xparapx/Plant_Growth_Monitoring_Demo/design/Plant Monitor Mockups.turn3.dc.html

3브랜드 팔레트 적용(#173046 · #2C5979 · #D84C27 · #F2F2F2 · #C0C0C0) + 환경변수는 Plotly 기본색 · 페이지별 목업 4종

3aPage 1 · Overview — 니들 게이지(Plotly 색상 구분) + 토양수분 밴드 + 급수 이벤트

plantlab°

OVERVIEWTREATMENTGROWTHCAMERA

4 nodes · Day 14/42 · 18:04 KST

온도10–40

23.4 °C

OPTIMAL

습도0–100

58 %

OPTIMAL

VPD0–3

1.12 kPa

OPTIMAL

CO₂0.4–2k

642 ppm

LOW

조도0–60k

18.4 klx

OPTIMAL

토양수분 — 처리 밴드— stable— fluct7d · 중심 1920 동일

Treatment check

Δμ 정렬0.42 %p ALIGNED

σf / σs2.31 × SEPARATED

급수 이벤트

17:42P4 fluctdose 3.2s ✓

16:10P2 stabledose 1.1s ✓

14:55P4 fluctsoak 90s

3bPage 2 · Treatment — 처리군 분리 검증 (밴드 설정 · 정렬/분리 지표 · 분포)

plantlab°

OVERVIEWTREATMENTGROWTHCAMERA

MEAN ALIGNMENT Δμ = |μs − μf|

0.42 %pALIGNED < 1.0

VARIANCE RATIO σf / σs

2.31 ×SEPARATED > 1.5

총 급수량 (결과값 · 비통제)

S 412 mLF 486 mL

수분 궤적 — 같은 중심, 다른 폭14d

밴드 설정 (raw)

stableON 1940 · OFF 1900P1 P3 P5

fluctON 2020 · OFF 1820P2 P4 P6

중심(ON+OFF)/2 = 1920 동일

수분 분포 (14d)

좁은 산 = stable · 넓은 산 = fluct. 옌센 부등식 검정의 전제 조건.

3cPage 3 · Growth — 2행 3열, 캐노피 투영 이미지 포함 + RGR 비교

plantlab°

OVERVIEWTREATMENTGROWTHCAMERA

DAWN 06:00 PM 15:00 ✓ MASK

P1STABLE142.6 cm²

RGR +4.1 %/dsoil 41%

P2FLUCT156.1 cm²

RGR +4.8 %/dsoil 37%

P3STABLE138.9 cm²

RGR +3.9 %/dsoil 42%

P4FLUCT161.3 cm²

RGR +5.2 %/d · 최대soil 35%

P5STABLE145.2 cm²

RGR +4.2 %/dsoil 40%

P6FLUCT150.7 cm²

RGR +4.6 %/dsoil 35%

RGR 추이 — 처리군 평균(ln A₂ − ln A₁)/Δt · 14d

ΔRGR (F − S)

+0.80 %/d

효과크기 d 0.62 · 사전등록 기준(n=6) 판정은 6주 종료 시.

3dPage 4 · Camera Setup — 프리뷰 + 5단계 컨트롤, 동일 팔레트

plantlab°

OVERVIEWTREATMENTGROWTHCAMERA

저장 → config.json

● LIVE PREVIEW

✓1 · 노출 · 초점20000µs · 1.82 · g2.0

✓2 · 스케일 마커50mm → 21.44 px/cm

3ROI 잡기 — 3×2진행 중

AUTO ROIFIND LEAF

pot 15 cm · gap 20 cm · margin 4%

4처리군 배정SHUFFLE

P1 S P2 F P3 S P4 F P5 S P6 F

5 · 기준사진 촬영 (calib.jpg)

Try next: "이 팔레트로 4페이지 인터랙티브 프로토타입 만들어줘" · "3c 캐노피 카드에 dawn/pm 비교 슬라이더" · "모바일 버전"
