xparapx/Plant_Growth_Monitoring_Demo/docs/manual.html

식물 생장 모니터링 — 데모환경노드 R4 WiFi + 급수노드 Core S3 + Raspberry Pi 5 + plantsvc 웹 UI · rev. 2026-09빌드 2026-09-10 · rev. 2026-09

시작하기

0개요 & 준비물

i전체 구조 한눈에

① Hub

1브로커 — PC / Pi 선택

2수집 — run_collector.py

② 환경 노드

3구성 (Grove 체결)

4펌웨어

5수신 테스트 ★

③ 급수 노드

6구성 · 실측 ★

7펌웨어 (폐루프)

④ 라즈베리파이 · 원격

8Pi 이관 · systemd

9원격 GUI — noVNC

⑤ 카메라 — 설치 (손으로 1회)

10준비 · 화각 · ROI

⑥ 카메라 — 운용 (자동)

11측정 · 자동 촬영

⑦ 대시보드 · 웹 UI · 운용

12대시보드

18웹 UI (plantsvc)

19LED 촬영 루틴 (자리)

20설치·배포 스크립트

⑧ 데모 판정

13데모 합격 판정

⑨ 실험 설계

14왜 이 실험인가

15용어 · 사전 측정

16실험 설계

17측정 계획

참고 — 순서 없음

!트러블슈팅

?개념 정리 (FAQ)

→다음 단계

## 0개요 & 준비물

7노드 전체를 세우기 전에, 3대로 전 구간을 한 번 관통시킵니다. 여기가 통과하면 나머지는 복사 작업입니다.

데모(0주)의 임무 — 식물은 없습니다 하드웨어와 소프트웨어의 루프가 제대로 도는가를 확인하는 것이 전부입니다. 씨앗도, 처리도, 실험도 아직 없습니다. 흙만 담은 화분 1개로 합니다.

그런데 그 과정에서 파종 전에 반드시 알아야 할 값들이 함께 나옵니다 — 센서 보정, 포화점, 그리고 주기(→ 화분 크기). 데모가 곧 예비실험입니다.

### 왜 3대인가

노드 7대를 한꺼번에 세우면 문제가 생겼을 때 원인이 노드인지 브로커인지 카메라인지 구분이 안 됩니다. 최소 구성으로 센서 → MQTT → DB → 화면과 급수 폐루프를 각각 한 번씩 끝까지 통과시켜 놓으면, 이후 노드 추가는 펌웨어 복사 + 전원 꽂기가 전부입니다.

데모에서 답이 나오는 것 / 안 나오는 것 나오는 것: 핀 대응, 펌프 실제 전류, 아날로그 전압, 폐루프 동작, 급수 검증 실패 감지, 5분 버킷 정합, 재부팅 복구, 픽셀→cm² 환산
안 나오는 것: 6칸 위치 무관성(프레임 필요), 7노드 동시 부하, 조도 균일도, 열화상 정합 — 전부 2단계로 미룹니다

### 준비물 — 데모에 필요한 전부

구분 | 품목 | 비고
허브 | PC (Windows) 지금 | Pi 도착 전까지 브로커 + run_collector.py + 대시보드를 여기서 실행
| Raspberry Pi 5 (4GB) + 정품 27W PD + SD 32GB A2 도착 후 | Pi가 꼭 필요한 건 카메라뿐
카메라 | Camera Module 3 — Standard (75°) | ⚠️ Wide·NoIR 아님 (FAQ 참조)
| 22핀 미니 CSI 케이블 | Pi 5는 15핀 아님. 동봉 여부 판매처마다 다름
환경 노드 | Arduino UNO R4 WiFi | WiFi 필수 — Minima는 불가
| Grove Base Shield V2 | I2C 포트 4개 → 허브 불필요. 전원스위치 5V
| BME688 0x76 | 온·습도·기압 대표값 · VPD 계산
| SCD41 0x62 | CO₂ 전용으로 사용
| DLight (BH1750) 0x23 | 조도 lx. 최대감도 560nm → lux≠PAR (FAQ)
| MLX90640 0x33 2단계 | 열화상. 남는 I2C 포트에
급수 노드 | M5Stack Core S3 유지 | Port B(G8/G9) = Watering Unit. 내장 배터리가 인러시 완충
| Watering Unit (U101) ×2 | 1 사용 + 1 예비 — 포럼 불량률 25% 보고
계측 ★ | USB 전력계 | 이 데모의 핵심 장비. 만원짜리가 전원 논쟁을 끝냄
| 멀티미터 | 아날로그 출력 전압 확인 (3.3V 초과 여부)
| 계량컵 | 1회 급수량 보정
기타 | 전원 어댑터 ×2 (급수=USB-C 5V2A / 환경=USB-C 또는 배럴) | 노드 1개 = 어댑터 1개 (패널 6)
| 화분 1개 + 흙 + 물통 | 씨앗 없이. 흙만 담아 폐루프 시험
| ArUco 마커 인쇄물 · 무광 초록 색지 | 패널 10

아직 사지 마세요 PbHUB · PaHUB · 분배기(커플러) · MOSFET · 플라이백 다이오드 · 배럴잭 어댑터 — 전부 불필요합니다. 노드당 Watering Unit이 1개이므로 Port B에 그냥 꽂으면 됩니다. 배럴잭은 패널 6에서 전류를 재본 뒤 필요하면 그때 사면 됩니다.

보드가 갈린 이유 — 각 노드가 다른 강점을 씀 "1보드에 유닛 2개"를 전제하던 크로스 분기·PbHUB 논의는 노드를 나누면서 전제가 사라졌습니다. 환경 노드 = R4 WiFi는 Base Shield의 I2C 4포트로 센서 3~4개를 허브 없이 물립니다. 급수 노드 = Core S3는 내장 배터리가 펌프 기동 순간의 전류를 받쳐 브라운아웃을 막고, M5가 단일 케이블로 검증한 조합입니다. MQTT라 보드가 섞여도 브로커는 무관합니다.

### 이 문서에 계속 나오는 약어 다섯

여기서는 한 줄로만 짚고, 깊은 설명은 해당 패널에서 합니다. 모르는 채로 진행해도 되지만, 무엇을 재고 있는지 알면 실패를 훨씬 빨리 알아챕니다.

약어 | 풀이 | 한 줄 설명 | 자세히
ArUco | 고유 무늬가 있는 흑백 정사각형 표식 | 사진 속의 자(尺). 크기를 아는 물체를 같이 찍어 픽셀 → cm 환산을 하고, 동시에 카메라가 움직였는지를 감시합니다 | 패널 10
ROI | Region Of Interest · 관심 영역 | 사진에서 화분 하나를 오려낼 사각형. 카메라 한 대로 여러 화분을 찍고 ROI로 나눠 각각 잽니다 | 패널 10
ExG | Excess Green · 초록 초과 | 2G − R − B. 초록이 강한 픽셀만 크게 만들어 잎과 흙을 가르는 계산 | 패널 11
RGR | Relative Growth Rate · 상대 생장률 | “하루에 몇 % 자라는가”. 면적의 로그 기울기라서 처음 크기가 달라도 공정하게 비교됩니다 | 패널 11
VPD | Vapour Pressure Deficit · 증기압 결핍 | 공기가 물을 얼마나 세게 빨아가는가. 온도와 습도를 합친 값으로, 습도보다 식물의 체감에 가깝습니다 | 패널 3

MQTT · I2C — 통신 쪽 두 개 MQTT는 “토픽”에 메시지를 던지면 구독자가 받아가는 메시지 배달 규약입니다. 노드가 던지고(plant/…) 브로커가 나르고 run_collector.py가 받아 DB에 넣습니다.
I2C는 선 두 개(SDA·SCL)로 여러 센서를 주소로 구분해 붙이는 방식입니다. 그래서 센서마다 0x76처럼 주소가 붙어 있고, 주소가 겹치면 하나만 보입니다.

◀ 이전다음 ▶

## i전체 구조 한눈에

데이터가 어디서 생겨 어디로 흐르는지, 각 노드가 무엇을 스스로 판단하는지, 그리고 무엇을 먼저 하는지.

화살표를 따라가면 데이터가 어디서 생겨 어디로 가는지 보입니다

### 고리가 둘, 보고선이 하나

| 급수 고리 | 측정 고리
어디서 도나 | 급수 노드 보드 안 | Pi 안
주기 | 5분마다 판단 · 필요하면 도즈 | 하루 2회 (05:50 · 15:00 — 패널 19)
입력 | 토양수분 raw | 사진 1장
출력 | 펌프 ON/OFF | 화분별 면적·윤곽
네트워크가 죽으면 | 그대로 계속 돕니다 — 로그만 못 남깁니다

이 구조가 6주 무인 운용을 가능하게 합니다 판단이 바깥에 있으면 WiFi가 한 번 끊길 때마다 급수가 멈춥니다. 주말에 그런 일이 생기면 실험 전체가 무효가 됩니다.
그래서 노드의 BROKER 를 Tailscale 주소로 적으면 안 됩니다 — 그 순간 원격 장애가 급수 장애가 됩니다. 노드는 로컬 IP만 봅니다.

### MQTT 토픽 → DB 테이블

노드는 토픽에 던지기만 하고, run_collector.py 가 받아 해당 표에 넣습니다.

토픽 | 보내는 쪽 | 주기 | → 테이블
plant/<node>/env | 환경 노드 | 5분 | readings
plant/<node>/soil | 급수 노드 | 5분 | soil
plant/<node>/pump | 급수 노드 | 이벤트 | pump_log
plant/tray/growth | Pi (카메라) | 1일 | growth

토양수분이 왜 readings가 아니라 soil인가 환경(온·습·CO₂)은 재배함 전체에 공통이라 노드 1대면 됩니다. 토양수분은 화분마다 다릅니다. 대상이 다르므로 표를 나눕니다 — readings는 공간 1행, soil은 화분마다 1행. 이래야 7노드로 늘려도 스키마가 그대로입니다.

### 노드별로 무엇을 셋업하는가

각 노드에서 손대는 것은 펌웨어 몇 줄과 확인 절차뿐입니다. 나머지는 전부 복사입니다.

대상 | 올리는 것 | 고칠 값 | 통과 판정 | 패널
브로커 PC 또는 Pi | mosquitto (apt/설치파일) | 없음 — IP만 확인 ipconfig / hostname -I | 다른 창에서 mosquitto_sub 에 메시지가 흐름 | 1
수집 Pi | run_collector.py planthub.service | 없음 | 재부팅 후에도 DB 행이 계속 쌓임 | 2 · 8
환경 노드 R4 WiFi ×1 | Arduino 펌웨어 | WiFi 2줄 · BROKER | 1시간 방치 → 12행 · 결측 0 · n≈30 | 3~5
급수 노드 Core S3 ×N | water_node.ino → 본 펌웨어 | PLANT_ID · TREAT_FLUCT RAW_ON/RAW_OFF · DOSE_MS | 도즈 → 대기 → filled 로 스스로 멈춤 튜브를 빼면 no rise | 6~7
카메라 Pi | 웹 UI /camera/setup plantsnap.timer | data/config.json 하나 | check_config.py 통과 + photos/debug/ 윤곽 육안 확인 | 10~11

⚠ 노드마다 다른 값은 딱 두 줄입니다 급수 노드 N대의 코드는 완전히 같고 PLANT_ID 와 TREAT_FLUCT 만 다릅니다.
이게 중요한 이유 — 제어 알고리즘이 처리군과 교락되지 않습니다. 두 군의 차이가 “코드가 달라서”일 가능성이 원천 차단됩니다.

### 작업 순서 — 반드시 이 순서로

🖥️① Hub (먼저!)PC — 브로커 주소가 여기서 정해짐

브로커 — PC에 mosquitto

Pi를 기다릴 필요 없음. ipconfig로 나온 IP가 노드의 BROKER 값 · 패널 1

수집 — run_collector.py

MQTT → SQLite. MQTT Explorer로 눈으로 확인 · 패널 2

▼

🌡️② 환경 노드가장 쉬움 — 먼저 성공 경험을

0단계 — WiFi 없이 시리얼만 ★

여기서 막히면 브로커 문제로 오인하게 됩니다. 센서부터 · 패널 3

펌웨어 — WiFi 2줄 + BROKER

NTP 정각정렬 → 5분 평균 발행 · 패널 4

수신 테스트 — 1시간 방치

12행 · 결측 0 · n≈30 확인 · 패널 5

▼

💧③ 급수 노드실측이 설계를 확정함

실측 3종 ★

핀 대응 · 아날로그 전압(<3.3V?) · 급수 시 전류·전압강하 → 배럴잭 필요 여부 확정 · 패널 6

보정 — 마름/젖음 + DOSE_MS

보정 없이 시작하면 전체 데이터를 못 씁니다 · 패널 6

폐루프 + 검증실패 유발

흙 담은 화분에. 튜브를 일부러 빼서 verify_fail 확인 · 패널 7

▼

📷④ 라즈베리파이카메라 · 24시간 무인 운용

설치 — git clone + install.sh

저장소를 그대로 클론하고 scripts/install.sh 한 번. 노드의 BROKER만 Pi IP로 · 패널 8·20

카메라 — 초점·노출 고정 ★

오토포커스는 결함입니다(FAQ). 고정 후 6주간 불변 · 패널 8

종이 잎 검증

면적을 아는 도형으로 정확도를 수치화 · 패널 11

▼

✓⑤ 판정통과해야 2단계로

24시간 무인 → 합격표

미달이면 원인 고치고 다시 24시간 · 패널 ✓

①②는 하루, ③은 이틀, ④는 일주일 시간과 실패는 ④ 비전에 몰립니다. 일정을 세울 때 여기에 대부분을 배정하세요.

### 스크립트 지도 — 이름만 보고 누가 언제 실행하는지 알 수 있게

파일 이름의 앞부분이 실행 주체입니다. 헷갈리면 이 표로 돌아오세요.

접두어 | 뜻 | 파일 | 실행
setup_ | 설치할 때 손으로 1회. 숫자가 하는 순서 | 웹 UI /camera/setup (패널 10·18) 브라우저에서 노출·배율·ROI·처리군·기준사진을 한 번에. 예전 setup_camera.py(:8000)의 5단계가 그대로 옮겨졌습니다 | 사람 6주간 다시 안 씀
check_ | 정확도 검증 | check_accuracy.py 종이 잎 오차 측정 check_config.py 설정 모순 검사 check_manual.py 매뉴얼-코드 대조 | 사람 · 운용 전 1회
run_ | 6주 동안 자동으로. 사람이 안 건드림 | run_collector.py MQTT → DB plantsvc capture LED → 촬영 → 측정 → 발행 plantsvc serve 웹 UI · API · 미리보기 (:8080) run_capture.py는 plantsvc capture로 연결되는 shim으로 남아 있습니다 | systemd planthub.service plantsvc.service plantsnap.timer (+ catch-up)
— | 나머지 | leaf_measure.py 측정 엔진(라이브러리) frame_align.py 카메라 밀림 감지(라이브러리) center_roi.py ROI 재중심 — 촬영 시작 전에만 (웹 UI의 [ROI 재중심] 버튼과 같은 일) plantsvc doctor 점검표 · plantsvc seed 더미 DB (패널 20) data/config.json 모든 설정 (웹 UI /system 에서 편집) data/plant.db 데이터 · data/events.db 서비스 자체 기록 | leaf_measure는 직접 실행하지 않고 plantsvc capture가 불러 씁니다. dashboard.py(Streamlit)는 레거시 — 패널 12

★ 값을 고칠 곳은 config.json 하나뿐입니다 노출·초점·해상도·ROI·LED·촬영 시각 — 전부 여기 있습니다 (~/plant/data/config.json). 웹 UI의 카메라 설정과 plantsvc capture가 모두 같은 파일을 읽으므로, 한 곳만 고치면 셋이 함께 따라옵니다.
스크립트 안의 숫자를 직접 고치지 마세요. 세 곳이 어긋나는 순간 “미리보기에서 본 것”과 “실제로 찍히는 것”이 달라지고, 그건 사진만 봐서는 알 수 없습니다.

◀ 이전다음 ▶

## 1브로커 — PC로 먼저

Pi를 기다릴 필요가 없습니다. Pi가 꼭 필요한 건 카메라뿐이고, 브로커·run_collector.py·대시보드는 전부 PC에서 돕니다.

파이프라인의 80%를 오늘 끝낼 수 있습니다 mosquitto·run_collector.py·plantsvc(웹 UI)는 플랫폼 무관입니다. PC에서 완성해두면 Pi 도착 시 파일 복사 + 노드의 BROKER IP 한 줄 교체가 이관의 전부입니다.

둘 중 하나만 고르면 됩니다 — 순서가 아니라 선택입니다

| 🖥️ PC (Windows) | 🍓 라즈베리파이
언제 | Pi가 아직 없을 때 · 코드만 먼저 검증 | 본 운용. Pi가 있으면 처음부터 이쪽
24시간 운용 | ❌ PC를 계속 켜둬야 함 | ✅ 전원만 꽂으면 됨 (패널 8 systemd)
카메라 | ❌ | ✅
나중에 옮기려면 | plant 폴더 복사 + 노드 펌웨어의 BROKER 한 줄 교체가 전부

Pi가 이미 있으면 오른쪽 탭으로 바로 가세요. PC를 거칠 이유가 없습니다.

🖥️ PC (Windows)로 구축 🍓 라즈베리파이로 구축

### 1) mosquitto 설치

mosquitto.org/download에서 Windows 설치본을 받아 설치합니다.

### 2) 설정 파일 — PowerShell로 만드세요

C:\Program Files\mosquitto\는 보호된 폴더라 메모장으로 저장하면 권한 거부가 나고, 저장돼도 plant.conf.txt처럼 확장자가 몰래 붙습니다. 관리자 PowerShell에서 만드는 게 확실합니다.

관리자 PowerShell — 권한·확장자 문제 없이

Set-Content -Path "C:\Program Files\mosquitto\plant.conf" -Encoding ascii -Value @(
  "listener 1883 0.0.0.0",
  "allow_anonymous true"
)

왜 메모장이 아니라 이 방법인가 -Encoding ascii가 한글/BOM 문제를 막고, 확장자가 .conf 그대로 저장됩니다. 메모장으로 하려면 저장 시 파일 형식을 "모든 파일"로 바꾸고 이름을 "plant.conf"(따옴표 포함)로 써야 합니다. 설정 파일에는 한글을 넣지 마세요 — 인코딩이 깨져 mosquitto가 뜨지 않습니다.

### 3) 브로커가 이미 돌고 있는지 확인 ★

Windows 설치본은 mosquitto를 서비스로 자동 등록해 부팅 때부터 켜두는 경우가 많습니다. 그러면 따로 실행할 필요 없이 이미 브로커가 살아 있습니다.

PowerShell

Get-Service mosquitto

결과 | 뜻 · 다음
Running | 이미 브로커가 돎. 4)의 실행을 건너뛰고 바로 테스트로. 단 기본 설정(localhost 전용)이라 같은 PC 테스트만 됨 — 데모엔 충분
Stopped / 없음 | 4)에서 수동으로 띄움

데모는 이대로 충분합니다 — 노드 붙일 때만 손보면 됩니다 서비스는 plant.conf가 아니라 기본 설정으로 돌아 외부(WiFi) 접속이 막혀 있습니다. 지금은 PC 하나로 하는 테스트라 문제없습니다. 실제 노드를 붙이는 단계에서만 net stop mosquitto로 끄고 아래 4)처럼 plant.conf로 다시 띄우면 됩니다.

### 4) (Stopped일 때만) 방화벽 열기 · 수동 실행

3)이 Running이면 이 단계는 건너뛰세요. Stopped이거나 plant.conf로 다시 띄워야 할 때만 합니다.

관리자 PowerShell — 이 창은 켜둔 채로

New-NetFirewallRule -DisplayName "MQTT 1883" -Direction Inbound `
  -Protocol TCP -LocalPort 1883 -Action Allow

cd "C:\Program Files\mosquitto"
.\mosquitto.exe -c plant.conf -v      # -v : 오가는 메시지가 콘솔에 그대로 보임

.\은 "현재 폴더의 이 파일"이라 PATH와 무관하게 실행됩니다. 이 창을 닫으면 브로커가 꺼집니다.

방화벽이 1순위 실패 원인입니다 노드가 rc=-2로 계속 실패하는데 PC 자체 테스트는 되는 경우 — 거의 항상 방화벽입니다. 공용 네트워크 프로파일에서 특히 잘 막힙니다.

### 5) 브로커 주소 확인 ★

PowerShell

ipconfig

IPv4 주소(예: 192.168.0.15)가 노드 펌웨어의 BROKER 값이 됩니다.

### 1) OS · 접속

Raspberry Pi Imager로 Raspberry Pi OS (64-bit, Bookworm) Desktop을 굽습니다. 고급 설정(톱니바퀴)에서 호스트명 planthub, SSH 사용, WiFi, 국가 KR을 미리 넣으면 모니터 없이 접속됩니다.

Lite 아님 — Desktop picamera2와 카메라 스택이 기본 포함되어 있어 설치 사고가 줄어듭니다.

PC 터미널

ssh <계정>@raspi.local        # ← 자기 계정@호스트명 (deploy.ps1 의 기본 호스트명은 raspi)

# Pi 안에서
sudo apt update && sudo apt full-upgrade -y
hostname -I          # ← 이 IP가 새 BROKER 주소

### 2) mosquitto

Pi

sudo apt install -y mosquitto mosquitto-clients

sudo tee /etc/mosquitto/conf.d/plant.conf > /dev/null << 'EOF'
listener 1883 0.0.0.0
allow_anonymous true
EOF
sudo systemctl restart mosquitto
systemctl status mosquitto      # active (running) 확인 → q

apt로 설치하면 부팅 시 자동 실행까지 자동으로 등록됩니다.

IP를 고정하세요 공유기 관리페이지에서 DHCP 예약으로 Pi의 IP를 묶어두세요. 재부팅 때 IP가 바뀌면 노드 7대의 펌웨어를 전부 다시 올려야 합니다.

### 연결 자체 테스트 — 터미널 2개

브로커가 살아 있으면, 터미널 2개를 열어 메시지가 실제로 오가는지 봅니다.

⚠ 셸에 따라 따옴표 규칙이 정반대입니다

셸 | 작은따옴표 안의 " | JSON 이스케이프
PowerShell (Windows) | 벗겨져 사라짐 | \" 필요
bash (Pi · 리눅스 · macOS) | 그대로 보존됨 | 쓰면 안 됨 — 백슬래시가 진짜로 전송됨

리눅스에서 \"를 쓰면 parse failed: Expecting property name enclosed in double quotes ... (char 1)로 실패합니다.

🍓 bash (Pi · 리눅스) — 백슬래시 없이

# 터미널 A — 구독 (결과가 여기 뜸)
mosquitto_sub -h localhost -t 'plant/#' -v

# 터미널 B — 발행
mosquitto_pub -h localhost -t 'plant/test' -m '{"hello":1}'

🖥️ PowerShell (Windows) — 백슬래시 필수

# 터미널 A
& "C:\Program Files\mosquitto\mosquitto_sub.exe" -h localhost -t 'plant/#' -v

# 터미널 B
& "C:\Program Files\mosquitto\mosquitto_pub.exe" -h localhost -t 'plant/test' -m '{\"hello\":1}'

구독 창에 아무것도 안 뜨고 커서만 깜빡이는 것은 정상입니다 — 메시지를 기다리는 중입니다. 발행 후 터미널 A에 plant/test {"hello":1}이 뜨면 브로커 정상입니다.

🖥️ Windows 전용 — 전체 경로가 번거로우면 PATH 등록 (선택) 한 번만 등록하면 이름(mosquitto_sub)으로 됩니다. 관리자 권한이 없으면 "Machine" 대신 "User"를 쓰세요.

[Environment]::SetEnvironmentVariable("Path",
  $env:Path + ";C:\Program Files\mosquitto", "User")

등록 후 창을 완전히 닫고 새로 열어야 반영됩니다. 단 JSON 이스케이프(\")는 PATH와 무관하게 여전히 필요합니다.
🍓 Pi는 apt 설치라 PATH가 자동입니다 — 이 단계가 없습니다.

MQTT Explorer를 꼭 설치하세요 무료 GUI 도구입니다. 토픽 트리와 페이로드가 눈에 보이므로, 노드가 보내는지 / run_collector.py가 못 받는지를 즉시 구분할 수 있습니다. 이 도구 없이 디버깅하면 시간을 몇 배로 씁니다.

⚠️ 학교망이면 십중팔구 막힙니다 학교 WiFi는 대개 클라이언트 격리가 걸려 있어 기기끼리 통신이 안 됩니다. 브로커는 정상인데 노드만 연결이 안 되면 이것입니다.
해법: PC와 노드를 같은 폰 핫스팟에 올리세요. 지금 단계에서 가장 흔한 실패 원인입니다. 본 운용에서는 독립 공유기를 두시면 됩니다.

◀ 이전다음 ▶

## 2수집 — run_collector.py

브로커의 메시지를 받아 SQLite에 쌓습니다. PC와 Pi에서 같은 파일이 그대로 돕니다.

### 파이썬 환경

🖥️ PC 🍓 Pi

PowerShell

powershell -c "irm https://astral.sh/uv/install.ps1 | iex"
# 새 창을 열고
uv --version

mkdir plant; cd plant
uv init --no-readme
del main.py
uv add paho-mqtt pandas plotly streamlit streamlit-autorefresh numpy

PC에는 opencv·picamera2·gpiozero가 필요 없습니다 — 카메라는 Pi에서만 씁니다.

Pi

curl -LsSf https://astral.sh/uv/install.sh | sh
source ~/.bashrc

mkdir -p ~/plant && cd ~/plant
uv init --no-readme && rm -f main.py

# ★ venv 를 먼저, 이 옵션과 함께 만듭니다 (picamera2는 시스템 것을 빌려 씀)
uv venv --system-site-packages

# 그다음 설치 — 이미 있는 venv 를 그대로 씁니다
uv add paho-mqtt pandas plotly streamlit streamlit-autorefresh \
       opencv-python-headless numpy

grep include-system-site .venv/pyvenv.cfg   # true 여야 함
uv run python -c "from picamera2 import Picamera2; print('picamera2 OK')"

⚠ pyproject.toml 에 [tool.uv] system-site-packages 를 쓰지 마세요 uv 가 인식하지 못하는 키입니다. 아무 일도 하지 않고 명령을 칠 때마다 40줄짜리 경고만 냅니다 — 정작 봐야 할 오류가 그 아래 묻힙니다. 실제로 이 프로젝트에서 하루 종일 출력 앞머리를 채웠고, 정작 봐야 할 오류가 묻혔습니다.

시스템 패키지 노출은 pyproject.toml 이 아니라 .venv/pyvenv.cfg 가 정합니다. 그리고 그 파일은 venv 를 만드는 순간 쓰이고 나중에 안 바뀝니다. 그래서 uv venv --system-site-packages 가 uv add 보다 먼저 와야 합니다 — 순서가 뒤바뀌면 venv 가 다시 만들어지면서 설치한 것이 날아갑니다.

이미 그 줄을 넣었다면 지우세요. pyvenv.cfg 가 true 면 동작에는 지장이 없습니다.

sed -i '/^\[tool\.uv\]$/,/^system-site-packages/d' pyproject.toml
grep include-system-site .venv/pyvenv.cfg     # true 가 아니면 venv 재생성
# rm -rf .venv && uv venv --system-site-packages && uv sync

picamera2를 uv로 설치하지 마세요 하드웨어 라이브러리(libcamera)와 묶여 있어 가상환경에 다시 깔면 거의 실패합니다. 위처럼 시스템 패키지를 빌려 쓰도록 설정하세요. 실패하면 sudo apt install -y python3-picamera2 후 재시도.

### 테이블 4개 — 대상이 다르면 표를 나눕니다

테이블 | 한 행이 뜻하는 것 | 쌓이는 속도
readings | 재배함 전체의 5분 환경 평균 | 하루 288행
soil | 화분 1개의 5분 토양수분 | 화분당 288행
pump_log | 급수 1회 | 이벤트마다
growth | 화분 1개의 하루치 잎 면적 | 화분당 1행

run_collector.py · 서비스가 자동 · MQTT 구독 → plant.db 적재

"""
Plant Hub -- MQTT subscriber + SQLite writer   (runs on PC or Pi, unchanged)

subscribe : plant/+/env    -> readings   (5-min bucket, ONE env node = the box)
            plant/+/soil   -> soil       (5-min bucket, one row PER PLANT)
            plant/+/pump   -> pump_log   (event: irrigation record)
            plant/+/growth -> growth     (daily, one row PER PLANT)
store     : SQLite (plant.db) -- single source of truth
time      : ts is UTC.  +9h KST applied only at display/analysis time.
"""
import json, sqlite3, signal, sys
import paho.mqtt.client as mqtt

BROKER = "localhost"
PORT   = 1883
DB     = "plant.db"

sys.stdout.reconfigure(line_buffering=True)

conn = sqlite3.connect(DB, check_same_thread=False)

# environment = the whole grow box.  ONE node.  no soil here.
conn.execute("""
CREATE TABLE IF NOT EXISTS readings(
  id   INTEGER PRIMARY KEY AUTOINCREMENT,
  ts   TEXT DEFAULT CURRENT_TIMESTAMP,
  node TEXT,
  temp  REAL,     -- C    (BME688 = representative)
  hum   REAL,     -- %    (BME688)
  press REAL,     -- hPa  (BME688)
  vpd   REAL,     -- kPa  <- drives transpiration => drying rate => cycle period
  lux   REAL,     -- lx   (proxy only, NOT PAR -- see FAQ)
  co2   REAL,     -- ppm  (SCD41)
  n     INTEGER   -- samples in bucket (quality indicator)
)""")

# soil = per pot.  one watering node per plant.
conn.execute("""
CREATE TABLE IF NOT EXISTS soil(
  id       INTEGER PRIMARY KEY AUTOINCREMENT,
  ts       TEXT DEFAULT CURRENT_TIMESTAMP,
  node     TEXT,
  plant_id TEXT,   -- p1..p6
  treat    TEXT,   -- 'stable' | 'fluct'  <- witness only; config.json is the source
  raw      REAL,   -- ★ ADC counts as the sensor reports them.  THE value to keep.
                   --   pct below is derived on the node with RAW_DRY/RAW_WET that
                   --   are per-node and re-calibrated over time -- so pct from two
                   --   nodes, or from two dates, are NOT on the same scale.
                   --   Analysis must recompute pct from raw with ONE constant.
  pct      REAL,   -- convenience only.  do not compare across nodes/dates.
  n        INTEGER
)""")

conn.execute("""
CREATE TABLE IF NOT EXISTS pump_log(
  id          INTEGER PRIMARY KEY AUTOINCREMENT,
  ts          TEXT DEFAULT CURRENT_TIMESTAMP,
  node        TEXT,
  plant_id    TEXT,
  treat       TEXT,
  dur_ms      INTEGER,
  soil_before REAL,   -- derived pct -- see the note on soil.raw
  soil_after  REAL,
  raw_before  INTEGER,-- ★ the node already sends these; keep them
  raw_after   INTEGER,
  shots       INTEGER,-- doses used in this cycle (MAX_SHOTS => verify_fail)
  reason      TEXT    -- filled | dosed | no rise | verify fail | manual
)""")

conn.execute("""
CREATE TABLE IF NOT EXISTS growth(
  id        INTEGER PRIMARY KEY AUTOINCREMENT,
  ts        TEXT DEFAULT CURRENT_TIMESTAMP,
  plant_id  TEXT,
  treat     TEXT,
  phase     TEXT,     -- 'dawn' | 'pm'  <- RGR uses dawn ONLY; pm is for droop
  area_cm2  REAL,     -- projected canopy area (NOT leaf area -- see FAQ)
  area_px   INTEGER,
  px_per_cm REAL,     -- scale at capture (traceability + rig-moved alarm)
  img_file  TEXT,     -- raw/<file> -- links this row to the evidence image
  contour   TEXT,     -- JSON [[dx,dy],...] outline in px, centred on centroid
                      --   -> dashboard draws old/new overlay directly from this
  ok        INTEGER
)""")

# ── migration ────────────────────────────────────────────────────────────
# CREATE TABLE IF NOT EXISTS does NOT add columns to a table that already
# exists -- it just does nothing.  A DB created before these columns existed
# stays silently short, and every incoming raw value is dropped without error.
# So state the wanted columns explicitly and ALTER in whatever is missing.
# ALTER TABLE ADD COLUMN never touches existing rows: old rows get NULL.
WANT = {
    "soil":     [("raw",        "REAL")],
    "pump_log": [("raw_before", "INTEGER"),
                 ("raw_after",  "INTEGER"),
                 ("shots",      "INTEGER")],
}
for tbl, cols in WANT.items():
    have = {r[1] for r in conn.execute(f"PRAGMA table_info({tbl})")}
    for name, typ in cols:
        if name not in have:
            conn.execute(f"ALTER TABLE {tbl} ADD COLUMN {name} {typ}")
            print(f"[migrate] {tbl}.{name} {typ} added")
conn.commit()

def ins(table, d, cols):
    # Keys the node sends that we have nowhere to put.  Historically these
    # vanished in silence -- raw was published for days and never stored.
    # Say it once per key, then stay quiet.
    extra = set(d) - set(cols) - {"t"}
    for k in sorted(extra):
        if (table, k) not in _warned:
            _warned.add((table, k))
            print(f"[DROP] {table}: '{k}' has no column -- value discarded. "
                  f"add it to the CREATE TABLE and to WANT above.")

    vals = [d.get(c) for c in cols]
    t = d.get("t")
    ph = ",".join(["?"] * len(cols))
    if t:
        conn.execute(f"INSERT INTO {table}(ts,{','.join(cols)}) VALUES(?,{ph})",
                     (t, *vals))
    else:
        conn.execute(f"INSERT INTO {table}({','.join(cols)}) VALUES({ph})", vals)
    conn.commit()

_warned = set()

def on_connect(c, u, f, rc, props):
    print(f"broker connect: {rc}")
    for t in ("plant/+/env", "plant/+/soil", "plant/+/pump", "plant/+/growth"):
        c.subscribe(t)

def on_message(c, u, msg):
    # paho swallows exceptions raised inside this callback: the collector keeps
    # running and looks healthy while nothing is written.  Catch and print.
    try:
        _handle(msg)
    except Exception as e:
        print(f"[ERROR] {msg.topic}: {type(e).__name__}: {e}")
        print(f"        payload: {msg.payload[:300]!r}")

def _handle(msg):
    try:
        d = json.loads(msg.payload.decode())
    except Exception as e:
        print(f"parse failed: {e}")
        return

    if msg.topic.endswith("/env"):
        ins("readings", d, ["node", "temp", "hum", "press", "vpd", "lux", "co2", "n"])
        print(f"env  : {d}")

    elif msg.topic.endswith("/soil"):
        ins("soil", d, ["node", "plant_id", "treat", "raw", "pct", "n"])
        print(f"soil : {d}")

    elif msg.topic.endswith("/pump"):
        ins("pump_log", d, ["node", "plant_id", "treat", "dur_ms",
                            "soil_before", "soil_after",
                            "raw_before", "raw_after", "shots", "reason"])
        # the node sends 'verify fail' (space); older docs said 'verify_fail'
        flag = ("  <<< CHECK TUBE/RESERVOIR"
                if str(d.get("reason", "")).replace("_", " ") in ("verify fail", "no rise")
                else "")
        print(f"pump : {d}{flag}")

    elif msg.topic.endswith("/growth"):
        # one photo -> many plants: expand list into one row per plant
        for p in d.get("plants", []):
            p["t"] = d.get("t")
            ins("growth", p,
                ["plant_id", "treat", "phase", "area_cm2", "area_px", "px_per_cm",
                 "img_file", "contour", "ok"])
        print(f"growth: {len(d.get('plants', []))} plants")

def shutdown(signum, frame):
    print("shutting down...")
    try: client.disconnect()
    except Exception: pass
    try: conn.close()
    except Exception: pass
    sys.exit(0)

signal.signal(signal.SIGTERM, shutdown)
signal.signal(signal.SIGINT,  shutdown)

client = mqtt.Client(mqtt.CallbackAPIVersion.VERSION2)
client.on_connect = on_connect
client.on_message = on_message
client.connect(BROKER, PORT, keepalive=60)
client.loop_forever()

### 가짜 데이터로 먼저 검증 — 노드 없이

노드를 만들기 전에 run_collector.py가 맞는지 확인합니다. 이러면 나중에 노드가 안 될 때 run_collector.py는 용의선상에서 빠집니다.

터미널 2개

# 창 1 -- 공통
cd plant
uv run python run_collector.py

⚠️ 셸에 따라 따옴표 규칙이 정반대입니다

셸 | 작은따옴표 안의 " | JSON 이스케이프
PowerShell (Windows) | 벗겨져 사라짐 | \" 필요
bash (Pi · 리눅스 · macOS) | 그대로 보존됨 | 쓰면 안 됨 — 백슬래시가 진짜로 전송됨

리눅스에서 \"를 쓰면 run_collector.py가 parse failed: Expecting property name enclosed in double quotes ... (char 1)로 실패합니다. 2번째 문자가 백슬래시라는 뜻입니다.

창 2 (bash — Pi · 리눅스 · macOS) — 백슬래시 없이

mosquitto_pub -h localhost -t 'plant/fake/env'  -m '{"node":"fake","temp":22.5,"hum":55,"press":1013,"vpd":1.2,"lux":8000,"co2":600,"n":30}'
mosquitto_pub -h localhost -t 'plant/fake/soil' -m '{"node":"fake","plant_id":"p1","treat":"A","pct":41.2,"n":30}'
mosquitto_pub -h localhost -t 'plant/fake/pump' -m '{"node":"fake","plant_id":"p1","treat":"A","dur_ms":3000,"soil_before":24.0,"soil_after":26.5,"reason":"filled"}'

창 2 (PowerShell — Windows) — 백슬래시 필수

mosquitto_pub -h localhost -t 'plant/fake/env'  -m '{\"node\":\"fake\",\"temp\":22.5,\"hum\":55,\"press\":1013,\"vpd\":1.2,\"lux\":8000,\"co2\":600,\"n\":30}'
mosquitto_pub -h localhost -t 'plant/fake/soil' -m '{\"node\":\"fake\",\"plant_id\":\"p1\",\"treat\":\"A\",\"pct\":41.2,\"n\":30}'
mosquitto_pub -h localhost -t 'plant/fake/pump' -m '{\"node\":\"fake\",\"plant_id\":\"p1\",\"treat\":\"A\",\"dur_ms\":3000,\"soil_before\":24.0,\"soil_after\":26.5,\"reason\":\"filled\"}'

# 창 1(run_collector.py)에 env / soil / pump 세 줄이 뜨면 성공

셸 따옴표 씨름이 싫으면 — MQTT Explorer로 발행 GUI에서 토픽과 JSON을 그대로 입력하면 됩니다(백슬래시 불필요, 셸 무관). 위 따옴표 실수를 원천 차단합니다.

저장 확인 — SQLite

# sqlite3도 PATH에 없으면 uv로:  uv run python -c "import sqlite3, ..."
uv run python -c "import sqlite3; [print(r) for r in sqlite3.connect('plant.db').execute('SELECT * FROM readings')]"

### ★ 테스트가 끝나면 — 가짜 행을 지우세요

이 테스트는 “메시지를 보낸 것”이 아니라 “데이터를 저장한 것”입니다 run_collector.py가 켜져 있었으므로 방금 쏜 가짜 메시지는 그대로 DB에 들어갔습니다. 그게 이 테스트의 목적이기도 했고요 — run_collector.py가 받아서 저장하는가.

문제는 그 행이 실험 DB에 남는다는 것입니다. 특히 treat가 "A"처럼 실제 처리군이 아니면, 나중에 대시보드가 처리군을 못 잡고 soil이 “비어 있지 않다”고 판단되어 데모 데이터도 안 채워집니다. 오래된 시각 탓에 경과시간이 음수로 뜨기도 합니다.

가짜 행 정리 — 통째로 붙여넣기

cd ~/plant
uv run python - << 'PY'
import sqlite3
c = sqlite3.connect("plant.db")
for t in ("soil", "pump_log", "growth"):
    cols = {r[1] for r in c.execute(f"PRAGMA table_info({t})")}   # 테이블마다 컬럼이 다름
    if not cols:
        print(f"  {t}: 테이블 없음"); continue
    conds = []
    if "node"  in cols: conds.append("node = 'fake'")
    if "treat" in cols: conds.append("treat NOT IN ('stable','fluct')")
    if not conds:
        print(f"  {t}: 지울 조건 없음"); continue
    n    = c.execute(f"DELETE FROM {t} WHERE {' OR '.join(conds)}").rowcount
    left = c.execute(f"SELECT COUNT(*) FROM {t}").fetchone()[0]
    print(f"  {t}: {n}행 삭제, {left}행 남음")
c.commit()
print("readings:", c.execute("SELECT COUNT(*) FROM readings").fetchone()[0], "행 (건드리지 않음)")
PY

왜 PRAGMA table_info로 컬럼을 먼저 묻나 soil·pump_log에는 node 컬럼이 있지만 growth에는 없습니다. 그냥 WHERE node='fake'를 쓰면 growth에서 no such column: node로 멈춥니다. 있는 컬럼으로만 조건을 만들어야 세 테이블을 한 번에 처리할 수 있습니다.

<< 'PY' 방식이라 따옴표 이스케이프가 필요 없습니다 — -c "..."로 하면 \" 지옥이 다시 시작됩니다.

⚠️ 나중에 재사용할 때 treat NOT IN ('stable','fluct')는 꽤 공격적입니다. 파수꾼 화분처럼 다른 라벨을 쓰기 시작하면 진짜 데이터가 지워집니다.
지우기 전에 DELETE를 SELECT COUNT(*)로 바꿔 몇 개가 걸리는지 먼저 세어보는 습관을 들이세요.

아예 안 섞이게 하려면 테스트 발행 때 treat를 실제 값(stable / fluct)으로 쓰거나, 별도 DB로 run_collector.py를 띄우세요.

growth 페이로드만 왜 리스트인가 사진 한 장에서 화분 6개가 동시에 나옵니다. 6번 발행하는 대신 한 번에 묶어 보내고 run_collector.py가 화분별 6행으로 풀어 저장합니다. 이래야 "같은 사진에서 나온 값"이라는 사실이 시각으로 보장됩니다.

◀ 이전다음 ▶

## 3환경 노드 — 구성

재배함 전체의 환경을 재는 노드 1대. 납땜 없이 유닛 체결만 합니다.

### 연결

포트 | 연결 | 비고
I2C 포트 ×4 | BME688 · SCD41 · DLight (2단계 MLX90640) | 포트마다 하나씩. 전부 같은 I2C 버스 — 주소가 달라 충돌 없음
아날로그/디지털 포트 | — | 이 노드에선 미사용 (급수 노드가 별도)

센서 | 주소 | 이 프로젝트에서 맡는 것
BME688 | 0x76 | 온도 · 습도 · 기압 (대표값) → VPD 계산
SCD41 | 0x62 | CO₂만. 온습도도 나오지만 쓰지 않음
DLight | 0x23 | 조도 (lx)
MLX90640 2단계 | 0x33 | 잎 온도

★ 왜 R4 + Base Shield인가 — 허브가 필요 없습니다 Core S3는 I2C 포트(Port A)가 1개뿐이라 센서 3~4개를 물리려면 허브가 필요했습니다. Base Shield V2는 I2C 포트가 4개라, 센서를 포트마다 하나씩 꽂으면 끝입니다 — 허브도, 데이지체인도, 멀티플렉서도 불필요합니다.

I2C는 원래 버스라 4개 포트가 전기적으로 같은 SDA/SCL에 묶여 있습니다. 주소가 전부 달라(0x76 / 0x62 / 0x23 / 0x33) 한 버스에 매달려도 서로 안 헷갈립니다.

⚠️ Base Shield 전원 스위치를 5V로 Base Shield V2에는 5V / 3.3V 토글 스위치가 있습니다. UNO R4와 M5 센서는 5V이므로 반드시 5V 위치로 두세요. 3.3V로 두면 센서가 인식되지 않거나 값이 튑니다.

막힐 때 — 한 번에 하나씩 네 센서를 한꺼번에 꽂았는데 i2c_scan에 일부만 잡히면, 하나씩만 꽂아 각각 확인하세요. 케이블·접촉 문제인지 특정 센서 문제인지 즉시 갈립니다.

### 센서 배치 — 값을 망치는 자리

- CO₂(SCD4x): 통풍구를 막지 말 것. 케이스에 넣으면 구멍 필수
- 조도: 잎과 같은 높이·같은 방향(위를 보게). 그늘에 두면 식물이 받는 빛과 무관한 값
- R4 + Shield 본체: 물 튀는 곳 위쪽 금지. 케이스 권장

온습도 대표값은 BME688 — SCD41 값은 쓰지 마세요 두 센서 모두 온습도를 내놓지만 평균 내면 안 됩니다. 계통오차라 평균으로 안 사라집니다. 하나를 대표로 정하고 나머지는 버립니다.

BME688을 대표로 씁니다 — SCD41은 자체 발열로 1~3°C 높게 나오는 알려진 특성이 있고, BME688은 기압까지 주어 VPD를 제대로 계산할 수 있기 때문입니다. SCD41의 온습도는 자기 CO₂ 보정에만 내부적으로 쓰이게 두면 됩니다.

★ 왜 습도가 아니라 VPD인가 — 이 실험에서 중요합니다 식물이 물을 얼마나 빨리 뽑아 쓰는지는 습도(%)가 아니라 VPD(수증기압 결손)가 정합니다. 같은 60% RH여도 20°C와 30°C에서 증산량이 2배 가까이 다릅니다.

VPD가 곧 마르는 속도 → 톱니의 주기입니다. 그러니 "환경이 같았다"를 증명할 때 RH가 아니라 VPD를 보고해야 합니다.
VPD = 0.6108 · exp(17.27T/(T+237.3)) · (1 − RH/100) [kPa]

⚠️ BME688의 가스 히터는 끄고 씁니다 BME688은 VOC를 재려고 내부 열판을 300°C 넘게 가열합니다. 그러면 자기 온습도가 오염됩니다.
그리고 가스값은 보정 안 된 저항값이라 어떤 물질인지 알 수 없고, 습도·온도에 심하게 흔들립니다. 이 실험에서 검정할 수 있는 게 없습니다. → setGasHeater(0, 0)으로 끄세요.

정말 VOC를 보고 싶다면 켜도 됩니다. 대신 온도가 1~2°C 뜨는데, 여섯 화분 모두에 똑같이 적용되므로 그룹 비교는 안 깨집니다. 절대값 보고만 주의하세요.

### Arduino IDE 준비

- 보드매니저: Arduino UNO R4 Boards 검색 → 설치 → 보드 Arduino UNO R4 WiFi
- 라이브러리: PubSubClient, Sensirion I2C SCD4x(SCD41 — 신버전 1.0+), Adafruit BME680(BME688 호환), BH1750(by Christopher Laws)
- WiFiS3·RTC는 UNO R4 보드 패키지에 내장 — 별도 설치 없음

⚠️ 급수 노드와 IDE 설정이 다릅니다 환경 노드(R4)는 Arduino UNO R4 Boards, 급수 노드(Core S3)는 M5Stack + M5Unified입니다. 보드·라이브러리가 서로 달라 펌웨어를 섞으면 컴파일 안 됩니다. 노드별로 IDE 설정을 맞추세요.

⚠️ Sensirion SCD4x는 신버전(1.0+) 기준입니다 — 헤더명이 바뀌었습니다 Sensirion이 라이브러리를 개편하면서 파일·클래스명과 함수명이 바뀌었습니다. 이 매뉴얼 코드는 신버전 기준입니다.

| 구버전(안 됨) | 신버전(이 매뉴얼)
헤더 | SensirionI2CScd4x.h | SensirionI2cScd4x.h (c 소문자)
클래스 | SensirionI2CScd4x | SensirionI2cScd4x
초기화 | begin(Wire) | begin(Wire, 0x62)
준비확인 | getDataReadyFlag | getDataReadyStatus

No such file: SensirionI2CScd4x.h 에러가 나면 대문자 C 헤더를 부르는 구버전 코드입니다. 라이브러리 매니저에서 버전 1.0 이상을 설치하고 위 표대로 맞추세요.

### ★ 하드웨어 검증 — WiFi 없이 센서만 (통신 전에)

WiFi도 MQTT도 빼고 시리얼로 값만 확인합니다. 여기서 막히면 브로커 문제로 오인하게 됩니다.

1) i2c_scan.ino — 무엇이 붙어 있나

#include <Wire.h>

void setup() {
  Serial.begin(115200);
  while (!Serial && millis() < 3000) {}   // R4: USB 시리얼 준비 대기
  Wire.begin();                           // R4 + Base Shield (SDA/SCL 고정)
  delay(500);
  Serial.println("I2C scan...");
  for (uint8_t a = 1; a < 127; a++) {
    Wire.beginTransmission(a);
    if (Wire.endTransmission() == 0) { Serial.print("  found 0x"); Serial.println(a, HEX); }
  }
  Serial.println("done. expect 0x76=BME688, 0x62=SCD41, 0x23=DLight, 0x33=MLX90640");
}
void loop() {}

기대 출력: 0x76(BME688) · 0x62(SCD41) · 0x23(DLight). 아무것도 안 나오면 배선·전원 문제이지 코드 문제가 아닙니다.

### 2) 센서값 + 반응 테스트

주소가 잡혔으면, 이제 세 센서가 제대로 읽히는지 확인합니다. WiFi·MQTT는 다 빼고 시리얼로 값만 봅니다. 이게 통과해야 그 위에 통신을 올립니다.

env_sensor_test.ino — 값 확인 (SCD4x 신버전 API)

#include <Wire.h>
#include <Adafruit_BME680.h>
#include <SensirionI2cScd4x.h>          // ★ 신버전: I2c 소문자
#include <BH1750.h>

#ifdef NO_ERROR
#undef NO_ERROR
#endif
#define NO_ERROR 0

const uint16_t ALTITUDE_M = 40;         // ★ 학교 해발고도(m)
const uint8_t  SCD41_ADDR = 0x62;

Adafruit_BME680   bme;
SensirionI2cScd4x scd4x;
BH1750            lightMeter;
bool bmeOK=false, scdOK=false, luxOK=false;

float esat(float t){ return 0.6108f*expf(17.27f*t/(t+237.3f)); }
float vpdOf(float t,float rh){ return esat(t)*(1.0f-rh/100.0f); }

void setup(){
  Serial.begin(115200);
  while(!Serial && millis()<3000){}
  Wire.begin();
  delay(200);

  bmeOK = bme.begin(0x76) || bme.begin(0x77);
  if(bmeOK){
    bme.setTemperatureOversampling(BME680_OS_8X);
    bme.setHumidityOversampling(BME680_OS_2X);
    bme.setPressureOversampling(BME680_OS_4X);
    bme.setIIRFilterSize(BME680_FILTER_SIZE_3);
    bme.setGasHeater(0,0);              // 가스히터 OFF
  }
  Serial.println(bmeOK?"BME688 OK":"BME688 FAIL");

  scd4x.begin(Wire, SCD41_ADDR);        // ★ 신버전: 주소 인자
  scd4x.stopPeriodicMeasurement(); delay(500);
  scd4x.setSensorAltitude(ALTITUDE_M);
  scdOK = (scd4x.startPeriodicMeasurement()==NO_ERROR);
  Serial.println(scdOK?"SCD41 OK (첫 값 ~5초)":"SCD41 FAIL");

  luxOK = lightMeter.begin(BH1750::CONTINUOUS_HIGH_RES_MODE);
  Serial.println(luxOK?"DLight OK":"DLight FAIL");
}

void loop(){
  float t=NAN,hm=NAN,pr=NAN,vpd=NAN,lx=NAN; uint16_t co2=0;

  if(bmeOK && bme.performReading()){
    t=bme.temperature; hm=bme.humidity; pr=bme.pressure/100.0f; vpd=vpdOf(t,hm);
  }
  bool ready=false;
  if(scdOK && scd4x.getDataReadyStatus(ready)==NO_ERROR && ready){   // ★ 신버전 함수명
    float st,sh; scd4x.readMeasurement(co2, st, sh);   // 온습도는 버림 (CO2만)
  }
  if(luxOK) lx=lightMeter.readLightLevel();

  Serial.print("T=");   if(!isnan(t))  Serial.print(t,1);  else Serial.print("--");
  Serial.print("C RH=");if(!isnan(hm)) Serial.print(hm,1); else Serial.print("--");
  Serial.print("% P="); if(!isnan(pr)) Serial.print(pr,1); else Serial.print("--");
  Serial.print("hPa VPD=");if(!isnan(vpd))Serial.print(vpd,2);else Serial.print("--");
  Serial.print("kPa CO2=");if(co2)      Serial.print(co2);  else Serial.print("--");
  Serial.print("ppm Lux=");if(!isnan(lx))Serial.print(lx,0);else Serial.print("--");
  Serial.println();
  delay(2000);
}

CO₂가 한 줄 걸러 -- 로 뜨는 건 정상입니다 SCD41은 5초마다 새 값을 내는데 코드는 2초마다 읽으니, 값 없는 타이밍엔 --가 나옵니다. 실제 노드는 5분 평균이라 안 보입니다. 첫 몇 줄 CO2=--도 정상 — 첫 유효값까지 ~5초.

★ 값이 떠도 끝이 아닙니다 — 반응을 보세요 값이 그럴듯해도 센서가 엉뚱한 걸 볼 수 있습니다. 자극에 반응하는지가 진짜 검증입니다:
· 입김을 불면 → RH↑, VPD↓ · DLight를 손으로 가리면 → Lux 뚝 · 센서에 숨쉬면 → CO₂ 급등
세 반응이 다 나오면 하드웨어 통과입니다.

증상 | 원인
I2C 스캔 아무것도 없음 | Base Shield 전원스위치 3.3V / 케이블 접촉 / Shield 안 꽂힘
특정 주소만 안 뜸 | 그 센서 케이블 — 하나씩 꽂아 확인
No such file: SensirionI2CScd4x.h | 대문자 C = 구버전 코드. 위 신버전(I2c 소문자)으로
CO₂ 계속 -- | 5초 이상 대기. 그래도면 0x62 재확인

✓ 하드웨어 검증 통과 기준 ① i2c_scan에 0x76·0x62·0x23이 잡히고 → ② env_sensor_test에서 값이 뜨며 → ③ 입김·손가림·숨 세 반응이 나오면 통과. 값이 뜬다고 맞는 게 아니라 반응하는지가 증거입니다. 여기까지 되면 다음 패널의 통신 포함 펌웨어로 넘어갑니다.

◀ 이전다음 ▶

## 4환경 노드 — 펌웨어

Arduino UNO R4 WiFi용입니다. 뼈대는 기존과 동일 — MAC 기반 자동 노드 ID, NTP(내장 RTC) 정각 정렬, 5분 평균, 타당성 게이트, I2C 자동 복구. 화면 코드만 빠졌습니다(R4는 화면이 없음).

### 고칠 곳 — 3줄

상수 | 값
WIFI_SSID / WIFI_PASS | Pi 핫스팟 또는 PC와 같은 망 (2.4GHz — R4 WiFi도 2.4GHz)
ALTITUDE_M | 학교 해발고도(m) — SCD41 CO₂ 기압보정
BROKER | 브로커의 IP — Pi면 hostname -I, PC면 ipconfig (패널 1)

plant_env_r4wifi.ino

/*
 * ═══════════════════════════════════════════════════════════
 *  식물 생장 모니터링 — 환경 노드 (Arduino UNO R4 WiFi)   [데모판]
 *
 *  Grove Base Shield V2 — I2C 포트 4개. 허브 없이 하나씩 꽂음
 *    BME688  0x76 : 온도·습도·기압  <- 대표값. 가스히터 OFF. VPD 계산
 *    SCD41   0x62 : CO2 전용 (내장 온습도는 사용하지 않음)
 *    DLight  0x23 : 조도 (lux)
 *    MLX90640 0x33: 2단계
 *  Base Shield 전원 스위치는 반드시 5V 위치.
 *
 *  전송 : plant/<nodeId>/env    NTP(UTC) 정각 격자 5분 평균
 * ═══════════════════════════════════════════════════════════
 *  ★ Core S3 판과 다른 점 (R4 WiFi 전용)
 *    · M5Unified 없음 → 화면 코드 제거 (R4는 12x8 LED 매트릭스뿐)
 *    · WiFi 라이브러리 = WiFiS3 (ESP32 아님)
 *    · Wire.begin() — 핀 번호 지정 안 함 (SDA/SCL 고정)
 *    · NTP = RTC(WiFiS3 내장) 이용, UTC
 *    · 센서 라이브러리·MQTT·타당성 게이트·평균 로직은 그대로
 *  라이브러리: WiFiS3(보드 내장) / PubSubClient / Sensirion I2C SCD4x(신버전)
 *              Adafruit BME680(BME688 호환) / BH1750
 * ═══════════════════════════════════════════════════════════
 */
#include <WiFiS3.h>
#include <PubSubClient.h>
#include <Wire.h>
#include <SensirionI2cScd4x.h>          // 신버전: I2c 소문자
#include <Adafruit_BME680.h>
#include <BH1750.h>
#include <RTC.h>                         // R4 내장 RTC (NTP 시각 보관)

#ifdef NO_ERROR                          // SCD4x 신버전 매크로 충돌 방지
#undef NO_ERROR
#endif
#define NO_ERROR 0
const uint8_t SCD41_ADDR = 0x62;

// ══════════ 사용자 설정 ══════════
const char* WIFI_SSID = "your-hotspot";
const char* WIFI_PASS = "your-password";
const char* BROKER    = "192.168.0.15";     // ★ 브로커 IP (Pi: hostname -I / PC: ipconfig)
const int   PORT      = 1883;

const uint16_t ALTITUDE_M = 40;             // ★ 학교 해발고도(m) — SCD41 CO2 보정
const int   PUBLISH_MIN = 5;
const unsigned long SAMPLE_MS = 10000;      // 5분에 n≈30
const long  TZ_OFFSET = 0;                  // NTP는 UTC로 저장 (hub에서 +9h)
// ════════════════════════════════

WiFiClient net;
PubSubClient client(net);
SensirionI2cScd4x scd4x;                 // 신버전 클래스명
Adafruit_BME680  bme;
BH1750           lightMeter;

String nodeId, topic;
double sT=0, sH=0, sP=0, sV=0, sL=0, sC=0;
int n=0, nC=0, nB=0;
bool bmeOK=false, scdOK=false, luxOK=false, timeOK=false;
long curBucket = -1;
unsigned long lastSample = 0;
int failStreak = 0;
const int FAIL_LIMIT = 12;

// ── VPD — 습도가 아니라 이것이 증산을(=마르는 속도를) 정함 ──
float esat(float t)            { return 0.6108f * expf(17.27f*t/(t+237.3f)); }   // kPa
float vpdOf(float t, float rh) { return esat(t) * (1.0f - rh/100.0f); }          // kPa

// R4는 MAC을 WiFi.macAddress()로 얻음 (연결 후)
void makeNodeId() {
  byte mac[6]; WiFi.macAddress(mac);
  char id[16];
  snprintf(id, sizeof(id), "env_%02X%02X%02X", mac[3], mac[4], mac[5]);
  nodeId = String(id);
  topic  = "plant/" + nodeId + "/env";
}

void connectWiFi() {
  if (WiFi.status() == WL_CONNECTED) return;
  Serial.print("WiFi");
  WiFi.begin(WIFI_SSID, WIFI_PASS);
  unsigned long t0 = millis();
  while (WiFi.status() != WL_CONNECTED && millis()-t0 < 15000) { delay(500); Serial.print("."); }
  Serial.println(WiFi.status()==WL_CONNECTED ? " OK" : " FAIL");
}

void connectBroker() {
  int tries = 0;
  while (!client.connected() && tries++ < 5) {
    connectWiFi();
    String cid = nodeId + "-" + String(random(0xffff), HEX);
    Serial.print("MQTT");
    if (client.connect(cid.c_str())) { Serial.println(" OK"); return; }
    Serial.print(" rc="); Serial.println(client.state());   // -2 = 거부/방화벽
    delay(2000);
  }
}

// R4 WiFi는 NTP를 WiFi.getTime()으로 받아 내장 RTC에 심음 (UTC epoch)
void syncTime() {
  Serial.print("NTP");
  unsigned long epoch = 0, t0 = millis();
  while (epoch == 0 && millis()-t0 < 10000) { epoch = WiFi.getTime(); delay(500); Serial.print("."); }
  if (epoch) {
    RTC.begin();
    RTCTime now((time_t)epoch);
    RTC.setTime(now);
    timeOK = true;  Serial.println(" OK");
  } else { timeOK = false; Serial.println(" FAIL -> 정각정렬 없이 동작"); }
}

long nowEpoch() {
  if (!timeOK) return 0;
  RTCTime t; RTC.getTime(t); return (long)t.getUnixTime();
}

String epochToStr(long e) {
  time_t t=(time_t)e; struct tm ti; gmtime_r(&t, &ti);
  char b[32]; strftime(b, sizeof(b), "%Y-%m-%d %H:%M:%S", &ti);
  return String(b);
}

// 얼어붙은 센서가 물리적으로 불가능한 값을 반복하는 고장 모드를 차단
bool plausibleTH(float t, float h) { return t>-10 && t<60 && h>=0 && h<=100; }
bool plausibleCO2(float c)         { return c>300 && c<10000; }

void initSensors() {
  // BME688 — 대표 온습도. 가스히터는 끔(자체 발열로 온습도가 오염됨)
  bmeOK = bme.begin(0x76);
  if (!bmeOK) bmeOK = bme.begin(0x77);          // 보드에 따라 0x77
  if (bmeOK) {
    bme.setTemperatureOversampling(BME680_OS_8X);
    bme.setHumidityOversampling(BME680_OS_2X);
    bme.setPressureOversampling(BME680_OS_4X);
    bme.setIIRFilterSize(BME680_FILTER_SIZE_3);
    bme.setGasHeater(0, 0);                     // ★ OFF — VOC 쓰려면 (320,150)
  }
  Serial.println(bmeOK ? "BME688 시작" : "BME688 실패 - 0x76/0x77 확인");

  scd4x.begin(Wire, SCD41_ADDR);                // 신버전: 주소 인자 필요
  scd4x.stopPeriodicMeasurement(); delay(500);
  scd4x.setSensorAltitude(ALTITUDE_M);          // 기압 보정 (측정 정지 중에만)
  scdOK = (scd4x.startPeriodicMeasurement() == NO_ERROR);
  Serial.println(scdOK ? "SCD41 시작" : "SCD41 실패 - 0x62 확인");

  luxOK = lightMeter.begin(BH1750::CONTINUOUS_HIGH_RES_MODE);
  Serial.println(luxOK ? "DLight 시작" : "DLight 실패 - 0x23 확인");
}

void recoverI2C() {
  Serial.println("[RECOVER] I2C 복구");
  Wire.end(); delay(50);
  Wire.begin();                                 // R4 : 핀 지정 없음
  initSensors();
  failStreak = 0;
  if (!bmeOK && !scdOK && !luxOK) { Serial.println("[RECOVER] 실패 -> 리셋"); NVIC_SystemReset(); }
}

void takeSample() {
  bool any = false;

  // ── BME688 : 대표 온습도 + 기압 -> VPD ──
  if (bmeOK && bme.performReading()) {
    float t = bme.temperature, hm = bme.humidity, pr = bme.pressure / 100.0f;  // Pa -> hPa
    if (plausibleTH(t, hm)) { sT += t; sH += hm; sP += pr; sV += vpdOf(t, hm); nB++; any = true; }
  }

  // ── SCD41 : CO2만 사용 (온습도 t,hm은 읽고 버림) ──
  uint16_t co2=0; float t=0, hm=0; bool ready=false;
  if (scdOK && scd4x.getDataReadyStatus(ready)==NO_ERROR && ready) {   // 신버전 함수명
    if (scd4x.readMeasurement(co2, t, hm)==NO_ERROR && co2!=0 && plausibleCO2(co2)) { sC += co2; nC++; any = true; }
  }

  float lx = luxOK ? lightMeter.readLightLevel() : NAN;
  if (!isnan(lx) && lx >= 0) { sL += lx; any = true; }

  n++;
  if (any) failStreak = 0; else failStreak++;
}

void publishAverage(long bucket) {
  if (n <= 0) return;
  int cb = nB > 0 ? nB : 1;
  int cc = nC > 0 ? nC : 1;
  char p[320];
  String ts = timeOK ? epochToStr(bucket) : String("");
  snprintf(p, sizeof(p),
    "{\"node\":\"%s\",\"t\":\"%s\",\"temp\":%.2f,\"hum\":%.2f,"
    "\"press\":%.1f,\"vpd\":%.3f,\"lux\":%.1f,\"co2\":%.1f,\"n\":%d}",
    nodeId.c_str(), ts.c_str(), sT/cb, sH/cb, sP/cb, sV/cb, sL/n, sC/cc, n);
  client.publish(topic.c_str(), p);
  Serial.print("PUB: "); Serial.println(p);
}

void resetAccum() { sT=sH=sP=sV=sL=sC=0; n=0; nC=0; nB=0; }

void setup() {
  Serial.begin(115200);
  Wire.begin();                            // R4 : Base Shield I2C (SDA/SCL 고정)
  initSensors();

  connectWiFi();
  makeNodeId();
  syncTime();
  client.setServer(BROKER, PORT);
  connectBroker();

  Serial.print("Node : "); Serial.println(nodeId);
  Serial.print("Topic: "); Serial.println(topic);
  if (timeOK) { long s = PUBLISH_MIN*60L; curBucket = (nowEpoch()/s)*s; }
}

void loop() {
  if (!client.connected()) connectBroker();
  client.loop();

  if (failStreak >= FAIL_LIMIT) recoverI2C();

  unsigned long now = millis();
  long s = PUBLISH_MIN * 60L;

  if (timeOK) {
    long bucket = (nowEpoch()/s)*s;
    if (curBucket < 0) curBucket = bucket;
    if (bucket != curBucket) { publishAverage(curBucket); resetAccum(); curBucket = bucket; }
  } else {
    static unsigned long lastPub = 0;
    if (now - lastPub >= (unsigned long)PUBLISH_MIN*60000UL) { lastPub = now; publishAverage(0); resetAccum(); }
  }

  if (now - lastSample >= SAMPLE_MS) { lastSample = now; takeSample(); }
  delay(20);
}

정상 시리얼 출력

BME688 시작
SCD41 시작
DLight 시작
WiFi OK
NTP OK
MQTT OK
Node : env_2A8454
Topic: plant/env_2A8454/env
PUB: {"node":"env_2A8454","t":"2026-07-16 05:05:00","temp":23.41,"hum":58.2,
      "press":1012.4,"vpd":1.212,"lux":9820.0,"co2":712.0,"n":30}

CO₂ 절대값은 믿지 마세요 SCD4x의 자동보정(ASC)은 "매일 한 번은 외기(400ppm)에 노출된다"는 가정 위에서 돕니다. 밀폐 재배함에서는 이 가정이 깨져 값이 서서히 틀어집니다. 이 프로젝트에서 CO₂는 제어 대상이 아니라 관찰 대상이므로 절대값보다 일주기 패턴(낮에 소비, 밤에 호흡으로 상승)이 중요합니다.

◀ 이전다음 ▶

## 5수신 테스트 ★

환경 노드가 혼자서 전 구간을 통과하는지 확인합니다. 급수 노드는 이게 끝난 뒤에.

### 확인 순서 — 끊어서 보기

🔍끊어서 확인어디서 끊겼는지 즉시 알기 위해

① 시리얼 — 노드가 만드나

PUB: {...} 가 5분마다. 없으면 노드 문제

② MQTT Explorer — 브로커에 닿나

토픽 트리에 plant/env_XXXXXX/env 등장. 시리얼엔 있는데 여기 없으면 망/방화벽

③ run_collector.py 콘솔 — 받아 넣나

env : {...}. Explorer엔 있는데 여기 없으면 run_collector.py 문제

④ SQLite — 남았나

SELECT COUNT(*) FROM readings;

확인 명령

# 브로커에 뭐가 오가는지 (Explorer 대신 CLI로도 가능)
mosquitto_sub -h localhost -t 'plant/#' -v

# DB 확인 (sqlite3 CLI가 없으면 아래 uv 버전)
sqlite3 plant.db "SELECT COUNT(*), MIN(ts), MAX(ts) FROM readings;"
uv run python -c "import sqlite3; c=sqlite3.connect('plant.db'); [print(r) for r in c.execute('SELECT ts,node,temp,hum,lux,co2,n FROM readings ORDER BY id DESC LIMIT 5')]"

### 1시간 방치 → 합격표

- 12행 (1시간 ÷ 5분). 결측 구간 없음
- t 필드가 정각 5분 격자 — :00, :05, :10 …
- n ≈ 30 (5분 ÷ 10초)
- 창문 열기 → CO₂ 하강 / 손으로 가리기 → lux 하강
- 노드 USB 뽑았다 꽂기 → 자동 재연결, 발행 재개
- run_collector.py 껐다 켜기 → 재연결, 이후 데이터 정상 저장

n 필드가 품질 지표입니다 n이 20 이하로 떨어지면 I2C가 불안정하거나 WiFi 재연결에 시간을 뺏기고 있다는 신호입니다. 값 자체는 멀쩡해 보이는데 n만 낮은 경우가 흔하니, 대시보드보다 n을 먼저 보세요.

UTC입니다 — 9시간 차이는 정상 DB의 ts는 UTC입니다. 한국 시각 14:05는 05:05:00으로 저장됩니다. 노드가 여러 대여도 시각 기준이 하나여서 조인이 정확하고, 서머타임 문제가 없습니다. +9시간은 대시보드가 표시할 때만 합니다.

◀ 이전다음 ▶

## 6급수 노드 — 구성 · 실측 ★

이 패널의 목적은 조립이 아니라 측정입니다. 여기서 나온 숫자가 설계의 남은 빈칸을 채웁니다.

### 연결 — 그냥 꽂으면 됩니다

포트 | 연결
Port B (검정, G8/G9) | Watering Unit (U101) — 동봉 Grove 케이블 그대로
Port A / Port C | 여유

Watering Unit 핀맵(공식): PORT.B — 검정 GND / 빨강 5V / 노랑 PUMP_EN / 흰색 Analog Output. 유닛에 펌프 드라이버가 내장되어 있어 MOSFET·플라이백 다이오드가 필요 없습니다.

유닛 1개 = 포트 1개. 그래서 노드를 나눴습니다 Watering Unit은 제어핀 1 + 아날로그핀 1을 함께 씁니다. 한 보드에 2개를 붙이려면 Port C의 ADC2가 WiFi와 충돌해 아날로그를 못 읽습니다. 노드를 나누면 이 문제가 통째로 사라집니다 — 크로스 분기도 PbHUB도 필요 없습니다.

### 실측 ① — 핀 대응 확인 필요

노랑/흰색이 G8·G9 중 어디인지는 문서만으론 확정 못 합니다. 아래로 확인 — 이 매뉴얼의 기준 유닛에서는 실측 결과 G9=펌프, G8=수분이었습니다. 유닛/케이블에 따라 다를 수 있으니 직접 확인하세요.

pin_id.ino — 어느 핀이 아날로그인가

#include <M5Unified.h>
void setup() {
  auto cfg = M5.config(); M5.begin(cfg);
  Serial.begin(115200);
  analogReadResolution(12);           // 0..4095
  pinMode(8, INPUT); pinMode(9, INPUT);
}
void loop() {
  Serial.printf("G8=%4d   G9=%4d\n", analogRead(8), analogRead(9));
  delay(500);                         // 측정판을 물에 담갔다 빼며 관찰
}

측정판을 물에 담갔다 빼면 값이 크게 변하는 쪽이 흰색(Analog Output) = 토양수분입니다. 나머지가 노랑(PUMP_EN).
기준 유닛 실측: G8이 물에 반응 → G8=수분, G9=펌프. 터치 테스트로 G9에 펌프를 걸어 물이 나오면 확정입니다.

★ 터치 스크린으로 한 번에 확인 — 펌프 + 수분 동시 Core S3는 화면이 있으니, 버튼을 눌러 펌프를 켜고 수분값을 실시간으로 보는 테스트가 더 직관적입니다. 아래 스케치는 버튼을 누르는 동안만 펌프 ON(떼면 OFF), 상단에 토양수분 raw·%를 표시합니다. 물이 나오면 PIN_PUMP가 맞고, 측정판을 적실 때 raw가 움직이면 PIN_SOIL이 맞습니다.

water_touch_test.ino — 터치로 펌프 + 수분 확인

#include <M5Unified.h>
const int PIN_PUMP = 9;                 // 노랑 PUMP_EN (실측)
const int PIN_SOIL = 8;                 // 흰색 Analog  (실측)
const unsigned long MAX_ON_MS = 5000;   // 안전: 5초 넘으면 강제 OFF
const int SOIL_DRY = 3200, SOIL_WET = 1400;      // ★ 임시 — 보정값으로 교체
const int BX=40, BY=150, BW=240, BH=70;          // 버튼 영역

bool pumpOn=false; unsigned long pumpStart=0; int rawSoil=0;

float soilPct(int r){ float v=100.0f*(SOIL_DRY-r)/(float)(SOIL_DRY-SOIL_WET);
                      return v<0?0:(v>100?100:v); }

void setPump(bool on){
  if(on==pumpOn) return;
  pumpOn=on; digitalWrite(PIN_PUMP, on?HIGH:LOW);
  if(on) pumpStart=millis();
  Serial.printf("[PUMP] %s  raw=%d  %.1f%%\n", on?"ON":"OFF", rawSoil, soilPct(rawSoil));
}
void drawUI(){
  M5.Display.fillScreen(BLACK);
  M5.Display.setTextColor(WHITE,BLACK); M5.Display.setTextSize(2);
  M5.Display.setCursor(10,10);  M5.Display.printf("Soil raw : %4d", rawSoil);
  M5.Display.setTextSize(3); M5.Display.setTextColor(CYAN,BLACK);
  M5.Display.setCursor(10,40);  M5.Display.printf("%.1f %%", soilPct(rawSoil));
  M5.Display.setTextSize(2); M5.Display.setTextColor(pumpOn?RED:DARKGREY,BLACK);
  M5.Display.setCursor(10,90);  M5.Display.printf("PUMP : %s", pumpOn?"ON ":"off");
  M5.Display.fillRoundRect(BX,BY,BW,BH,10, pumpOn?RED:NAVY);
  M5.Display.setTextColor(WHITE); M5.Display.setTextSize(3);
  M5.Display.setCursor(BX+55,BY+22); M5.Display.print("PUMP");
}
void setup(){
  auto cfg=M5.config(); M5.begin(cfg); Serial.begin(115200);
  pinMode(PIN_PUMP,OUTPUT); digitalWrite(PIN_PUMP,LOW);   // LOW부터
  pinMode(PIN_SOIL,INPUT);  analogReadResolution(12);
  M5.Display.setRotation(1); drawUI();
}
void loop(){
  M5.update();
  long acc=0; for(int i=0;i<8;i++){ acc+=analogRead(PIN_SOIL); delay(2); }
  rawSoil=acc/8;

  auto t=M5.Touch.getDetail();
  bool onBtn = t.isPressed() && t.x>=BX && t.x<=BX+BW && t.y>=BY && t.y<=BY+BH;
  if(onBtn && !pumpOn) setPump(true);
  if(!onBtn && pumpOn) setPump(false);

  if(pumpOn && millis()-pumpStart>MAX_ON_MS){ Serial.println("[SAFETY] OFF"); setPump(false); }
  drawUI(); delay(50);
}

누름 유지식 + 5초 컷 — 안전장치 버튼에서 손을 떼면 즉시 OFF, 실수로 계속 눌러도 5초 후 강제 OFF입니다. 물통이 비었는데 펌프가 헛도는 것을 막습니다. 부팅 시 LOW로 시작해 켜진 채 부팅되지 않습니다.

### 실측 ② — 아날로그 전압 3.3V 초과? ⚠️

멀티미터로 흰색 선의 전압을 재세요 — 공기 중 / 물속 양쪽 모두.

3.3V를 넘으면 ESP32 ADC가 손상됩니다 유닛은 5V로 구동됩니다. M5Core Basic에는 I/O 라인에 3.3V 클램프 다이오드 어레이가 있다는 포럼 보고가 있으나, Core S3에 동일 보호가 있는지는 확인되지 않았습니다. 3.3V를 넘으면 분압 저항(예: 10k/20k)이 필요합니다. 재보고 넘어가세요.

### 실측 ③ — 급수 전류 배럴잭 필요? ★

이 데모의 가장 중요한 측정입니다. USB 전력계를 Core S3와 어댑터 사이에 끼우고 펌프를 돌립니다.

pump_burst.ino — 3초 강제 구동

#include <M5Unified.h>
const int PIN_PUMP = 9;               // ★ 실측 확정: PUMP_EN = G9
void setup() {
  auto cfg = M5.config(); M5.begin(cfg);
  Serial.begin(115200);
  pinMode(PIN_PUMP, OUTPUT);
  digitalWrite(PIN_PUMP, LOW);        // 반드시 LOW부터
  delay(3000);
  Serial.println("pump ON 3s -- 전력계를 보세요");
  digitalWrite(PIN_PUMP, HIGH);
  delay(3000);
  digitalWrite(PIN_PUMP, LOW);
  Serial.println("pump OFF");
}
void loop() {}

측정값 | 기록 | 판정
대기 전류 | ___ mA | 기준선
급수 중 전류 | ___ mA | 사양 5W → 5V 기준 이론 1A
급수 중 전압 | ___ V | 4.7V 이상 유지 → 통과 미달 → 외부 5V 주입 확정
Core S3 리셋 여부 | Y / N | 리셋되면 즉시 외부 전원

사양 5W가 실제 5W가 아닐 수 있습니다 Watering Unit에는 전원잭이 없어 Grove 5V가 유일한 경로입니다. 사양은 5W(5V 기준 1A)지만 정격 최대일 가능성이 있고 실제 자유 유량 시엔 300~500mA일 수도 있습니다. 추측하지 말고 재세요. 만원짜리 전력계가 이 논쟁을 끝냅니다.

미달일 때 — 외부 5V 주입 유닛의 전원이 Grove 핀으로 들어오므로 그 지점에 넣으면 됩니다. Grove 브레이크아웃 케이블로 5V·GND는 외부 어댑터에서, 노랑·흰색만 Core S3로 보내고 접지를 공통으로 묶습니다. 5V 라인에 470µF 이상 벌크 커패시터. 전원은 분리, 접지는 공통 — 이 둘을 혼동하면 아예 동작하지 않습니다.

### 보정 ① — 마름/젖음 필수

센서 원값(ADC)은 그 자체로 의미가 없습니다. 보정 없이 시작하면 나중에 전체 데이터를 못 씁니다.

1. pin_id.ino를 올린 채 시리얼을 봅니다
2. 공기 중 값 기록 → SOIL_DRY ___
3. 물에 (전자부품 선까지만) 담근 값 기록 → SOIL_WET ___
4. 정전용량식은 젖을수록 ADC가 낮아집니다 — DRY > WET이면 정상

### 보정 ② — DOSE_MS 계량컵

1. 튜브 끝을 빈 계량컵에 넣습니다 (화분 아님)
2. pump_burst.ino로 3초 구동 → 나온 물 mL 측정 ___ mL / 3s
3. 1회 급수 목표(예: 50mL)에 맞춰 DOSE_MS 계산

애매하면 줄이세요 과습이 고사 원인 1위입니다. 물이 모자라면 식물은 시들었다 회복하지만, 뿌리가 잠기면 회복 없이 죽습니다. 모자라면 다음 주기에 또 주면 됩니다.

### ★ 실측 ④ — 주기 며칠? 화분 크기가 여기서 정해집니다

임의 밴드(예 30~55%)로 급수 노드를 돌려놓고 한 번 왕복에 며칠 걸리는지 봅니다. 식물이 없어도 증발만으로 마르므로 데모에서 바로 나옵니다.

SQL — 급수 간격 = 주기

-- 급수 이벤트 사이의 시간 = 왕복 주기
SELECT ts, ROUND((julianday(ts) - julianday(LAG(ts) OVER (ORDER BY ts))), 2) AS cycle_days
FROM pump_log WHERE reason='filled' ORDER BY ts;

주기 | 28일 동안 | 판정
2일 | 14회 | ✅
4일 | 7회 | ✅ 하한
7일 | 4회 | △ 위태
14일 | 2회 | ❌ 이건 변동이 아니라 가뭄 한 번

왜 왕복 횟수가 중요한가 — 규칙성이 아니라 표본수 문제입니다 옌센은 수분의 분포만 봅니다 — 주기성도, 순서도 안 봅니다. 그러니 주기가 불규칙한 건 흠이 아닙니다.
다만 분포를 채우려면 표본이 필요합니다. 왕복 2회로 σ를 논하는 건 동전을 두 번 던지고 확률을 말하는 것과 같습니다.

주기가 4일을 넘으면 — 손잡이(조절 수단) 세 가지 ① 흙에 모래 비율 ↑ — 보수력만 낮춤. 뿌리는 자유. 1순위
② 환기·온도 ↑ (전체에 동일하게) — 통제변인은 "특정 값"이 아니라 "그룹 간 동일"이면 됩니다. 재배함 전체를 26°C로 올려도 여섯 화분 모두 26°C이므로 여전히 통제된 것입니다. 바뀌는 건 "26°C 조건에서 수행했다"는 문장 하나뿐
③ 화분 크기 ↓ — 최후의 수단. 아래 경고 참조
❌ 밴드 폭 ↓ — 주기는 짧아지지만 σ가 작아져 목적이 무너짐

⚠️ 작은 화분의 함정 — 검정하려는 기제를 스스로 봉쇄합니다 널뜀군이 뿌리를 더 뻗는 것이 바로 H₂(경화)의 핵심 기제입니다. 화분이 작으면 뻗을 공간이 없습니다.
주기를 맞추려고 화분을 줄이면 검정하려던 기제를 물리적으로 막아놓고 "경화 효과가 없었다"고 결론짓게 됩니다. 틀린 결론입니다. 부득이 줄였다면 "뿌리 제한이 경화 반응을 억제했을 가능성"을 한계로 명시하세요.

### 전원 — 노드 1개 = 어댑터 1개

Core S3는 USB-C입니다. 배럴잭이 아닙니다. 개발 중엔 PC USB로 시리얼 보며 작업하고, 방치 테스트 때만 5V 2A USB-C 어댑터를 씁니다.

멀티포트 공용 충전기 금지 분산 노드에는 소프트웨어 인터록이 없습니다 — 노드 6대가 서로를 모르므로 동시에 펌프를 돌릴 수 있습니다. 멀티포트 충전기는 총 와트를 나눠 쓰므로 순간 부하에 전압이 주저앉아 연쇄 리셋이 납니다. 노드마다 독립 어댑터 + 독립 콘센트. 노드 간 신호선이 없으니(전부 무선) 접지 공통도 불필요합니다.

멀티탭 — 물이 있는 책상입니다 멀티탭을 물통·화분보다 높은 곳에(벽·선반). 바닥과 책상 아래 금지. 스위치 달린 멀티탭이 위험합니다 — 누가 무심코 끄면 Pi가 하드 다운되고 SD카드가 깨집니다. Pi는 별도 콘센트 + 정품 27W PD로 빼세요.

◀ 이전다음 ▶

## 7급수 노드 — 펌웨어 (폐루프)

이 코드가 곧 처리(treatment) 투입 장치입니다. 규칙 기반 제어를 "데이터 기반의 미완성 버전"으로 여기지 마세요 — 이게 없으면 실험 자체가 성립하지 않습니다.

★ 이 두 줄이 곧 처리 조건입니다 ON_BELOW(바닥)와 OFF_AT(천장) — 6대의 코드가 완전히 같고 이 두 줄만 다릅니다. 제어 알고리즘 자체가 교락되지 않는다는 뜻입니다.

펌프는 위로만 밀어올립니다. 내려가는 건 식물의 증산·증발이 합니다. 즉 펌프는 진폭을 만드는 게 아니라 가둡니다 — 우리가 정하는 건 "얼마나 마르도록 내버려 둘 것인가"입니다. 자세한 배경은 패널 ★·設.

### 안전장치 4개

장치 | 하는 일 | 없으면
목표까지 채움 (히스테리시스) | ON_BELOW 아래로 오면 시작, OFF_AT 닿으면 멈추고 손 뗌 → 그 사이는 식물이 마르게 둠 = 널뛰기가 여기서 만들어짐 | 바닥 근처에서만 맴돌아 널뛰기가 안 생김
정량 + 침투 대기 | 정해진 양만 주고 20분 대기 후 재측정 | 스며들기 전에 "아직 마르네" 하고 계속 부어 침수
작동 검증 | 수분이 실제로 올랐는지 확인. 안 오르면 경보 + 중단 | 튜브 빠졌는데 물통만 비워짐
일일 상한 | 하루 최대 급수 횟수 | 센서 고장 시 화분이 잠김

⚠️ delay()로 20분을 기다리면 안 됩니다 delay()나 블로킹 대기로 침투 시간을 기다리면 센서 샘플링과 MQTT keepalive가 멈춰 연결이 끊깁니다. 더 나쁜 건, 대기 중 수분값이 갱신되지 않아 soil_after == soil_before가 되어 첫 급수마다 무조건 verify_fail이 나는 것입니다. 반드시 비블로킹 상태기계로 짜야 합니다.

⚠️ PUMP_EN에 10kΩ 풀다운 — 생략 시 침수 부팅·리셋 중 GPIO는 입력(하이임피던스)이라 게이트가 뜹니다. I2C 복구 실패 시 ESP.restart()가 있으므로 실제로 발생하는 시나리오입니다. PUMP_EN ↔ GND에 10kΩ을 걸어 부팅 200ms 동안 강제 OFF를 유지하세요. 코드에서도 setup() 최상단에 OUTPUT + LOW를 먼저 둡니다.

### 0) 먼저 — MQTT 없이 폐루프만 검증합니다

WiFi·브로커·DB를 붙이기 전에, 이 노드 하나가 스스로 물을 주고 멈추는지부터 봅니다. 여기서 막히면 원인이 급수인지 통신인지 구분이 안 됩니다.

⚠ 밴드를 %로 정하지 마세요 — 보정을 고치면 같은 흙이 다른 숫자가 됩니다 실제로 겪는 함정입니다. 같은 화분, 같은 순간인데 보정 상수만 다르면:

보정 | DRY / WET | 표시
공장 기본값 | 3200 / 1400 | 70%
실측 | 2133 / 1750 | 50%

흙은 그대로인데 20%p가 움직입니다. 그래서 “밴드 상단 62%가 낮은가?”는 어느 자로 쟀는지를 먼저 말하지 않으면 답할 수 없는 질문입니다.

해법 — 밴드를 raw 로 정의합니다. raw 는 센서가 실제로 내는 값이라 보정을 바꿔도 흙 상태가 따라 움직이지 않습니다. %는 화면 표시용으로만 쓰세요.

기준점 세 개를 먼저 재두면 밴드를 숫자로 정할 수 있습니다

상태 | 재는 법 | 예시 raw
포장용수량 (젖음 끝) | 충분히 주고 5분 배수 후 | 1750
현재 흙 | 지금 화분 그대로 | 1940
공기 중 (마름 끝) | 흙에서 빼서 | 2133

⚠ 물에 담그지 마세요 — 표시선 위로 넘기면 회로가 상합니다.
공기는 마른 흙보다도 더 마르게 나옵니다(유전율: 물 80 · 마른 흙 2~5 · 공기 1). 정밀 보정이 필요해지면 DRY 를 말린 흙으로 다시 잡으세요.

두 처리군의 밴드 중심이 같아야 실험이 성립합니다. 폭만 다릅니다 — 그것이 이 실험의 독립변인이니까요.

처리군 | RAW_ON (마름) | RAW_OFF (젖음) | 폭 | 중심
꾸준군 stable | 1940 | 1900 | 40 | 1920
널뜀군 fluct | 2020 | 1820 | 200 | 1920

water_node.ino · 손으로 · 데모 · MQTT 없이 폐루프만 · 노드마다 맨 위 두 줄만 수정

/*
  water_node.ino — 급수 노드 폐루프 (2화분 데모)
  M5Stack Core S3 + Watering Unit U101      PUMP = G9 · SOIL = G8

  ■ 펄스 급수 — 연속 급수를 하지 않는 이유 셋
      ① 넘침        700mL 화분은 한 번에 부으면 표면에 고입니다
      ② 편류        마른 배양토는 발수성이 있어 벽면 따라 바닥으로 빠집니다
      ③ 센서 지연   물이 전극까지 퍼지는 데 3~10분. 즉시 재면 과급수합니다
    -> 도즈(짧게) → 대기 → 재측정 → 필요하면 반복

  ■ 노드마다 고칠 곳은 맨 위 두 줄(TREAT_FLUCT / PLANT_ID)뿐입니다.
*/
#include <M5Unified.h>

// ══════════════ 네트워크 (0 이면 완전 오프라인) ══════════════
// ★ 급수 판단은 이 보드 안에서 끝납니다. WiFi 가 죽어도 물은 계속 줍니다.
//   MQTT 는 <보고> 통로일 뿐이라, 끊기면 잃는 것은 로그뿐입니다.
#define USE_MQTT   1

#if USE_MQTT
  #include <WiFi.h>
  #include <PubSubClient.h>
  #include <string.h>
  const char* WIFI_SSID = "your-hotspot";
  const char* WIFI_PASS = "your-password";
  const char* BROKER    = "192.168.1.33";
  const int   BROKER_PORT = 1883;
  const char* NODE_ID   = "w2";             // 급수 노드 이름 (노드마다 다르게)

  const unsigned long SOIL_PUB_MS  = 300000UL;   // 5분마다 토양수분 보고
  const unsigned long RETRY_MS     = 10000UL;    // 재접속 시도 간격
  const int  QUEUE_MAX = 12;                     // 끊겼을 때 담아두는 이벤트 수
#endif

// ══════════════ 노드 설정 — 여기만 고칩니다 ══════════════
#define TREAT_FLUCT   1                 // 0 = 꾸준군(stable) · 1 = 널뜀군(fluct)
const char* PLANT_ID = "p2";            // 화분 이름 (p1, p2, ...)

// 센서 보정 — 2026-07 실측 (공기 2133 / 포장용수량 1750)
//   ★ raw 는 젖으면 내려갑니다.  마른 흙으로 DRY 를 다시 잡으면 이 두 줄만 고치세요.
const int RAW_DRY = 2120;
const int RAW_WET = 1750;

// ══════════════ 처리군별 상수 ══════════════
//  ★ 밴드를 % 가 아니라 raw 로 직접 씁니다.
//    % 는 보정 상수(RAW_DRY/RAW_WET)를 고치면 같은 흙이 다른 숫자로 보입니다.
//    raw 는 센서가 실제로 내는 값이라 보정을 바꿔도 흙 상태가 바뀌지 않습니다.
//
//  ★ 두 처리군의 <중심>이 같아야 실험이 성립합니다 — 폭만 다릅니다.
//       stable  (1940+1900)/2 = 1920
//       fluct   (2020+1820)/2 = 1920      <- 같아야 함
//
//  관측 기준점 (2026-07)   포장용수량 1750 · 물 안 준 화분 1940 · 공기 2133
#if TREAT_FLUCT
  const char* TREAT   = "fluct";
  const int   RAW_ON  = 2020;           // 이보다 크면(=마르면) 급수 시작
  const int   RAW_OFF = 1820;           // 이보다 작으면(=젖으면) 정지
  const int   DOSE_SEED = 600;          // 첫 도즈 6mL — 이후에는 학습값으로 조절
#else
  const char* TREAT   = "stable";
  const int   RAW_ON  = 1940;
  const int   RAW_OFF = 1900;
  const int   DOSE_SEED = 300;          // 첫 도즈 3mL — 이후에는 학습값으로 조절
#endif
const int BAND_CENTER = (RAW_ON + RAW_OFF) / 2;   // 두 노드가 같은지 부팅 로그로 확인

// ══════════════ 안전·타이밍 ══════════════
// ── 적응 급수 ──────────────────────────────────────────
// 한 번 물을 주면 raw 가 몇 counts 내려가는지를 <스스로 배웁니다>.
// 그 값으로 다음 도즈 길이를 정하므로, 펌프 유량이나 흙 상태가 달라져도 따라갑니다.
//   · 목표까지 남은 양의 APPROACH 만큼만 채웁니다 -> 넘치지 않게 접근
//   · 배운 값이 없으면 DOSE_SEED 로 시작합니다
const float APPROACH   = 1.00f;     // 남은 양만큼 채우기 (배운 값이 맞으면 한 번에 도달)
const float LEARN_RATE = 0.35f;     // 학습 반영률 (EMA)
const int   DOSE_MIN   = 300;       // 너무 짧으면 펌프가 물을 못 밀어냅니다
const int   DOSE_MAX   = 2000;      // 20mL — 700mL 화분에 한 번에 줄 수 있는 상한

// 실측 유량 (PRIME 10초에 100mL) — 화면에 mL 로 보여 주기 위한 값입니다.
// 제어에는 쓰지 않습니다. 펌프나 튜브를 바꾸면 다시 재서 고치세요.
const float ML_PER_SEC = 10.0f;

// ── 침투 시간 측정 모드 ────────────────────────────────
// 1 로 두고 한 사이클만 돌리면, 도즈 뒤 raw 가 <언제 평탄해지는지> 알 수 있습니다.
// 그 시각이 SETTLE_MS 의 근거입니다. 튜브·센서 배치를 바꿀 때마다 다시 재세요.
//   측정이 끝나면 반드시 0 으로 되돌리세요.
#define SOAK_TEST  0

#if SOAK_TEST
  const unsigned long SETTLE_MS  = 1800000UL;  // 30분 — 끝까지 지켜봅니다
  const unsigned long SOAK_LOG_MS = 10000UL;   // 10초마다 raw 출력
#else
  const unsigned long SETTLE_MS  = 180000UL;   // 3분 — 물이 센서까지 퍼지는 시간
#endif
const int            MAX_SHOTS   = 6;          // 한 사이클 도즈 상한 -> 넘으면 이상
const int            MIN_DROP    = 3;          // 1도즈당 최소 raw 하강(카운트)
const int            NO_RISE_MAX = 2;          // 연속 몇 번 안 오르면 고장으로 볼 것인가
const unsigned long PUMP_HARD_MS = 5000UL;     // 어떤 경우에도 연속 ON 금지 한계
const unsigned long COOLDOWN_MS  = 600000UL;   // 이상 판정 후 재시도 금지(10분)
const int            PIN_PUMP    = 9;
const int            PIN_SOIL    = 8;

// ══════════════ 상태 ══════════════
enum State { S_SAFE, S_IDLE, S_DOSING, S_SETTLE, S_FAULT };
State st = S_SAFE;                      // 부팅 직후엔 절대 급수하지 않습니다

int   rawSoil = 0, rawBefore = 0, rawCycleStart = 0;
int   shots = 0;
int   doseMs = 0;                   // 이번에 실제로 튼 시간
int   noRise = 0;                   // 연속으로 "안 올랐다" 가 나온 횟수
float kPerMs = 0.0f;                // 학습값: 1ms 당 내려가는 counts
bool pumpOn = false;
unsigned long tPump = 0, tSettle = 0, tSoakLog = 0, tFault = 0, tDraw = 0;
const char* faultMsg = "";
bool primeLatch = false;

// ── 버튼 영역 (rotation 1 = 320x240) ──
const int AX=8,  AY=178, AW=150, AH=54;         // ARM / STOP
const int BX=162,BY=178, BW=150, BH=54;         // PRIME (누르는 동안 펌프)

// ══════════════ 변환 ══════════════
float pctOf(int raw){
  float v = 100.0f * (RAW_DRY - raw) / (float)(RAW_DRY - RAW_WET);
  return v < 0 ? 0 : (v > 100 ? 100 : v);
}
int rawOf(float pct){
  return (int)lroundf(RAW_DRY - pct / 100.0f * (RAW_DRY - RAW_WET));
}

// ══════════════ 센서 ══════════════
// 펌프가 도는 동안은 읽지 않습니다. 인러시로 전원이 처지면 값이 흔들립니다.
int readSoil(){
  if (pumpOn) return rawSoil;
  long acc = 0;
  for (int i = 0; i < 16; i++){ acc += analogRead(PIN_SOIL); delay(2); }
  return (int)(acc / 16);
}

// ══════════════ 펌프 ══════════════
int planDose(int raw){
  int need = raw - RAW_OFF;                       // 목표까지 남은 counts
  if (need <= 0) return 0;
  if (kPerMs <= 0.0f) return DOSE_SEED;           // 아직 배운 게 없으면 씨앗값

  long ms = (long)(need * APPROACH / kPerMs);
  // ★ 남은 양이 <최소 도즈보다 작으면> 주지 않고 멈춥니다.
  //   조금 마른 채로 두는 것이, 넘겨서 젖히는 것보다 낫습니다 —
  //   초과는 평균을 올려 두 처리군의 <평균 일치>를 깨뜨립니다.
  if (ms < DOSE_MIN) return 0;
  if (ms > DOSE_MAX) ms = DOSE_MAX;
  return (int)ms;
}

void learn(int drop, int ms){
  if (drop <= 0 || ms <= 0) return;               // 안 내려갔으면 배우지 않습니다
  float k = (float)drop / (float)ms;
  kPerMs = (kPerMs <= 0.0f) ? k : (1 - LEARN_RATE) * kPerMs + LEARN_RATE * k;
}

void setPump(bool on){
  if (on == pumpOn) return;
  pumpOn = on;
  digitalWrite(PIN_PUMP, on ? HIGH : LOW);
  if (on) tPump = millis();
}

#if USE_MQTT
WiFiClient   wifiCli;
PubSubClient mqtt(wifiCli);
unsigned long tSoilPub = 0, tRetry = 0;

struct Ev { char reason[14]; int before, after, dur, shots; };
Ev  evq[QUEUE_MAX];
int evHead = 0, evCount = 0;

void enqueue(const char* reason, int before, int after, int dur){
  int i = (evHead + evCount) % QUEUE_MAX;
  if (evCount == QUEUE_MAX){ evHead = (evHead + 1) % QUEUE_MAX; evCount--; }  // 오래된 것부터 버림
  strncpy(evq[i].reason, reason, sizeof(evq[i].reason) - 1);
  evq[i].reason[sizeof(evq[i].reason) - 1] = 0;
  evq[i].before = before; evq[i].after = after; evq[i].dur = dur; evq[i].shots = shots;
  evCount++;
}

bool netReady(){
  if (WiFi.status() != WL_CONNECTED) return false;
  if (mqtt.connected()) return true;
  unsigned long now = millis();
  if (now - tRetry < RETRY_MS) return false;      // ★ 절대 기다리지 않습니다
  tRetry = now;
  char cid[32]; snprintf(cid, sizeof(cid), "water-%s", NODE_ID);
  return mqtt.connect(cid);
}

void pubSoil(){
  char t[48], m[160];
  snprintf(t, sizeof(t), "plant/%s/soil", NODE_ID);
  snprintf(m, sizeof(m),
           "{\"node\":\"%s\",\"plant_id\":\"%s\",\"treat\":\"%s\","
           "\"pct\":%.1f,\"raw\":%d,\"n\":1}",
           NODE_ID, PLANT_ID, TREAT, pctOf(rawSoil), rawSoil);
  mqtt.publish(t, m);
}

void flushEvents(){
  while (evCount > 0){
    Ev& e = evq[evHead];
    char t[48], m[240];
    snprintf(t, sizeof(t), "plant/%s/pump", NODE_ID);
    snprintf(m, sizeof(m),
             "{\"node\":\"%s\",\"plant_id\":\"%s\",\"treat\":\"%s\",\"dur_ms\":%d,"
             "\"soil_before\":%.1f,\"soil_after\":%.1f,"
             "\"raw_before\":%d,\"raw_after\":%d,\"shots\":%d,\"reason\":\"%s\"}",
             NODE_ID, PLANT_ID, TREAT, e.dur, pctOf(e.before), pctOf(e.after),
             e.before, e.after, e.shots, e.reason);
    if (!mqtt.publish(t, m)) return;              // 실패하면 다음 기회에 다시
    evHead = (evHead + 1) % QUEUE_MAX; evCount--;
  }
}

void netLoop(){
  // 연결 상태가 <바뀔 때만> 한 줄 찍습니다. 붙었는지 안 붙었는지 알 수 있어야 합니다.
  static bool wasWifi = false, wasMqtt = false;
  bool nowWifi = (WiFi.status() == WL_CONNECTED);
  if (nowWifi != wasWifi){
    wasWifi = nowWifi;
    if (nowWifi) Serial.printf("[WIFI] 연결됨  %s\n", WiFi.localIP().toString().c_str());
    else         Serial.println("[WIFI] 끊김 — 급수는 계속됩니다");
  }
  bool nowMqtt = mqtt.connected();
  if (nowMqtt != wasMqtt){
    wasMqtt = nowMqtt;
    Serial.printf("[MQTT] %s  %s:%d\n", nowMqtt ? "연결됨" : "끊김", BROKER, BROKER_PORT);
  }

  if (!netReady()) return;
  mqtt.loop();
  flushEvents();                                  // 밀린 이벤트부터
  unsigned long now = millis();
  if (now - tSoilPub >= SOIL_PUB_MS){ tSoilPub = now; pubSoil(); }
}
#endif

void logEvent(const char* reason, int before, int after, int dur){
  // 필드 이름을 MQTT payload 와 같게 맞춰 둡니다 — 나중에 그대로 발행하면 됩니다.
  Serial.printf("{\"plant_id\":\"%s\",\"treat\":\"%s\",\"dur_ms\":%d,"
                "\"soil_before\":%.1f,\"soil_after\":%.1f,"
                "\"raw_before\":%d,\"raw_after\":%d,\"shots\":%d,\"reason\":\"%s\"}\n",
                PLANT_ID, TREAT, dur, pctOf(before), pctOf(after),
                before, after, shots, reason);
#if USE_MQTT
  enqueue(reason, before, after, dur);      // ★ 먼저 담고, 발행은 되는 대로
#endif
}

void toFault(const char* msg){
  setPump(false);
  st = S_FAULT; tFault = millis(); faultMsg = msg;
  logEvent(msg, rawCycleStart, rawSoil, 0);
}

// ══════════════ 화면 ══════════════
void drawUI(){
  M5.Display.startWrite();
  M5.Display.fillRect(0, 0, 320, 174, BLACK);

  M5.Display.setTextSize(2); M5.Display.setTextColor(TREAT[0]=='f' ? ORANGE : CYAN, BLACK);
  M5.Display.setCursor(10, 8);   M5.Display.printf("%s  %s", PLANT_ID, TREAT);

  M5.Display.setTextSize(3); M5.Display.setTextColor(WHITE, BLACK);
  M5.Display.setCursor(10, 34);  M5.Display.printf("%5.1f %%", pctOf(rawSoil));
  M5.Display.setTextSize(2); M5.Display.setTextColor(DARKGREY, BLACK);
  M5.Display.setCursor(190, 44); M5.Display.printf("raw %4d", rawSoil);

  M5.Display.setTextColor(DARKGREY, BLACK);
  M5.Display.setCursor(10, 74);
  M5.Display.printf("band %.0f-%.0f%% (raw %d..%d)",
                    pctOf(RAW_ON), pctOf(RAW_OFF), RAW_ON, RAW_OFF);

  const char* sn = "?";
  uint16_t sc = WHITE;
  switch (st){
    case S_SAFE:   sn = "SAFE (not armed)"; sc = DARKGREY; break;
    case S_IDLE:   sn = "watching";         sc = GREEN;    break;
    case S_DOSING: sn = "DOSING";           sc = RED;      break;
    case S_SETTLE: sn = "settling";         sc = YELLOW;   break;
    case S_FAULT:  sn = faultMsg;           sc = RED;      break;
  }
  M5.Display.setTextColor(sc, BLACK);
  M5.Display.setCursor(10, 100); M5.Display.printf("%-18s", sn);

  M5.Display.setTextColor(DARKGREY, BLACK);
  M5.Display.setCursor(10, 126);
  if (st == S_SETTLE){
    long left = (long)(SETTLE_MS - (millis() - tSettle)) / 1000;
    if (left < 0) left = 0;
    M5.Display.printf("wait %3lds  shot %d/%d", left, shots, MAX_SHOTS);
  } else if (st == S_FAULT){
    long left = (long)(COOLDOWN_MS - (millis() - tFault)) / 1000;
    if (left < 0) left = 0;
    M5.Display.printf("cooldown %3lds     ", left);
  } else {
    M5.Display.printf("shot %d/%d  %dms=%.1fmL  k%.2f",
                      shots, MAX_SHOTS, doseMs, doseMs / 1000.0f * ML_PER_SEC, kPerMs);
  }

  M5.Display.fillRoundRect(AX, AY, AW, AH, 8, st == S_SAFE ? NAVY : DARKGREEN);
  M5.Display.fillRoundRect(BX, BY, BW, BH, 8, pumpOn ? RED : 0x2104);
  M5.Display.setTextSize(2); M5.Display.setTextColor(WHITE);
  M5.Display.setCursor(AX + 34, AY + 18); M5.Display.print(st == S_SAFE ? "ARM " : "STOP");
  M5.Display.setCursor(BX + 26, BY + 18); M5.Display.print("PRIME");
  M5.Display.endWrite();
}

// ══════════════ setup ══════════════
void setup(){
#if USE_MQTT
  WiFi.mode(WIFI_STA);
  Serial.printf("[WIFI] ssid=[%s] pass_len=%d  broker=%s:%d\n",
                WIFI_SSID, (int)strlen(WIFI_PASS), BROKER, BROKER_PORT);
  WiFi.begin(WIFI_SSID, WIFI_PASS);         // ★ 연결될 때까지 기다리지 않습니다.
  WiFi.setAutoReconnect(true);              //   물 주는 일이 네트워크를 기다리면 안 됩니다.
  mqtt.setServer(BROKER, BROKER_PORT);
  mqtt.setKeepAlive(60);
#endif
  auto cfg = M5.config(); M5.begin(cfg);
  Serial.begin(115200);
  pinMode(PIN_PUMP, OUTPUT); digitalWrite(PIN_PUMP, LOW);   // 반드시 LOW 부터
  pinMode(PIN_SOIL, INPUT);  analogReadResolution(12);
  M5.Display.setRotation(1);
  M5.Display.fillScreen(BLACK);

  rawSoil = readSoil();

  Serial.printf("\n[BOOT] %s %s  raw %d..%d (gap %d) · center %d = %.1f%%\n",
                PLANT_ID, TREAT, RAW_ON, RAW_OFF, RAW_ON - RAW_OFF,
                BAND_CENTER, pctOf(BAND_CENTER));
  Serial.printf("[BOOT] 지금 흙: raw %d = %.1f%%\n", rawSoil, pctOf(rawSoil));
  Serial.printf("[BOOT] 첫 도즈 %d ms (%.1f mL) · 대기 %lu s · 최대 %d회 · 도즈 %d~%d ms\n",
                DOSE_SEED, DOSE_SEED / 1000.0f * ML_PER_SEC,
                SETTLE_MS / 1000, MAX_SHOTS, DOSE_MIN, DOSE_MAX);
  if (RAW_ON - RAW_OFF < 20)
    Serial.println("[WARN] 밴드가 raw 20카운트 미만입니다 — 노이즈와 구분이 어렵습니다");
  Serial.println("[BOOT] SAFE 상태. 초기 젖음을 끝낸 뒤 ARM 을 누르세요.");
  drawUI();
}

// ══════════════ loop ══════════════
void loop(){
#if USE_MQTT
  netLoop();                                // 연결·발행 — 어떤 경우에도 블로킹하지 않습니다
#endif
  M5.update();
  unsigned long now = millis();

  // ── 하드 상한: 무슨 상태든 이 시간을 넘겨 켜져 있으면 강제 OFF ──
  if (pumpOn && now - tPump > PUMP_HARD_MS){
    setPump(false); primeLatch = true;
    Serial.println("[SAFETY] hard limit");
    if (st == S_DOSING){ st = S_SETTLE; tSettle = now; tSoakLog = now; }
  }

  // ── 터치 ──
  auto t = M5.Touch.getDetail();
  bool inA = t.isPressed() && t.x>=AX && t.x<=AX+AW && t.y>=AY && t.y<=AY+AH;
  bool inB = t.isPressed() && t.x>=BX && t.x<=BX+BW && t.y>=BY && t.y<=BY+BH;

  if (t.wasPressed() && inA){
    if (st == S_SAFE){ st = S_IDLE; shots = 0; Serial.println("[ARM] 폐루프 시작"); }
    else { setPump(false); st = S_SAFE; Serial.println("[STOP] SAFE 로 복귀"); }
  }

  // PRIME — 누르는 동안만. 손을 떼야 다시 켜집니다(하드 상한 무력화 방지).
  if (st == S_SAFE || st == S_FAULT){
    if (inB && !pumpOn && !primeLatch) setPump(true);
    if (!inB){ if (pumpOn) setPump(false); primeLatch = false; }
  }

  // ── 상태기계 ──
  switch (st){

    case S_IDLE:
      rawSoil = readSoil();
      if (rawSoil >= RAW_ON){                 // raw 가 크다 = 말랐다
        rawCycleStart = rawSoil; shots = 0;
        rawBefore = rawSoil; doseMs = planDose(rawSoil);
        if (doseMs > 0){ setPump(true); st = S_DOSING; }
      }
      break;

    case S_DOSING:
      if (now - tPump >= (unsigned long)doseMs){
        setPump(false); shots++;
        st = S_SETTLE; tSettle = now; tSoakLog = now;
      }
      break;

    case S_SETTLE:
#if SOAK_TEST
      if (now - tSoakLog >= SOAK_LOG_MS){       // 침투 곡선을 그대로 찍습니다
        tSoakLog = now;
        Serial.printf("[SOAK] %5lus  raw %4d  (도즈 후 하강 %d)\n",
                      (now - tSettle) / 1000, rawSoil, rawBefore - rawSoil);
      }
#endif
      if (now - tSettle >= SETTLE_MS){
        rawSoil = readSoil();
        int drop = rawBefore - rawSoil;        // 젖으면 raw 가 내려갑니다
        learn(drop, doseMs);                   // ★ 다음 도즈 길이에 반영
        logEvent("dosed", rawBefore, rawSoil, doseMs);

        if (drop >= MIN_DROP) noRise = 0;      // 한 번이라도 올랐으면 초기화

        if (rawSoil <= RAW_OFF){               // 목표 도달
          logEvent("filled", rawCycleStart, rawSoil, doseMs);
          shots = 0; noRise = 0; st = S_IDLE;
        } else if (drop < MIN_DROP && ++noRise >= NO_RISE_MAX){
          // ★ 한 번으로 단정하지 않습니다.
          //   마른 흙은 첫 도즈가 통째로 빠져나가 센서까지 안 옵니다 —
          //   진짜 고장(튜브 빠짐·물통 빔)이면 <연속으로> 안 오릅니다.
          toFault("no rise");                  // 물통·튜브 확인
        } else if (shots >= MAX_SHOTS){        // 너무 여러 번
          toFault("verify fail");
        } else {
          rawBefore = rawSoil; doseMs = planDose(rawSoil);
          if (doseMs > 0){ setPump(true); st = S_DOSING; }
          else {                                 // 한 방울이면 넘칩니다 — 여기서 끝
            logEvent("filled", rawCycleStart, rawSoil, 0);
            shots = 0; st = S_IDLE;
          }
        }
      }
      break;

    case S_FAULT:
      if (now - tFault >= COOLDOWN_MS){        // 쿨다운 뒤 한 번 더 기회
        shots = 0; noRise = 0; st = S_IDLE;
        Serial.println("[FAULT] cooldown 종료 — 재시도");
      }
      break;

    case S_SAFE:
      rawSoil = readSoil();
      break;
  }

  if (now - tDraw > 250){ drawUI(); tDraw = now; }
}

이 단계 통과 조건

- 부팅 직후 SAFE — 손대기 전에는 펌프가 절대 안 돕니다
- PRIME으로 튜브에 물이 차고, 손을 떼면 즉시 멈춥니다
- ARM 후 마른 화분에서 도즈 → 3분 대기 → 재측정이 반복됩니다
- 목표에 닿으면 filled 로그가 뜨고 스스로 멈춥니다
- 튜브를 일부러 빼면 no rise 로 멈춥니다 — 계속 돌면 안 됩니다

시리얼 로그가 MQTT 페이로드와 같은 필드명으로 나옵니다. 다음 절은 이걸 그대로 발행하는 것뿐입니다.

### 1) 본 펌웨어 — WiFi + MQTT 까지

plant_water_cores3.ino

/*
 * ═══════════════════════════════════════════════════════════
 *  식물 생장 모니터링 — 급수 노드 (M5Stack Core S3 + Unit Watering U101)
 *
 *  이 노드는 화분 하나를 담당하고, 그 안에서 제어가 완결됩니다.
 *  -> WiFi/브로커가 죽어도 급수는 계속됩니다. 잃는 건 로그뿐.
 *
 *  Port B (Core S3, G8/G9) : G8=흰색 Analog(토양수분) / G9=노랑 PUMP_EN  [실측 확정]
 *  발행   : plant/<nodeId>/soil  (5분 평균)
 *           plant/<nodeId>/pump  (급수 이벤트)
 *
 *  Safety : hysteresis / dose+soak+verify / daily cap / fail-safe OFF
 * ═══════════════════════════════════════════════════════════
 */
#include <M5Unified.h>
#include <WiFi.h>
#include <PubSubClient.h>
#include <time.h>

// ══════════ 사용자 설정 ══════════
const char* WIFI_SSID = "your-hotspot";
const char* WIFI_PASS = "your-password";
const char* BROKER    = "192.168.0.15";     // ★ PC의 IPv4
const int   PORT      = 1883;

const char* PLANT_ID  = "p1";               // ★ 화분 번호 (노드마다 다르게)
const char* TREAT     = "stable";           // ★ "stable" 또는 "fluct" — 다른 값은 대시보드가 거부

// ★ 실측 확정: Core S3 Port B — PUMP=G9, SOIL=G8
const int PIN_SOIL = 8;                     // 흰색 Analog Output (실측 확정)
const int PIN_PUMP = 9;                     // 노랑 PUMP_EN   (실측 확정)

// ★ 보정①의 결과로 교체 — 절대 그대로 쓰지 말 것
const int SOIL_DRY = 2133;                  // ★ 실측으로 교체 (공기 중 또는 마른 흙)
const int SOIL_WET = 1750;                  // ★ 실측으로 교체 (충분 급수 + 5분 배수)

// ★ 처리 밴드 — 6대의 코드는 전부 같고 이 두 줄만 다름 = 곧 실험의 처리 조건
//   널뜀군 : ON_BELOW=시드는지점+여유  /  OFF_AT=포장용수량 바로 아래  (폭 최대)
//   꾸준군 : 널뜀군의 '실측 평균'을 중심으로 폭 최소 (예: 33 / 36)
int RAW_ON  = 2020;                         // ★ raw 로 직접. 이보다 크면(=마르면) 시작
int RAW_OFF = 1820;                         // ★ 이보다 작으면(=젖으면) 정지
//   두 처리군의 <중심>이 같아야 합니다 — 폭만 다르게: (RAW_ON+RAW_OFF)/2 를 맞추세요
const int MAX_DOSE_PER_FILL = 8;            // 한 번 채우는 데 최대 급수 횟수 (안전)

const unsigned long DOSE_MS = 3000;         // ★ 보정②의 결과로 교체
const unsigned long SOAK_MS = 1200000UL;    // 20분 — 절대 줄이지 말 것
const float MIN_RISE  = 2.0;                // % 미만이면 급수 실패로 간주
const int   DAILY_MAX = 6;

const int PUBLISH_MIN = 5;
const unsigned long SAMPLE_MS = 10000;
// ════════════════════════════════

WiFiClient net;
PubSubClient client(net);

String nodeId, tSoil, tPump;
double sSoil = 0; int n = 0;
bool timeOK = false;
long curBucket = -1;
unsigned long lastSample = 0;

// ── 급수 상태기계 ──
uint8_t  st = 0;                            // 0=DRYING 1=DOSING 2=SOAKING
int      nFill = 0;                         // 이번 '채움'에서 급수한 횟수
unsigned long tMark = 0;
float    before = 0, lastSoil = 0;
int      nToday = 0;
int      curDay = -1;
bool     armed = true;

void makeNodeId() {
  byte mac[6]; WiFi.macAddress(mac);
  char id[16];
  snprintf(id, sizeof(id), "wtr_%02X%02X%02X", mac[3], mac[4], mac[5]);
  nodeId = String(id);
  tSoil  = "plant/" + nodeId + "/soil";
  tPump  = "plant/" + nodeId + "/pump";
}

void connectWiFi() {
  if (WiFi.status() == WL_CONNECTED) return;
  WiFi.begin(WIFI_SSID, WIFI_PASS);
  unsigned long t0 = millis();
  while (WiFi.status() != WL_CONNECTED && millis() - t0 < 15000) delay(500);
}

void connectBroker() {
  int tries = 0;
  while (!client.connected() && tries++ < 3) {     // 3회만 — 급수를 막지 않도록
    connectWiFi();
    String cid = nodeId + "-" + String(random(0xffff), HEX);
    if (client.connect(cid.c_str())) { Serial.println("MQTT OK"); return; }
    Serial.print("MQTT rc="); Serial.println(client.state());
    delay(1000);
  }
}

void syncTime() {
  configTime(0, 0, "pool.ntp.org", "time.google.com");
  struct tm ti;
  unsigned long t0 = millis();
  while (!getLocalTime(&ti, 500) && millis() - t0 < 10000) delay(100);
  timeOK = getLocalTime(&ti, 500);
  Serial.println(timeOK ? "NTP OK" : "NTP FAIL");
}

long nowEpoch() { time_t t; time(&t); return (long)t; }

String epochToStr(long e) {
  time_t t = (time_t)e; struct tm ti; gmtime_r(&t, &ti);
  char b[32]; strftime(b, sizeof(b), "%Y-%m-%d %H:%M:%S", &ti);
  return String(b);
}

// 정전용량식: 젖을수록 ADC가 낮아짐 -> 반전 매핑
float soilPct(int raw) {
  float p = (float)(SOIL_DRY - raw) * 100.0f / (float)(SOIL_DRY - SOIL_WET);
  if (p < 0) p = 0;
  if (p > 100) p = 100;
  return p;
}

void publishPump(float aft, const char* reason) {
  char p[288];
  String ts = timeOK ? epochToStr(nowEpoch()) : String("");
  snprintf(p, sizeof(p),
    "{\"node\":\"%s\",\"plant_id\":\"%s\",\"treat\":\"%s\",\"t\":\"%s\","
    "\"dur_ms\":%lu,\"soil_before\":%.1f,\"soil_after\":%.1f,\"reason\":\"%s\"}",
    nodeId.c_str(), PLANT_ID, TREAT, ts.c_str(),
    (unsigned long)nFill * DOSE_MS, before, aft, reason);   // 채움 1회 총 급수시간
  client.publish(tPump.c_str(), p, true);   // retained: 마지막 급수 상태 보존
  Serial.print("PUMP: "); Serial.println(p);
}

// 하루 경계 (UTC 기준 — DB와 일치)
void rollDay() {
  if (!timeOK) return;
  int d = (int)(nowEpoch() / 86400L);
  if (d != curDay) { curDay = d; nToday = 0; }
}

void startDose(unsigned long now) {
  nToday++; nFill++;
  digitalWrite(PIN_PUMP, HIGH); tMark = now; st = 1;
}

void pumpTick(float soil) {
  unsigned long now = millis();
  lastSoil = soil;
  switch (st) {
    case 0:                                        // DRYING — 마르길 기다림
      if (!armed || nToday >= DAILY_MAX) break;
      if (soil < ON_BELOW) {
        before = soil; nFill = 0; startDose(now);
        Serial.printf("[fill] soil %.1f%% < %.1f%% -> 목표 %.1f%%\n",
                      soil, ON_BELOW, OFF_AT);
      }
      break;

    case 1:                                        // DOSING
      if (now - tMark >= DOSE_MS) {
        digitalWrite(PIN_PUMP, LOW); tMark = now; st = 2;
      }
      break;

    case 2:                                        // SOAKING -> 판정
      if (now - tMark < SOAK_MS) break;

      if (soil - before < MIN_RISE) {              // 튜브 빠짐/물통 빔/펌프 고장
        armed = false;
        Serial.printf("[!!] VERIFY FAIL %.1f -> %.1f -- 무장해제\n", before, soil);
        publishPump(soil, "verify_fail");
        st = 0; break;
      }

      if (soil < OFF_AT && nFill < MAX_DOSE_PER_FILL) {
        before = soil; startDose(now);             // ★ 목표까지 반복
        Serial.printf("[dose %d] %.1f%% -> 계속\n", nFill, soil);
      } else {
        Serial.printf("[done] %.1f%% (급수 %d회) -- 이제 마르게 둠\n", soil, nFill);
        publishPump(soil, "filled");               // ★ 도달 -> 손 떼고 마르게 둠
        st = 0;
      }
      break;
  }
}

void publishSoil(long bucket) {
  if (n <= 0) return;
  char p[224];
  String ts = timeOK ? epochToStr(bucket) : String("");
  snprintf(p, sizeof(p),
    "{\"node\":\"%s\",\"plant_id\":\"%s\",\"treat\":\"%s\",\"t\":\"%s\","
    "\"pct\":%.1f,\"n\":%d}",
    nodeId.c_str(), PLANT_ID, TREAT, ts.c_str(), sSoil / n, n);
  client.publish(tSoil.c_str(), p);
  Serial.print("PUB: "); Serial.println(p);
}

void drawScreen() {
  const char* S[] = {"DRY ", "DOSE", "SOAK"};
  M5.Display.setCursor(0, 0);
  M5.Display.setTextSize(3);
  M5.Display.printf("%s / %s\n\n", PLANT_ID, TREAT);
  M5.Display.printf("%5.1f %%\n\n", lastSoil);
  M5.Display.setTextSize(2);
  M5.Display.printf("band %.0f-%.0f\n", ON_BELOW, OFF_AT);
  M5.Display.printf("%s  today %d\n", S[st], nToday);
  M5.Display.printf("%s %s\n", armed ? "ARMED " : "DISARM",
                    client.connected() ? "MQTT" : "----");
}

void setup() {
  // ★ 무엇보다 먼저 — 부팅 중 펌프가 도는 것을 막음
  pinMode(PIN_PUMP, OUTPUT);
  digitalWrite(PIN_PUMP, LOW);

  auto cfg = M5.config();
  M5.begin(cfg);
  M5.Display.setTextColor(CYAN, BLACK);
  Serial.begin(115200);

  analogReadResolution(12);
  pinMode(PIN_SOIL, INPUT);

  connectWiFi();
  makeNodeId();
  syncTime();
  rollDay();
  client.setServer(BROKER, PORT);
  connectBroker();

  Serial.printf("Node : %s  (%s / %s)\n", nodeId.c_str(), PLANT_ID, TREAT);
  Serial.printf("Band : %.1f - %.1f %%\n", ON_BELOW, OFF_AT);
  if (timeOK) { long s = PUBLISH_MIN * 60L; curBucket = (nowEpoch() / s) * s; }
}

void loop() {
  M5.update();
  // 브로커가 없어도 급수는 계속되어야 함 -> 재연결이 루프를 막지 않게
  if (!client.connected()) {
    static unsigned long lastTry = 0;
    if (millis() - lastTry > 30000) { lastTry = millis(); connectBroker(); }
  }
  client.loop();
  rollDay();

  unsigned long now = millis();
  if (now - lastSample >= SAMPLE_MS) {
    lastSample = now;
    float soil = soilPct(analogRead(PIN_SOIL));
    sSoil += soil; n++;
    pumpTick(soil);                              // 5분 평균이 아니라 현재값으로
    drawScreen();
  }

  long s = PUBLISH_MIN * 60L;
  if (timeOK) {
    long bucket = (nowEpoch() / s) * s;
    if (curBucket < 0) curBucket = bucket;
    if (bucket != curBucket) {
      publishSoil(curBucket); sSoil = 0; n = 0; curBucket = bucket;
    }
  } else {
    static unsigned long lastPub = 0;
    if (now - lastPub >= (unsigned long)PUBLISH_MIN * 60000UL) {
      lastPub = now; publishSoil(0); sSoil = 0; n = 0;
    }
  }
  delay(20);
}

### 테스트 — 흙 담은 화분에서

튜브를 빈 컵에 두면 정작 검증할 게 검증되지 않습니다 빈 컵이면 수분 폐루프가 안 닫힙니다 — 물을 줘도 센서값이 안 오르니 무조건 verify_fail입니다. 흙 → 센서 → 펌프 → 흙이 실제로 돌아야 dose → soak → verify가 진짜로 시험됩니다. 화분에 흙만 담고 씨앗은 넣지 마세요. 데모 단계에는 식물이 없어야 합니다 — 지금 확인할 것은 루프가 도는가뿐입니다.

- 흙을 말려 ON_BELOW 아래로 → 펌프 작동, 화면 DOSE
- 20분 후 SOAK → 목표 미달이면 다시 DOSE → 도달하면 DRY, pump_log에 filled 1행
- ★ 급수 직후 튜브를 물통에서 빼고 다시 유도 → verify_fail + 화면 DISARM
- 재부팅 → 펌프 안 돌고 정상 시작 (10k 풀다운 확인)
- 브로커를 끄고 방치 → 급수는 계속됨, 켜면 재연결
- ★ 며칠 방치 → 톱니가 반복되는가 · pump_log에서 주기 확인 (패널 6)
- ★ 로그에서 평균과 σ가 계산되는가 — SELECT AVG(pct), COUNT(*) FROM soil;

SOAK 중 5분 발행이 계속되는지 보세요 상태기계가 제대로 짜였다면 20분 대기 중에도 PUB: {...soil...}이 4번 나옵니다. 멈춘다면 어딘가에서 블로킹하고 있는 것이고, 그러면 verify가 항상 실패합니다.

◀ 이전다음 ▶

## 8라즈베리파이 + 카메라 추가

Pi가 맡는 것은 카메라와 24시간 무인 운용입니다. 브로커·run_collector.py 자체는 패널 1·2와 동일하고, 여기서는 Pi에서만 되는 것과 전원만 꽂으면 알아서 도는 구성을 다룹니다.

### 1) 설치 — 저장소를 그대로 클론하고 install.sh 한 번

2026-09 판부터 Pi 에는 저장소 구조 그대로 올립니다. 예전처럼 hub/ 안의 파일을 ~/plant 에 펼쳐 놓지 않습니다. 런타임 데이터(plant.db · events.db · config.json · calib.jpg · photos/)는 전부 ~/plant/data/(PLANT_DATA_DIR) 한 곳에 모입니다 — git 이 건드리지 않는 폴더라 git pull 이 데이터를 덮을 일이 없습니다.

Pi — 처음 설치 (다른 Debian 계열 SBC 도 동일)

git clone https://github.com/xparapx/Plant_Growth_Monitoring_Demo.git ~/plant
cd ~/plant
scripts/install.sh --set-timezone      # apt → uv venv → uv sync → data/config.json 시드 → 웹 UI → systemd 유닛 렌더·설치 → 활성화 → doctor

hostname -I                            # ← 노드 펌웨어에 넣을 BROKER 주소

12 단계가 순서대로 찍히고, 마지막에 plantsvc doctor 점검표와 http://<pi>:8080/ 안내가 나옵니다. 노드 펌웨어의 BROKER만 Pi 의 IP 로 바꿔 재업로드하면 끝입니다. 옵션과 각 단계의 설명은 패널 20에 있습니다.

PC 에서, 또는 예전 평탄화 설치에서 만들던 게 있다면 — migrate_legacy.sh 해당자만 2026-07 판 방식(~/plant 에 run_collector.py·plant.db·photos/ 가 나란히)으로 돌리고 있었다면 그 폴더를 옆으로 치우고 새로 클론한 뒤 데이터만 옮깁니다. 복사만 하고 원본은 절대 지우지 않습니다.

mv ~/plant ~/plant.legacy-$(date +%Y%m%d)
git clone https://github.com/xparapx/Plant_Growth_Monitoring_Demo.git ~/plant
cd ~/plant
scripts/migrate_legacy.sh --from ~/plant.legacy-20260910     # plant.db(sqlite backup) · config.json · calib.jpg · truth.json · photos/ → data/
scripts/install.sh --set-timezone

PC 에서 쌓은 plant.db 도 같은 방법입니다 — scp 로 임시 폴더에 올린 뒤 --from 으로 가리키면 됩니다. 옮긴 뒤 data/MIGRATED_FROM.txt 에 출처와 테이블별 행 수가 남습니다. 예전 유닛(plantdash·plantcam)은 install.sh 가 비활성화합니다 — 파일은 남겨 둡니다.

첫 점검 — plantsvc doctor 설치 끝에 자동으로 한 번 돌고, 언제든 cd ~/plant && .venv/bin/plantsvc doctor 로 다시 볼 수 있습니다. venv · import(picamera2·cv2·gpiozero) · config.json · 데이터 폴더 · DB 행 수 · 브로커 · 카메라 · 카메라 잠금 · LED · 타이머 · 시간대 · NTP · 유닛 · web/dist 를 OK / WARN / FAIL / SKIP 으로 찍고, 고치는 명령을 옆에 적어 줍니다. 무언가 이상하면 이 표부터 보세요.

IP를 고정하세요 공유기 관리페이지에서 DHCP 예약으로 Pi의 IP를 묶어두세요. 재부팅 때 IP가 바뀌면 노드 전부의 펌웨어를 다시 올려야 합니다.

### 2) 카메라 인식

Pi

rpicam-hello --list-cameras     # 카메라가 목록에 뜨면 성공
rpicam-jpeg -o test.jpg -t 2000

Pi 5는 케이블 규격이 다릅니다 Pi 5의 CSI 포트는 22핀 미니입니다. Pi 4용 15핀 케이블은 물리적으로 안 맞습니다. --list-cameras에 아무것도 안 뜨면 십중팔구 케이블입니다. 전원 끄고 재체결, 파란 면이 USB 포트 쪽.

### 3) ★ 오토포커스·자동노출을 반드시 끄세요

이 프로젝트에서 오토포커스는 기능이 아니라 결함입니다 초점이 재조정되면 유효 초점거리가 미세하게 변합니다(focus breathing) → 배율이 바뀝니다 → 자라지도 않은 종이 잎의 면적이 날마다 달라집니다.

자동 화이트밸런스·자동노출은 더 심각합니다. 잎이 커지면 화면이 초록해지고 → 카메라가 보정하고 → 색이 달라지고 → ExG가 엉뚱해집니다. 한 번 정한 뒤 6주간 절대 바꾸지 마세요.

값은 여기서 정하고, 찍는 것은 패널 10이 합니다 이 네 가지를 config.json의 capture에 적습니다 — lens_position · exposure_us · gain · colour_gains.
실제 촬영은 패널 10의 웹 UI /camera/setup에서 화면을 보면서 합니다([자동 측정 → 고정]이 한 번 재서 잠급니다). 별도의 촬영 스크립트는 두지 않습니다 — 같은 일을 하는 스크립트가 둘이면 반드시 어긋납니다.

값 | 의미 | 정하는 법
LensPosition | 디옵터 = 1 / 거리(m). 0.55m → 1.82 | rpicam-still --autofocus-mode auto로 한 번 잡고 메타데이터에서 읽어 고정
ExposureTime | 노출 µs | 사진이 어둡/밝으면 조정 후 확정
size | 4608×2592 = IMX708 최대 | 하루 1장이라 속도 부담 없음. 떡잎 경계 오차가 4%→2%로 개선

해상도를 최대로 쓰는 이유 발아 직후 5cm² 떡잎은 둘레가 짧아 경계 픽셀 비중이 큽니다. 2304px에선 경계가 면적의 4%(오차 예산 5%를 거의 다 먹음), 4608px에선 2%로 떨어집니다.

⚠ 순서를 지키세요 — start() → set_controls() → sleep(2) set_controls()를 start() 앞에 두면 LensPosition·ColourGains 같은 값이 적용되지 않을 수 있습니다. 센서가 돌기 시작해야 반영되는 값이기 때문입니다.
이게 가장 나쁜 종류의 실패입니다 — 에러도 안 나고 사진도 멀쩡히 나옵니다. 다만 자동 노출·자동 화이트밸런스로 찍힌 사진일 뿐이라, 6주 뒤 면적 그래프가 흔들리고 나서야 알게 됩니다.
sleep(2)도 빼지 마세요. 설정 직후 바로 찍으면 이전 설정으로 찍힙니다.
패널 11의 plantsvc capture도 같은 순서입니다 — 미리보기·기준 사진·매일 촬영이 같은 CameraManager 코드를 쓰므로 어긋날 곳이 없습니다. (예전처럼 setup_camera.py와 run_capture.py가 따로 있던 때는 두 스크립트가 다르면 calib.jpg와 매일 찍는 사진의 색이 달라졌습니다.)

### 4) ★ systemd — 전원만 꽂으면 알아서 도는 구성

SSH로 띄운 프로그램은 SSH가 끊기면 같이 죽습니다 uv run python run_collector.py를 터미널에서 띄우면, SSH 세션이 끊기는 순간 run_collector.py도 종료됩니다. 정전·재부팅 후에도 안 살아납니다.

6주 무인 운용에서 이건 치명적입니다. 급수는 노드가 알아서 하지만, "평균이 같았다"를 증명할 로그가 통째로 비게 됩니다. 실험이 성립을 못 합니다.

서비스로 등록하면 부팅 시 자동 시작 · 죽으면 자동 재시작 · SSH와 무관해집니다.

먼저 — mosquitto는 이미 등록돼 있습니다 apt로 설치하면 자동 등록됩니다. 확인만 하세요.

systemctl is-enabled mosquitto     # enabled 여야 함
systemctl is-active  mosquitto     # active  여야 함

# enabled가 아니면
sudo systemctl enable --now mosquitto

2026-09 — 유닛 파일은 install.sh 가 템플릿에서 렌더해 설치합니다 deploy/systemd/*.tmpl 에는 계정·경로가 없습니다. install.sh(또는 plantsvc render-units)가 현재 사용자(id -un) · 현재 클론 경로 · data/config.json(촬영 시각·LED 워밍업) 을 채워 /etc/systemd/system/ 에 넣고 daemon-reload 까지 합니다. 그래서 User=·WorkingDirectory=·uv 경로를 손으로 고칠 일이 없습니다. config.json 에서 촬영 시각이나 LED 설정을 바꿨다면 scripts/install.sh --update 로 다시 렌더하세요.

유닛 | 하는 일 | 비고
planthub.service | hub/run_collector.py — MQTT → SQLite | plant.db 의 유일한 writer. Requires=mosquitto
plantsvc.service | plantsvc serve — 웹 UI · API · 카메라 미리보기 (:8080) | —
plantsnap.timer | 05:50 · 15:00 에 plantsnap.service 를 부름 | Persistent=true · AccuracySec=1s — 시스템 시간대 기준
plantsnap.service | plantsvc capture --phase auto — 촬영 → 측정 → 발행 (조명은 환경노드가 시간 창으로) | —
plantsnap-catchup.service | 부팅 때 capture --if-missing | 워밍업 중 정전으로 놓친 그날 phase 만 보충 (패널 19)
plantdash · plantcam | Streamlit · 구 미리보기 서버 | 설치는 되지만 disabled — 롤백용 (패널 20)

서비스는 .venv/bin/plantsvc 를 직접 실행합니다. uv run 은 설치 도구이지 런타임이 아닙니다 — 05:50 에 네트워크로 의존성을 확인하러 나가면 안 되기 때문입니다.

렌더 결과 예 — plantsnap.service (계정 pi · ~/plant · LED 미설치)

# /etc/systemd/system/plantsnap.service  ← deploy/systemd/plantsnap.service.tmpl 에서 렌더됨. 손으로 고치지 마세요
[Unit]
Description=Plant capture - LED warm-up (when installed), shoot, measure, publish (dawn/pm)
After=network-online.target time-sync.target plantsvc.service
Wants=network-online.target

[Service]
Type=oneshot
User=pi
SupplementaryGroups=video gpio
WorkingDirectory=/home/pi/plant
Environment=PLANT_DATA_DIR=/home/pi/plant/data
Environment=PLANT_PORT=8080
Environment=PYTHONUNBUFFERED=1
Environment=GPIOZERO_PIN_FACTORY=lgpio
ExecStart=/home/pi/plant/.venv/bin/plantsvc capture --phase auto
TimeoutStartSec=900

확인 · 로그 보기

systemctl status planthub plantsvc --no-pager       # 둘 다 active (running)
systemctl list-timers plantsnap.timer               # NEXT 가 오늘 15:00 또는 내일 05:50
journalctl -u planthub -f                           # 실시간 로그 (Ctrl+C로 나감)
journalctl -u plantsvc -n 50 --no-pager
journalctl -u plantsnap --since today

# 코드를 고친 뒤 (PC 에서는 .\scripts\deploy.ps1 이 이 전부를 대신합니다)
cd ~/plant && git pull && scripts/install.sh --update

⚠️ 그래도 확인할 두 가지 ① 시간대 — 타이머는 시스템 시간대로 울립니다. timedatectl 이 config.json 의 tz(Asia/Seoul)와 다르면 05:50 이 엉뚱한 시각이 됩니다. install.sh --set-timezone 이 맞춰 주고, doctor 가 WARN 으로 알립니다.
② 그룹 — 서비스는 SupplementaryGroups=video gpio 로 돌지만, SSH 셸에서 직접 plantsvc capture 를 돌리려면 내 계정이 video·gpio 그룹이어야 합니다. install.sh 가 넣어 주되 다시 로그인해야 적용됩니다.

예전 방식 — 유닛 파일을 heredoc 으로 손으로 만들기레거시 — 1 릴리스 동안만 유지

이제는 쓰지 않습니다scripts/install.sh가 같은 유닛을 템플릿에서 렌더해 설치합니다(위). 아래는 2026-07 판의 내용으로, 이미 이렇게 설치한 분이 자기 시스템을 알아보기 위해서만 남겨 둡니다. User=·경로가 박혀 있고 uv run을 런타임에 쓰는 것이 단점이었습니다.

① run_collector.py — 데이터 수집 (필수)

sudo tee /etc/systemd/system/planthub.service > /dev/null << 'EOF'
[Unit]
Description=Plant hub - MQTT to SQLite
After=network-online.target mosquitto.service
Wants=network-online.target
Requires=mosquitto.service

[Service]
Type=simple
User=xparapx
WorkingDirectory=/home/xparapx/plant
ExecStart=/home/xparapx/.local/bin/uv run python run_collector.py
Restart=always
RestartSec=5

[Install]
WantedBy=multi-user.target
EOF

sudo systemctl daemon-reload
sudo systemctl enable --now planthub

② dashboard — 원격 열람 (선택)

sudo tee /etc/systemd/system/plantdash.service > /dev/null << 'EOF'
[Unit]
Description=Plant dashboard - Streamlit
After=network-online.target planthub.service
Wants=network-online.target

[Service]
Type=simple
User=xparapx
WorkingDirectory=/home/xparapx/plant
ExecStart=/home/xparapx/.local/bin/uv run streamlit run dashboard.py \
          --server.address 0.0.0.0 --server.port 8501 --server.headless true
Restart=always
RestartSec=10

[Install]
WantedBy=multi-user.target
EOF

sudo systemctl daemon-reload
sudo systemctl enable --now plantdash

확인 · 로그 보기

systemctl status planthub plantdash     # active (running) 확인 → q
journalctl -u planthub -f               # 실시간 로그 (Ctrl+C로 나감)
journalctl -u planthub --since today    # 오늘 로그만

# 코드를 고친 뒤
sudo systemctl restart planthub

⚠️ 세 곳을 자기 환경에 맞추세요 ① User= — 실제 계정명. whoami로 확인
② WorkingDirectory= — plant 폴더의 절대경로. pwd로 확인
③ ExecStart=의 uv 경로 — which uv로 확인. systemd는 PATH를 물려받지 않으므로 반드시 절대경로여야 합니다. 이게 1순위 실패 원인입니다.

★ 진짜 검증 — 재부팅해 보세요 sudo reboot 후 SSH 없이 몇 분 기다렸다가 다시 접속해 systemctl status planthub가 active이고 DB에 새 행이 쌓였는지 확인하세요.
이게 통과해야 "전원만 꽂으면 된다"가 사실이 됩니다. 등록만 하고 재부팅 검증을 안 하면 정전 뒤에 조용히 죽어 있을 수 있습니다.

이전 이름으로 이미 만들어 두었다면 — 개명 이관 레거시 — 1 릴리스 동안만 유지 2026-09 판에서는 이 절차가 필요 없습니다 — scripts/migrate_legacy.sh(위 1절)가 데이터만 옮기고 install.sh가 유닛을 새로 씁니다. 아래는 2026-07 판 이관 절차의 기록입니다.
이 개정판에서 파일 이름을 실행 주체가 드러나게 바꿨습니다(패널 i의 스크립트 지도). 이미 hub.py로 서비스를 돌리고 있다면 파일과 서비스 정의를 함께 고쳐야 합니다.

cd ~/plant
mv hub.py     run_collector.py
mv capture.py run_capture.py
mv leafcv.py  leaf_measure.py    # 있을 때만
sed -i 's/import leafcv/import leaf_measure/; s/leafcv\./leaf_measure./g' run_capture.py

sudo sed -i 's|python hub.py|python run_collector.py|'   /etc/systemd/system/planthub.service
sudo sed -i 's|python capture.py|python run_capture.py|' /etc/systemd/system/plantsnap.service
sudo systemctl daemon-reload
sudo systemctl restart planthub
systemctl status planthub --no-pager      # active (running) 확인

파일만 바꾸고 서비스 정의를 안 고치면 지금 도는 프로세스는 멀쩡한데 재부팅 후에 조용히 죽습니다. 반드시 restart → status까지 확인하세요.

### 5) 원격 열람 — Tailscale

서비스가 24시간 도는 것과 밖에서 닿는 것은 다른 층입니다. systemd가 대시보드를 켜두고, Tailscale이 길을 뚫습니다. 둘 다 필요합니다.

집 안(같은 WiFi)에서는 Tailscale이 필요 없습니다 plantsvc serve --host 0.0.0.0으로 떠 있으므로 같은 공유기 안에서는 바로 열립니다.
http://raspi.local:8080 또는 http://<hostname -I 의 IP>:8080
⚠ .local(mDNS)은 안드로이드에서 자주 실패합니다 — 폰은 IP로 접속하세요.

Pi — Tailscale 설치 · 로그인

curl -fsSL https://tailscale.com/install.sh | sh
sudo tailscale up            # 출력된 URL을 브라우저에서 열어 계정 로그인

tailscale ip -4              # 100.x.y.z  <- 이 주소로 어디서든 접속
tailscale status             # 연결된 기기 목록

노트북·폰에도 Tailscale을 깔고 같은 계정으로 로그인하면 http://100.x.y.z:8080이 어디서든 열립니다. 폰에서는 브라우저 메뉴의 홈 화면에 추가로 PWA 설치가 됩니다(패널 18). 공유기 포트포워딩도, 공인 IP도, DDNS도 필요 없습니다.

주소를 외우기 싫으면 — MagicDNS Tailscale 관리페이지에서 MagicDNS를 켜면 http://raspi:8080로도 됩니다. 기기 이름이 그대로 주소가 됩니다.

⚠ 원격 열람과 급수를 절대 엮지 마세요 Tailscale이 죽어도 run_collector.py와 급수는 계속 돌아야 합니다. 원격 열람은 편의지 실험의 일부가 아닙니다.

노드의 BROKER를 Tailscale 주소(100.x)로 적지 마세요. 그 순간 원격 장애가 급수 장애가 됩니다.
노드 → 브로커는 로컬 IP(192.168.x, 인터넷 없어도 동작), 집 → 대시보드는 Tailscale(100.x, 끊겨도 데이터는 계속 쌓임) — 두 경로를 독립으로 두세요.

⚠ 나중에 Pi를 핫스팟(AP)으로 쓰면 인터넷 경로가 사라집니다 학교망의 클라이언트 격리를 피하려고 Pi가 자기 WiFi를 띄우면, 내장 WiFi가 AP에 묶여 인터넷이 없어집니다. 그러면 Tailscale도 못 나갑니다.
해법: 인터넷 경로를 따로 넣으세요 — USB WiFi 동글(학교망·폰 핫스팟 접속용) 또는 랜선. 내장 WiFi는 노드용 AP, 동글은 인터넷용으로 나누면 둘 다 됩니다. 집 테스트 단계에서는 해당 없습니다.

tailscale funnel — 실험 데이터에는 쓰지 마세요 sudo tailscale funnel 8080은 공개 URL을 만들어 Tailscale 없는 기기에서도 열리게 합니다. 편하지만 인증 없이 노출됩니다.

Restart=always의 의미 run_collector.py(planthub)·plantsvc 가 예외로 죽어도 5초 뒤 자동 재시작합니다. 브로커가 잠깐 끊겨 run_collector.py가 종료돼도 스스로 복구합니다. 다만 재시작이 반복되면 로그에 흔적이 남으니 journalctl을 주 1회 확인하세요 — 조용한 실패가 가장 위험합니다.

◀ 이전다음 ▶

## 9원격 GUI — noVNC

모니터 없는 Pi에 브라우저만으로 데스크톱을 띄웁니다. 찍힌 사진을 그 자리에서 확인하는 작업이 이후 계속 나오기 때문에, 여기서 한 번 세워두면 패널 10·11이 훨씬 수월해집니다.

먼저 — 이게 꼭 필요한가? 필수는 아닙니다. run_collector.py · 대시보드 · 자동 촬영은 전부 SSH만으로 돕니다.
그래도 권하는 이유는 사진을 눈으로 봐야 하는 작업이 반복되기 때문입니다 — calib.jpg의 초점, roi_offset.jpg의 박스 위치, 마스크가 흙을 잎으로 잡았는지. SSH만 쓰면 그때마다 PC로 내려받아야 합니다.
SSH를 대체하는 것이 아닙니다. VNC가 죽으면 SSH로 들어가 고쳐야 합니다 — SSH는 비상구, noVNC는 정문입니다. 비상구를 없애지 마세요.

2026-09 — 카메라 세팅에는 이제 데스크톱이 필요 없습니다 노출·배율·ROI·처리군·기준 사진(패널 10)은 전부 웹 UI http://<pi>:8080/camera/setup에서 실시간 미리보기 위에서 합니다. 찍힌 사진·마스크·윤곽 오버레이도 /camera·/growth 페이지에서 바로 보입니다. 그래서 이 패널은 선택 사항이 되었습니다 — 파일을 GUI로 뒤져야 하거나 rpicam-hello 화면을 급히 봐야 할 때만 세우세요. 나머지 내용은 그대로 유효합니다.

### 1) VNC는 두 종류입니다 — 헤드리스에서 성패가 갈리는 지점

모니터를 안 꽂은 Pi에서 아무 VNC나 쓰면 회색 화면만 뜨거나 아예 안 켜집니다. 이유는 동작 원리가 다르기 때문입니다.

| 캡처형 | 가상 디스플레이형 ← 이걸 씁니다
대표 | wayvnc (Raspberry Pi Connect) | Xtigervnc (TigerVNC)
원리 | 이미 떠 있는 화면을 복사해 전송 | 화면을 스스로 만들어냄
모니터 없으면 | 복사할 원본이 없어 실패 | 문제없음
필요 조건 | 자동 로그인 + HDMI 강제 옵션 | 없음

### 2) 등장인물 셋 — 고장 났을 때 어디를 볼지 알려면

① Xtigervnc

가상 화면 생성
포트 5901 (내부 전용)

→

VNC

② websockify

VNC ↔ WebSocket 변환
포트 6080

→

HTTP

③ noVNC

브라우저 안에서
화면을 그림

noVNC는 서버가 아닙니다 브라우저에서 도는 자바스크립트일 뿐입니다. 실제 화면을 만드는 건 Xtigervnc, 둘을 잇는 건 websockify입니다. 그래서 “noVNC 설치”란 정확히는 TigerVNC + websockify + noVNC 세트 설치를 뜻합니다.
포트가 둘인 이유 — 5901은 Pi 자신만 접근 가능(-localhost yes), 외부는 오직 6080으로만 들어옵니다. 보안이 이중으로 걸린 구조입니다.

### 3) 설치

Pi — 한 덩어리씩 따로 붙여넣기

sudo apt update
sudo apt install -y tigervnc-standalone-server novnc websockify

데스크톱 환경이 있는지 확인합니다. 없으면(Trixie는 없을 수 있음) 경량 데스크톱을 깝니다.

ls /usr/bin/startlxde-pi        # 있으면 다음 단계로
sudo apt install -y openbox lxpanel pcmanfm

⚠ Trixie — 이 한 줄을 빠뜨리면 데스크톱이 통째로 사라집니다 위 설치 과정에서 rpd-common 등이 제거되면서 labwc가 “불필요”로 표시됩니다. 나중에 apt autoremove를 실행하는 순간 데스크톱 환경 전체가 삭제됩니다.

sudo apt-mark manual labwc xwayland lxsession lxpanel-pi pcmanfm openbox xinit pi-greeter

apt-mark manual = “내가 직접 깐 것이니 자동으로 지우지 마라”는 표시입니다.

### 4) 접속 암호

tigervncpasswd

프롬프트 | 입력
Password: | 원하는 암호 (6~8자. 화면에 안 보이는 게 정상)
Verify: | 같은 암호
view-only password (y/n)? | n

⚠ 두 가지 함정 8자 초과는 잘립니다 — VNC 프로토콜 규격입니다. 9자로 만들면 나중에 “암호가 안 맞는” 이유를 못 찾습니다.
y를 누르면 보기 전용 암호가 추가됩니다. 그걸로 접속하면 화면은 보이는데 마우스·키보드가 안 먹혀 한참 헤매게 됩니다.
왜 vncpasswd가 아니라 tigervncpasswd인가 — Pi OS에는 RealVNC가 미리 깔려 있어 vncpasswd·vncserver 이름을 이미 차지하고 있습니다. 그냥 치면 엉뚱한 프로그램이 실행됩니다.

### 5) xstartup — 화면이 생긴 직후 무엇을 띄울지

~/.vnc/xstartup

mkdir -p ~/.vnc
cat > ~/.vnc/xstartup <<'EOF'
#!/bin/sh
unset SESSION_MANAGER DBUS_SESSION_BUS_ADDRESS
if [ -x /usr/bin/startlxde-pi ]; then
  exec /usr/bin/startlxde-pi
else
  lxpanel & pcmanfm --desktop & exec openbox
fi
EOF
chmod +x ~/.vnc/xstartup

코드 | 의미
unset SESSION_MANAGER … | 기존 세션 정보를 지움. 안 지우면 새 세션이 충돌
[ -x … ] | 그 파일이 실행 가능한 상태로 있는지 확인
exec | 현재 프로세스를 이걸로 교체
& | 백그라운드 실행. 마지막 openbox만 & 없이 — 이게 끝나면 세션도 끝나야 하므로
chmod +x | 실행 권한. 없으면 회색 화면만 뜹니다

### 6) 손으로 먼저 켜보기

자동화 전에 수동으로 확인합니다. 이 순서를 지켜야 문제가 생겼을 때 원인 범위가 좁아집니다.

tigervncserver :1 -geometry 1600x900 -depth 24 -localhost yes
ss -ltnp | grep 5901

LISTEN … 127.0.0.1:5901이 보이면 성공입니다. 127.0.0.1은 “자기 자신”이라는 뜻으로, 외부 차단이 걸렸다는 증거입니다.

다른 터미널에서 변환기를 붙입니다.

websockify --web=/usr/share/novnc 6080 localhost:5901

브라우저에서 http://rasp:6080/vnc.html → Connect → 암호 → 데스크톱이 뜨면 통과입니다.

로그의 GLib-GIO-CRITICAL · Gtk-CRITICAL은 무해합니다 아이콘 관련 잔소리일 뿐입니다. 화면이 안 뜰 때만 tail -20 ~/.vnc/*:1.log를 보세요.

### 7) systemd 등록 — 재부팅해도 살아 있게

여기까지는 SSH 터미널을 닫으면 다 꺼집니다. 패널 8의 planthub와 같은 방식으로 등록합니다.

① tigervnc@.service — 가상 화면

sudo tee /etc/systemd/system/tigervnc@.service >/dev/null <<'EOF'
[Unit]
Description=TigerVNC on :%i
After=network.target

[Service]
Type=forking
User=xparapx
Environment=HOME=/home/xparapx
ExecStartPre=-/usr/bin/tigervncserver -kill :%i
ExecStart=/usr/bin/tigervncserver :%i -geometry 1600x900 -depth 24 -localhost yes
ExecStop=/usr/bin/tigervncserver -kill :%i
Restart=on-failure

[Install]
WantedBy=multi-user.target
EOF

② novnc.service — 변환기

sudo tee /etc/systemd/system/novnc.service >/dev/null <<'EOF'
[Unit]
Description=noVNC websockify
Requires=tigervnc@1.service
After=tigervnc@1.service

[Service]
ExecStart=/usr/bin/websockify --web=/usr/share/novnc 6080 localhost:5901
Restart=on-failure

[Install]
WantedBy=multi-user.target
EOF

적용

tigervncserver -kill :1 2>/dev/null      # 수동으로 띄운 것 정리
pkill websockify

sudo systemctl daemon-reload
sudo systemctl enable --now tigervnc@1 novnc
ss -ltnp | grep -E '5901|6080'           # 둘 다 LISTEN 이면 완료

⚠ 세 곳을 자기 환경에 맞추세요 — 패널 8과 같은 함정 ① User= — 실제 계정명(whoami) ② Environment=HOME= — 없으면 ~/.vnc/xstartup을 못 찾습니다 ③ 파일명의 @는 템플릿 — tigervnc@1로 부르면 %i에 1이 들어갑니다.
ExecStartPre 앞의 -는 “실패해도 무시” — 이미 꺼져 있으면 kill이 실패하는데 그건 정상이므로.

★ 진짜 검증 — SSH를 완전히 끊고 재부팅 sudo reboot 후 브라우저에서 재접속해 보세요. 살아 있어야 합니다.
stop은 지금 끄는 것, disable은 부팅 자동 시작 해제 — 둘은 다릅니다.

### 8) 밖에서 접속 — Tailscale

noVNC 자체는 같은 네트워크 안에서만 동작합니다. 학교에서 집 Pi에 붙는 건 Tailscale이 길을 뚫어주기 때문이지 noVNC 기능이 아닙니다. 설치는 패널 8 §5에서 이미 했습니다.

상황 | 주소
같은 WiFi | http://rasp:6080/vnc.html
밖에서 | http://100.x.y.z:6080/vnc.html (tailscale ip -4)

⚠ 보안 — 이 구성은 암호화되지 않습니다 http://이므로 화면도 키보드 입력도 평문입니다. 안전한 이유는 오직 Tailscale이 터널 전체를 암호화하기 때문입니다. 따라서:
✗ -localhost yes 제거 ✗ 공유기에서 6080 포트포워딩 ✗ 짧고 뻔한 암호
VNC는 자동 공격 대상 1순위입니다. 접속은 반드시 Tailscale 경유로만.
학교 공용 PC에서 쓴 뒤에는 탭을 닫으세요 — 세션이 유지됩니다.

### 9) ★ 카메라 — 한 번에 한 프로세스만

⚠ 이 프로젝트에서 가장 자주 터지는 충돌입니다 카메라는 배타적 자원입니다. 미리보기가 떠 있으면 촬영이 실패하고, 반대도 마찬가지입니다.

RuntimeError: Failed to acquire camera: Device or resource busy

VNC 화면을 닫아도 그 안에서 돌던 프로그램은 계속 삽니다. 브라우저 탭을 닫는 것과 프로그램을 끄는 것은 전혀 다릅니다 — 이걸 착각하면 “아무것도 안 켰는데 왜 실패하지”에서 막힙니다.

누가 잡고 있는지 확인

plantsvc doctor                  # camera lock 행: free / held by pid N
pgrep -af 'plantsvc|rpicam|libcamera'
sudo fuser -v /dev/media0        # plantsvc 서비스 하나만 나와야 정상 (미리보기 중이면)

2026-09 — 충돌은 서비스가 스스로 조정합니다 카메라를 쥐는 프로세스는 plantsvc 하나입니다. 미리보기는 보는 사람이 있을 때만 열리고 마지막 사람이 나가면 30초 뒤 닫힙니다. 촬영 시각(05:50·15:00) 1분 전부터는 미리보기가 paused_capture로 멈추고, plantsvc capture가 서비스에 놓아 달라고 요청(POST /api/camera/release)한 뒤 data/camera.lock 파일 잠금을 잡고 찍습니다. 끝나면 대기 중인 미리보기가 다시 열립니다.
아래의 plantcam.service + 드롭인 방식은 이 조정을 흉내 내던 예전 방법입니다 — install.sh가 camera-lock.conf 드롭인을 제거(백업)하고 plantcam 을 비활성화합니다.

미리보기는 웹 UI(plantsvc) 하나로 통일하세요 — 별도 스트리밍 서버를 만들지 마세요 인터넷 예제의 mjpeg.py 류는 오토포커스가 켜진 채 돕니다. 그 화면으로 초점을 맞춰봐야 plantsvc capture는 고정 초점으로 찍으므로 본 것과 찍히는 것이 다릅니다.
패널 10의 /camera/setup 미리보기는 촬영과 똑같은 수동 설정(같은 still 설정의 lores 출력)으로 보여주고, ROI 박스와 밀림 판정까지 얹어 줍니다. 스트리밍이 필요하면 /api/camera/stream.mjpg 를 쓰세요. (2026-07 판의 setup_camera.py가 하던 역할입니다.)

VNC 안에서 화각만 급히 볼 때는 이 명령이 유일하게 동작합니다.

rpicam-hello --qt-preview -t 0

--qt-preview가 필수입니다. 기본 미리보기는 하드웨어 가속(DRM/EGL) 기반이라 가상 디스플레이에서 실패합니다. Qt 미리보기는 소프트웨어 렌더링이라 VNC로도 표시됩니다. 확인이 끝나면 Ctrl+C — 켜둔 채 두면 자동 촬영이 실패합니다.

예전 방식 — plantcam.service + camera-lock.conf 드롭인레거시 — 1 릴리스 동안만 유지

스트리밍을 상시로 띄우고 싶다면 — systemd가 충돌을 조정하게 기본 권장은 “상시 스트리밍 안 함”입니다. 그래도 둘 다 유지하고 싶다면 촬영 직전에만 자동으로 내렸다 올리도록 systemd에 맡길 수 있습니다.

sudo tee /etc/systemd/system/plantcam.service >/dev/null <<'EOF'
[Unit]
Description=Plant camera preview (MJPEG :8000)
After=network.target

[Service]
User=xparapx
WorkingDirectory=/home/xparapx/plant
ExecStart=/home/xparapx/.local/bin/uv run python setup_camera.py
Restart=on-failure

[Install]
WantedBy=multi-user.target
EOF

Restart=always가 아니라 on-failure여야 합니다 — systemd가 일부러 내린 것을 “고장”으로 오해해 되살리면 이 방식 자체가 성립하지 않습니다.
그다음 패널 11의 plantsnap.service에 드롭인을 얹습니다.

sudo mkdir -p /etc/systemd/system/plantsnap.service.d
sudo tee /etc/systemd/system/plantsnap.service.d/camera-lock.conf >/dev/null <<'EOF'
[Unit]
Conflicts=plantcam.service
After=plantcam.service

[Service]
ExecStartPre=/bin/sleep 3
TimeoutStartSec=180
ExecStopPost=+/usr/bin/systemctl --no-block start plantcam.service
EOF
sudo systemctl daemon-reload

Conflicts와 After는 짝으로 — Conflicts만 있으면 순서 보장이 없어 카메라를 놓기 전에 촬영이 시작될 수 있습니다.
sleep 3 — 프로세스가 죽는 것과 커널이 장치를 놓는 것 사이에 틈이 있습니다.
+ — User=를 무시하고 root로 실행. 없으면 스트림이 안 돌아옵니다.
--no-block — 없으면 systemd가 자기 자신을 기다리며 교착합니다.
TimeoutStartSec — 촬영이 멈춰도 3분 뒤 정리되고 스트림이 복구됩니다.

이렇게 걸면 run_capture.py를 직접 실행하면 안 됩니다 — sudo systemctl start plantsnap.service로 돌려야 이 조정을 탑니다.

### 10) 문제 해결

증상 | 원인 | 조치
브라우저에서 “연결할 수 없음” | 서비스가 꺼짐 | SSH → systemctl status novnc
회색 화면, 아이콘 없음 | xstartup 실패 | tail ~/.vnc/*:1.log
화면은 보이는데 마우스가 안 먹힘 | view-only 암호로 접속 | 제어용 암호로 재접속
밖에서 접속 안 됨 | Tailscale 미연결 | 양쪽에서 tailscale status
암호가 안 맞음 | 8자 초과로 잘림 | tigervncpasswd로 재설정
vncserver가 이상한 안내만 출력 | RealVNC가 실행됨 | tigervncserver로 명시
재부팅 후 안 켜짐 | enable 안 함 | sudo systemctl enable tigervnc@1 novnc
화면이 심하게 느림 | 해상도·색심도 과다 | -geometry 1280x720 -depth 16
카메라 busy | 다른 프로세스가 data/camera.lock 을 쥐고 있음 | plantsvc doctor · pgrep -af plantsvc → 패널 ! 참조

⚠ apt autoremove를 실행하지 마세요 §3의 apt-mark manual을 빠뜨린 상태라면 데스크톱이 삭제됩니다. 완전히 처음부터 다시 하려면:

sudo systemctl disable --now tigervnc@1 novnc
sudo rm /etc/systemd/system/tigervnc@.service /etc/systemd/system/novnc.service
sudo systemctl daemon-reload
rm -rf ~/.vnc ~/.config/tigervnc

이 패널 통과 조건

- ss -ltnp | grep -E '5901|6080' — 둘 다 LISTEN
- 5901이 127.0.0.1에만 묶여 있음 (외부 차단 확인)
- 재부팅 후 SSH 없이 브라우저로 접속됨
- Tailscale 주소로도 접속됨
- sudo fuser -v /dev/media0이 비어 있음 — 카메라를 아무도 안 잡고 있음

◀ 이전다음 ▶

## 10카메라 설치 — 준비 · 화각 · ROI

위에서 본 잎의 투영 면적을 픽셀로 세어 cm²로 환산합니다. 데모 단계에선 프레임 없이 책상 위에서 환산 정확도만 확인하고, 6칸 위치 무관성은 프레임이 선 뒤에 봅니다.

용어 — 캐노피 투영면적 ≠ 잎 면적 위에서 내려다본 그림자 넓이를 재는 것이라, 잎이 겹치면 한 번만 셉니다. 따라서 실제 잎 면적보다 항상 작게 나오고, 자랄수록 더 작게 나옵니다.
생장률(RGR) 비교에는 충분하지만, 보고서에는 반드시 "투영 캐노피 면적"으로 쓰고 6주차에 파괴 측정(실제 잎면적·건중량·뿌리)으로 검증하세요.

이 패널의 순서 — 파일을 먼저, 계산은 그다음 스크립트가 config.json을 읽어서 계산하므로, 파일이 먼저 있어야 합니다.

① config.json

배치를 적는다
사람

→

② 거치대

만들고 고정
사람

→

③ /camera/setup

노출·배율·ROI
브라우저 (:8080)

→

④ config.json

완성
자동 기록

### 1) config.json 만들기 — 가장 먼저

이 파일 하나에 모든 값이 들어갑니다. 스크립트 안에는 숫자가 없습니다. 아래를 그대로 만들고, 표시된 두 곳만 자기 환경 값으로 고치세요.

config.json · 모든 스크립트가 여기를 읽습니다 · 값을 고칠 곳은 여기 하나뿐

{
  "marker_mm": 50.0,

  "layout": { "cols": 3, "rows": 2, "pot_cm": 15, "gap_cm": 20 },

  "capture": {
    "size": [4608, 2592],
    "lens_position": 1.82,
    "exposure_us": 20000,
    "gain": 2.0,
    "colour_gains": [1.8, 1.6]
  },

  "ref_marker": [],
  "rois": [],
  "qc": { "px_per_cm_ref": 0.0, "px_per_cm_tol": 0.03 }
}

누가 어느 값을 채우는가 — 이 구분을 놓치면 도구가 덮어쓸 값을 손으로 적게 됩니다.

키 | 누가 | 언제 · 어떻게
layout 전체 | 사람 — 지금 | ★ 여기부터. 화분을 실제로 놓고 재서 적습니다
marker_mm | 사람 | 일단 50으로 두고, 인쇄 후 자로 재서 실측값으로 고칩니다
capture.size | 그대로 | 4608×2592 = IMX708 최대. 떡잎 경계 오차가 4%→2%로 줄어듭니다
capture.lens_position | 사람 | [자동 측정 → 고정]이 실측해 넣습니다 — 손으로 적지 마세요
exposure_us · gain · colour_gains | 사람 | §3 화면에서 보고 조정. 정한 뒤 6주간 불변
rois | 도구가 자동 | 웹 UI /camera/setup의 [잎 찾아 배치] 또는 [격자로 나누기]. 손으로 적지 마세요
ref_marker · qc.px_per_cm_ref | 도구가 자동 | [저장]이 기록합니다. 빈 배열 []로 두고 시작

⚠ JSON에는 주석을 쓸 수 없습니다 //나 #을 넣으면 json.load가 Expecting property name으로 실패합니다. 설명은 아래 표로 보고, 파일에는 값만 넣으세요.

layout의 각 값이 뜻하는 것:

키 | 뜻 | 재는 법
cols · rows | 화분 배열 (열 × 행) | —
pot_cm | 화분 지름 | 위에서 본 화분 하나의 폭
gap_cm | 화분 사이의 틈 | 중심 간격이 아닙니다. 중심간격 35cm · 지름 15cm면 20

gap_cm은 실험 결과를 바꿉니다 상추는 6주차에 잎을 20~25cm까지 벌립니다. 틈이 좁으면 옆 화분 잎이 ROI 안으로 들어와 ExG가 두 개체를 한 덩어리로 잡고, 면적이 부풀려집니다. 데모(작은 화분·짧은 기간)에서는 좁아도 되지만, 본실험에서는 20cm 이상을 권합니다.

★ ROI는 고정 픽셀 사각형입니다 — 카메라가 밀리면 전부 어긋납니다 카메라 한 대로 화분 6개를 찍고, config.json의 사각형으로 잘라서 각각 잽니다. 문제는 6주 사이 카메라가 몇 mm만 움직여도 사각형이 옆 화분을 자른다는 것입니다. 그런데 배율(px/cm)은 멀쩡해서 아무도 눈치채지 못합니다.

그래서 ArUco를 배율뿐 아니라 위치에도 씁니다. 기준 프레임 대비 변환을 구해 ROI를 함께 이동시킵니다. 가상 장면으로 검증한 결과:

카메라 이동 | 보정 없음 | ROI 정렬 | 정렬 + px/cm
5mm 밀림 | −3.8% | +0.0% | —
2° 회전 | −3.4% | −0.1% | —
밀림 + 회전 | −4.4% | −0.2% | −0.3%
높이 3% 변화 | +2.2% | +6.7% | +0.7%
전부 복합 | — | — | +0.3%

이동·회전은 ROI 정렬이, 높이 변화는 px/cm이 잡습니다 — 둘은 보완적입니다. 함께 쓰면 어느 경우도 오차 1% 미만입니다.

품질 판정 — 테두리에 닿으면 실격 캐노피가 ROI 테두리에 닿으면 잎이 잘렸거나 옆 화분이 침범한 것입니다. 그 값은 ok=0으로 기록되어 대시보드·RGR 계산에서 제외됩니다. 6주차에 자주 뜨면 ROI를 넓히거나 화분 간격을 벌려야 합니다.

거치대 높이는 어림값으로 잡고, 조절되게 만드세요 화각 66° 기준 필요한 높이 ≈ 덮어야 할 폭 × 0.77. 2열 배치로 45cm를 덮으려면 35cm쯤입니다. 센서가 16:9라 1행 배치에서는 세로가 병목이니 여기에 1.5배쯤 여유를 두세요.

정확한 높이를 미리 계산할 필요는 없습니다 — 화면을 보며 맞추면 그게 정답이고, lens_position과 배율도 다음 단계에서 실측으로 덮어써집니다. 거치대는 계산보다 위아래로 조절되게 만드는 것이 중요합니다.

ArUco 마커를 쓰지 않는 이유 마커는 두 가지 일을 했습니다 — 배율과 위치 감시.
배율은 화면에서 두 점을 클릭해 한 번 정하면 되고, 위치 감시는 frame_align.py가 기준 사진과 비교해 대신합니다(패널 11). 인쇄·코팅·부착·6주 관리가 사라지는 대신, 카메라를 단단히 고정하는 것이 전제가 됩니다.

### 2) 카메라 세팅 — 웹 UI /camera/setup 한 화면으로 끝

화각 조정 · 배율 측정 · ROI 잡기 · 처리군 배정 · 기준 사진을 브라우저 한 화면에서 합니다. 폰으로 열면 카메라 옆에 서서 밀면서 볼 수 있습니다.

열기 — 따로 띄울 것이 없습니다

http://<pi>:8080/camera/setup        # plantsvc.service 가 이미 떠 있음. 폰은 IP 로 · 밖에서는 Tailscale 주소
plantsvc doctor                         # camera 행이 OK 인지 먼저 (FAIL 이면 케이블 — 패널 8)

2026-09 — 예전 setup_camera.py(:8000) 의 5단계가 그대로 웹 UI 로 옮겨졌습니다

단계 | 버튼 | config.json 에 남는 것
① 노출 · 초점 | [자동 측정 → 고정] — 수렴할 때까지 재고 잠급니다. gain 이 높으면 “조명을 밝게” 경고 | capture.lens_position · exposure_us · gain · colour_gains
② 배율 | 길이(cm) 입력 → [두 점 찍기] → 화면에서 두 점 클릭. 화분 지름 기록은 검산용 | qc.px_per_cm_ref · layout.pot_cm
③ ROI | [잎 찾아 배치] / [격자로 나누기](열·행) / [이름 다시 매기기](박스를 순서대로 클릭) / [ROI 재중심](5절) | rois[] — 크기는 한 변으로 고정
④ 처리군 | [무작위 배정] 또는 박스마다 꾸준 / 널뜀 직접 지정. 어느 쪽이었는지 treat_mode 로 남아 보고서에 “무작위 배정”이라 쓸 수 있는지 알려 줍니다 | rois[].treat · treat_mode
⑤ 기준 사진 | [촬영 — calib.jpg] — 마지막에 한 번. 다시 누르면 “6주 밀림 판정의 기준이 바뀝니다” 경고 | data/calib.jpg

끝난 단계는 번호가 ✓로 바뀝니다. 다섯 개가 다 초록이면 다음 05:50 부터 자동 촬영이 시작됩니다 — 따로 켤 것이 없습니다.
화면 아래 밀림 판정 칸은 기준 사진이 생긴 뒤부터 현재 프레임과 calib.jpg 의 이동·회전·배율 차이를 보여 줍니다(4절·패널 11 frame_align 과 같은 계산). 상태 JSON 버튼은 지금 화면이 보고 있는 값 그대로를 보여 주므로 “저장됐나?”를 의심할 때 누르세요.

카메라가 없는 PC 에서 미리 손에 익히기 PLANT_FAKE_HW=1 uv run plantsvc serve 로 띄우면 가짜 카메라가 잎 모양 합성 프레임을 줍니다. 5단계를 끝까지 눌러 볼 수 있고 촬영 루틴도 돌지만, 가짜 프레임의 측정값은 절대 발행되지 않습니다(패널 18).

ArUco 가 잡히려면 — 다섯 가지가 동시에 맞아야 합니다

조건 | 왜 | 깨지면
네 꼭짓점이 전부 화면 안 | 사각형 윤곽을 찾는 것이 1단계 | 일부만 가려도 즉시 검출 0
흰 여백이 검은 테두리를 둘러쌈 | 여백이 없으면 어두운 배경과 테두리가 붙어버림 | 사각형 후보 자체가 안 생김
흑백 대비 | 적응형 이진화로 흑백을 가름 | 어둡거나 반사光이 있으면 실패
평평·선명 | 4×4 무늬를 칸별로 읽어야 함 | 구겨짐·초점 흐림 → 후보는 잡히나 판독 실패
같은 사전 (DICT_4X4_50) | 다른 사전 마커는 무늬가 다름 | 영영 안 잡힘

화면의 실패 메시지로 원인이 갈립니다 — 후보 0개면 사각형을 못 찾은 것(대비·흰여백·가림), 후보 N개, 무늬 판독 실패면 사각형은 찾았는데 칸을 못 읽은 것(작음·흐림·기울기). 후보는 회색 선으로 그려집니다.

⚠ 미리보기는 1280px, 실제 촬영은 4608px입니다. 화면에서 안 잡혀도 calib.jpg 원본에서는 잡힐 수 있습니다 — 마커가 작을 때는 원본으로 확인하세요.

화면 구성 — 왼쪽은 조작만, 설명은 영상 아래

단계 | 버튼 | 완료 표시
1 노출·초점 | 자동 측정 → 고정 | 끝난 단계는 번호가 ✓ 로 바뀌고 테두리가 초록이 됩니다. 위에서 아래로 초록이 채워지면 완료입니다
2 배율 | 길이 입력 → 화면에서 두 점 클릭 + 화분 지름(자로 잰 값) 기록 — 배율 검산용
3 ROI | 잎 찾아 배치 / 격자로 나누기
4 처리군 | 무작위 배정
5 기준 사진 | 촬영 — calib.jpg

길이 입력칸 아래에 “두 점 사이를 5 cm 로 계산합니다” 가 실시간으로 표시됩니다 — 클릭 전에 값이 반영됐는지 눈으로 확인하라는 장치입니다. 비워두면 붉은 글씨로 경고합니다.

미리보기와 촬영이 같은 화각입니다 — 화면에서 맞춘 박스가 사진에서도 맞습니다 예전에는 보는 설정과 찍는 설정이 달랐습니다 — 미리보기는 video(1280×720), 촬영은 still(4608×2592). 두 설정은 센서 모드와 ScalerCrop 이 달라 화각이 어긋날 수 있고, 그러면 SCALE = 미리보기폭 / 촬영폭 이라는 단순 비례가 깨집니다. 화면에서 딱 맞게 그린 ROI 가 사진에서는 밀려 있었습니다.

지금은 하나의 still 설정에서 main(촬영)과 lores(미리보기)를 함께 뽑습니다. 둘 다 같은 ISP 출력이라 화각이 같고, 비례만 하면 됩니다. 모드 전환이 사라져 “전환 직후 검은 띠” 문제도 없어졌습니다.

| 얻은 것 | 대가
lores 미리보기 | 화각 일치 · 모드 전환 없음 | 센서를 계속 전체해상도로 돌리므로 미리보기가 수 fps로 느립니다

설치할 때만 쓰는 도구라 느린 것은 감수할 만합니다. 화면과 사진이 어긋나는 편이 훨씬 비쌉니다.

ROI 크기도 고정됩니다 — 이미 놓인 박스들이 모두 같은 정사각형이면 새로 배치할 때 그 한 변을 그대로 씁니다. 화분마다 박스 크기가 다르면 면적을 서로 비교할 수 없기 때문입니다.

예전 도구 — setup_camera.py 전체 소스 (:8000 단독 서버)레거시 — 1 릴리스 동안만 유지

지금은 웹 UI /camera/setup 이 같은 5단계를 합니다같은 버튼·같은 순서·같은 config.json 키를 쓰므로 아래 소스는 동작을 이해하는 참고용입니다. 실행하면 plantsvc 와 카메라를 두고 충돌합니다 — 돌리지 마세요.

setup_camera.py · 손으로, 세팅하는 동안 · 브라우저 :8000 → calib.jpg + config.json

"""
setup_camera.py — 카메라 세팅을 이 파일 하나로 끝낸다.

  uv run python setup_camera.py            ->  http://rsp:8000  (폰으로 봐도 됩니다)

  ① 노출·초점 자동 측정 후 고정   ② 두 점 클릭으로 배율
  ③ 잎을 찾아 ROI 배치           ④ 처리군 무작위 배정
  ⑤ 기준 사진 calib.jpg (마지막에 한 번)

★ ArUco 마커를 쓰지 않습니다.
  배율 — 화면에서 두 점을 클릭해 한 번 정합니다.
  위치 감시 — frame_align.py 가 기준 사진과 비교해 밀림·회전·배율 변화를 잡습니다.
  인쇄·코팅·부착·6주 관리가 사라지는 대신, <카메라를 단단히 고정>하는 것이 전제입니다.

★ 이 스크립트가 카메라를 계속 쥐고 있습니다. 촬영할 때도 놓지 않으므로
  화각을 몇 번을 다시 잡든 'Device or resource busy' 가 나지 않습니다.
  다 끝나면 Ctrl+C — 켜둔 채 두면 run_capture.py 가 실패합니다.
"""
import io, json, os, random, socketserver, threading, time
from http import server

import cv2
import numpy as np
from picamera2 import Picamera2
from libcamera import controls

CFG_PATH = "config.json"
PORT     = 8000
PREV     = (1280, 720)          # 미리보기 해상도 (화면용)

lock   = threading.Lock()       # 카메라는 한 번에 하나만 건드립니다
latest = None                   # 최신 JPEG 프레임
state  = {"msg": "준비됨", "pts": [], "ppc_fixed": None, "cm": 0, "order": None}

def load_cfg():
    with open(CFG_PATH) as f:
        return json.load(f)

def save_cfg(cfg):
    with open(CFG_PATH, "w") as f:
        json.dump(cfg, f, ensure_ascii=False, indent=2)

CFG   = load_cfg()
CAP   = CFG["capture"]
CAP_W, CAP_H = CAP["size"]
SCALE = PREV[0] / CAP_W         # 촬영 좌표 -> 미리보기 좌표

# ══════════════ 카메라 ══════════════
cam = Picamera2()

# ★ 미리보기와 촬영을 <하나의 설정>에서 뽑습니다.
#   예전에는 video_configuration(1280x720) 으로 보고 still_configuration(4608x2592)
#   으로 찍었는데, 두 설정은 센서 모드·ScalerCrop 이 달라 <화각이 어긋날 수 있습니다>.
#   그러면 SCALE = PREV[0]/CAP_W 라는 단순 비례가 깨지고, 화면에서 딱 맞게 그린
#   박스가 사진에서는 밀립니다. 실제로 그 일이 있었습니다.
#   lores 는 main 과 같은 ISP 출력에서 나오므로 화각이 같습니다 — 비례만 하면 됩니다.
#   모드 전환도 사라져서 '전환 직후 검은 띠' 문제도 없어집니다.
#   대가: 센서를 전체해상도로 계속 돌리므로 미리보기가 느립니다(수 fps).
#         설치용 도구라 감수할 만합니다.
try:
    still_cfg = cam.create_still_configuration(
        main={"size": (CAP_W, CAP_H)},
        lores={"size": PREV, "format": "RGB888"},
        buffer_count=2)
    cam.configure(still_cfg)
    PREV_STREAM = "lores"
except Exception as e:                    # 구버전 picamera2 는 lores 가 YUV420 만 됨
    print(f"[INFO] RGB888 lores 실패 ({e}) — YUV420 으로 재시도")
    still_cfg = cam.create_still_configuration(
        main={"size": (CAP_W, CAP_H)},
        lores={"size": PREV, "format": "YUV420"},
        buffer_count=2)
    cam.configure(still_cfg)
    PREV_STREAM = "lores_yuv"
cam.start()
cam.set_controls({                                   # 촬영과 동일한 고정 설정
    "AfMode": controls.AfModeEnum.Manual, "LensPosition": CAP["lens_position"],
    "AeEnable": False, "ExposureTime": CAP["exposure_us"], "AnalogueGain": CAP["gain"],
    "AwbEnable": False, "ColourGains": tuple(CAP["colour_gains"]),
})
time.sleep(2)

def draw(img):
    h, w = img.shape[:2]

    # 프레임 안전선 — 이 안쪽이면 여유 있음
    m = int(min(w, h) * 0.05)
    cv2.rectangle(img, (m, m), (w - m, h - m), (150, 150, 150), 1)

    # ROI 박스 (촬영 좌표 -> 미리보기 좌표)
    for r in CFG.get("rois", []):
        x, y = int(r["x"] * SCALE), int(r["y"] * SCALE)
        ww, hh = int(r["w"] * SCALE), int(r["h"] * SCALE)
        out = x < 0 or y < 0 or x + ww > w or y + hh > h
        col = (0, 0, 255) if out else (255, 170, 0)
        cv2.rectangle(img, (x, y), (x + ww, y + hh), col, 2)
        tag = f'{r["plant_id"]} {r.get("treat") or "?"}'
        cv2.putText(img, tag, (x + 6, y + 24),
                    cv2.FONT_HERSHEY_SIMPLEX, 0.6, col, 2)
        if out:
            cv2.putText(img, "OUT OF FRAME", (x + 6, y + 48),
                        cv2.FONT_HERSHEY_SIMPLEX, 0.55, (0, 0, 255), 2)

    # 배율 측정용 두 점
    for i, (px, py) in enumerate(state["pts"]):
        cv2.circle(img, (int(px), int(py)), 7, (0, 255, 255), -1)
    if len(state["pts"]) == 2:
        a, b = [(int(p[0]), int(p[1])) for p in state["pts"]]
        cv2.line(img, a, b, (0, 255, 255), 2)

    # 하단 상태바
    cv2.rectangle(img, (0, h - 34), (w, h), (0, 0, 0), -1)
    ppc = f'{state["ppc_fixed"]:.1f} px/cm' if state["ppc_fixed"] else 'px/cm --'
    cv2.putText(img, f'{ppc}    ROI {len(CFG.get("rois", []))}',
                (10, h - 11), cv2.FONT_HERSHEY_SIMPLEX, 0.62, (255, 255, 255), 2)
    return img

stop_flag = threading.Event()      # Ctrl+C 때 grab 스레드를 세우는 신호

def preview_frame():
    """미리보기 한 장. lores 는 main 과 화각이 같으므로 SCALE 비례가 성립합니다.
    ★ lock 을 잡은 채로 부를 것 — 카메라는 한 번에 하나만 건드립니다."""
    if PREV_STREAM == "lores":
        return cam.capture_array("lores")
    a = cam.capture_array("lores")                       # YUV420
    return cv2.cvtColor(a, cv2.COLOR_YUV420p2BGR)

def grab():
    global latest
    while not stop_flag.is_set():          # Ctrl+C 가 오면 조용히 빠져나갑니다
        with lock:
            frame = preview_frame()
        frame = draw(frame)
        ok, buf = cv2.imencode(".jpg", frame, [cv2.IMWRITE_JPEG_QUALITY, 80])
        if ok:
            latest = buf.tobytes()
        time.sleep(0.08)

# ══════════════ 동작 ══════════════
def act_point(x, y, cm):
    """화면에서 찍은 두 점 사이 거리로 배율을 구합니다. 마커가 없을 때 쓰는 자(尺).
    화분 지름처럼 <잎과 비슷한 높이>의 길이를 쓰는 것이 원근 오차가 적습니다."""
    pts = state["pts"]
    if len(pts) >= 2:
        pts = []
    pts.append([x, y])
    state["pts"] = pts
    if len(pts) < 2:
        return "첫 점 찍음 — 반대쪽 끝을 한 번 더 클릭하세요"

    d_prev = float(np.hypot(pts[0][0] - pts[1][0], pts[0][1] - pts[1][1]))
    d_cap  = d_prev / SCALE                       # 미리보기 -> 촬영 좌표
    if cm <= 0 or d_cap <= 0:
        return "길이가 0입니다"
    ppc = d_cap / cm
    state["ppc_fixed"] = ppc
    state["cm"] = cm
    CFG.setdefault("qc", {})["px_per_cm_ref"] = round(ppc, 1)
    # 검산 — 프레임 폭이 화분 배치와 말이 되는가.  클릭 실수를 여기서 잡습니다.
    frame_cm = CAP_W / ppc
    lay = CFG.get("layout", {})
    pot = float(lay.get("pot_cm", 0) or 0)
    need = int(lay.get("cols", 1)) * pot + (int(lay.get("cols", 1)) - 1) * float(lay.get("gap_cm", 0) or 0)
    warn = ""
    if pot and frame_cm < need:
        warn = f"   ⚠ 프레임 폭 {frame_cm:.0f}cm 가 배치 {need:.0f}cm 보다 좁습니다 — 다시 재세요"
    elif pot and frame_cm > need * 3:
        warn = f"   ⚠ 프레임 폭 {frame_cm:.0f}cm 는 배치 {need:.0f}cm 의 3배가 넘습니다 — 길이 입력칸을 확인하세요"
    return (f"{d_cap:.0f}px(원본) / {cm:g}cm  ->  {ppc:.1f} px/cm"
            f"  · 프레임 폭 {frame_cm:.0f}cm{warn}")

def act_setpot(cm):
    """화분 지름(cm)을 기록합니다. <자로 잰 값>입니다 — 이미지에서 유도하지 않습니다.

    배율(px/cm)은 두 점 클릭으로 정합니다. pot_cm 은 배율을 재는 값이 아니라,
    <잰 배율이 맞는지 검산하는 잣대>입니다. 그래서 측정과 독립이어야 합니다.
      · leaf_measure : 잎 면적이 화분 넓이의 절반도 안 되면 배율을 의심하라고 경고
      · check_config : ROI 가 화분의 1.5배 이상인지
      · 아래 act_point: 프레임 폭이 배치를 담을 만한지
    이미지에서 유도하면 위 검산에서 ppc 가 약분되어 배율이 틀려도 경고가 안 뜹니다.
    """
    if cm <= 0:
        return "0보다 큰 값을 넣으세요"
    CFG.setdefault("layout", {})["pot_cm"] = cm
    return f"화분 지름 {cm:g} cm 기록 — 배율 검산에 쓰입니다"

def act_shoot():
    """전체 해상도로 1장. 카메라를 놓지 않고 모드만 잠깐 바꿉니다.

    ★ 모드 전환 직후 바로 찍으면 센서가 프레임을 다 읽기 전이라
      사진 위쪽에 검은 띠가 남습니다. 전환 -> 대기 -> 버리는 컷 -> 촬영 순서로 갑니다.
    """
    # 모드 전환이 없어졌습니다 — main 스트림이 이미 전체해상도입니다.
    # 그래서 '전환 직후 검은 띠' 를 피하려던 대기·버리는 컷도 필요 없습니다.
    with lock:
        cam.capture_file("calib.jpg", name="main")
    return f"calib.jpg 저장 ({CAP_W}x{CAP_H})"

def _pack(boxes):
    """좌->우, 위->아래로 정렬해 p1..pN 이름을 붙이고 CFG 에 넣습니다.

    ★ 줄을 <고정 밴드>로 나누면 안 됩니다.
      한 줄로 놓은 화분도 세로로 조금 어긋나면 서로 다른 밴드에 떨어져
      좌우 순서가 뒤집힙니다. 그러면 p1 이 <다른 화분>을 가리키게 되고,
      과거 데이터의 p1 과 지금의 p1 이 달라집니다 — 조용히 실험을 망칩니다.
      그래서 <상자 높이>를 기준으로 같은 줄인지 판단합니다.
    """
    if not boxes:
        CFG["rois"] = []
        return
    hh  = sorted(b[3] for b in boxes)[len(boxes) // 2]     # 상자 높이의 중앙값
    tol = hh * 0.5                                          # 이만큼 안 벌어지면 같은 줄
    rows, cur = [], []
    for b in sorted(boxes, key=lambda b: b[1] + b[3] / 2):  # 중심 y 로 정렬
        if cur and (b[1] + b[3] / 2) - (cur[-1][1] + cur[-1][3] / 2) > tol:
            rows.append(cur); cur = []
        cur.append(b)
    rows.append(cur)
    boxes = [b for r in rows for b in sorted(r, key=lambda b: b[0])]  # 줄 안에서는 좌->우
    CFG["rois"] = [{"plant_id": f"p{i}", "treat": "",
                    "x": int(x), "y": int(y), "w": int(w), "h": int(h)}
                   for i, (x, y, w, h) in enumerate(boxes, 1)]

def _common_side():
    """지금 ROI 들이 <모두 같은 정사각형>이면 그 한 변을 돌려준다. 아니면 None."""
    rois = CFG.get("rois", [])
    if not rois:
        return None
    sides = {(int(r["w"]), int(r["h"])) for r in rois}
    if len(sides) != 1:
        return None
    w, h = sides.pop()
    return w if w == h else None

def _restore_treat(before):
    """자리만 옮긴 것이라면 처리군 배정을 되살린다.

    ★ 되살려도 되는 조건: 개수가 같고, <새 중심이 옛 박스 안>에 있을 것.
      화분이 옆자리로 넘어갔는데 배정을 그대로 두면 p1 이 다른 화분을 가리킨다 —
      데이터로는 구분되지 않고 실험이 조용히 뒤집힌다. 그럴 땐 비운다.
    """
    after = CFG.get("rois", [])
    if len(before) != len(after):
        return False
    for old, new_ in zip(before, after):
        cx, cy = new_["x"] + new_["w"] / 2, new_["y"] + new_["h"] / 2
        if not (old["x"] <= cx <= old["x"] + old["w"] and
                old["y"] <= cy <= old["y"] + old["h"]):
            return False
    for old, new_ in zip(before, after):
        new_["treat"] = old.get("treat", "")
    return True

def act_findleaf(expand=1.8):
    """★ 잎을 찾아 박스의 <중심만> 옮깁니다. 크기는 바꾸지 않습니다.

    예전에는 side = max(잎 가로, 잎 세로) * expand 로 <잎 크기에 비례해> 박스를
    만들었습니다. 그러면 잎이 작은 화분이 영구히 작은 박스를 갖고, 그 화분은
    어느 한 처리군에 속하므로 <잘림이 처리군과 정렬>됩니다. 캐노피가 박스를
    넘으면 작은 쪽이 먼저 잘리고, 잘린 면적과 실제로 작은 면적은 데이터상
    구분되지 않습니다. 그래서 크기는 건드리지 않습니다.

    이미 ROI 가 있으면 그 크기를 그대로 쓰고, 없으면 잎 중 가장 큰 것에 맞춰
    <모두 같은 크기>로 만듭니다.
    """
    with lock:
        frame = preview_frame()
    b, g, r = cv2.split(frame.astype(np.float32))       # BGR 배열
    ssum = b + g + r + 1e-6
    exg = 2 * (g / ssum) - (r / ssum) - (b / ssum)
    x8 = cv2.normalize(exg, None, 0, 255, cv2.NORM_MINMAX).astype(np.uint8)
    x8 = cv2.GaussianBlur(x8, (7, 7), 0)
    _, m = cv2.threshold(x8, 0, 255, cv2.THRESH_BINARY + cv2.THRESH_OTSU)
    k = cv2.getStructuringElement(cv2.MORPH_ELLIPSE, (15, 15))
    m = cv2.morphologyEx(m, cv2.MORPH_CLOSE, k, iterations=2)
    m = cv2.morphologyEx(m, cv2.MORPH_OPEN, k, iterations=1)

    n, lab, st, cen = cv2.connectedComponentsWithStats(m, 8)
    ph, pw = m.shape
    # ★ 크기뿐 아니라 <실제로 초록인지>도 봅니다.
    #   NORM_MINMAX + Otsu 는 무엇이 들어오든 반드시 둘로 가르므로, 잎이 없어도
    #   '가장 초록스러운 쪽'을 만들어냅니다. 어두운 구석의 잡음이 그렇게 잡혔습니다.
    #   중성 회색의 정규화 ExG 는 0, 초록 잎은 0.2~0.4 입니다.
    blobs = [i for i in range(1, n)
             if st[i, cv2.CC_STAT_AREA] > 0.005 * pw * ph
             and float(exg[lab == i].mean()) > 0.06]
    if not blobs:
        return "초록 덩어리를 못 찾았습니다 — 조명·초점을 먼저 맞추세요"

    keep = _common_side()                      # 촬영 좌표계의 한 변
    if keep:
        side = keep * SCALE                    # 미리보기 좌표로
        how = f"기존 크기 {keep}px 유지"
    else:
        side = max(max(st[i, cv2.CC_STAT_WIDTH], st[i, cv2.CC_STAT_HEIGHT])
                   for i in blobs) * expand    # 가장 큰 잎 기준 — 전부 같은 크기
        how = "새 크기(가장 큰 잎 기준) · 전부 동일"

    boxes = [[cen[i][0] - side / 2, cen[i][1] - side / 2, side, side] for i in blobs]

    for _ in range(12):                        # 겹치면 <다같이> 줄입니다 — 크기는 계속 같습니다
        over = any(
            min(a[0]+a[2], c[0]+c[2]) - max(a[0], c[0]) > 0 and
            min(a[1]+a[3], c[1]+c[3]) - max(a[1], c[1]) > 0
            for i, a in enumerate(boxes) for c in boxes[i+1:])
        if not over:
            break
        side *= 0.90
        boxes = [[cen[i][0] - side / 2, cen[i][1] - side / 2, side, side] for i in blobs]
        how += " (겹쳐서 축소)"

    out = []
    for x, y, w, h in boxes:                   # 미리보기 -> 촬영 좌표 + 프레임 안으로
        X, Y, W_, H_ = x / SCALE, y / SCALE, w / SCALE, h / SCALE
        W_ = min(W_, CAP_W); H_ = min(H_, CAP_H)
        X = max(0, min(X, CAP_W - W_)); Y = max(0, min(Y, CAP_H - H_))
        out.append((X, Y, W_, H_))

    before = [dict(r) for r in CFG.get("rois", [])]
    _pack(out)
    kept = _restore_treat(before)

    sides = {r["w"] for r in CFG["rois"]}
    same = "모두 같음" if len(sides) == 1 else f"★ 다름 {sides}"
    tail = "처리군 유지됨" if kept else "처리군이 비었습니다 — 다시 배정하세요"
    return (f"잎 {len(out)}개 — 중심만 이동 · {how} · 크기 {same} · {tail}")

def act_autoroi(cols, rows, margin=0.04):
    """프레임을 cols x rows 격자로 나눕니다(칸 수는 사람이 지정).
    treat 는 비워 둡니다 — 위치와 처리를 묶지 않기 위해."""
    mx, my = int(CAP_W * margin), int(CAP_H * margin)
    cw = (CAP_W - 2 * mx) // cols
    ch = (CAP_H - 2 * my) // rows
    side = int(min(cw, ch) * 0.92)
    rois = []
    n = 1
    for r in range(rows):
        for c in range(cols):
            cx = mx + cw * c + cw // 2
            cy = my + ch * r + ch // 2
            rois.append({"plant_id": f"p{n}", "treat": "",
                         "x": cx - side // 2, "y": cy - side // 2,
                         "w": side, "h": side})
            n += 1
    CFG["rois"] = rois
    return f"{cols}x{rows} 격자 = {len(rois)}칸 — 처리군은 아직 비어 있습니다"

def act_auto():
    """카메라에게 한 번 자동으로 맞춰보게 한 뒤, 그 값을 읽어 <고정>합니다.
    화면이 새까맣거나 하얗게 날아갈 때 이걸 먼저 누르세요."""
    with lock:
        cam.set_controls({"AeEnable": True, "AwbEnable": True,
                          "AfMode": controls.AfModeEnum.Auto})
    time.sleep(3)                                   # 노출·화이트밸런스 수렴 대기
    try:                                            # ★ AfMode 만 켜면 초점은 안 움직입니다.
        with lock:                                  #   스캔을 <직접> 돌려야 합니다.
            cam.autofocus_cycle()
    except Exception:
        pass
    time.sleep(1)
    with lock:
        m = cam.capture_metadata()
        exp  = int(m.get("ExposureTime", CAP["exposure_us"]))
        gain = float(m.get("AnalogueGain", CAP["gain"]))
        cg   = m.get("ColourGains", CAP["colour_gains"])
        lens = float(m.get("LensPosition", CAP["lens_position"]))
        cam.set_controls({                          # 다시 전부 수동으로 잠급니다
            "AeEnable": False, "ExposureTime": exp, "AnalogueGain": gain,
            "AwbEnable": False, "ColourGains": (float(cg[0]), float(cg[1])),
            "AfMode": controls.AfModeEnum.Manual, "LensPosition": lens})
    CAP["exposure_us"]   = exp                      # CAP 은 CFG["capture"] 자체
    CAP["gain"]          = round(gain, 2)
    CAP["colour_gains"]  = [round(float(cg[0]), 2), round(float(cg[1]), 2)]
    CAP["lens_position"] = round(lens, 2)
    warn = ""
    if gain > 4.0:
        warn = f"  ⚠ gain {gain:.1f} 은 높습니다 — 조명을 밝게 하고 다시 측정하세요(노이즈)"
    elif gain > 2.0:
        warn = "  · 조명을 더 밝게 하면 노이즈가 줄어듭니다"
    return (f"exp {exp} · gain {gain:.2f} · WB {cg[0]:.2f}/{cg[1]:.2f} · lens {lens:.2f}"
            f"  —  [저장] 을 눌러야 config.json 에 기록됩니다{warn}")

def act_rename():
    """이름 다시 매기기 — 원하는 순서대로 화면의 박스를 클릭하게 합니다.
    자동 정렬이 어떻게 하든, <사람이 정한 순서>가 이깁니다."""
    n = len(CFG.get("rois", []))
    if n == 0:
        return "ROI 가 없습니다 — 먼저 배치하세요"
    state["order"] = []
    return f"이름을 붙일 순서대로 화면의 박스를 클릭하세요 (0/{n})"

def act_pickroi(x, y):
    """이름 매기기 중의 클릭 — 어느 박스를 골랐는지 찾아 순서에 담습니다."""
    if state["order"] is None:
        return "먼저 [이름 다시 매기기] 를 누르세요"
    X, Y = x / SCALE, y / SCALE                       # 미리보기 -> 촬영 좌표
    hit = [i for i, r in enumerate(CFG["rois"])
           if r["x"] <= X <= r["x"] + r["w"] and r["y"] <= Y <= r["y"] + r["h"]]
    if not hit:
        return "박스 안을 클릭하세요"
    i = hit[0]
    if i in state["order"]:
        return "이미 고른 박스입니다"
    state["order"].append(i)

    n = len(CFG["rois"])
    if len(state["order"]) < n:
        return f"{len(state['order'])}/{n} — 다음 박스를 클릭하세요"

    # 다 골랐습니다. 고른 순서대로 이름을 새로 붙입니다 (처리군은 박스를 따라갑니다)
    CFG["rois"] = [dict(CFG["rois"][i], plant_id=f"p{k}")
                   for k, i in enumerate(state["order"], 1)]
    state["order"] = None
    return "이름 지정 완료 — " + " · ".join(
        f"{r['plant_id']}(x={r['x']})" for r in CFG["rois"])

def act_settreat(pid, treat):
    """사람이 직접 지정. 이미 펌프를 꽂아둔 상황을 위한 길입니다.
    ★ 무작위가 아니므로 <어떻게 정했는지>를 config 에 남깁니다 —
      보고서에 '무작위 배정' 이라고 쓸 수 있는지가 여기서 갈립니다."""
    if treat not in ("stable", "fluct"):
        return f"알 수 없는 처리군: {treat}"
    hit = [r for r in CFG.get("rois", []) if r["plant_id"] == pid]
    if not hit:
        return f"{pid} 를 찾을 수 없습니다"
    hit[0]["treat"] = treat
    CFG["treat_mode"] = "manual"
    return f"{pid} → {treat} (직접 지정)"

def act_shuffle():
    CFG["treat_mode"] = "random"
    """제비뽑기. 위치와 무관하게 stable/fluct 를 섞습니다."""
    rois = CFG.get("rois", [])
    n = len(rois)
    if n == 0:
        return "ROI 가 없습니다"
    if n % 2:
        return f"ROI 가 {n}개(홀수)라 반씩 나눌 수 없습니다"
    labels = ["stable"] * (n // 2) + ["fluct"] * (n // 2)
    random.shuffle(labels)
    for r, t in zip(rois, labels):
        r["treat"] = t
    return "무작위 배정 완료 — " + " ".join(f'{r["plant_id"]}:{r["treat"][0]}' for r in rois)

def persist():
    """★ 모든 동작 뒤에 자동 호출. 버튼을 눌러도 파일에 안 쓰이는 사고를 없앱니다."""
    save_cfg(CFG)

def step_done():
    """단계별 완료 여부 — 화면 왼쪽 패널이 이 값으로 색을 칠합니다."""
    rois = CFG.get("rois", [])
    return {
        "focus": bool(CAP.get("lens_position") and CAP.get("exposure_us")),
        "scale": bool(float(CFG.get("qc", {}).get("px_per_cm_ref", 0) or 0)),
        "roi":   bool(rois),
        "treat": bool(rois) and not [r for r in rois
                                     if r.get("treat") not in ("stable", "fluct")],
        "shot":  os.path.exists("calib.jpg"),
    }

def status():
    d = step_done()
    return {"msg": state["msg"], "done": d, "all": all(d.values()),
            "mode": CFG.get("treat_mode", ""),
            "naming": state["order"] is not None,
            "pots": [{"id": r["plant_id"], "treat": r.get("treat", "")}
                     for r in CFG.get("rois", [])],
            "ppc": round(state["ppc_fixed"] or 0, 1),
            "nroi": len(CFG.get("rois", [])),
            "cm": float(state.get("cm") or 0)}

def act_save():
    return "현재 설정을 다시 저장했습니다"

ACTIONS = {
    "shoot":   lambda p: act_shoot(),
    "autoroi": lambda p: act_autoroi(int(p.get("cols", 3)), int(p.get("rows", 2))),
    "findleaf":lambda p: act_findleaf(),
    "auto":    lambda p: act_auto(),
    "point":   lambda p: act_point(float(p["x"]), float(p["y"]), float(p.get("cm", 10))),
    "setpot":  lambda p: act_setpot(float(p.get("pot_cm", 10))),
    "shuffle": lambda p: act_shuffle(),
    "settreat":lambda p: act_settreat(p["pid"], p["treat"]),
    "rename":  lambda p: act_rename(),
    "pickroi": lambda p: act_pickroi(float(p["x"]), float(p["y"])),
    "save":    lambda p: act_save(),
}

PAGE = """<!doctype html><meta charset="utf-8">
<title>camera setup</title>
<style>
 :root{
   --bg:#111418; --card:#1a1f26; --line:#2b323c; --ink:#e8ecf1; --dim:#8d97a3;
   --s1:#3E7CB1; --s2:#2F9E7E; --s3:#8E6FBF; --s4:#D2694F; --s5:#5B8C4A; --ok:#3f9d5a;
   --fs:13px;
 }
 *{box-sizing:border-box}
 body{margin:0;background:var(--bg);color:var(--ink);
      font:var(--fs)/1.55 system-ui,'Malgun Gothic',sans-serif;
      display:flex;gap:16px;padding:16px;align-items:flex-start}

 /* 왼쪽 — 조작만 */
 #panel{flex:0 0 236px;display:flex;flex-direction:column;gap:8px}
 .step{background:var(--card);border:1px solid var(--line);border-left:4px solid var(--c);
       border-radius:8px;padding:9px 11px}
 .step.done{border-left-color:var(--ok)}
 .step .hd{display:flex;align-items:center;gap:8px;font-weight:700;font-size:var(--fs);
           margin-bottom:7px}
 .step .no{flex:0 0 20px;height:20px;border-radius:50%;background:var(--c);color:#fff;
           display:flex;align-items:center;justify-content:center;font-size:11px;font-weight:700}
 .step.done .no{background:var(--ok)}
 .step.done .no::after{content:'✓'}
 .step.done .no span{display:none}
 button{width:100%;padding:9px;margin:3px 0;border:0;border-radius:6px;background:var(--c);
        color:#fff;font:700 var(--fs)/1.2 inherit;cursor:pointer}
 button.sub{background:#39424e}
 button:active{transform:translateY(1px)}
 .row{display:flex;align-items:center;gap:6px;margin:2px 0;font-size:var(--fs)}
 input{width:56px;padding:5px 6px;border-radius:5px;border:1px solid var(--line);
        background:#0d1116;color:var(--ink);font:var(--fs) inherit;text-align:center}
 .echo{font-size:var(--fs);color:var(--dim);margin-top:4px}
 .pot{display:flex;align-items:center;gap:5px;margin:5px 0;font-size:var(--fs)}
 .pot b{flex:0 0 30px}
 .pot button{flex:1;margin:0;padding:5px 0;font-size:12px;background:#39424e}
 .pot button.on{background:var(--c)}
 .echo b{color:var(--ink)}

 /* 오른쪽 — 영상 + 설명 */
 #right{flex:1;min-width:0;display:flex;flex-direction:column;gap:10px}
 #right img{width:100%;max-width:1000px;display:block;border-radius:8px;border:1px solid var(--line)}
 .info{background:var(--card);border:1px solid var(--line);border-radius:8px;
       padding:11px 14px;max-width:1000px}
 .info h4{margin:0 0 6px;font-size:var(--fs);color:var(--dim);font-weight:700;
          letter-spacing:.04em}
 .info ul{margin:0;padding-left:17px}
 .info li{margin:3px 0;font-size:var(--fs)}
 .info li b{color:#fff}
 #msg{background:#0d1116;border:1px solid var(--line);border-radius:8px;padding:10px 14px;
      max-width:1000px;font-size:var(--fs);min-height:40px}
 #msg.warn{border-color:#8a5a2b;background:#241a10}
 #msg.good{border-color:#2f6b40;background:#101d14}
</style>

<div id="panel">
  <div class="step" id="k-focus" style="--c:var(--s1)">
    <div class="hd"><span class="no"><span>1</span></span>노출 · 초점</div>
    <button onclick="go('auto')">자동 측정 → 고정</button>
  </div>

  <div class="step" id="k-scale" style="--c:var(--s2)">
    <div class="hd"><span class="no"><span>2</span></span>배율</div>
    <div class="row">길이 <input id="cm" value="5" oninput="echo()"> cm</div>
    
    <div class="row" style="margin-top:8px">화분 지름 <input id="potcm" value="10"> cm
      <button class="sub" onclick="go('setpot',{pot_cm:potcm.value})">기록</button></div>
    <div class="echo">자로 잰 값 — 배율을 <b>검산</b>하는 데 씁니다</div>
  </div>

  <div class="step" id="k-roi" style="--c:var(--s3)">
    <div class="hd"><span class="no"><span>3</span></span>ROI</div>
    <button onclick="go('findleaf')">잎 찾아 배치</button>
    <div class="row">열 <input id="c" value="2"> 행 <input id="r" value="1"></div>
    <button class="sub" onclick="go('autoroi',{cols:c.value,rows:r.value})">격자로 나누기</button>
    <button class="sub" id="rnBtn" onclick="go('rename')">이름 다시 매기기</button>
    
  </div>

  <div class="step" id="k-treat" style="--c:var(--s4)">
    <div class="hd"><span class="no"><span>4</span></span>처리군</div>
    <button onclick="go('shuffle')">무작위 배정</button>

  </div>

  <div class="step" id="k-shot" style="--c:var(--s5)">
    <div class="hd"><span class="no"><span>5</span></span>기준 사진</div>
    <button onclick="go('shoot')">촬영 — calib.jpg</button>
  </div>

  <button class="sub" onclick="go('save')">상태 다시 확인</button>
</div>

<div id="right">
  
  <div id="msg">준비됨</div>
  <div class="info">
    <h4>순서대로</h4>
    <ul>
      <li><b>1 노출·초점</b> — 카메라를 고정한 뒤 누릅니다. gain 이 2 이하가 되도록 조명을 보태세요</li>
      <li><b>2 배율</b> — 길이를 <b>먼저</b> 입력 &rarr; 화면에서 두 점 클릭. 클릭 뒤 숫자를 바꿔도 반영 안 됨</li>
      <li style="color:#8d97a3">· 자·격자처럼 눈금이 또렷한 것을 쓰세요. 화분 테두리는 잎에 가려 부정확합니다</li>
      <li style="color:#8d97a3">· 도트 격자는 한 칸 1cm — <b>5cm 는 간격 5칸(점 6개)</b></li>
      <li><b>3 ROI</b> — 잎 덩어리를 찾아 박스를 놓습니다. 개수가 맞지 않으면 격자로</li>
      <li><b>4 처리군</b> — ROI 를 다시 만들면 배정이 지워지므로 <b>반드시 3 다음</b></li>
      <li><b>5 기준 사진</b> — 전부 끝난 뒤 <b>한 번만</b>. 6주간 밀림 판정의 기준이 됩니다</li>
      <li style="color:#8d97a3">· 끝나면 <b>Ctrl+C</b> — 켜둔 채 두면 자동 촬영이 카메라를 못 잡습니다</li>
    </ul>
  </div>
</div>

<script>
function echo(){
  const v = parseFloat(document.getElementById('cm').value);
  document.getElementById('cmEcho').innerHTML =
    (v > 0) ? '두 점 사이를 <b>' + v + ' cm</b> 로 계산합니다'
            : '<b style="color:#d2694f">길이를 입력하세요</b>';
}
function paint(st){
  for (const [k, v] of Object.entries(st.done))
    document.getElementById('k-' + k).classList.toggle('done', v);

  document.getElementById('pots').innerHTML = (st.pots || []).map(p =>
    `<div class="pot"><b>${p.id}</b>` +
    `<button class="${p.treat === 'stable' ? 'on' : ''}" ` +
    `onclick="go('settreat',{pid:'${p.id}',treat:'stable'})">꾸준</button>` +
    `<button class="${p.treat === 'fluct' ? 'on' : ''}" ` +
    `onclick="go('settreat',{pid:'${p.id}',treat:'fluct'})">널뜀</button></div>`).join('');
  naming = !!st.naming;
  document.getElementById('rnBtn').textContent =
    naming ? '고르는 중 — 새로고침하면 취소' : '이름 다시 매기기';
  document.getElementById('rnEcho').innerHTML = naming
    ? '<b style="color:#8E6FBF">원하는 순서대로 화면의 박스를 클릭하세요</b>'
    : '자동 순서가 마음에 안 들면 직접 지정하세요';

  const MODE = {random: '무작위로 배정됨 — 보고서에 &ldquo;무작위 배정&rdquo; 이라 쓸 수 있습니다',
                manual: '<b style="color:#D2694F">직접 지정됨 — 무작위가 아닙니다</b>'};
  document.getElementById('modeEcho').innerHTML = MODE[st.mode] || '아직 배정하지 않았습니다';
  const m = document.getElementById('msg');
  m.textContent = st.msg + (st.all ? '   ✓ 모든 단계 완료' : '');
  m.className = st.all ? 'good' : (/⚠|실패|주의/.test(st.msg) ? 'warn' : '');
}
async function go(a, p={}){
  document.getElementById('msg').textContent = '처리 중...';
  if (a === 'point' || a === 'auto' || a === 'shoot') { /* 그대로 */ }
  const q = new URLSearchParams(p).toString();
  const res = await fetch('/do/' + a + (q ? '?' + q : ''), {method:'POST'});
  paint(await res.json());
}
let naming = false;
document.getElementById('im').addEventListener('click', e => {
  const r = e.target.getBoundingClientRect();
  const x = (e.clientX-r.left)/r.width*1280, y = (e.clientY-r.top)/r.height*720;
  // 이름 매기는 중에는 <배율 클릭>이 아니라 <박스 고르기>가 됩니다
  if (naming) go('pickroi', { x, y });
  else        go('point',   { x, y, cm: document.getElementById('cm').value });
});
echo();
fetch('/status').then(r => r.json()).then(paint);
</script>"""

class H(server.BaseHTTPRequestHandler):
    def log_message(self, *a):
        pass

    def do_GET(self):
        # 예전 mjpeg.py 주소(/index.html)로 들어와도 받아줍니다 — 브라우저가 기억하고 있습니다
        if self.path in ("/", "/index.html"):
            b = PAGE.encode()
            self.send_response(200)
            self.send_header("Content-Type", "text/html; charset=utf-8")
            self.send_header("Content-Length", len(b))
            self.end_headers()
            self.wfile.write(b)
        elif self.path == "/status":
            self._json(status()); return
        elif self.path == "/stream.mjpg":
            self.send_response(200)
            self.send_header("Cache-Control", "no-cache, private")
            self.send_header("Content-Type", "multipart/x-mixed-replace; boundary=FRAME")
            self.end_headers()
            try:
                while True:
                    if latest:
                        self.wfile.write(b"--FRAME\r\nContent-Type: image/jpeg\r\n")
                        self.wfile.write(f"Content-Length: {len(latest)}\r\n\r\n".encode())
                        self.wfile.write(latest)
                        self.wfile.write(b"\r\n")
                    time.sleep(0.08)
            except Exception:
                pass
        else:
            self.send_response(302)          # 나머지는 전부 첫 화면으로
            self.send_header("Location", "/")
            self.end_headers()

    def _json(self, obj):
        b = json.dumps(obj, ensure_ascii=False).encode()
        self.send_response(200)
        self.send_header("Content-Type", "application/json; charset=utf-8")
        self.send_header("Content-Length", len(b))
        self.end_headers()
        self.wfile.write(b)

    def do_POST(self):
        name, _, query = self.path[4:].partition("?")
        params = dict(p.split("=") for p in query.split("&") if "=" in p)
        try:
            msg = ACTIONS[name](params)
            persist()                                   # ★ 누를 때마다 파일에 기록
        except KeyError:
            self.send_error(404); return
        except Exception as e:
            msg = f"실패: {e}"
        state["msg"] = msg
        self._json(status())

class S(socketserver.ThreadingMixIn, server.HTTPServer):
    allow_reuse_address = True
    daemon_threads = True

if __name__ == "__main__":
    threading.Thread(target=grab, daemon=True).start()
    print(f"http://<pi-ip>:{PORT}   또는   http://rsp:{PORT}")
    print("끝나면 Ctrl+C — 켜둔 채로 두면 run_capture.py 가 카메라를 못 잡습니다.")
    try:
        S(("", PORT), H).serve_forever()
    except KeyboardInterrupt:
        print("\n종료합니다 —", end=" ", flush=True)
    finally:
        # ★ grab 스레드를 먼저 세운 뒤 카메라를 놓습니다.
        #   순서가 반대면 스레드가 닫힌 카메라를 건드려 오류가 납니다.
        stop_flag.set()
        time.sleep(0.2)
        try:
            cam.stop(); cam.close()
            print("카메라를 놓았습니다. 이제 run_capture.py 가 쓸 수 있습니다.")
        except Exception as e:
            print(f"카메라 정리 중 문제: {e}")
            print("  확인:  pgrep -af setup_camera.py ; sudo fuser -v /dev/media0")

실행

uv run python setup_camera.py
# http://rasp:8000   (안 되면 http://<IP>:8000 · 밖에서는 Tailscale 주소)

★ 서비스(plantsvc)가 카메라를 쥐고 있다가, 촬영 시각에는 스스로 놓습니다 — 그게 핵심입니다 세팅하는 동안은 서비스가 카메라를 쥐고 있어서 화각을 몇 번을 다시 잡든 Device or resource busy가 나지 않습니다. 기준 사진도 같은 프로세스에서 찍습니다.
미리보기와 촬영이 같은 프로세스·같은 설정이므로 “화면에서 본 것”과 “찍히는 것”이 반드시 일치합니다.
예약 촬영(05:50·15:00) 때는 plantsvc capture가 서비스에 놓아 달라고 요청하고 파일 잠금을 잡습니다 — Ctrl+C 로 무엇을 끄거나, 켜 두어서 촬영이 실패하는 일이 없습니다. 브라우저 탭은 그냥 닫으면 됩니다.

화면 | 보이는 것 | 판단
초록 사각형 | ArUco 검출됨 | 안 뜨면 배율·이동 감지 불가 → 마커를 더 밝게·평평하게
px/cm | 실시간 배율 | 패널 §1의 계산값과 비슷해야 함. 크게 다르면 높이가 틀림
주황 박스 | ROI | 화분이 자기 박스 안에 들어와야 함
빨강 + OUT OF FRAME | ROI가 화면 밖 | 실격 — 분할을 다시 하거나 카메라를 물리세요
회색 안전선 | 가장자리 5% | 이 안쪽이면 여유 있음

⚠ 순서를 지키세요 — 가장 흔한 실수 각 버튼은 누른 순간 config.json 에 기록됩니다(자동 저장). 그래서 나중에 누른 것이 앞의 것을 덮습니다.
특히 ROI 를 다시 만드는 두 버튼([잎 찾아 배치] · [격자로 나누기])은 treat 를 비웁니다 — 처리군을 먼저 배정하고 나중에 ROI 를 다시 만들면 배정이 지워집니다.

올바른 순서
① [자동 측정 → 고정] ② [촬영] ③ 두 점 클릭(배율) ④ [잎 찾아 배치] ⑤ [처리군 무작위 배정]

화면 아래 메시지에 아직 남음: ... 이 표시됩니다. “✔ 설정 완료” 가 뜰 때까지 누르세요.

### 3) 순서대로 — 버튼 여섯 개

★ [촬영] 은 맨 마지막에 한 번입니다 배율 클릭도 ROI 배치도 라이브 화면에서 합니다 — calib.jpg 를 쓰지 않습니다.
calib.jpg 의 유일한 역할은 6주간 밀림을 판정하는 기준입니다. 그래서 노출·초점·화각이 전부 확정된 뒤 찍어야 합니다. 먼저 찍으면 그 뒤 조정한 내용이 기준에 반영되지 않습니다.

▶1화각 · 노출

화면을 보며 카메라를 움직이고 단단히 고정

화분 전부가 회색 안전선 안. 고정한 뒤로는 6주간 건드리지 않습니다

자동 측정 → 고정

노출·초점·화이트밸런스를 한 번 재서 잠급니다. gain 이 2 이하가 되도록 조명을 보태세요

▼

▶2배율

길이를 먼저 입력하고 두 점 클릭

자나 격자 눈금을 쓰세요 — 화분 테두리는 잎에 가려 부정확합니다.
클릭 직후 프레임 폭이 표시됩니다. 실제로 카메라가 담는 폭과 맞는지 그 자리에서 확인하세요

▼

▶3ROI · 처리군

잎 찾아 배치

초록 덩어리를 찾아 박스를 놓습니다. 개수가 화분 수와 다르면 격자로 나누기

처리군 무작위 배정

ROI 를 다시 만들면 처리군이 비워지므로 반드시 이 순서

▼

▶4기준 사진

촬영 — calib.jpg · 마지막에 한 번

이 한 장이 6주간 밀림 판정의 기준이 됩니다

브라우저 탭을 닫으면 끝

보는 사람이 없으면 서비스가 30초 뒤 카메라를 놓습니다. 예약 촬영은 어차피 스스로 카메라를 넘겨받습니다 — 예전처럼 Ctrl+C 로 끌 것이 없습니다

밀림 판정 확인

기준 사진이 생기면 같은 화면 아래에 현재 프레임 대비 이동 px · 회전 · 배율과 OK / WARN / FAIL 이 표시됩니다. 방금 찍었으니 OK 여야 합니다. 이후 6주간 이 판정을 보러 오는 곳입니다

### 4) 설정 점검 — check_config.py

버튼을 다 눌렀다고 값이 다 들어간 것은 아닙니다. [저장]을 안 눌렀거나 한 단계를 건너뛰면 조용히 빈 채로 남습니다. 촬영·측정을 시작하기 전에 한 번 돌리세요.

⚠ 배율이 틀려도 ✔ 가 뜰 수 있습니다 — 스스로 검산하세요 px_per_cm_ref 는 사람이 클릭한 두 점과 입력한 실제 길이로만 정해집니다. 다른 값(pot_cm 등)은 배율에 관여하지 않습니다. 그래서 엉뚱한 두 점을 찍어도 프로그램은 모릅니다.

검산 두 가지
① 프레임 폭 = 해상도 ÷ 배율. 실제로 카메라가 담고 있는 폭과 비슷한가?
② 잎 퍼짐이 화분 지름보다 커야 합니다. 계산했더니 잎이 화분보다 좁으면 배율이 과대평가된 것입니다.

가장 확실한 방법은 자를 프레임 안에 놓고 눈금 두 곳을 클릭하는 것입니다. 30초면 됩니다.

check_config.py · 손으로 · 시작 전 1회 · config.json 을 펼쳐 보고 모순을 잡습니다

"""
check_config.py — config.json 을 사람이 읽을 수 있게 펼치고, 앞뒤가 맞는지 검사한다.
  uv run python check_config.py

  숫자를 보여주는 것보다 <서로 모순이 없는지> 잡는 것이 목적입니다.
  촬영·측정을 시작하기 전에 한 번 돌리세요.
"""
import json, sys

BAD = []          # 치명 — 고쳐야 진행 가능
WARN = []         # 주의 — 알고만 있으면 되는 것

def line(k, v, note=""):
    print(f"  {k:<22} {v}" + (f"   {note}" if note else ""))

try:
    CFG = json.load(open("config.json"))
except FileNotFoundError:
    sys.exit("config.json 이 없습니다")
except json.JSONDecodeError as e:
    sys.exit(f"config.json 문법 오류: {e}\n  ★ JSON 에는 // 주석을 쓸 수 없습니다")

CAP  = CFG.get("capture", {})
SIZE = CAP.get("size", [0, 0])
W, H = SIZE if len(SIZE) == 2 else (0, 0)
QC   = CFG.get("qc", {})
PPC  = float(QC.get("px_per_cm_ref", 0) or 0)
ROIS = CFG.get("rois", [])

# ── 촬영 조건 ────────────────────────────────────────────────
print("\n[촬영 조건]  — setup_2_camera / run_capture 가 공유합니다")
line("해상도", f"{W} x {H} px")
line("lens_position", CAP.get("lens_position"), "디옵터 = 1/거리(m)")
line("exposure_us", CAP.get("exposure_us"),
     f"= 1/{1e6/CAP['exposure_us']:.0f} 초" if CAP.get("exposure_us") else "")
line("gain", CAP.get("gain"))
line("colour_gains", CAP.get("colour_gains"), "(적색, 청색)")

g = float(CAP.get("gain", 0) or 0)
if g > 4:
    WARN.append(f"gain {g} — 조명이 어둡습니다. 노이즈가 ExG 분리를 방해합니다")
if not CAP.get("lens_position"):
    BAD.append("lens_position 이 비어 있습니다 — [자동 측정] 후 [저장] 하세요")

# ── 배율 ─────────────────────────────────────────────────────
print("\n[배율]")
if PPC > 0:
    line("px_per_cm_ref", f"{PPC:.1f} px/cm")
    line("프레임 실제 크기", f"{W/PPC:.1f} x {H/PPC:.1f} cm")
    line("1 px", f"{10/PPC:.2f} mm")
else:
    line("px_per_cm_ref", "없음")
    BAD.append("px_per_cm_ref 가 0 입니다 — 마커가 없으면 area_cm2 가 null 이 되고\n"
               "        측정 행이 ok=0 으로 기록되어 대시보드가 전부 걸러냅니다")

if CFG.get("ref_marker"):
    line("ref_marker", "있음", "카메라가 밀려도 ROI 자동 정렬됨")
else:
    line("ref_marker", "없음", "위치 보정 없음 — 카메라를 6주간 절대 건드리지 마세요")

# ── ROI ──────────────────────────────────────────────────────
print(f"\n[ROI]  {len(ROIS)} 칸")
if not ROIS:
    BAD.append("rois 가 비어 있습니다 — [잎 찾아 배치] 를 누르세요")

counts = {}
for r in ROIS:
    t = r.get("treat") or "(빈칸)"
    counts[t] = counts.get(t, 0) + 1
    x, y, w, h = r.get("x", 0), r.get("y", 0), r.get("w", 0), r.get("h", 0)
    cm = f"{w/PPC:.1f} x {h/PPC:.1f} cm" if PPC > 0 else ""
    flag = ""
    if x < 0 or y < 0 or x + w > W or y + h > H:
        flag = "  ← 화면 밖!"
        BAD.append(f'{r.get("plant_id")} 의 ROI 가 프레임을 벗어납니다')
    line(f'{r.get("plant_id")}  [{t}]', f"({x},{y}) {w}x{h} px  {cm}", flag)

    if t not in ("stable", "fluct"):
        BAD.append(f'{r.get("plant_id")} 의 treat 가 "{t}" 입니다 — '
                   'stable / fluct 만 대시보드가 인식합니다')

# ROI 겹침
for i in range(len(ROIS)):
    for j in range(i + 1, len(ROIS)):
        a, b = ROIS[i], ROIS[j]
        ox = min(a["x"]+a["w"], b["x"]+b["w"]) - max(a["x"], b["x"])
        oy = min(a["y"]+a["h"], b["y"]+b["h"]) - max(a["y"], b["y"])
        if ox > 0 and oy > 0:
            BAD.append(f'{a["plant_id"]} 와 {b["plant_id"]} 의 ROI 가 겹칩니다 '
                       f'({ox}x{oy} px) — 잎이 두 번 세어집니다')

print("\n[처리군]")
for t, n in sorted(counts.items()):
    line(t, f"{n} 칸")
if len(counts) == 2 and len(set(counts.values())) > 1:
    WARN.append("두 처리군의 화분 수가 다릅니다 — 비교의 검정력이 떨어집니다")
if len(ROIS) and len(counts) == 1:
    WARN.append("처리군이 한 종류뿐입니다 — [처리군 무작위 배정] 을 누르세요")

# ── 화분 크기 대비 ROI 여유 ─────────────────────────────────
LAY = CFG.get("layout", {})
pot = float(LAY.get("pot_cm", 0) or 0)
if PPC > 0 and pot > 0 and ROIS:
    side_cm = min(min(r["w"], r["h"]) for r in ROIS) / PPC
    print("\n[여유]")
    line("화분 지름", f"{pot:.0f} cm")
    line("가장 작은 ROI 한 변", f"{side_cm:.1f} cm", f"= 화분의 {side_cm/pot:.1f} 배")
    if side_cm < pot * 1.5:
        WARN.append(f"ROI 가 화분 지름의 {side_cm/pot:.1f} 배뿐입니다 — "
                    "6주 뒤 잎이 박스 밖으로 나가면 그때부터 면적이 잘립니다 (1.5~2 배 권장)")

# ── 결과 ─────────────────────────────────────────────────────
print()
for w in WARN:
    print(f"  주의  {w}")
for b in BAD:
    print(f"  문제  {b}")
if not BAD:
    print("  ✔ 치명적인 문제 없음 — 촬영·측정을 시작해도 됩니다")
print()

실행

cd ~/plant
uv run plantsvc check-config            # 같은 검사. hub/check_config.py 도 그대로 동작
uv run python hub/check_config.py

무엇을 잡아 주는가

검사 | 놓치면
px_per_cm_ref = 0 | 측정은 다 되는데 대시보드가 전부 걸러냅니다 (ok=0)
treat 가 stable/fluct 가 아님 | 대시보드가 처리군을 인식하지 못합니다
ROI 가 프레임 밖 | 그 화분이 측정에서 통째로 빠집니다
ROI 끼리 겹침 | 겹친 잎이 두 번 세어집니다
ROI 가 화분보다 좁음 | 6주 뒤 잎이 박스 밖으로 나가 면적이 잘립니다
gain 이 높음 | 노이즈가 ExG 분리를 흔듭니다

⚠ 처리군 배정은 한 번만 — 시작한 뒤에는 다시 누르지 마세요 [처리군 무작위 배정] 은 누를 때마다 새로 섞어 즉시 저장합니다. 실험이 시작되면 화분에는 이미 그 조건으로 물이 들어가고 있는데, 라벨만 바뀌면 데이터가 뒤섞입니다.
배정을 확정한 뒤 config.json 의 값을 적어 두고, 급수 노드를 그 배정대로 구우세요.

uv run python -c "
import json
for r in json.load(open('data/config.json'))['rois']: print(r['plant_id'], r['treat'])"
# 또는 웹 UI /camera/setup 의 ④ 처리군 칸 — 무작위 / 직접 지정 여부가 함께 표시됩니다

### 5) ROI 재중심 — 웹 UI [ROI 재중심] 버튼 (CLI center_roi.py 도 유지)

2026-09 — 버튼 하나로 같은 일을 합니다 /camera/setup ③ ROI 칸의 [ROI 재중심] → [재중심 미리보기]가 아래 CLI 와 같은 계산(잎 무게중심으로 중심만 이동, 크기 고정)을 하고 회색(지금)·노랑(제안) 박스를 미리보기 위에 겹쳐 보여줍니다. 마음에 들면 [적용]. 화면에 “촬영이 시작된 뒤 ROI 를 옮기면 그 전후 면적을 비교할 수 없습니다”라는 경고가 붙어 있는 이유는 아래 ⚠ 상자와 같습니다.
CLI 버전은 SSH 만 있을 때를 위해 남겨 둡니다 — 저장소를 그대로 클론하므로 경로는 hub/center_roi.py, 데이터는 PLANT_DATA_DIR(기본 ~/plant/data) 기준입니다.

무엇을 하나 웹 UI 로 잡은 ROI 박스는 격자 계산으로 놓인 자리입니다. 실제 모종은 화분 한가운데에 정확히 심기지 않으므로, 박스와 잎이 조금씩 어긋나 있는 것이 보통입니다. 이 스크립트는 각 ROI 둘레에서 잎 덩어리를 찾아 박스를 그쪽으로 옮겨 줍니다. 크기는 건드리지 않고 위치만 옮깁니다 — 크기가 달라지면 화분끼리 비교할 수 없기 때문입니다.

소스 읽을 때 표기 주의아래 소스와 그 출력 문구에 나오는 setup_camera.py는 2026-07 판 도구 이름입니다 — 지금은 웹 UI /camera/setup으로 읽으세요. “setup_camera.py 를 열어 [저장]하면 덮어쓴다”는 경고도 같은 뜻입니다: 재중심 뒤에 웹 UI 에서 ROI 를 다시 만들면(잎 찾아 배치·격자) 결과가 덮입니다.

center_roi.py · 손으로 · 촬영 시작 전에만 · calib.jpg → ROI 보정 제안 + roi_offset.jpg

"""
center_roi.py — ROI 크기는 그대로 두고 <중심만> 잎에 맞춘다.

  uv run python center_roi.py                 보기만 함 (기본)
  uv run python center_roi.py --yes           config.json 에 반영
  uv run python center_roi.py photos/raw/xxx.jpg --yes

왜 이게 필요한가
  setup_camera.py 의 미리보기(video_configuration 1280x720)와 실제 촬영
  (still_configuration 4608x2592)은 <화각이 다를 수 있다>. 미리보기에서 딱 맞게
  그린 박스가 사진에서는 밀린다. SCALE = PREV[0]/CAP_W 는 두 화각이 같다고
  전제하지만 그 전제가 항상 참은 아니다.
  그래서 이 스크립트는 <촬영한 사진 위에서> 좌표를 정한다. 미리보기를 거치지
  않으므로 화각 차이와 무관하다.

왜 크기를 안 바꾸는가
  setup_camera.py 의 [잎 찾아 배치]는 side = max(잎 가로, 잎 세로) * 1.8 로
  <잎 크기에 비례해> 박스를 만든다. 잎이 작은 화분은 작은 박스를 갖게 되고,
  그 화분이 어느 한 처리군에 속하므로 <잘림이 처리군과 정렬>된다.
  캐노피가 박스를 넘으면 작은 쪽이 먼저 잘리고, 잘린 면적과 실제로 작은 면적은
  데이터상 구분되지 않는다. 그래서 크기는 건드리지 않는다.

주의
  이걸 돌린 뒤 setup_camera.py 를 열어 [저장]하면 미리보기 기준 좌표로 덮어쓴다.
  맞춘 다음에는 열지 말 것.
"""
import argparse, glob, json, os, sys, tempfile

import cv2
import numpy as np

CFG_PATH = "config.json"

# 잎으로 인정할 최소 초록도(정규화 ExG). 중성 회색 = 0, 초록 잎 = 0.2~0.4.
# 이 문턱이 없으면 어두운 영역의 잡음 덩어리를 잎으로 착각한다 —
# leaf_mask() 의 NORM_MINMAX + Otsu 는 <무엇이 들어오든 반드시 둘로 가르기> 때문.
# 잎으로 인정할 최소 초록도(정규화 ExG). 중성 회색 = 0.
#   초록 잎은 0.25~0.45. 도트 보드·벽 같은 밝은 회색은 0.00~0.05 인데,
#   JPEG 잡음이 몇 픽셀을 0.06 위로 밀어 올리고 그게 뭉치면 잎보다 큰 덩어리가 된다.
#   실제로 선풍기·벽에 중심이 잡혔다. 0.06 은 너무 헐거웠다.
EXG_MIN  = 0.18
SEARCH   = 1.2          # ROI 를 이만큼만 넓혀 찾는다 (넓힐수록 엉뚱한 것이 들어온다)
AREA_MIN = 0.004        # 탐색창 넓이 대비 최소 크기 — 먼지·잡음 제거

def exg_of(bgr):
    """정규화 ExG. 밝기에 영향을 덜 받아 그림자에 강하다."""
    b, g, r = cv2.split(bgr.astype(np.float32))
    s = b + g + r + 1e-6
    return 2 * (g / s) - (r / s) - (b / s)

def find_leaf(img, cx, cy, w, h):
    """(cx, cy) 둘레에서 잎 덩어리를 찾아 그 <면적 무게중심>을 돌려준다.
    못 찾으면 None — 억지로 아무 데나 잡지 않는다.

    ★ 무게중심이지 기하학적 중심이 아니다. 잎이 한쪽으로 치우쳐 자라면 중심도
      그쪽으로 끌리고, ROI 가 따라 밀려 반대쪽이 잘릴 수 있다. 그래서 촬영이
      시작된 뒤에는 --yes 를 쓰지 않는다 — ROI 가 바뀌면 그 전후 면적을
      비교할 수 없다."""
    H, W = img.shape[:2]
    sw, sh = int(w * SEARCH), int(h * SEARCH)
    x0, y0 = max(0, cx - sw // 2), max(0, cy - sh // 2)
    x1, y1 = min(W, x0 + sw), min(H, y0 + sh)
    crop = img[y0:y1, x0:x1]
    if crop.size == 0:
        return None

    e = exg_of(crop)
    m = (e > EXG_MIN).astype(np.uint8) * 255
    k = cv2.getStructuringElement(cv2.MORPH_ELLIPSE, (9, 9))
    # ★ OPEN 을 먼저. 흩어진 잡음을 지운 <뒤에> 이어붙인다.
    #   순서가 반대면 잡음이 먼저 뭉쳐 커다란 가짜 덩어리가 되고, 그게 잎을 이긴다.
    m = cv2.morphologyEx(m, cv2.MORPH_OPEN, k, iterations=2)
    m = cv2.morphologyEx(m, cv2.MORPH_CLOSE, k, iterations=2)

    n, lab, st, cent = cv2.connectedComponentsWithStats(m, 8)
    if n <= 1:
        return None

    ch, cw = crop.shape[:2]
    floor = AREA_MIN * ch * cw
    ok = [i for i in range(1, n) if st[i, cv2.CC_STAT_AREA] >= floor]
    if not ok:
        return None
    # ★ 가장 큰 것이 아니라 <ROI 중심에 가장 가까운> 것을 고른다.
    #   화면에 다른 초록(다른 화분의 잎, 초록 물건)이 있어도 자기 화분을 지킨다.
    ccx, ccy = cw / 2, ch / 2
    i = min(ok, key=lambda j: (cent[j][0] - ccx) ** 2 + (cent[j][1] - ccy) ** 2)
    gx, gy = cent[i]
    return int(x0 + gx), int(y0 + gy), int(st[i, cv2.CC_STAT_AREA]), float(e[lab == i].mean())

def save_atomic(path, data):
    """open(path,'w') 는 여는 순간 파일을 비운다. 쓰다 죽으면 잘린 채 남는다.
    config.json 은 처리군 배정의 단일 출처라 그러면 복구가 어렵다."""
    d = os.path.dirname(os.path.abspath(path)) or "."
    fd, tmp = tempfile.mkstemp(dir=d, suffix=".tmp")
    with os.fdopen(fd, "w", encoding="utf-8") as f:
        json.dump(data, f, ensure_ascii=False, indent=2)
        f.flush()
        os.fsync(f.fileno())
    os.replace(tmp, path)               # 원자적 — 옛 파일이거나 새 파일이거나

def main():
    ap = argparse.ArgumentParser()
    ap.add_argument("image", nargs="?", help="기본: calib.jpg, 없으면 photos/raw 의 최신")
    ap.add_argument("--yes", action="store_true", help="config.json 에 실제로 반영")
    ap.add_argument("-o", "--out", default="roi_offset.jpg",
                    help="확인용 — ROI 와 잎이 얼마나 어긋났는지 겹쳐 그린다")
    a = ap.parse_args()

    src = a.image
    if not src:
        if os.path.exists("calib.jpg"):
            src = "calib.jpg"
        else:
            cand = sorted(glob.glob("photos/raw/*.jpg"))
            if not cand:
                print("사진이 없습니다. setup_camera.py 에서 [촬영] 하세요.")
                return 1
            src = cand[-1]

    img = cv2.imread(src)
    if img is None:
        print(f"못 읽음: {src}")
        return 1
    H, W = img.shape[:2]
    C = json.load(open(CFG_PATH, encoding="utf-8"))
    rois = C.get("rois", [])
    if not rois:
        print("config.json 에 rois 가 없습니다. 먼저 [격자로 나누기] 하세요.")
        return 1

    cap = tuple(C.get("capture", {}).get("size", [0, 0]))
    print(f"\n사진   {src}  {W}x{H}")
    if cap and (W, H) != cap:
        print(f"  ★ config 의 capture.size {cap[0]}x{cap[1]} 와 다릅니다 — "
              f"좌표가 안 맞을 수 있습니다")

    sizes = {(r["w"], r["h"]) for r in rois}
    print(f"ROI    {len(rois)}개 · 크기 {'모두 같음' if len(sizes) == 1 else '★ 다름 ' + str(sizes)}")
    # ROI 는 사각형 박스(config.json 의 x,y,w,h)이고, 잎 중심은 마스크 픽셀의
    # 무게중심이다. 둘 다 '중심'이라 부르면 무엇의 중심인지 알 수 없다.
    print(f"\n{'화분':6} {'ROI 중심':>14} {'잎 무게중심':>14} {'보정량':>12}   초록도  넓이")
    print("-" * 72)

    vis = img.copy()
    moved = 0
    for r in rois:
        w, h = r["w"], r["h"]
        cx, cy = r["x"] + w // 2, r["y"] + h // 2
        hit = find_leaf(img, cx, cy, w, h)

        cv2.rectangle(vis, (r["x"], r["y"]), (r["x"] + w, r["y"] + h), (120, 120, 120), 6)

        if not hit:
            print(f"{r['plant_id']:6} {f'({cx},{cy})':>14} {'못 찾음':>14} "
                  f"{'-':>12}      —      —")
            continue

        lx, ly, area, greenness = hit
        nx = int(np.clip(lx - w // 2, 0, W - w))
        ny = int(np.clip(ly - h // 2, 0, H - h))
        dx, dy = nx - r["x"], ny - r["y"]

        print(f"{r['plant_id']:6} {f'({cx},{cy})':>14} {f'({lx},{ly})':>14} "
              f"{f'{dx:+d},{dy:+d}':>12}   {greenness:.3f}  {area:,}px")

        cv2.rectangle(vis, (nx, ny), (nx + w, ny + h), (255, 200, 0), 8)
        cv2.circle(vis, (lx, ly), 18, (0, 0, 255), -1)
        cv2.putText(vis, f"{r['plant_id']} {r.get('treat') or '(빈칸)'}",
                    (nx + 14, ny + 74), cv2.FONT_HERSHEY_SIMPLEX, 2.0, (255, 200, 0), 5)

        if dx or dy:
            moved += 1
        r["_new"] = (nx, ny)

    cv2.imwrite(a.out, vis)
    print(f"\n확인용 이미지: {a.out}"
          f"   (회색=지금 ROI · 노랑=제안 ROI · 빨강점=잎 무게중심)")

    if not a.yes:
        print("\n  실제로 반영하려면:  uv run python center_roi.py --yes\n")
        return 0

    if moved == 0:
        print("\n  이미 맞습니다. 바꿀 것 없음.\n")
        return 0

    for r in rois:
        if "_new" in r:
            r["x"], r["y"] = r.pop("_new")
    for r in rois:
        r.pop("_new", None)

    save_atomic(CFG_PATH, C)
    print(f"\n  config.json 갱신 — {moved}개 이동. 크기는 바꾸지 않았습니다.")
    print("  ★ setup_camera.py 를 열어 [저장]하면 미리보기 좌표로 덮어씁니다. 열지 마세요.\n")
    return 0

if __name__ == "__main__":
    raise SystemExit(main())

실행

cd ~/plant
uv run python hub/center_roi.py            # 보기만 함 — data/photos/roi_offset.jpg 로 눈으로 확인
uv run python hub/center_roi.py --yes      # data/config.json 에 실제로 반영 (웹 UI [적용]과 동일)

출력 읽는 법 — roi_offset.jpg

색 | 뜻
회색 박스 | 지금 ROI — config.json 에 적혀 있는 자리
노랑 박스 | 제안 ROI — 잎 쪽으로 옮긴 자리
빨강 점 | 잎 무게중심 — 초록 화소가 몰려 있는 지점

회색과 노랑이 거의 겹치면 손댈 것이 없습니다. 크게 벌어졌다면 왜 벌어졌는지를 먼저 보세요 — 모종이 치우친 것인지, 카메라가 밀린 것인지에 따라 할 일이 다릅니다. 카메라가 밀린 것이라면 이 도구가 아니라 frame_align.py(패널 11) 의 영역입니다.

⚠ 촬영이 시작된 뒤에는 --yes 를 쓰지 마세요 찾아 주는 것은 면적 무게중심이지 기하학적 중심이 아닙니다. 잎이 한쪽으로 치우쳐 자라면 무게중심도 그쪽으로 끌리고, ROI 가 따라 밀려 반대쪽 잎이 박스 밖으로 잘려 나갈 수 있습니다.

더 큰 문제는 비교 가능성입니다. ROI 가 바뀌면 그 전후의 면적은 같은 잣대로 잰 값이 아닙니다. 생장 곡선에 계단이 생기고, 그 계단이 처리 효과처럼 보입니다. 부득이 다시 잡았다면 reset_run.py (soil·pump_log·growth 를 비우고 그 시점부터 새 구간으로 시작 — readings 는 남깁니다) 로 구간을 끊는 편이 정직합니다.

이 패널 통과 조건 — 여기까지가 손으로 하는 설치입니다

- 마커를 인쇄해 붙이고 한 변 실측을 config.json의 marker_mm에 적었다
- 카메라 높이를 정하고 단단히 고정했다 — 이후 6주간 건드리지 않는다
- 미리보기에서 화분 6개가 전부 프레임 안, 각자 ROI 박스 안에 있다
- calib.jpg가 나왔고 초점·노출이 만족스럽다
- config.json의 rois가 채워졌고 treat는 제비뽑기 결과다

다음 패널부터는 기계가 대신하는 운용입니다.

◀ 이전다음 ▶

## 11카메라 운용 — 측정 · 자동 촬영

여기서부터는 손을 떼는 구간입니다. 앞 패널에서 고정한 값 위에서 매일 2회 자동으로 찍고 재고 발행합니다. 사람이 하는 일은 주 1회 로그 확인뿐입니다.

앞 패널과 무엇이 다른가

| 패널 10 — 설치 | 패널 11 — 운용
실행 주체 | 사람이 손으로 | systemd timer가 자동
횟수 | 설치 때 1회 | 6주 동안 84회 (2회 × 42일)
스크립트 | 웹 UI /camera/setup | plantsvc capture (plantsnap.timer)
실패하면 | 즉시 눈에 보임 | 조용히 결측 — 로그를 봐야 압니다

### 1) 측정 엔진 — leaf_measure.py (ExG + Otsu)

① 초록 강조

ExG = 2G − R − B
밝기 변화에 둔감

→

② 자동 경계

Otsu
경계값을 사진마다 스스로

→

③ 세기

px ÷ (px/cm)²
→ cm²

⚠ 마커 없이 돌리면 대시보드가 텅 빕니다 — 측정이 안 돼서가 아닙니다 ExG → Otsu → 최대 덩어리 → area_px 까지는 마커와 무관하게 그대로 동작합니다. RGR·처짐 지수도 비율이라 배율이 필요 없습니다.

문제는 품질 플래그입니다. 배율을 못 구하면 ok = 0 으로 기록되는데, 대시보드는 WHERE ok=1 로 읽습니다. 즉 측정은 다 됐는데 전부 걸러집니다.

해결 — 고정 배율 한 줄

"qc": { "px_per_cm_ref": 37.0, "px_per_cm_tol": 0.03 }

값을 넣으면 find_scale() 이 이 값으로 폴백합니다. 대략값이라도 넣으세요 — RGR 결론은 배율에 영향받지 않습니다.

leaf_measure.py · 라이브러리 · 사진 1장 → 화분별 면적·윤곽 (직접 실행 안 함)

"""
leaf_measure.py — 사진 1장 -> 화분별 캐노피 투영면적.  라이브러리(직접 실행하지 않음).

  쓰는 쪽      run_capture.py 가  import leaf_measure  후  measure(...) 호출
  단독 점검    uv run python leaf_measure.py photos/raw/xxx.jpg

파이프라인
  ① frame_align   기준 사진 대비 밀림을 재고 ROI 를 옮김
  ② ROI 로 자름    화분 하나씩
  ③ ExG           2g − r − b.  <정규화> 라 밝기 변화에 둔감
  ④ Otsu          임계값을 사진마다 스스로 정함
  ⑤ 형태학        점 제거(open) → 구멍 메움(close)
  ⑥ 최대 덩어리    흙의 녹조·옆 화분 잎 같은 흩어진 초록을 버림
  ⑦ 면적·윤곽      area_px, area_cm2, contour(중심 기준 좌표)

★ 투영 캐노피 면적 ≠ 잎 면적.  겹친 잎은 한 번만 세므로 <항상 과소평가>입니다.
  생장률 비교에는 충분하지만, 보고서에는 "투영 캐노피 면적"으로 쓰고
  6주차 파괴 측정(실제 잎면적·건중량·뿌리)으로 검증하세요.
"""
import json, os, sys
import cv2
import numpy as np

try:
    import frame_align
except ImportError:                      # 없으면 밀림 보정만 건너뜁니다
    frame_align = None

CFG_PATH = "config.json"
REF_PATH = "calib.jpg"

def cfg():
    return json.load(open(CFG_PATH))

# ══════════════ ③~⑥ 잎 분리 ══════════════
def leaf_mask(bgr, ksize=5, open_it=1, close_it=2):
    """ROI 한 칸 안에서 잎만 남긴 흑백 마스크와 픽셀 수."""
    b, g, r = cv2.split(bgr.astype(np.float32))
    s = b + g + r + 1e-6
    exg = 2 * (g / s) - (r / s) - (b / s)          # 정규화 ExG — 그림자에 강함
    x = cv2.normalize(exg, None, 0, 255, cv2.NORM_MINMAX).astype(np.uint8)
    x = cv2.GaussianBlur(x, (5, 5), 0)
    thr, m = cv2.threshold(x, 0, 255, cv2.THRESH_BINARY + cv2.THRESH_OTSU)

    k = cv2.getStructuringElement(cv2.MORPH_ELLIPSE, (ksize, ksize))
    m = cv2.morphologyEx(m, cv2.MORPH_OPEN,  k, iterations=open_it)
    m = cv2.morphologyEx(m, cv2.MORPH_CLOSE, k, iterations=close_it)

    n, lab, st, _ = cv2.connectedComponentsWithStats(m, 8)
    if n <= 1:
        return np.zeros_like(m), 0, 0, float(thr)
    i = 1 + int(np.argmax(st[1:, cv2.CC_STAT_AREA]))
    big = np.where(lab == i, 255, 0).astype(np.uint8)
    return big, int(st[i, cv2.CC_STAT_AREA]), n - 1, float(thr)

def outline(mask, n_pts=64):
    """대시보드가 그릴 실루엣. <중심 기준> 좌표라 좌표 크기 자체가 면적을 담습니다."""
    c, _ = cv2.findContours(mask, cv2.RETR_EXTERNAL, cv2.CHAIN_APPROX_SIMPLE)
    if not c:
        return None
    c = max(c, key=cv2.contourArea).reshape(-1, 2).astype(np.float32)
    M = cv2.moments(c)
    if M["m00"] == 0:
        return None
    cx, cy = M["m10"] / M["m00"], M["m01"] / M["m00"]
    idx = np.linspace(0, len(c) - 1, n_pts).astype(int)      # 균등 리샘플
    pts = c[idx] - [cx, cy]
    return json.dumps([[round(float(x), 1), round(float(y), 1)] for x, y in pts])

# ══════════════ 본체 ══════════════
def measure(img_path, phase, debug_dir=None, mask_dir=None, C=None):
    C = C or cfg()
    img = cv2.imread(img_path)
    if img is None:
        raise FileNotFoundError(img_path)
    H, W = img.shape[:2]
    stem = os.path.splitext(os.path.basename(img_path))[0]

    ppc = float(C.get("qc", {}).get("px_per_cm_ref", 0) or 0)
    if ppc <= 0:
        print("[WARN] px_per_cm_ref 가 없습니다 — area_cm2 는 null, ok=0 으로 기록됩니다")

    # ── ① 밀림 보정 ──
    rois, drift = C.get("rois", []), None
    if frame_align and os.path.exists(REF_PATH):
        drift = frame_align.align(img_path, REF_PATH, C)
        if drift["ok"] and drift["level"] == "drift":
            rois = frame_align.shift_rois(rois, drift["dx"], drift["dy"], img.shape)
        print(f"[ALIGN] {drift['level']}: {drift['msg']}")

    geom_bad = bool(drift and drift["level"] == "fail")

    out = []
    for roi in rois:
        x, y, w, h = roi["x"], roi["y"], roi["w"], roi["h"]
        if x < 0 or y < 0 or x + w > W or y + h > H:
            print(f'[WARN] {roi["plant_id"]}: ROI 가 프레임 밖 — 건너뜀')
            continue

        crop = img[y:y + h, x:x + w]
        mask, px, blobs, thr = leaf_mask(crop)

        # ── 품질 판정 ──
        # 테두리에 <닿았는지>가 아니라 <얼마나 걸쳐 있는지>로 봅니다.
        # 한 픽셀 스친 것과 30%가 밖으로 나간 것은 다릅니다.
        border = np.concatenate([mask[0, :], mask[-1, :], mask[:, 0], mask[:, -1]])
        edge_px   = int((border > 0).sum())
        edge_frac = edge_px / float(2 * (w + h))          # 테두리 길이 대비
        tol  = float(C.get("qc", {}).get("edge_tol", 0.02))
        edge = edge_frac > tol
        too_big = px > 0.9 * w * h
        ok = int(px > 0 and not edge and not too_big and ppc > 0 and not geom_bad)
        if edge:
            print(f'[WARN] {roi["plant_id"]}: 잎이 ROI 테두리의 {edge_frac*100:.1f}%에 걸쳐 있습니다 '
                  f'(허용 {tol*100:.0f}%) — 면적이 <실제보다 작습니다>. 박스를 넓히세요')
        elif edge_px:
            print(f'[INFO] {roi["plant_id"]}: 테두리 접촉 {edge_frac*100:.1f}% — 허용 범위')
        if too_big:
            print(f'[WARN] {roi["plant_id"]}: 마스크가 ROI 의 90%% 초과 — 배경을 잡았을 가능성')

        # ── 배율 검산: 잎이 화분을 덮고 넘치는데 면적이 화분 넓이의 절반도 안 되면
        #    배율이 틀린 것입니다. 면적은 배율의 <제곱>이라 클릭 실수가 크게 증폭됩니다.
        pot_cm = float(C.get("layout", {}).get("pot_cm", 0) or 0)
        if ppc > 0 and pot_cm > 0 and px > 0:
            a_cm2 = px / ppc ** 2
            foot  = 3.14159 * (pot_cm / 2) ** 2
            if a_cm2 < foot * 0.5:
                print(f'[WARN] {roi["plant_id"]}: 면적 {a_cm2:.1f}cm² 가 화분 넓이 {foot:.0f}cm² 의 '
                      f'{a_cm2/foot*100:.0f}% 뿐입니다 — px_per_cm_ref({ppc:.1f}) 를 의심하세요')
            elif a_cm2 > foot * 4:
                print(f'[WARN] {roi["plant_id"]}: 면적 {a_cm2:.1f}cm² 가 화분 넓이의 '
                      f'{a_cm2/foot:.1f}배입니다 — 배율 또는 마스크를 의심하세요')

        row = {"plant_id": roi["plant_id"], "treat": roi.get("treat"),
               "phase": phase, "area_px": px,
               "area_cm2": round(px / ppc ** 2, 2) if ppc > 0 else None,
               "px_per_cm": round(ppc, 3) if ppc > 0 else None,
               "contour": outline(mask), "blobs": blobs, "ok": ok,
               "edge_frac": round(edge_frac, 4),      # DB 컬럼 아님 — jsonl·콘솔 진단용
               "img_file": os.path.basename(img_path)}
        out.append(row)

        if mask_dir:
            os.makedirs(mask_dir, exist_ok=True)
            cv2.imwrite(f'{mask_dir}/{stem}_{roi["plant_id"]}.png', mask)
        if debug_dir:
            os.makedirs(debug_dir, exist_ok=True)
            vis = crop.copy()
            vis[mask == 0] = (vis[mask == 0] * 0.25).astype(np.uint8)   # 배경 어둡게
            c, _ = cv2.findContours(mask, cv2.RETR_EXTERNAL, cv2.CHAIN_APPROX_SIMPLE)
            cv2.drawContours(vis, c, -1, (0, 0, 255), 3)
            cv2.putText(vis, f'{roi["plant_id"]} {row["area_cm2"]}cm2'
                             f'{"" if ok else "  NG"}',
                        (12, 46), cv2.FONT_HERSHEY_SIMPLEX, 1.4,
                        (0, 255, 0) if ok else (0, 0, 255), 3)
            cv2.imwrite(f'{debug_dir}/{stem}_{roi["plant_id"]}.jpg', vis)
    return out

if __name__ == "__main__":
    path  = sys.argv[1] if len(sys.argv) > 1 else REF_PATH
    phase = sys.argv[2] if len(sys.argv) > 2 else "test"
    rows = measure(path, phase, "photos/debug", "photos/mask")
    print(f"\n{'화분':6} {'처리군':8} {'면적px':>10} {'면적cm2':>9} {'조각':>5} {'윤곽':>6} {'판정':>5}")
    for r in rows:
        print(f"  {r['plant_id']:4} {str(r['treat']):8} {r['area_px']:>10,} "
              f"{str(r['area_cm2']):>9} {r['blobs']:>5} "
              f"{'있음' if r['contour'] else '없음':>6} {'ok' if r['ok'] else 'NG':>5}")
    print(f"""
  오버레이를 <반드시 눈으로> 확인하세요. 빨간 윤곽이 잎 경계와 맞지 않으면
  숫자는 의미가 없습니다.  저장 위치: photos/debug/

  보는 법 — 터미널을 하나 더 열어서
      cd ~/plant
      python3 -m http.server 8080
    브라우저에서  http://rsp:8080/photos/debug/   (확인 뒤 Ctrl+C 로 서버 종료)
""")

contour가 대시보드의 캐노피 오버레이를 만듭니다 외곽선을 중심 기준 픽셀 좌표로 저장하므로 좌표 크기 자체가 면적을 담습니다. 대시보드는 하루 전과 지금을 그대로 겹쳐 그리기만 하면 됩니다 — 자란 만큼 바깥으로 커집니다. 하루면 차이가 작지만 그날그날의 변화가 보입니다. 대신 눈에 잘 안 띄는 만큼, 캡션에는 실험 시작 이래 총 성장률을 따로 적습니다. 점 64개로 줄여 저장하니 6주 × 2회 × 6화분이어도 DB 부담이 없습니다.

숫자만 보지 말고 debug 이미지를 보세요 면적은 그럴듯한데 실제로는 흙 얼룩을 잎으로 잡고 있는 경우가 흔합니다. debug/의 빨간 윤곽선이 진짜 잎 경계와 맞는지 눈으로 확인하세요. 이 단계를 건너뛰면 6주 뒤 전체 데이터를 버립니다.

실제 사진으로 검증한 결과 — 밀림 보정이 실제로 듣는가 같은 사진을 60, −35 px 인위로 밀어 넣고 측정했습니다.

화분 | 기준 사진 | 밀린 사진 (보정 후) | 차이
p1 | 1,183,330 px | 1,184,117 px | +0.07%
p2 | 1,035,757 px | 1,035,317 px | −0.04%

frame_align 이 69.4px 밀림을 잡아 ROI 를 옮긴 결과, 면적이 0.1% 안에서 재현됐습니다. 마커 없이도 위치 감시가 성립한다는 뜻입니다.

⚠ 숫자보다 photos/debug/ 를 먼저 보세요 면적은 언제나 그럴듯한 숫자로 나옵니다. 흙 얼룩을 잎으로 잡고 있어도 마찬가지입니다. 오버레이에서 확인할 것:
① 빨간 윤곽이 실제 잎 가장자리와 맞는가 ② 흙·녹조를 잎으로 잡지 않았는가 ③ 그늘진 잎을 놓치지 않았는가 ④ 옆 화분 잎이 섞이지 않았는가
조각 수가 갑자기 늘면 잡음이 늘었다는 신호입니다 — 조명이 바뀌었거나 흙이 말라 색이 변한 경우가 많습니다.

### 2) 결과를 눈으로 확인하기 — 이 단계를 건너뛰면 6주를 버립니다

면적은 언제나 그럴듯한 숫자로 나옵니다. 흙 얼룩을 잎으로 잡고 있어도 마찬가지입니다. 그래서 숫자보다 그림을 먼저 봐야 합니다.

파일이 어디에 생기는가 leaf_measure.py 를 돌리면 자동으로 두 폴더가 채워집니다.

plant/
└── photos/
    ├── debug/   calib_p1.jpg   <- 윤곽선 오버레이 (이걸 봅니다)
    └── mask/    calib_p1.png   <- 흑백 마스크 (애매할 때 참고)

먼저 파일이 생겼는지 확인하세요.

ls -l photos/debug/

방법 A · 임시 웹서버 — 가장 빠릅니다

cd ~/plant
python3 -m http.server 8080

이 상태로 터미널을 그대로 두고 브라우저에서 엽니다. 파일 목록이 뜨면 클릭해서 봅니다.

http://rasp:8080/photos/debug/

다 보고 나면 터미널로 돌아와 Ctrl+C 로 서버를 끕니다.

이 명령이 하는 일 — 파이썬에 딸려 오는 파일 서버입니다 python3 -m http.server 8080 은 지금 폴더를 웹으로 열어 줍니다. 설치할 것도 설정할 것도 없습니다.
⚠ 폴더 전체가 열립니다 — plant.db 도 포함됩니다. 확인이 끝나면 반드시 끄세요. 켜둔 채 두지 마세요.
⚠ rasp 로 안 열리면 IP 를 쓰세요. Pi 에서 hostname -I 로 확인하고, 밖에서는 Tailscale 주소로 접속합니다.

방법 B · noVNC 화면에서

패널 9의 원격 데스크톱에서 파일 관리자로 plant/photos/debug 를 열고 더블클릭하면 그림 보기가 뜹니다. 여러 장을 화살표로 넘겨 보기 좋습니다.

⚠ 오버레이에서 확인할 것 넷

- 빨간 윤곽이 실제 잎 가장자리와 맞는가
- 화분 테두리·흙·녹조를 잎으로 잡지 않았는가
- 그늘진 잎을 놓치지 않았는가
- 옆 화분 잎이 섞여 들어오지 않았는가

좌상단에 p1 86.0cm2 처럼 면적과 판정이 찍힙니다. NG 면 빨간 글씨이고, 그 이유는 터미널에 함께 출력됩니다.

6주 동안은 날짜순으로 넘겨 보는 것이 가장 빠른 점검입니다 파일명이 2026-08-01_0600_p1.jpg 형식이라 목록이 저절로 시각순입니다. 어느 날부터 윤곽이 이상해졌는지가 한눈에 보입니다 — 조명이 바뀌었거나 흙에 녹조가 생긴 날이 그 지점입니다.
터미널의 조각 수도 같은 신호를 줍니다. 갑자기 늘면 잡음이 늘어난 것입니다.

⚠ 조명이 바뀌면 면적이 바뀝니다 — 실제로 겪은 사례 같은 화분을 같은 설정으로 반나절 간격으로 찍었더니:

| 실내등 아래 (밤) | 자연광만 (06:00)
p1 | 86.0 cm² | 71.8 cm² (−17%)
p2 | 70.7 cm² | 57.9 cm² (−18%)

식물은 그대로입니다. 노출을 고정해 두었으므로 어두워지면 사진이 어둡게 찍히고, Otsu 임계값이 올라가 마스크가 잎 안쪽으로 파고듭니다.

더 나쁜 것은 이게 날마다 조금씩 다르다는 점입니다 — 흐린 날·맑은 날, 계절에 따라 일출 시각까지 밀립니다. 생장 곡선에 날씨가 섞여 들어옵니다.

새벽 촬영 시각에 백색 LED 가 켜져 있게(패널 19 — 환경노드가 05:45~06:15 시간 기반으로 네오픽셀 스트립을 점등) 하고 그 아래서 찍으세요. 촬영 시각을 고정하는 것보다 조명을 고정하는 것이 확실합니다. 보라색 재배등은 안 됩니다 — G 성분이 없어 ExG 가 작동하지 않습니다.

### 3) 카메라 밀림 감지 — frame_align.py (마커 대체)

ROI 는 고정 픽셀 사각형이라 카메라가 몇 mm만 밀려도 옆 화분을 자릅니다. 그런데 배율은 멀쩡하고 사진도 정상이라 아무도 눈치채지 못합니다. ArUco 마커가 이걸 감시하는 장치였는데, 사진만으로 같은 일을 할 수 있습니다.

원리 — 변하는 것은 잎뿐입니다 배경(종이·책상·마운트)은 6주간 그대로입니다. 그래서 ROI 를 가린 뒤 기준 사진(calib.jpg)과 비교하면, 남은 어긋남이 곧 카메라가 움직인 양입니다.

무엇을 | 어떻게 | 마커 대비
평행이동 | cv2.phaseCorrelate | 동등 — 0.1px 수준
회전 | FFT 진폭 → log-polar → 같은 방법 (푸리에-멜린. 진폭 스펙트럼은 평행이동에 불변) | 동등
배율(높이) | | 동등

인쇄·코팅·부착·6주 관리가 사라집니다. 대신 배경이 단조로우면 맞출 단서가 없어 신뢰도가 떨어지므로, 신뢰도(0~1)를 함께 돌려주고 낮으면 보정하지 않고 경고만 합니다.

⚠ 배경이 15% 미만 이 뜨면 밀림 감지가 꺼진 상태입니다 비교할 배경이 있어야 어긋남을 잽니다. 화분이 프레임을 꽉 채우면 남는 배경이 없습니다.

ROI 여유폭 | 가려지는 면적 | 남는 배경
1.25배 | 99.5% | 0.5% — 정렬 포기
1.10배 | 77.0% | 23.0%
1.00배 | 63.7% | 36.3%

그래서 1.25 → 1.10 → 1.00 순으로 줄여 가며 배경을 확보한 뒤 정렬합니다. 그래도 15%를 못 넘기면 보정하지 않고 경고만 합니다 — 단서 없이 억지로 맞추면 없는 밀림을 만들어 내기 때문입니다.

근본 해결은 여백입니다. ROI 사이와 프레임 가장자리에 종이가 보이도록 카메라를 조금 높이세요. 잎이 자랄 여유도 함께 생깁니다.

frame_align.py · 라이브러리 + 점검 도구 · calib.jpg 대비 어긋남 → ROI 보정

"""
frame_align.py — 카메라가 밀렸는지·돌아갔는지·높이가 변했는지를 <사진만으로> 알아낸다.
                 ArUco 마커가 하던 '위치 감시' 역할을 대신합니다.

  라이브러리로 쓰기      import frame_align;  d = frame_align.align("photos/raw/xxx.jpg")
  단독 점검용으로 쓰기    uv run python frame_align.py photos/raw/xxx.jpg

원리
  배경(종이·책상·마운트)은 6주간 변하지 않고, 변하는 것은 <잎>뿐입니다.
  그래서 ROI(잎이 있는 곳)를 가린 뒤 기준 사진과 비교하면
  남은 어긋남이 곧 <카메라가 움직인 양>입니다.

    · 평행이동  cv2.phaseCorrelate        -> dx, dy (px)
    · 회전·배율  log-polar 변환 후 같은 방법 -> 각도(deg), 배율비

한계 — 정직하게
  · 배경이 전부 단색이면 맞출 단서가 없어 신뢰도(resp)가 떨어집니다.
  · 조명이 크게 바뀌면 값이 흔들립니다. 노출 고정이 전제입니다.
  · 잎이 프레임의 대부분을 덮으면 배경이 모자라 부정확해집니다.
  -> 그래서 resp(0~1)를 함께 돌려주고, 낮으면 <보정하지 말고 경고만> 합니다.
"""
import json, os, sys
import cv2
import numpy as np

CFG_PATH = "config.json"
REF_PATH = "calib.jpg"          # 기준 사진 = 설치 때 찍은 그 한 장

# 판정 기준 (config 의 qc 로 덮어쓸 수 있습니다)
DEF_SHIFT_WARN = 8.0            # px — 이보다 크면 알림
DEF_SHIFT_FAIL = 40.0           # px — 이보다 크면 보정해도 못 믿음
DEF_RESP_MIN   = 0.05           # 신뢰도 하한

def _cfg():
    try:
        return json.load(open(CFG_PATH))
    except Exception:
        return {}

def _prep(img, mask=None):
    """회색조 + ROI 가리기 + 창함수.  phaseCorrelate 는 float32 를 받습니다."""
    g = cv2.cvtColor(img, cv2.COLOR_BGR2GRAY) if img.ndim == 3 else img
    g = g.astype(np.float32)
    g -= g.mean()
    if mask is not None:
        g = g * mask
    h, w = g.shape
    win = np.outer(np.hanning(h), np.hanning(w)).astype(np.float32)
    return g * win

def _roi_mask(shape, rois, grow=1.25):
    """잎이 있는 곳을 0, 배경을 1 로. 자랄 것을 감안해 조금 넓게 가립니다."""
    h, w = shape[:2]
    m = np.ones((h, w), np.float32)
    for r in rois or []:
        cx, cy = r["x"] + r["w"] / 2, r["y"] + r["h"] / 2
        hw, hh = r["w"] * grow / 2, r["h"] * grow / 2
        x0, y0 = max(0, int(cx - hw)), max(0, int(cy - hh))
        x1, y1 = min(w, int(cx + hw)), min(h, int(cy + hh))
        m[y0:y1, x0:x1] = 0.0
    return m

def _square(img, n=512):
    """정사각형으로 줄여서 스펙트럼을 봅니다. 크기·비율이 결과에 영향을 주지 않게."""
    g = cv2.cvtColor(img, cv2.COLOR_BGR2GRAY) if img.ndim == 3 else img
    g = cv2.resize(g.astype(np.float32), (n, n))
    g -= g.mean()
    return g * np.outer(np.hanning(n), np.hanning(n)).astype(np.float32)

def _spectrum(g):
    """FFT 진폭 스펙트럼. <평행이동에 불변>이라 회전·배율만 남습니다 (푸리에-멜린)."""
    F = np.log1p(np.fft.fftshift(np.abs(np.fft.fft2(g))))
    n = F.shape[0]
    yy, xx = np.ogrid[:n, :n]
    rad = np.hypot(yy - n / 2, xx - n / 2)
    return (F * (1 - np.exp(-(rad / (0.03 * n)) ** 2))).astype(np.float32)   # 고주파 강조

def _rot_scale(ref_bgr, cur_bgr, n=512):
    """log-polar 에서 <세로 이동 = 회전>, <가로 이동 = 배율>.
    스펙트럼은 180도 대칭이라 각도는 ±90도 범위로 접습니다."""
    A, B = _spectrum(_square(ref_bgr, n)), _spectrum(_square(cur_bgr, n))
    M = n / np.log(n / 2)
    fl = cv2.INTER_LINEAR + cv2.WARP_FILL_OUTLIERS
    # cv2.logPolar 은 구형 C-API 호환 함수라 OpenCV 최신판에서 사라졌습니다
    # (AttributeError: module 'cv2' has no attribute 'logPolar').
    # warpPolar 이 대체입니다 — WARP_POLAR_LOG 를 주면 계산이 동일하고,
    # maxRadius 를 M 에 맞춰 exp(maxRadius/M) 가 반지름 상한이 되게 잡습니다.
    # 옛 logPolar 은 M 만 받아 상한이 암묵적이었는데, 여기서는 명시해야 같은 축척이 됩니다.
    maxr = float(np.exp(n / M))              # logPolar(M) 과 같은 가로 축척
    pflag = fl + cv2.WARP_POLAR_LOG
    a = cv2.warpPolar(A, (n, n), (n / 2, n / 2), maxr, pflag)
    b = cv2.warpPolar(B, (n, n), (n / 2, n / 2), maxr, pflag)
    win = np.outer(np.hanning(n), np.hanning(n)).astype(np.float32)
    (sx, sy), resp = cv2.phaseCorrelate(a, b, win)
    deg = -sy * 360.0 / n
    if deg > 90:    deg -= 180
    elif deg < -90: deg += 180
    return float(deg), float(np.exp(-sx / M)), float(resp)

def align(cur_path, ref_path=REF_PATH, cfg=None):
    """기준 사진 대비 현재 사진의 어긋남을 잰다.  실패해도 예외를 던지지 않습니다."""
    cfg = cfg or _cfg()
    qc  = cfg.get("qc", {})
    out = dict(ok=False, dx=0.0, dy=0.0, resp=0.0, deg=0.0, scale=1.0,
               level="unknown", msg="")

    ref = cv2.imread(ref_path)
    cur = cv2.imread(cur_path)
    if ref is None or cur is None:
        out["msg"] = f"이미지를 못 읽음 ({ref_path} / {cur_path})"
        return out
    if ref.shape != cur.shape:
        out["msg"] = f"해상도가 다름 {ref.shape[:2]} vs {cur.shape[:2]}"
        return out

    mask = _roi_mask(ref.shape, cfg.get("rois"))
    if mask.mean() < 0.15:
        out["msg"] = "배경이 15% 미만 — 맞출 단서가 부족합니다"
        return out

    # ★ 이 함수는 <실패해도 예외를 던지지 않는다>는 약속으로 쓰입니다.
    #   leaf_measure 가 이걸 부르는데, 여기서 예외가 새면 촬영 전체가 죽습니다.
    #   실제로 2026-08-01 에 그랬습니다 — cv2.logPolar 이 최신 OpenCV 에서 사라져
    #   AttributeError 가 났고, 그날 dawn·pm 두 번의 측정이 통째로 날아갔습니다.
    #   밀림 보정은 <부가 기능>이고 면적 측정은 그것 없이도 됩니다. 그러니 여기서
    #   막고, 다만 <조용히 넘기지는 않습니다> — 침묵하면 꺼진 줄도 모릅니다.
    try:
        a, b = _prep(ref, mask), _prep(cur, mask)
        (dx, dy), resp = cv2.phaseCorrelate(a, b)
    except Exception as e:
        out["msg"] = f"평행이동 검출 실패({type(e).__name__}: {e}) — 보정 없이 진행합니다"
        print(f"[frame_align] {out['msg']}")
        return out

    try:
        deg, scale, resp2 = _rot_scale(ref, cur)
    except Exception as e:
        # 회전·배율만 실패한 경우입니다. 평행이동 보정은 살아 있으니 그것만 씁니다.
        deg, scale, resp2 = 0.0, 1.0, 0.0
        print(f"[frame_align] 회전·배율 검출 실패({type(e).__name__}: {e}) "
              f"— 평행이동만 보정합니다")

    warn = float(qc.get("drift_warn_px", DEF_SHIFT_WARN))
    fail = float(qc.get("drift_fail_px", DEF_SHIFT_FAIL))
    rmin = float(qc.get("drift_resp_min", DEF_RESP_MIN))
    mag  = float(np.hypot(dx, dy))

    out.update(dx=float(dx), dy=float(dy), resp=float(resp),
               deg=float(deg), scale=float(scale), mag=mag)

    if resp < rmin:
        out.update(level="unreliable",
                   msg=f"신뢰도 {resp:.3f} 낮음 — 보정하지 않습니다(배경 단서 부족·조명 변화)")
    elif mag > fail:
        out.update(level="fail",
                   msg=f"{mag:.0f}px 어긋남 — 보정 범위를 넘었습니다. 카메라를 다시 맞추고 "
                       f"calib.jpg 를 새로 찍으세요")
    elif mag > warn:
        out.update(ok=True, level="drift",
                   msg=f"{mag:.1f}px 밀림 감지 — ROI 를 그만큼 옮겨 보정합니다")
    else:
        out.update(ok=True, level="ok", msg=f"{mag:.1f}px — 정상 범위")

    # 회전·배율이 변하면 ROI 를 옮기는 것만으로는 못 고칩니다 -> 재설치 판정
    if resp2 >= rmin and abs(deg) > 1.0:
        out.update(ok=False, level="fail",
                   msg=f"회전 {deg:+.2f}도 — 평행이동 보정으로는 못 고칩니다. 카메라 각도를 다시 맞추세요")
    elif resp2 >= rmin and abs(scale - 1) > 0.015:
        out.update(ok=False, level="fail",
                   msg=f"배율 {(scale-1)*100:+.1f}% — 카메라 높이가 변했습니다. 다시 맞추고 calib.jpg 재촬영")
    else:
        if resp2 >= rmin and abs(deg) > 0.3:
            out["msg"] += f" · 회전 {deg:+.2f}도(경미)"
        if resp2 >= rmin and abs(scale - 1) > 0.005:
            out["msg"] += f" · 배율 {(scale-1)*100:+.1f}%(경미)"
    out["resp_rs"] = resp2
    return out

def shift_rois(rois, dx, dy, shape=None):
    """검출된 어긋남만큼 ROI 를 옮긴 새 목록을 돌려준다 (원본은 그대로)."""
    out = []
    for r in rois or []:
        q = dict(r)
        q["x"] = int(round(r["x"] + dx))
        q["y"] = int(round(r["y"] + dy))
        if shape is not None:                       # 프레임 밖으로 나가지 않게
            h, w = shape[:2]
            q["x"] = max(0, min(q["x"], w - r["w"]))
            q["y"] = max(0, min(q["y"], h - r["h"]))
        out.append(q)
    return out

if __name__ == "__main__":
    path = sys.argv[1] if len(sys.argv) > 1 else REF_PATH
    ref  = sys.argv[2] if len(sys.argv) > 2 else REF_PATH
    cfg  = _cfg()
    d = align(path, ref, cfg)
    ppc = float(cfg.get("qc", {}).get("px_per_cm_ref", 0) or 0)

    print(f"""
기준  {ref}
현재  {path}

  평행이동   dx {d['dx']:+7.2f} px   dy {d['dy']:+7.2f} px""" +
          (f"   = {d.get('mag',0)/ppc*10:.2f} mm" if ppc else "") + f"""
  회전       {d['deg']:+.3f} 도
  배율비     {d['scale']:.4f}   (1.000 이면 높이 변화 없음)
  신뢰도     {d['resp']:.3f}

  판정  [{d['level']}]  {d['msg']}
""")
    if d["ok"] and cfg.get("rois"):
        moved = shift_rois(cfg["rois"], d["dx"], d["dy"])
        for a, b in zip(cfg["rois"], moved):
            if (a["x"], a["y"]) != (b["x"], b["y"]):
                print(f"  {a['plant_id']}  ({a['x']},{a['y']}) -> ({b['x']},{b['y']})")

단독 점검

uv run python frame_align.py photos/raw/2026-08-01_0600.jpg

합성 이동으로 검증한 결과

가한 변화 | 검출값 | 판정
없음 | 0.00 px · 0.000° · 1.0000 | ok
25, −14 px 밀림 | +25.01, −13.98 px | drift → ROI 자동 보정
120, 60 px 밀림 | +120.00, +59.98 px | fail → 재설치 요구
1.5° 회전 | +1.52° | fail — 평행이동으로는 못 고침
3% 확대(높이 변화) | +3.0% | fail → calib.jpg 재촬영

회전·배율은 보정하지 않고 실패로 처리합니다. ROI 를 옮기는 것만으로는 못 고치는 변형이라, 조용히 틀린 값을 만드는 것보다 멈추고 알리는 편이 낫습니다.

⚠ 밀림 보정이 측정 전체를 죽이지 않게 — 2026-08-01 에 겪은 일 cv2.logPolar 은 구형 C-API 호환 함수라 최신 OpenCV 에서 사라졌습니다. 그날 AttributeError 가 났고, leaf_measure 가 이 함수를 부르는 자리에서 예외가 그대로 새어 나가 dawn·pm 두 번의 측정이 통째로 날아갔습니다. 사진은 찍혔는데 DB 는 비었습니다.

무엇을 | 어떻게 고쳤나
사라진 함수 | cv2.warpPolar + WARP_POLAR_LOG 로 대체. 옛 함수는 반지름 상한이 암묵적이었으므로 maxRadius = exp(n/M) 로 명시해야 같은 축척이 됩니다
새어 나간 예외 | align() 이 예외를 밖으로 던지지 않도록 이중으로 막았습니다 — 평행이동이 실패하면 보정 없이, 회전·배율만 실패하면 평행이동만 보정하고 진행

원칙은 하나입니다 — 밀림 보정은 부가 기능이고 면적 측정은 그것 없이도 됩니다. 다만 조용히 넘기지는 않습니다. 실패하면 [frame_align] 로 로그에 남깁니다 — 침묵하면 꺼진 줄도 모른 채 6주가 지나갑니다.

⚠ 마커를 안 쓰면 마운트가 유일한 방어선입니다 소프트웨어는 움직였다는 사실을 알려줄 뿐 되돌려 놓지는 못합니다. 카메라는 클램프로 단단히 물리고, 케이블이 당겨지지 않게 여유를 두고, 화분과 같은 책상을 쓰지 마세요 — 물 주다 건드리는 것이 가장 흔한 사고입니다.

### 4) ★ 종이 잎 검증 — 정답을 아는 유일한 방법

왜 결정적인가 진짜 상추를 찍어 "48.3cm²"가 나왔다고 합시다. 이게 맞는지 어떻게 압니까? 알 방법이 없습니다. 반면 정확히 50.0cm²로 오려낸 종이를 찍어 48.3이 나오면 −3.4% 오차임을 압니다. 시스템의 정확도를 수치로 아는 유일한 방법입니다.

세트 | 면적 | 지름 (d = 2√(A/π)) | 모사
S | 5 cm² | 2.52 cm | 발아 직후 떡잎
M | 20 cm² | 5.05 cm | 2주차
L | 50 cm² | 7.98 cm | 4주차
XL | 100 cm² | 11.28 cm | 수확기

- 무광 초록 색지 — 코팅지는 반사되어 실패
- 형광 초록 금지 — 실제보다 쉽게 잡힘
- 손으로 오리기 어려우면 도형을 100%로 인쇄해서 오리세요 — 인쇄가 손보다 정확

check_accuracy.py · 운용 전 1회 · 면적을 아는 종이 도형으로 오차 수치화

"""
validate -- ground-truth check with paper leaves of KNOWN area.
    uv run python check_accuracy.py truth.json calib.jpg
truth.json:  {"p1": 50.0}
"""
import json, sys
from leaf_measure import measure

truth = json.load(open(sys.argv[1]))
rows  = measure(sys.argv[2], debug_dir="debug")

print(f'{"plant":6}{"true":>9}{"meas":>9}{"err":>9}{"err%":>8}  ok')
print("-" * 50)
errs = []
for r in rows:
    t, m = truth.get(r["plant_id"]), r["area_cm2"]
    if t is None or m is None:
        print(f'{r["plant_id"]:6}{"-":>9}{"-":>9}{"-":>9}{"-":>8}  {r["ok"]}')
        continue
    e = m - t; ep = 100.0 * e / t
    errs.append(ep)
    print(f'{r["plant_id"]:6}{t:9.1f}{m:9.1f}{e:+9.2f}{ep:+8.1f}  {r["ok"]}')

if errs:
    mae  = sum(abs(x) for x in errs) / len(errs)
    bias = sum(errs) / len(errs)
    print("-" * 50)
    print(f"mean |err| = {mae:5.2f} %     bias = {bias:+5.2f} %")
    print("PASS" if mae < 5.0 else "FAIL")

불합격일 때 — 원인 순서 ① 오차가 전부 같은 방향이면 거의 확실히 마커입니다 — 인쇄 배율이 100%가 아니거나 marker_mm이 실측과 다름.
② 마커가 잎 평면과 다른 높이 (원근) → ③ 조명 불균일 → ④ 렌즈 왜곡(가장자리) → ⑤ 배경 반사

### 5) 왜 ExG인가 — 대안을 실제로 재봤습니다

"색 말고 외곽선을 따서 내부를 채우면 더 정확하지 않나?"는 자연스러운 의문입니다. 실제 상추 사진 한 장으로 네 방식을 돌린 결과입니다.

방식 | 면적 | 기준 대비 | 추가된 영역의 정체
① ExG 초록픽셀 (현재) | 32,000 px | 기준 | —
② 외곽선 내부 채움 | 32,209 px | +0.7% | 거의 없음
③ 볼록껍질(convex hull) | 36,516 px | +14.1% | 평균 ExG +0.03 = 흙
④ Canny 엣지→채움 | 85,988 px | +169% | 평균 ExG −0.01, 밝기 88 = 그림자

참고로 같은 사진의 영역별 정규화 ExG는 잎 +0.58 / 흙 0.00 / 붉은잎 −0.22였습니다. 분리가 깨끗합니다.

★ 결론 — 내부 채움은 이미 하고 있습니다 ②가 +0.7%밖에 안 늘었다는 게 핵심입니다. 현재 파이프라인의 형태학 CLOSE 연산이 내부 구멍을 이미 메우고 있어 외곽선을 따로 채워도 더 채울 게 없습니다. 이미 "누끼 따서 내부 마스킹한" 상태입니다.

⚠️ 색을 안 쓰면 외곽선 찾기가 시작되지 않습니다 ④가 결정적입니다. Canny는 밝기 경계만 보는데, 이 사진에서 가장 강한 경계는 잎–흙 경계가 아니라 그림자 경계였습니다. 그래서 그림자를 식물로 삼켰습니다.

"외곽선을 딴다"는 건 이미 "무엇이 식물인지" 안다는 뜻입니다. 그걸 알려주는 게 색입니다. 순서가 거꾸로입니다.

볼록껍질도 안 됩니다 — 흙을 세니까 상추 잎은 프릴처럼 갈라져 잎 사이 틈으로 흙이 보입니다. 볼록껍질은 그걸 다 메워 생물량이 아니라 점유 범위를 재게 됩니다. 추가된 영역의 ExG가 +0.03(흙 수준)인 게 증거입니다.

★ 그리고 이 실험 특유의 위험 — 채우기는 그룹 의존 편향을 만듭니다 채우기 방식은 잎의 틈 구조에 의존하는데, 그 구조가:
· 생장하며 변합니다 — 어릴 땐 촘촘, 자라면 벌어짐 → 후반 면적이 부풀려짐
· 처짐 정도에 따라 그룹 간 다릅니다 — 널뜀군이 오후에 처지면 잎이 오므라들어 틈 구조가 달라짐

즉 생물량과 무관한 그룹 의존 편향이 생깁니다. 초록 픽셀만 세는 ExG는 이 문제가 훨씬 작습니다.

ExG가 실패하는 경우 | 대책
보라색 재배등 | 흰색 등 사용
적상추 품종 | ExG 불가 → 녹색 품종만
잎이 노랗게 변함(노화·질소결핍) | ExG 하락 → 마스크 눈으로 확인
흙 표면 녹조 | 펄라이트·자갈로 덮기 (아래 참조)

이럴 때 대안은 엣지 검출이 아니라 딥러닝 분할(SAM 등)입니다. 다만 블랙박스라 "왜 이 픽셀이 포함됐나"를 설명할 수 없습니다. ExG는 숫자로 설명됩니다(잎 +0.58 / 흙 0.00). 연구 보고서에는 감사 가능한 쪽이 낫습니다.

### 6) ⚠️ 결과를 조작할 수 있는 두 가지 — 반드시 막으세요

★ ① 촬영 시각 — 오후에 찍으면 가설이 자동으로 만들어집니다 널뜀군은 밴드 바닥에서 낮에 잎이 처집니다. 하한을 "오후에 처지고 밤에 회복하는 지점"으로 잡았으니 설계상 반드시 일어납니다.

처진 잎은 위에서 보면 투영면적이 작습니다. 그런데 그건 생장이 아니라 팽압입니다.
오후에 찍으면 → 널뜀군 면적 작게 나옴 → H₁이 자동으로 "확인"됨.

대책: 새벽(또는 이른 아침) 고정 촬영. 밤새 회복해 모든 화분이 팽압을 되찾은 상태에서. 파일명에 시각을 박아 나중에 감사할 수 있게 하세요.

★ ② 녹조 — 꾸준군 면적을 부풀립니다 젖은 흙 표면에는 녹조가 낍니다. ExG는 이걸 초록 = 잎으로 판정합니다. 꾸준군은 항상 젖어 있으니 녹조가 더 많고 → 면적 과대 → 방향이 또 H₁과 같습니다.

현재 코드의 "최대 덩어리만 유지"가 흩어진 녹조는 걸러내지만, 잎에 닿아 연결되면 뚫립니다.
대책: 흙 표면을 펄라이트·자갈로 덮으세요. 증발 억제 효과는 양쪽 그룹에 동일하므로 통제를 깨지 않습니다.

조명 — 직사광을 피하면 분리가 훨씬 깨끗해집니다 위 실측에서 Canny가 실패한 근본 원인은 강한 그림자였습니다. 그림자가 진하면 어떤 방법도 흔들립니다.
확산 조명을 쓰거나 그늘막으로 직사광을 피하세요. 6주간 동일하게 유지하는 것이 절대 조건입니다.

### 7) ★ 하루 2회 촬영 — 골칫거리가 측정값이 됩니다

오후 처짐이 문제라면, 그것을 따로 재면 됩니다. 새벽과 오후 두 번 찍으면 두 가지가 분리됩니다.

계산 | 무엇을 재나
새벽 → 다음날 새벽 | RGR (생장) — 팽압이 회복된 상태끼리 비교
같은 날 새벽 − 오후 | 처짐 지수 — 생장이 아니라 수분 스트레스

처짐% = (새벽면적 − 오후면적) / 새벽면적 × 100

왜 이게 값진가 — 통제 확인 항목이 하나 늘어납니다 널뜀군이 밴드 바닥에 있을 때 처짐이 커야 합니다. 그렇게 나오면 처리가 실제로 작동했다는 독립 증거가 됩니다 — 토양수분 로그와 별개의 경로로요.
비용은 없습니다. 6주 × 2회 = 84장이라 저장도 사소합니다.

⚠️ RGR은 반드시 새벽 계열로만 새벽과 오후를 섞어 RGR을 계산하면 생장과 처짐이 뒤엉킵니다. 오후 계열로도 RGR을 낼 수는 있지만 처짐 변동이 섞여 잡음이 큽니다. 주 분석은 새벽 계열.
처짐 < 0(오후가 더 큼)이 나오면 촬영 각도·조명이 바뀐 것이니 점검하세요.

⚠ 해상도가 다르면 ROI가 통째로 어긋납니다 — 4배 오차가 아니라 측정 불능 config.json의 ROI 좌표는 calib.jpg의 좌표계로 적혀 있습니다. 예컨대 p3는 x:2270 w:900, 즉 오른쪽 끝이 3170px입니다.
만약 촬영이 2304px 폭으로 찍히면 그 좌표는 화면 밖이고, leaf_measure.py가 이렇게 뱉습니다:

[WARN] p3: ROI outside frame -- skipped

화분 6개 중 절반이 측정에서 빠집니다. 그래서 두 스크립트가 각자 숫자를 들고 있으면 안 되고, config.json의 size 한 곳만 읽어야 합니다.

### 8) ★ 자동 촬영 — plantsvc capture + systemd timer

여기서부터 손을 뗍니다. 앞에서 고정한 값 위에서 매일 2회 자동으로 찍고 재고 발행합니다. 사람이 하는 일은 주 1회 로그 확인뿐입니다. 웹 UI /camera 페이지에 다음 촬영까지의 카운트다운 · 진행 단계 · 마지막 결과 · 이력이 있습니다.

plantsnap.timer

05:50 · 15:00

→

plantsvc capture

카메라 넘겨받기 → LED → 촬영 → 측정

→

growth.jsonl

먼저 파일에

→

MQTT → DB

웹 UI /growth

2026-09 — 한 번의 촬영이 하는 일 (순서대로)

1. 서비스에 POST /api/camera/release — 미리보기가 떠 있으면 놓아 달라고 요청 (없어도 무방)
2. data/camera.lock 파일 잠금 — 다른 프로세스와 카메라를 겹쳐 쓰지 않도록. 최대 8분 대기
3. 조명은 촬영 루틴이 아니라 환경노드가 시간 창(05:45~06:15)으로 켭니다 — 촬영은 그 창 안(05:50)에서 이뤄질 뿐, 루틴에 점등 단계는 없습니다(패널 19)
4. config.capture 의 고정값으로 1장 → data/photos/raw/2026-09-11_0550.jpg
5. LED 소등 — 예외가 나도 finally 로, 프로세스가 죽어도 유닛의 ExecStopPost 로
6. leaf_measure — frame_align 밀림 보정 → ROI → ExG → Otsu → 면적
7. data/photos/growth.jsonl 에 먼저 한 줄
8. MQTT plant/tray/growth 발행 (qos=1) → planthub 가 growth 테이블에

왜 05:50 인가 — 램프가 달리면 5분 워밍업 뒤 05:55에 찍히고, 램프가 없으면 05:50에 바로 찍힙니다. 어느 쪽이든 새벽 촬영이 06:00 전에 끝나 자연광이 섞이기 전 사진이 됩니다. 시각은 config.json 의 schedule 에 있고, 바꾸면 install.sh --update 로 타이머를 다시 렌더합니다 (패널 19).
디바운스 — 같은 날 같은 phase 의 성공이 30분 안에 있으면 skipped (debounced) 로 끝납니다. Persistent=true 보충 실행과 부팅 catch-up 이 두 번 찍지 않게 하는 장치입니다. 시험 삼아 다시 찍으려면 --force.
가짜 카메라(PLANT_FAKE_HW=1) 프레임은 fake_ 접두어로 저장되고 발행되지 않습니다 — 실측 DB 에 합성 값이 섞일 길을 막습니다.

plantsvc capture — 옵션

plantsvc capture [--phase auto|dawn|pm] [--force] [--if-missing] [--no-led] [--warmup N] [--no-release]
  --phase auto     시각으로 판단 (12시 전이면 dawn)          ← plantsnap.service
  --if-missing     오늘 그 phase 가 없고 시간창 안일 때만     ← plantsnap-catchup.service (부팅 때)
  --force          30분 디바운스 무시 (시험용)
  --no-led         램프가 있어도 켜지 않음 · --warmup 0 은 워밍업 생략
  --no-release     서비스에 카메라 반납을 요청하지 않음 (서비스가 죽어 있을 때 3초 절약)
plantsvc replay    발행 못 한 growth.jsonl 줄을 다시 보냄 (사진 재촬영 없이)

파일에 먼저 적고, 그다음 발행합니다 브로커가 죽어 있어도 측정 결과는 남아야 합니다. photos/growth.jsonl 에 먼저 쓰고 그 뒤에 MQTT 로 보냅니다. 발행이 실패해도 파일에는 있으니 나중에 다시 보낼 수 있습니다 — 6주 중 하루치를 통신 문제로 잃지 않기 위한 순서입니다.

예전 스크립트 — run_capture.py 전체 소스레거시 — 1 릴리스 동안만 유지

지금은 plantsvc capture 가 같은 흐름 + LED·잠금·디바운스를 합니다hub/run_capture.py 는 plantsvc capture 로 연결되는 얇은 shim 으로만 남아 있습니다. 아래 소스는 “파일에 먼저, 발행은 나중” 같은 설계 이유를 읽기 위한 것입니다.

run_capture.py · 타이머가 자동, 하루 2회 · 촬영 → 측정 → 발행

"""
run_capture.py — 하루 2회 촬영 -> 측정 -> 발행.  systemd timer 가 부릅니다.

  uv run python run_capture.py            시각으로 phase 판단 (12시 전이면 dawn)
  uv run python run_capture.py dawn       손으로 지정
  uv run python run_capture.py --replay   발행 못 한 측정을 다시 보냄 (사진 재촬영 없이)
  sudo systemctl start plantsnap.service  ★ 실제 타이머와 같은 경로로 시험

흐름
  ① 카메라 획득 (setup_camera.py 가 떠 있으면 재시도)
  ② config.json 의 고정 설정으로 1장  ->  photos/raw/2026-08-01_0600.jpg
  ③ leaf_measure.measure()            ->  화분별 면적·윤곽  (frame_align 이 밀림 보정)
  ④ photos/growth.jsonl 에 먼저 적고   ->  ⑤ MQTT 발행

★ ④를 ⑤보다 먼저 하는 이유
  브로커가 죽어 있어도 <측정 결과는 남아야> 합니다. 발행이 실패해도 파일에는 있으므로
  나중에 다시 보낼 수 있습니다. 6주 중 하루치를 통신 문제로 잃지 않기 위한 장치입니다.
"""
import json, os, sys, time
from datetime import datetime, timezone

import leaf_measure

CFG_PATH = "config.json"
RAW, MASK, DBG = "photos/raw", "photos/mask", "photos/debug"
JSONL = "photos/growth.jsonl"

BROKER, PORT = "localhost", 1883        # ★ 브로커가 PC면 그 IP 로
TOPIC = "plant/tray/growth"

ACQUIRE_TRIES, ACQUIRE_WAIT = 3, 30     # 카메라가 안 잡히면 30초 간격으로 3번

def phase_now():
    return "dawn" if datetime.now().hour < 12 else "pm"

def shoot(path, cfg):
    """config.json 의 값 그대로 1장. 여기서 숫자를 고치지 마세요."""
    from picamera2 import Picamera2
    from libcamera import controls
    cap = cfg["capture"]

    cam = None
    for i in range(ACQUIRE_TRIES):
        try:
            cam = Picamera2(); break
        except RuntimeError as e:
            if i == ACQUIRE_TRIES - 1:
                raise RuntimeError(
                    f"카메라를 못 잡았습니다 ({e}).\n"
                    f"  setup_camera.py 가 떠 있지 않은지 확인하세요:\n"
                    f"    pgrep -af setup_camera.py ; sudo fuser -v /dev/media0") from e
            print(f"[RETRY] 카메라 사용 중 — {ACQUIRE_WAIT}초 뒤 재시도 ({i+1}/{ACQUIRE_TRIES})")
            time.sleep(ACQUIRE_WAIT)

    try:
        cam.configure(cam.create_still_configuration(main={"size": tuple(cap["size"])}))
        cam.start()                                  # ★ start() 가 먼저
        cam.set_controls({                           # 전부 수동 — 자동이면 날마다 밝기가 달라집니다
            "AfMode": controls.AfModeEnum.Manual, "LensPosition": cap["lens_position"],
            "AeEnable": False, "ExposureTime": cap["exposure_us"], "AnalogueGain": cap["gain"],
            "AwbEnable": False, "ColourGains": tuple(cap["colour_gains"]),
        })
        time.sleep(2)                                # 설정이 실제로 반영될 시간
        cam.capture_file(path)
    finally:
        try:
            cam.stop(); cam.close()
        except Exception:
            pass

def publish(payload):
    """실패해도 예외를 던지지 않습니다 — 이미 파일에는 적혀 있습니다.

    ★ qos=1 인 이유
      publish.single() 은 보내자마자 연결을 끊습니다. qos=0 이면 브로커가 처리하기 전에
      끊겨 <조용히 사라질 수> 있습니다. qos=1 은 브로커의 확인(PUBACK)을 기다린 뒤
      끊으므로, '발행 성공' 이 실제 도착을 뜻하게 됩니다.
    """
    try:
        import paho.mqtt.publish as mqtt
        mqtt.single(TOPIC, payload, qos=1, hostname=BROKER, port=PORT)
        return True, ""
    except Exception as e:
        return False, str(e)

def replay():
    """photos/growth.jsonl 중 DB 에 없는 줄만 다시 발행합니다.
    발행이 실패했던 날의 측정을 되살릴 때 씁니다 — 사진을 다시 찍지 않아도 됩니다."""
    import sqlite3
    if not os.path.exists(JSONL):
        print(f"{JSONL} 이 없습니다"); return
    try:
        with sqlite3.connect("plant.db") as c:
            last = c.execute("SELECT MAX(ts) FROM growth").fetchone()[0] or ""
    except Exception:
        last = ""
    print(f"DB 의 마지막 growth: {last or '(없음)'}")

    sent = 0
    for line in open(JSONL, encoding="utf-8"):
        line = line.strip()
        if not line:
            continue
        t = json.loads(line).get("t", "")
        if last and t <= last:
            continue
        ok, err = publish(line)
        print(f"  {t}  {'발행' if ok else '실패 ' + err}")
        sent += ok
        time.sleep(0.3)
    print(f"\n{sent}건 재발행했습니다. 몇 초 뒤 DB 를 확인하세요.")

def main():
    if "--replay" in sys.argv:
        replay(); return
    ph = sys.argv[1] if len(sys.argv) > 1 and sys.argv[1] in ("dawn", "pm") else phase_now()
    cfg = json.load(open(CFG_PATH))
    for d in (RAW, MASK, DBG):
        os.makedirs(d, exist_ok=True)

    stem = f"{datetime.now():%Y-%m-%d_%H%M}"        # 파일명은 로컬 시각 — 촬영시각 감사용
    path = f"{RAW}/{stem}.jpg"
    print(f"[{stem}] phase={ph}")

    shoot(path, cfg)
    rows = leaf_measure.measure(path, ph, DBG, MASK, cfg)
    ok = sum(r["ok"] for r in rows)

    payload = json.dumps({"t": f"{datetime.now(timezone.utc):%Y-%m-%d %H:%M:%S}",
                          "phase": ph, "img": os.path.basename(path), "plants": rows},
                         ensure_ascii=False)

    with open(JSONL, "a", encoding="utf-8") as f:     # ★ 발행보다 먼저
        f.write(payload + "\n")

    sent, err = publish(payload)
    print(f"[{stem}] {ph}  {ok}/{len(rows)} ok  ->  "
          + (f"{TOPIC} 발행" if sent else f"발행 실패({err}) — {JSONL} 에는 저장됨"))
    for r in rows:
        print(f"  {r['plant_id']:>4} {str(r['area_cm2']):>8} cm2  "
              f"{'ok' if r['ok'] else 'NG'}  {'contour' if r['contour'] else 'NO CONTOUR'}")

    if ok == 0:
        print("  ⚠ 유효한 측정이 하나도 없습니다 — photos/debug/ 를 확인하세요")
        sys.exit(1)                                   # systemd 가 failed 로 기록하게

if __name__ == "__main__":
    main()

⚠ BROKER 를 확인하세요 브로커가 PC에 있으면 localhost 가 아니라 그 PC 의 IP 입니다. Pi 로 옮긴 뒤에는 localhost 로 되돌리세요.
⚠ Tailscale 주소(100.x)를 쓰지 마세요 — 원격 장애가 측정 장애가 됩니다.

⚠ 발행은 성공했는데 DB 에 없다면 — QoS 를 보세요 publish.single() 은 보내자마자 연결을 끊습니다. qos=0 이면 브로커가 처리하기 전에 끊겨 조용히 사라질 수 있습니다. 로그에는 “발행” 이라고 찍히는데 DB 는 비어 있는, 원인을 찾기 어려운 형태입니다.
qos=1 은 브로커의 확인(PUBACK)을 기다린 뒤 끊으므로 “발행 성공” 이 실제 도착을 뜻하게 됩니다. 환경 노드처럼 연결을 유지하는 쪽은 이 문제가 없습니다 — 한 번 보내고 끊는 oneshot 에서만 생깁니다.

⚠ CREATE TABLE IF NOT EXISTS 는 컬럼을 추가하지 않습니다 스키마를 나중에 늘려도 이미 만들어진 표는 그대로입니다. 새 컬럼(예: contour)에 INSERT 하면 실패하는데 — paho 는 콜백 안의 예외를 조용히 삼킵니다.
그래서 이런 모습이 됩니다. 발행 성공, 수집기 정상 가동, 다른 토픽은 잘 쌓임, 그 표만 0행. 원인을 찾기 가장 어려운 형태입니다.

컬럼 점검 · 보완

uv run python - <<'PYEOF'
import sqlite3
need = {"plant_id":"TEXT","treat":"TEXT","phase":"TEXT","area_cm2":"REAL",
        "area_px":"INTEGER","px_per_cm":"REAL","img_file":"TEXT",
        "contour":"TEXT","ok":"INTEGER"}
c = sqlite3.connect("plant.db")
have = {r[1] for r in c.execute("PRAGMA table_info(growth)")}
for k, t in need.items():
    if k not in have:
        c.execute(f"ALTER TABLE growth ADD COLUMN {k} {t}"); print("추가:", k)
c.commit()
PYEOF

그다음 수집기에 오류 로그를 붙이세요 — 다시는 조용히 실패하지 않도록. run_collector.py 의 on_message 안, 각 ins(...) 를 감쌉니다.

    try:
        ins("growth", p, [...])
    except Exception as e:
        print(f"INSERT FAILED growth: {e}  <- {p}")

한 줄이면 journalctl -u planthub 에 이유가 남습니다.

발행 못 한 측정 되살리기 — 사진을 다시 찍지 않아도 됩니다

cd ~/plant && .venv/bin/plantsvc replay     # 또는 웹 UI /system → [미발행 측정 재발행]

data/photos/growth.jsonl 중 DB 에 없는 줄만 골라 다시 보냅니다. 가짜 카메라(fake_ 접두어) 줄은 건너뜁니다. 측정을 파일에 먼저 적어두는 이유가 여기 있습니다 — 통신 문제로 하루치를 잃지 않습니다.

systemd — 이미 등록돼 있습니다 (install.sh) · 05:50 / 15:00

systemctl list-timers plantsnap.timer              # NEXT · LAST 확인 — 시스템 시간대 기준
systemctl cat plantsnap.timer                      # OnCalendar=*-*-* 05:50:00 / 15:00:00 · Persistent=true · AccuracySec=1s
systemctl status plantsnap-catchup.service         # 부팅 때 한 번 돌고 inactive 가 정상

# 시각을 바꾸려면 — 유닛을 손으로 고치지 말고
#   웹 UI /system → config.json 편집 → "schedule": {"dawn": "05:50", "pm": "15:00"}
cd ~/plant && scripts/install.sh --update          # 타이머를 다시 렌더 · daemon-reload

예전 방식 — plantsnap.service / .timer 를 heredoc 으로 (06:00 · 15:00)레거시 — 1 릴리스 동안만 유지

이제는 install.sh 가 씁니다계정·경로가 박혀 있고, LED 워밍업·catch-up 이 없던 2026-07 판입니다.

systemd 등록 — 06:00 / 15:00

sudo tee /etc/systemd/system/plantsnap.service >/dev/null <<'EOF'
[Unit]
Description=Plant capture (dawn/pm)
After=network-online.target

[Service]
Type=oneshot
User=xparapx
WorkingDirectory=/home/xparapx/plant
ExecStart=/home/xparapx/.local/bin/uv run python run_capture.py
TimeoutStartSec=300
EOF

sudo tee /etc/systemd/system/plantsnap.timer >/dev/null <<'EOF'
[Timer]
OnCalendar=*-*-* 06:00:00
OnCalendar=*-*-* 15:00:00
Persistent=true          # 껐다 켠 사이에 지나간 시각은 부팅 후 한 번 보충

[Install]
WantedBy=timers.target
EOF

sudo systemctl daemon-reload
sudo systemctl enable --now plantsnap.timer
systemctl list-timers plantsnap        # 다음 실행 시각 확인

⚠ 손으로 돌릴 때도 서비스를 통해 실행하세요

sudo systemctl start plantsnap.service              # ○ 실제 타이머와 같은 경로 (LED·잠금·ExecStopPost 포함)
journalctl -u plantsnap -n 30 --no-pager            #   결과 확인
.venv/bin/plantsvc capture --phase auto --force     # △ 같은 코드지만 환경변수는 셸 것 — 시험용. --force 는 30분 디바운스 무시

systemd 는 PATH 와 환경변수를 물려받지 않습니다. 터미널에서 되는 것과 타이머에서 되는 것은 별개입니다. 서비스로 한 번 성공해야 6주 무인 운용이 성립합니다.

⚠ 카메라를 붙잡는 것이 남아 있지 않은지 2026-09 부터는 미리보기를 켜 두어도 촬영이 실패하지 않습니다 — plantsvc capture가 서비스에 /api/camera/release 로 놓아 달라고 한 뒤 data/camera.lock 을 잡습니다(최대 8분 대기). 실패하는 경우는 plantsvc 가 아닌 다른 프로세스(예: 예전 setup_camera.py, rpicam-hello, 직접 띄운 스크립트)가 카메라를 쥐고 있을 때뿐입니다. 저널에 camera lock held by pid N 이 남습니다.

plantsvc doctor                 # camera lock 행 확인
pgrep -af 'plantsvc|setup_camera|rpicam'
sudo fuser -v /dev/media0

예전에 만든 mjpeg.service 가 남아 있다면 반드시 정리하세요 — 부팅 때마다 카메라를 잡습니다.

sudo systemctl disable --now mjpeg
sudo rm -f /etc/systemd/system/plantsnap.service.d/camera-lock.conf
sudo systemctl daemon-reload

드롭인까지 지우는 이유 — 그 파일의 ExecStopPost 가 촬영이 끝날 때마다 mjpeg 를 다시 켭니다. 지금 구성에서는 해롭기만 합니다.

이 단계 통과 조건

- sudo systemctl start plantsnap.service 가 오류 없이 끝나고, 저널에 순서대로 shot 2026-…jpg → 화분별 ok 줄 → growth.jsonl 기록 → plant/tray/growth 발행 이 보인다. 두 번째 실행은 debounced 로 건너뛰는 것이 정상(30분 안 재촬영 방지 — --force)
- data/photos/raw/ 에 사진이, data/photos/debug/ 에 오버레이가 생긴다 (웹 UI /camera → 이력에서도 보임)
- data/photos/growth.jsonl 에 한 줄이 추가된다
- 웹 UI /growth 캐노피 시계열에 값이 뜨고, 그 카드의 DUMMY DATA 배지가 사라진다(growth 테이블에 실측 행이 생기는 순간)
- 다음 날 아침 journalctl -u plantsnap --since yesterday 가 깨끗하고, /camera 의 “마지막 촬영”이 오늘 05:50 이다

마지막 줄이 진짜 검증입니다. 등록만 하고 확인을 안 하면 조용히 실패한 채로 6주가 지나갑니다.

주 1회, 이 두 줄이면 됩니다

journalctl -u plantsnap --since '7 days ago' | grep -E 'ok|WARN|⚠|failed|debounced'
uv run python -c "import sqlite3;c=sqlite3.connect('data/plant.db');print(*c.execute('SELECT COUNT(*),MAX(ts) FROM growth'))"
# 같은 숫자가 웹 UI /system 의 DB 행 수 카드에도 있습니다

행 수가 하루 2개씩 늘고 있으면 정상입니다.

### 9) 저장 구조 — 원본은 증거입니다

저장물 | 역할
raw/ 원본 | 증거. 절대 수정하지 않음
mask/ 누끼 | 감사. 숫자가 왜 그렇게 나왔는지
debug/ 윤곽선 | 눈으로 확인
growth 테이블 | 숫자만

data/photos/                             (PLANT_DATA_DIR 아래)
├── raw/    2026-09-11_0550.jpg      원본 (수정 금지) — 가짜 카메라면 fake_ 접두어
├── mask/   2026-09-11_0550_p1.png   누끼 (이진 마스크)
├── debug/  2026-09-11_0550_p1.jpg   윤곽선 오버레이
└── growth.jsonl                     측정 기록 — 발행보다 먼저 씀

원본을 남기는 이유 — 알고리즘은 바뀔 수 있습니다 6주 뒤 "ExG 말고 다른 방법을 썼어야 했다"를 깨달아도, 원본이 있으면 전부 재처리할 수 있습니다. 원본이 없으면 실험을 다시 해야 합니다.
파일명에 날짜_시각을 넣으면 "정말 매일 같은 시각에 찍었나"가 파일 목록만 봐도 검증됩니다.

Colab 검증 노트북 leaf_area_colab.ipynb ExG 3방식 비교 · ROI 값 확인(잎/흙/붉은잎) · 전체 파이프라인 · 검증 오버레이 · ArUco cm² 환산 · 새벽/오후 처짐 지수 · 일괄 처리 → growth.csv.
리그 세팅 후 실제 사진으로 한 번 돌려보고 파라미터를 고정하세요.

◀ 이전다음 ▶

## 12대시보드

브로커가 PC든 Pi든 동일합니다. 데이터가 흐르기 시작하면 이 화면으로 실험이 아직 유효한지를 봅니다. 2026-09 부터 화면은 plantsvc 웹 UI(:8080)입니다 — Streamlit dashboard.py(:8501)는 레거시.

2026-09 — Streamlit 섹션이 어느 페이지로 갔나

예전 dashboard.py 섹션 | 웹 UI 페이지 · 카드 | 달라진 점
Environment 5종 메트릭 + 스파크라인 | /overview — 환경 KPI | 같음. 온·습 동시 0 이면 “센서 없음” 규칙도 같음
Nodes 상태 | /overview — 노드 상태 칩 | 실측 노드만 판정, 없는 노드는 회색 (규칙 동일)
Validity (Δμ 정렬 / σ 비) | /overview — Validity 카드 | analysis.tol_pp · sep_ratio 가 config.json 으로
캐노피 실루엣 · 톱니 7일 · 최근 관수 | /overview | 같음
— | /overview — 관수 기록 카드 신설 | 처리군별 누적 급수 · 화분당 · 급수 간격. “총 급수량은 통제하지 않고 결과로 본다”를 화면에 둡니다
Treatment — ρ(w) 히스토그램 · 접힌 ∩/∪ 참고 · 주간 정렬 추세 | /treatment | 같음
정오 처짐 지수 | /treatment — 처짐 지수 + 14일 타임라인 신설 | dawn·pm 짝이 없는 화분은 캡션으로 이유 표시 (KeyError 재발 없음)
Growth — dawn 시계열 · RGR ± 95% CI · Cohen's d | /growth | 같음. CSV 내보내기도 여기
— | /camera · /camera/setup 신설 | 촬영 카운트다운 · LED 상태 · 지금 촬영 · 이력 / 세팅 5단계 (패널 10·11)
— | /system 신설 | 서비스 상태 · 디스크/온도 · DB 행 수 · config.json 편집기(검증 후 저장) · 로그 · 미발행 측정 재발행

DUMMY DATA 배지 — 어느 카드가 가짜인지 항상 보입니다 config.json 의 analysis.dummy_fill 이 auto(기본)면 비어 있는 테이블(readings·soil·pump_log·growth)만 합성 데이터로 채우고, 그 테이블을 쓰는 카드마다 보라색 DUMMY DATA 배지와 “… 는 가상의 데이터입니다” 배너가 붙습니다. 실제 MQTT 행이 한 줄이라도 들어오는 순간 그 테이블은 실측으로 바뀌고 배지가 사라집니다 — 테이블 단위라 환경 노드만 있어도 환경 카드는 실측, 나머지는 가상입니다.
배지 없이 숫자가 보이면 실측입니다. 반대로 노드를 붙였는데 배지가 남아 있으면 plant/… 토픽이 planthub 에 닿지 않는 것입니다(패널 5·!). off 로 바꾸면 빈 카드는 안내 문구만 보입니다.

config.json 은 /system 에서 고칩니다 편집기가 저장 전에 plantsvc check-config 와 같은 검사를 하고, 서비스가 파일 변경을 바로 읽습니다. 다만 촬영 시각(schedule)과 LED 워밍업은 systemd 타이머에 렌더돼 있어 scripts/install.sh --update 를 한 번 더 돌려야 반영됩니다(패널 19).

레거시 — Streamlit 전용 부분 1 릴리스 동안만 유지 이 패널 아래쪽 소스에 있는 다크 테마 3중 처리(런타임 테마 옵션 · CSS 변수 · Plotly layout.font), st.plotly_chart(..., key=...) 의 key 중복 오류 회피, html_table 헬퍼는 전부 Streamlit 의 제약을 우회하던 것입니다. 웹 UI(React + ECharts)에는 해당이 없고, scripts/rollback.sh <sha> --streamlit 으로 되돌렸을 때만 의미가 있습니다.

⚠ 센서가 빠져도 노드는 0 을 발행합니다 — 결측과 진짜 0을 구분하세요 BME688(온·습·기압·VPD)이 안 붙어 있으면 대시보드에 0.00 / 0.0 / 0 이 뜹니다. 그럴듯한 숫자로 보이지만 측정값이 아닙니다.

더 위험한 것은 6주 중간에 센서가 죽는 경우입니다. 그때부터 0이 섞여 들어오는데, 평균을 내면 조용히 낮아집니다 — “재배함이 서늘해졌다”로 읽히지 센서 고장으로 읽히지 않습니다.

두 겹으로 막습니다
① 노드 펌웨어 — 센서 초기화가 실패하면 그 필드를 발행하지 마세요(또는 null). 0을 보내지 않는 것이 근본 해결입니다.
② 대시보드 — 온도와 습도가 동시에 0이면 센서 미연결로 보고 — 와 센서 없음을 표시합니다. 진짜 0°C 는 습도가 0이 아니므로 구분됩니다.

⚠ 처짐 지수는 같은 날 dawn·pm 이 짝을 이룰 때만 계산됩니다 한쪽이 없거나 ok=0 이면 그 화분은 계산에서 빠집니다. 화분 목록으로 그대로 찍으면 이렇게 죽습니다.

KeyError: "['p1'] not in index"

운용 첫날에는 거의 반드시 겪습니다 — 05:50 만 찍히고 15:00 이 아직 안 왔거나, 한쪽 사진에서 잎이 ROI 테두리에 닿아 ok=0 이 되는 경우입니다.
그래서 있는 화분만 골라 그리고, 빠진 화분은 이름과 이유를 캡션으로 알립니다. 화면이 죽는 것보다 무엇이 왜 빠졌는지 보이는 것이 낫습니다.

### 설계 결정 — 화면이 바뀌어도 그대로인 것들

아래 상자들은 Streamlit 시절에 내린 결정이지만 웹 UI 도 같은 규칙으로 구현되어 있습니다. 코드 표기만 예전 것입니다.

★ 노드가 없어도 정상 동작합니다 — 8가지 상태를 전부 검증했습니다 (웹 UI 에서는 DUMMY_FILL 상수 대신 config.json 의 analysis.dummy_fill — auto / off)

설치 상태 | dummy_fill: auto (구 DUMMY_FILL=True) | off
아무것도 없음 | 전체 화면 (가상) | 안내 문구
환경 노드만 ← 지금 | 환경 실측 + 나머지 가상 | 환경만 표시 + 안내
환경 + 카메라 | 실측 화분에 맞춰 가상 생성 | 환경 + 캐노피
전체 실측 | 전부 실측 (가상 자동 소멸)

노드를 붙이는 순간 그 섹션만 실측으로 바뀝니다. 코드를 고칠 필요가 없습니다.

⚠️ 없는 노드를 초록불로 띄우지 않습니다 Nodes 섹션은 실측 노드만 상태로 판정합니다. 아직 없는 화분은 not connected 회색으로 표시되고, 가상 데이터의 고장은 경보하지 않습니다.
상태 표시의 임무는 진짜 고장을 잡는 것이라, 가짜가 정상인 척하면 그 임무가 무너집니다.

가상 데이터는 실측 화분 목록을 따라갑니다 카메라에 a, b가 잡히면 가상 토양수분도 같은 ID로 생성됩니다. 그래서 실측 캐노피와 가상 급수가 한 화분으로 이어져 화면이 끊기지 않습니다.

★ RGR은 두 점이 아니라 회귀 기울기로 냅니다 초안은 첫날과 마지막 날만 썼습니다: (ln A끝 − ln A처음) / Δt. 간단하지만 중간 40여 장을 버리고, 끝점 사진 한 장에 결론이 걸립니다.

현재는 ln(면적) vs 일수의 최소제곱 기울기를 씁니다. 같은 데이터에 오차를 하나 심어 비교하면:

상황 | 2점 방식 | 회귀
정상 (참값 0.1400) | 0.1396 | 0.1395
끝점이 20% 작게 측정 그날 아침 흐림 | 0.1314 (−6%) | 0.1378 (−1.6%)
첫점이 25% 크게 측정 카메라가 가까웠음 | 0.1314 | 0.1378

2점 방식은 오차를 그대로 받고, 회귀는 1/4로 줄입니다. 게다가 회귀는 표준오차가 함께 나와 화분별 95% 신뢰구간을 그릴 수 있습니다 — 개체차와 그룹차를 눈으로 분리할 수 있게 됩니다.

그래서 결론은 “마지막 면적”이 아니라 /growth 페이지의 RGR + 효과크기 마지막 값만 보면 출발 크기가 섞입니다 — 6주차에 크다고 잘 자란 게 아니라 처음부터 컸을 수 있습니다. 로그 기울기는 비율이라 출발 크기와 무관합니다.

⚠️ 그리고 6주차 값이 가장 못 믿을 값입니다. 잎이 겹칠수록 투영면적이 포화하니까요. 파괴 측정(실제 잎면적·건중량·뿌리)이 최종 판정입니다.

★ 대시보드에 가정한 곡선을 그리지 않습니다 — 앵커링 방지 초안에는 반응곡선 f(w)를 오목(∩)으로 가정해 그리고 Jensen gap까지 표시했습니다. 제거했습니다.

매뉴얼(패널 ★)에서 같은 이유로 “오목을 먼저 숫자와 함께 보여주는 그림”을 뺐는데, 대시보드는 그보다 훨씬 나쁩니다:

| 매뉴얼 | 대시보드
보는 빈도 | 몇 번 | 6주간 매일
옆에 있는 것 | 설명 | 진짜 측정 데이터

실측 옆에 나란히 있으면 그것도 데이터처럼 읽힙니다. 게다가 간극의 크기까지 그리면 그 크기는 완전한 허구인데도 눈에 남습니다. assumed라는 작은 라벨은 큰 그림을 이기지 못합니다.

대신 이렇게 합니다 주 패널 = 측정된 ρ(w) 두 분포뿐. 중심은 같고 폭만 다른 것 — 그것이 이 패널의 원래 임무인 처리 검증입니다. μ와 σ를 범례에 함께 씁니다.

해석 참조는 접어서 따로(웹 UI 는 접힌 카드, Streamlit 은 expander) 둡니다 — ∩와 ∪를 대칭으로 나란히 그려 어느 쪽도 편들지 않고, “어느 쪽인지는 이 실험이 정한다”고 명시합니다. 실험이 주는 것은 곡선이 아니라 휨의 부호 하나이니까요.

색 팔레트 — 면과 선을 분리해서 씁니다

역할 | 면(막대·분포·실루엣) | 선·글자
Stable | #82C8E5 블루 | #2F7FA3
Fluctuating | #F88379 코랄 | #C9503F
배경 / 카드 | #F2EBE0 / #FBF7F1 (sand 계열)
환경 5종 | VPD #2E7D8F · Temp #D2694F · RH #5B8FA8 · CO₂ #8A9A5B · Light #E0A200

왜 두 벌인가 — 밝은 블루·코랄은 넓은 면에서는 잘 읽히지만 가는 선·작은 글자에서는 대비가 부족합니다. 그래서 채움은 원색, 윤곽선과 글자는 짙은 변형을 씁니다. 같은 색으로 보이면서 가독성이 유지됩니다.

환경 5종은 처리군 색을 피해 골랐습니다 — 블루·코랄을 환경에도 쓰면 “저 선이 처리군인가 환경인가”가 헷갈립니다.
선 굵기: 톱니 2.2 · 생장·추이 3.0 · 스파크라인 2.2 · 실루엣 테두리 2.6

예전 화면 — Streamlit dashboard.py 전체 소스 (:8501)레거시 — 1 릴리스 동안만 유지

읽는 법 화면 규칙(가상 데이터 · RGR 회귀 · 앵커링 방지 · 팔레트)은 웹 UI 가 그대로 이어받았습니다. 아래 소스는 그 규칙이 코드로 어떻게 표현됐는지 보는 용도이며, 실행은 scripts/install.sh --legacy(Streamlit 의존성 포함) 뒤 sudo systemctl enable --now plantdash 로만 하세요. 2026-07 판의 알려진 버그 — 펌프 reason 이 'verify fail'(공백)로 오는데 verify_fail 만 찾아 경보가 한 번도 울리지 않던 문제는 웹 UI 에서 정규화되어 고쳐졌습니다(패널 !).

"""
dashboard.py — Lettuce Variance Trial monitor
  uv run streamlit run dashboard.py --server.address 0.0.0.0 --server.port 8501

레이아웃은 노드 수에 맞춰 자동으로 잡힙니다 — 처리군별로 묶여 배치되므로
화분을 늘리거나 줄여도 코드를 고칠 필요가 없습니다.

■ 다크 테마 — config.toml 없이 이 파일 하나로 처리합니다. 3중으로 겁니다.
  (1) 런타임 테마 옵션   : 비공개 API. 캔버스로 그려져 CSS가 닿지 않는 요소까지 커버.
                          버전에 따라 실패할 수 있어 try 로 감쌌고, 실패해도 (2)(3)이 받칩니다.
  (2) CSS 변수 재정의    : Streamlit 내부 --text-color 등을 덮어써 기본 글자색을 화이트로.
                          인라인 색상은 건드리지 않으므로 처리군 식별색은 그대로 삽니다.
  (3) Plotly layout.font : BLANK 에 넣어 모든 그래프의 축·범례·subplot 제목을 화이트 고정.
  · st.dataframe(캔버스 렌더링)은 CSS로 색을 바꿀 수 없어 HTML 표로 대체했습니다.
"""
import json, sqlite3
import numpy as np, pandas as pd, streamlit as st
import plotly.graph_objects as go
from plotly.subplots import make_subplots
from streamlit_autorefresh import st_autorefresh

# ══════════════ 설정 ══════════════
DB        = "plant.db"
TZ        = 9            # UTC -> KST
TOL       = 2.0          # 평균 정렬 허용폭 (%p)
DUMMY_FILL = True        # ★ 비어 있는 테이블을 가상 데이터로 채워 레이아웃을 확인.
                         #    실제 운용에 들어가면 False 로 바꾸세요.
# ═════════════════════════════════

# ── (1) 런타임 테마 강제 ───────────────────────────────────
#   set_page_config 보다 먼저, 어떤 위젯보다도 먼저 호출해야 합니다.
#   OS/브라우저가 라이트모드여도 Streamlit 이 다크로 고정됩니다.
def _force_dark_theme():
    opts = {"theme.base": "dark",
            "theme.backgroundColor": "#0E1117",
            "theme.secondaryBackgroundColor": "#1A1D24",
            "theme.textColor": "#FFFFFF",
            "theme.primaryColor": "#82C8E5"}
    cfg = getattr(st, "_config", None)
    if cfg is None:
        try:
            from streamlit import config as cfg          # 구버전 경로
        except Exception:
            return
    for k, v in opts.items():
        try:
            cfg.set_option(k, v)
        except Exception:
            pass                                          # 실패해도 CSS 가 받칩니다
_force_dark_theme()

# ── 팔레트 ────────────────────────────────────────────────
#   어두운 배경 · 흰 글자.
#   라이트 테마와 명암 관계가 뒤집힙니다 — 면(막대·분포·실루엣)에는 원색을,
#   선·글자에는 원색보다 <b>더 밝은</b> 변형을 씁니다. (라이트 테마에서는 더 짙은 변형)
STABLE,   FLUCT   = "#82C8E5", "#F88379"     # 처리군 — 푸른 / 핑크 (면)
STABLE_B, FLUCT_B = "#A9DEF5", "#FFA79C"     # 선·텍스트용 (밝은 변형)
LEAF = "#A8BA72"                              # 식생 — 세이지
OK, BAD, MUT, RULE = "#7CC46A", "#F2685A", "#A79E93", "#2E323B"
INK  = "#FFFFFF"                              # 모든 그래프·표의 기본 글자색
ENV_C = dict(vpd="#4FB8CF", temp="#F08A6E", hum="#7FB8D6",
             co2="#B4C77A", lux="#F5C445")    # 환경 5종 — 처리군 색과 구분되게
LW = dict(trace=2.2, growth=3.0, spark=2.2, curve=3.0)   # 선 굵기
CT   = {"stable": STABLE,   "fluct": FLUCT}       # 면
CD   = {"stable": STABLE_B, "fluct": FLUCT_B}     # 선·글자
NAME = {"stable": "STABLE", "fluct": "FLUCTUATING"}

st.set_page_config(page_title="Lettuce Variance Trial", layout="wide")
st_autorefresh(interval=60_000, key="tick")

# ── (2) CSS ───────────────────────────────────────────────
st.markdown("""<style>
 :root, .stApp{
   --bg:#0E1117; --card:#1A1D24; --ink:#FFFFFF; --mut:#9AA1AC; --rule:#2E323B;
   /* Streamlit 내부 테마 변수를 직접 덮어씁니다. 컴포넌트 기본 글자색만 바뀌고
      인라인 style 로 준 처리군 색상은 그대로 유지됩니다. */
   --text-color:#FFFFFF!important;
   --background-color:#0E1117!important;
   --secondary-background-color:#1A1D24!important;
 }
 .stApp{background:#0E1117; color:#FFF}
 [data-testid="stHeader"]{background:transparent}
 [data-testid="stToolbar"]{color:#FFF}
 .block-container{padding-top:1.1rem;max-width:1500px}

 /* 라이트 테마에서 검게 렌더링되던 텍스트만 화이트 고정.
    광역 규칙(.stApp div{color:#FFF!important})은 쓰지 않습니다 —
    처리군 식별색·판정색까지 죽습니다. */
 [data-testid="stMetricValue"]{font-size:23px;font-family:ui-monospace,monospace;color:#FFF!important}
 [data-testid="stMetricLabel"],[data-testid="stMetricLabel"] p{
    font-size:10px;letter-spacing:.11em;text-transform:uppercase;color:#FFF!important}
 [data-testid="stCaptionContainer"],[data-testid="stCaptionContainer"] p,
 .stTabs [data-baseweb="tab"],.stTabs [data-baseweb="tab"] p,
 summary,summary p,[data-testid="stExpander"] p,[data-testid="stExpander"] summary,
 [data-testid="stAlert"] p,[data-testid="stNotification"] p,
 label,label p,.stDownloadButton button{color:#FFF!important}
 .stMarkdown p,.stMarkdown li,
 .stApp h1,.stApp h2,.stApp h4,.stApp h5,.stApp h6{color:#FFF}
 h3{font-size:11px!important;letter-spacing:.12em;text-transform:uppercase;color:var(--mut);
    margin:14px 0 4px!important;font-weight:700!important}

 .chip{display:inline-flex;align-items:center;gap:7px;background:var(--card);border:1px solid var(--rule);
       border-radius:3px;padding:5px 9px;margin-right:6px;font-size:11px;color:#FFF}
 .chip.bad{border-color:#8C3B31;background:#2B1614}
 .chip .d{width:7px;height:7px;border-radius:50%}
 .chip b{font-weight:650}
 .chip s{text-decoration:none;color:var(--mut);font-family:ui-monospace,monospace;font-size:9.5px}
 .alert{background:#2B1614;border:1px solid #6E322A;color:#FFB4A8;border-radius:3px;
        padding:7px 11px;margin:5px 0;font-size:12.5px}
 .dummy{display:inline-block;background:#2A2415;border:1px solid #6B5A28;color:#E8D9A8;
       border-radius:2px;padding:1px 7px;font-size:9.5px;font-weight:700;letter-spacing:.09em;
       margin-left:7px;vertical-align:2px}
 .grp{font-size:10px;font-weight:700;letter-spacing:.12em;color:#9AA1AC;margin:6px 0 2px}

 /* st.dataframe 대체용 표 — 캔버스가 아니라 DOM 이라 색이 확실히 잡힙니다 */
 .tbl{width:100%;border-collapse:collapse;font-size:12px;color:#FFF;background:transparent;
      margin-top:2px}
 .tbl th{text-align:left;font-size:9.5px;letter-spacing:.09em;text-transform:uppercase;
         color:#FFF;font-weight:700;border-bottom:1px solid #3A3F4A;padding:6px 9px;
         white-space:nowrap}
 .tbl td{color:#FFF;border-bottom:1px solid #22262E;padding:6px 9px;
         font-family:ui-monospace,monospace;white-space:nowrap}
 .tbl tr:hover td{background:#1A1D24}
</style>""", unsafe_allow_html=True)

# ── (3) Plotly ────────────────────────────────────────────
# 모든 그래프가 **BLANK 를 펼쳐 쓰므로, font 한 줄이면 축 눈금·범례·subplot 제목까지
# 전부 화이트로 고정됩니다. 명시적 layout.font.color 는 Streamlit 테마 템플릿보다 우선합니다.
# 배경은 투명 — 페이지의 다크 배경이 그대로 비칩니다.
BLANK = dict(paper_bgcolor="rgba(0,0,0,0)", plot_bgcolor="rgba(0,0,0,0)",
             font=dict(color=INK))

def html_table(df):
    """st.dataframe 은 <canvas> 로 그려져 CSS 로 글자색을 바꿀 수 없습니다.
    행 수가 적은 표는 DOM 으로 직접 그립니다."""
    th = "".join(f"<th>{c}</th>" for c in df.columns)
    tr = "".join("<tr>" + "".join(f"<td>{v}</td>" for v in row) + "</tr>"
                 for row in df.astype(str).itertuples(index=False))
    st.markdown(f'<table class="tbl"><thead><tr>{th}</tr></thead><tbody>{tr}</tbody></table>',
                unsafe_allow_html=True)

# BME688(온·습·기압·VPD)이 빠져도 노드는 0 을 발행합니다.
# 0 을 그대로 그리면 <센서가 없는 것>과 <진짜 0>을 구별할 수 없습니다.
# 6주 중간에 센서가 죽어도 아무도 모르게 되므로, 여기서 결측으로 판정합니다.
BME_KEYS = ("temp", "hum", "press", "vpd")

def missing(env, key):
    """이 값이 실측인지 아닌지. 결측이면 True."""
    v = env[key].tail(12)
    if v.isna().all():
        return True
    if key in BME_KEYS:                       # 온·습이 동시에 0 이면 센서 미연결
        t, hgh = env["temp"].tail(12), env["hum"].tail(12)
        if (t.abs() < 0.05).all() and (hgh.abs() < 0.05).all():
            return True
    return False

def render_env(env):
    cur = env.iloc[-1]; day = env.iloc[max(0, len(env) - 288)]
    gone = []
    for col, (lbl, key, unit, fmt, color) in zip(st.columns(5), [
            ("VPD", "vpd", "kPa", "{:.2f}", ENV_C["vpd"]),
            ("Temp", "temp", "°C", "{:.1f}", ENV_C["temp"]),
            ("RH", "hum", "%", "{:.0f}", ENV_C["hum"]),
            ("CO₂", "co2", "ppm", "{:.0f}", ENV_C["co2"]),
            ("Light", "lux", "lx", "{:,.0f}", ENV_C["lux"])]):
        with col:
            if missing(env, key):
                gone.append(lbl)
                st.metric(lbl, "—", "센서 없음", delta_color="off")
                st.plotly_chart(spark(env[key].tail(288) * 0, MUT), use_container_width=True,
                                config={"displayModeBar": False}, key=f"env_{key}")
            else:
                st.metric(lbl, fmt.format(cur[key]),
                          fmt.format(cur[key] - day[key]) if key != "lux" else None,
                          delta_color="off")
                st.plotly_chart(spark(env[key].tail(288), color), use_container_width=True,
                                config={"displayModeBar": False}, key=f"env_{key}")
    if gone:
        st.markdown(
            f'<div class="alert">! &nbsp;<b>{", ".join(gone)}</b> 가 실측이 아닙니다 — '
            f'BME688 미연결이거나 읽기 실패입니다. '
            f'<b>0 이 아니라 결측</b>으로 기록되도록 노드 펌웨어를 고치세요.</div>',
            unsafe_allow_html=True)

def spark(y, color, h=60):
    f = go.Figure(go.Scatter(y=y, mode="lines", line=dict(color=color, width=LW["spark"]),
                             hoverinfo="skip"))
    f.update_layout(height=h, margin=dict(l=0, r=0, t=0, b=0), showlegend=False,
                    xaxis=dict(visible=False), yaxis=dict(visible=False), **BLANK)
    return f

# ═══════════════ 데이터 ═══════════════
@st.cache_data(ttl=55)
def q(sql):
    try:
        with sqlite3.connect(DB) as c:
            df = pd.read_sql_query(sql, c)
    except Exception:
        return pd.DataFrame()
    if "ts" in df and len(df):
        df["ts"] = pd.to_datetime(df["ts"]) + pd.Timedelta(hours=TZ)
    return df

# ★ firmware/water_node.ino 의 RAW_ON / RAW_OFF 와 반드시 같아야 합니다.
BAND_RAW = {"stable": (1900, 1940), "fluct": (1820, 2020)}   # (젖음, 마름) raw
CAL = {"_default": (2120, 1750)}          # plant_id -> (RAW_DRY, RAW_WET)

def pct_of(raw, pid="_default"):
    dry, wet = CAL.get(pid, CAL["_default"])
    return 100.0 * (dry - raw) / float(dry - wet)

BAND = {t: (pct_of(hi), pct_of(lo)) for t, (lo, hi) in BAND_RAW.items()}

@st.cache_data(ttl=600)
def synth(roster=None, days=7, step_min=30):
    """레이아웃 확인용 가상 데이터.

    roster 가 주어지면 <b>실제 화분 ID·처리군을 그대로 따릅니다.</b>
    카메라만 붙인 상태에서도 실측 캐노피와 가상 토양수분이 <b>같은 화분으로</b> 이어집니다.
    """
    rng = np.random.default_rng(7)
    n   = days * 24 * 60 // step_min
    t0  = pd.Timestamp.now().floor("h") - pd.Timedelta(minutes=step_min * (n - 1))
    ts  = [t0 + pd.Timedelta(minutes=step_min * i) for i in range(n)]
    if roster:
        pots = [(pid, tr, *BAND.get(tr, (30, 55))) for pid, tr in sorted(roster.items())]
    else:
        pots = [(f"p{i}", t, *BAND[t]) for i, t in
                enumerate(["stable"] * 3 + ["fluct"] * 3, 1)]

    soil, pump = [], []
    for k, (pid, tr, on, off) in enumerate(pots):
        v, filling = off - rng.uniform(0, 3), False
        for i in range(n):
            hh = ts[i].hour
            rate = (0.55 if 7 <= hh < 19 else 0.12) * (1 + 0.10 * (k % 3 - 1))
            if filling:
                v += 4.5
                if v >= off: v, filling = off, False
            else:
                v -= rate * (step_min / 30) * rng.uniform(.85, 1.15)
                if v <= on:
                    filling = True
                    pump.append(dict(ts=ts[i], node=pid, plant_id=pid, treat=tr,
                                     dur_ms=int(rng.uniform(2400, 3600)),
                                     soil_before=round(v, 1), soil_after=float(off),
                                     reason="filled"))
            soil.append(dict(ts=ts[i], node=pid, plant_id=pid, treat=tr,
                             pct=round(v + rng.normal(0, .25), 2), n=30))
    soil = pd.DataFrame(soil)
    # 고장 시나리오 2종 — 경보 표시 확인용
    ids = [x[0] for x in pots]
    if len(ids) >= 5:                                       # 경보 표시 확인용
        m = (soil.plant_id == ids[4]) & (soil.ts >= ts[-12])
        soil.loc[m, "pct"] = float(soil.loc[m, "pct"].iloc[0])
    if len(ids) >= 2:
        pump.append(dict(ts=ts[-40], node=ids[1], plant_id=ids[1], treat=pots[1][1],
                         dur_ms=3000, soil_before=37.8, soil_after=38.0, reason="verify_fail"))

    def blob(R, seed, k=9):
        r = np.random.default_rng(seed)
        ph, ph2 = r.uniform(0, 6.3, 2)
        a = np.arange(0, 6.2832, .1)
        rad = R * (1 + .16 * np.sin(k * a + ph) + .09 * np.sin(2 * k * a + ph2))
        return json.dumps([[round(float(rad[i] * np.cos(a[i])), 1),
                            round(float(rad[i] * np.sin(a[i])), 1)] for i in range(len(a))])

    grow = []
    for d in range(days):
        for k, (pid, tr, *_) in enumerate(pots):
            base = (11.5 * np.exp(.145 * d) if tr == "stable" else 11.3 * np.exp(.131 * d))
            base *= 1 + rng.normal(0, .05)
            droop = rng.uniform(2, 5) if tr == "stable" else rng.uniform(9, 17)
            for phase, mult, hour in (("dawn", 1.0, 6), ("pm", 1 - droop / 100, 15)):
                area = base * mult
                grow.append(dict(ts=t0.normalize() + pd.Timedelta(days=d, hours=hour),
                                 plant_id=pid, treat=tr, phase=phase,
                                 area_cm2=round(area, 2), area_px=int(area * 900),
                                 px_per_cm=30.0, img_file="", ok=1,
                                 contour=blob(30 * np.sqrt(area / 11.5), k * 13 + 3)))
    return soil, pd.DataFrame(pump).sort_values("ts", ascending=False), pd.DataFrame(grow)

env  = q("SELECT * FROM readings ORDER BY ts")
soil = q("SELECT * FROM soil WHERE ts > datetime('now','-7 day') ORDER BY ts")
pump = q("SELECT * FROM pump_log ORDER BY ts DESC LIMIT 200")
grow = q("SELECT * FROM growth WHERE ok=1 ORDER BY ts")

def roster_of(*dfs):
    """실측 테이블에서 화분 목록(ID -> 처리군)을 모읍니다."""
    fr = [d[["plant_id", "treat"]] for d in dfs if len(d) and "plant_id" in d.columns]
    return pd.concat(fr).dropna().groupby("plant_id").treat.last().to_dict() if fr else {}

def treat_sources(soil_df, grow_df):
    """화분별 처리군을 <출처를 구분해서> 모읍니다.
       soil.treat  <- 급수 펌웨어가 보낸 값
       growth.treat<- config.json 의 rois[].treat
       roster_of() 는 둘을 합쳐 .last() 로 하나만 남깁니다. 다르면 경고 없이
       뒤쪽(config.json)이 이깁니다 -> 첫 촬영 날 그룹이 조용히 뒤집힙니다."""
    out = {}
    for src, d in (("펌웨어(soil)", soil_df), ("config.json(growth)", grow_df)):
        if len(d) and "plant_id" in d.columns:
            last = d[["plant_id", "treat"]].dropna().groupby("plant_id").treat.last()
            for pid, tr in last.items():
                out.setdefault(pid, {})[src] = tr
    return out

# 실측으로 들어온 화분·노드를 먼저 기록해 둡니다 (데모로 채우기 전에).
REAL_POTS = set(roster_of(soil, grow))
REAL_ENV  = not env.empty

FAKE = set()
if DUMMY_FILL:
    s2, p2, g2 = synth(roster_of(soil, grow) or None)      # ★ 실측 화분에 맞춰 생성
    if soil.empty: soil, _ = s2, FAKE.add("soil")
    if pump.empty: pump, _ = p2, FAKE.add("pump")
    if grow.empty: grow, _ = g2, FAKE.add("growth")
    if env.empty:
        FAKE.add("env")
        env = pd.DataFrame(dict(
            ts=soil.ts.unique(),
            temp=21 + 4 * np.sin(np.arange(soil.ts.nunique()) / 24), hum=60.0,
            press=1013.0, vpd=1.2, co2=600.0, lux=8000.0, n=30))

if soil.empty:
    # 노드가 아직 없어도 있는 것만이라도 보여줍니다.
    if env.empty:
        st.warning("No data yet. Start hub.py, then power a node.")
    else:
        st.markdown("### Environment")
        render_env(env)
        st.info("Water and camera nodes are not connected yet — those sections appear "
                "automatically once they publish. Set DUMMY_FILL = True to preview the full "
                "layout with dummy data.")
    st.stop()

BADGE = '<span class="dummy">DUMMY DATA</span>'
def head(title, fake_key=None):
    st.markdown(f"### {title}" + (BADGE if fake_key in FAKE else ""), unsafe_allow_html=True)

if FAKE:
    st.markdown(
        f'<div class="alert">! &nbsp;<b>DUMMY DATA</b> — <b>{", ".join(sorted(FAKE))}</b>'
        f'는 가상의 데이터이며 해당 노드 연결 시 실측값으로 변경 반영</div>',
        unsafe_allow_html=True)

# 처리군별 묶음 — 노드가 늘거나 줄어도 레이아웃이 따라옵니다
TREAT  = roster_of(soil, grow)                             # soil·growth 양쪽에서 수집
POTS   = sorted(TREAT)

# 처리군 라벨은 'stable' | 'fluct' 만 인정합니다.
# (통신 테스트 때 쏜 treat="A" 같은 잔여 행이 섞이면 여기서 걸립니다)
UNKNOWN = sorted({v for v in TREAT.values() if v not in ("stable", "fluct")})
if UNKNOWN:
    st.error(f"Unrecognised treatment label(s): {UNKNOWN}. "
             f"Expected 'stable' or 'fluct'. These rows are probably left over from an MQTT "
             f"test — delete them, e.g.  DELETE FROM soil WHERE treat IN "
             f"({', '.join(repr(u) for u in UNKNOWN)});")
    TREAT = {k: v for k, v in TREAT.items() if v in ("stable", "fluct")}
    POTS  = sorted(TREAT)
# ── ★ 처리군 출처 충돌 — 07-28 유형 사고를 화면에서 잡습니다 ────────────
#   같은 화분인데 펌웨어가 말하는 처리군과 config.json 이 말하는 처리군이 다르면,
#   둘 중 하나는 반드시 틀렸습니다. 어느 쪽이 틀렸는지는 데이터로 알 수 없으므로
#   (물은 펌웨어대로 주고, 라벨은 config.json 대로 붙습니다) 화면이 판단하지 않고
#   <그 화분을 그리지 않고> 사람에게 넘깁니다. 틀린 그룹으로 그린 그래프보다 낫습니다.
SRC      = treat_sources(soil, grow)
CONFLICT = {p: v for p, v in SRC.items() if len(set(v.values())) > 1}
if CONFLICT:
    rows = "".join(
        f"<tr><td><b>{p}</b></td>"
        + "".join(f"<td>{s} → <b>{t}</b></td>" for s, t in sorted(v.items()))
        + "</tr>"
        for p, v in sorted(CONFLICT.items()))
    st.markdown(
        '<div class="alert">! &nbsp;<b>처리군 불일치 — 이 화분들은 그리지 않습니다</b><br>'
        '<table style="margin:6px 0">' + rows + '</table>'
        '펌웨어와 <code>config.json</code> 이 서로 다른 처리군을 말하고 있습니다. '
        '<b>펌프 호스가 실제로 꽂힌 화분</b>을 기준으로 어느 쪽이 맞는지 정한 뒤, '
        '<code>water_node.ino</code> 의 <code>TREAT_FLUCT</code>·<code>PLANT_ID</code> 와 '
        '<code>config.json</code> 의 <code>rois[].treat</code> 를 맞추세요.<br>'
        '<b>과거 행을 지우기 전에 반드시 <code>plant.db</code> 를 백업하세요.</b>'
        '</div>', unsafe_allow_html=True)
    TREAT = {k: v for k, v in TREAT.items() if k not in CONFLICT}
    POTS  = sorted(TREAT)

GROUPS = {t: [p for p in POTS if TREAT.get(p) == t] for t in ("stable", "fluct")}
GROUPS = {t: v for t, v in GROUPS.items() if v}
NCOL   = max((len(v) for v in GROUPS.values()), default=1)
NROW   = NCOL                                              # 톱니 subplot 행 수
# 가장 최근 수신 시각 — 한 테이블에만 오래된 행이 있어도 경과시간이 음수가 되지 않게
now    = max(d.ts.max() for d in (env, soil, pump, grow) if len(d) and "ts" in d.columns)

tab_ov, tab_tx, tab_gr = st.tabs(["OVERVIEW", "TREATMENT", "GROWTH"])

# ═══════════════ OVERVIEW ═══════════════
with tab_ov:
    head("Environment", "env")
    render_env(env)

    st.markdown("### Nodes")
    chips, alerts = [], []
    def chip(name, mins, stuck=False, every=5, real=True):
        """실측 노드만 상태로 판정합니다. 없는 노드를 초록으로 띄우면 안 됩니다."""
        if not real:
            chips.append(f'<span class="chip" style="opacity:.55">'
                         f'<span class="d" style="background:#5A6169"></span>'
                         f'<b>{name}</b><s>not connected</s></span>')
            return
        bad = stuck or mins > every * 12
        c = BAD if bad else ("#E8B44A" if mins > every * 4 else OK)
        s = "value stuck" if stuck else (f"{mins}m" if mins < 60 else f"{mins//60}h {mins%60}m")
        chips.append(f'<span class="chip {"bad" if bad else ""}">'
                     f'<span class="d" style="background:{c}"></span><b>{name}</b><s>{s}</s></span>')

    chip("ENV", int((now - env.ts.max()).total_seconds() // 60), real=REAL_ENV)
    for p in POTS:
        real = p in REAL_POTS
        s = soil[soil.plant_id == p]
        tail = s.pct.tail(12)
        stuck = real and len(tail) >= 12 and tail.nunique() == 1   # 흙은 계속 마름 -> 값 고정 = 고장
        chip(p.upper(), int((now - s.ts.max()).total_seconds() // 60), stuck, real=real)
        if stuck:
            alerts.append(f"<b>{p.upper()} — value unchanged, node still transmitting.</b> "
                          f"Irrigation is running on a dead reading. Check I2C lead.")
    chip("CAM", int((now - grow.ts.max()).total_seconds() // 60) if not grow.empty else 0,
         every=720, real="growth" not in FAKE and not grow.empty)
    vf = pump[pump.reason == "verify_fail"].plant_id.unique() if "reason" in pump else []
    vf = [v for v in vf if v in REAL_POTS]                          # 데모 고장은 경보하지 않음
    if len(vf):
        alerts.append(f"<b>{', '.join(v.upper() for v in vf)} — pump ran, no moisture rise.</b> "
                      f"Node disarmed. Check tube and tank.")
    if not alerts and REAL_POTS:
        st.session_state["_ok"] = True
    st.markdown("".join(chips), unsafe_allow_html=True)
    for a in alerts:
        st.markdown(f'<div class="alert">! &nbsp;{a}</div>', unsafe_allow_html=True)

    head("Validity", "soil")
    g = soil.groupby(soil.plant_id.map(TREAT)).pct
    mu, sd = g.mean(), g.std()                 # 두 탭에서 함께 쓰므로 항상 계산
    if len(GROUPS) < 2:
        st.info("Needs both treatment groups (stable and fluctuating) to judge validity.")
    else:
        dmu   = abs(mu["stable"] - mu["fluct"])
        ratio = sd["fluct"] / sd["stable"]
        v1, v2 = st.columns([1.4, 1])
        with v1:
            st.metric("Mean alignment  Δμ = |μs − μf|", f"{dmu:.2f} %p",
                      "ALIGNED" if dmu <= TOL else "DRIFT",
                      delta_color="normal" if dmu <= TOL else "inverse")
            f = go.Figure()
            f.add_vrect(x0=mu["stable"] - TOL / 2, x1=mu["stable"] + TOL / 2,
                        fillcolor=OK, opacity=.16, line_width=0)
            for k in GROUPS:
                f.add_trace(go.Scatter(x=[mu[k]], y=[0], mode="markers+text",
                                       text=[f"{k[0].upper()} {mu[k]:.1f}"],
                                       textposition="top center",
                                       marker=dict(size=15, color=CT[k],
                                                   line=dict(color=CD[k], width=2)),
                                       textfont=dict(color=CD[k], size=12),
                                       showlegend=False))
            f.update_layout(height=110, margin=dict(l=6, r=6, t=22, b=4),
                            xaxis=dict(range=[mu.min() - 5, mu.max() + 5]),
                            yaxis=dict(visible=False, range=[-.5, .8]), **BLANK)
            st.plotly_chart(f, use_container_width=True, config={"displayModeBar": False}, key="validity_mean")
        with v2:
            st.metric("Variance ratio  σf / σs", f"{ratio:.2f} ×",
                      "SEPARATED" if ratio >= 2 else "TOO CLOSE",
                      delta_color="normal" if ratio >= 2 else "inverse")
            f = go.Figure(go.Bar(x=[sd[k] for k in GROUPS], y=[k[0].upper() for k in GROUPS],
                                 orientation="h",
                                 marker=dict(color=[CT[k] for k in GROUPS],
                                             line=dict(color=[CD[k] for k in GROUPS], width=1.5)),
                                 text=[f"σ {sd[k]:.2f}" for k in GROUPS], textposition="outside",
                                 textfont=dict(color=INK)))
            f.update_layout(height=110, margin=dict(l=6, r=40, t=8, b=4), showlegend=False,
                            xaxis=dict(visible=False), **BLANK)
            st.plotly_chart(f, use_container_width=True, config={"displayModeBar": False}, key="validity_var")

    # ── 캐노피 오버레이 : 처리군당 한 줄 ──
    head("Canopy projected area — 1 d ago → now", "growth")
    dawn = grow[grow.phase == "dawn"] if "phase" in grow else grow
    if dawn.empty or "contour" not in dawn:
        st.caption("Waiting for camera. leafcv.py must publish `contour`.")
    else:
        for treat, members in GROUPS.items():
            st.markdown(f'<div class="grp" style="color:{CD[treat]}">{NAME[treat]}</div>',
                        unsafe_allow_html=True)
            cols = st.columns(NCOL)                    # 군끼리 열 너비를 맞춤
            for col, p in zip(cols, members):
                d = dawn[(dawn.plant_id == p)].dropna(subset=["contour"])
                if len(d) < 2:
                    col.caption(f"{p.upper()} — not enough frames"); continue
                d = d.sort_values("ts")
                new = d.iloc[-1]
                # 겹쳐 그리는 것은 <하루 전>. 하루면 차이가 작지만 그날그날의
                # 변화를 본다. 하루 전 프레임이 없으면 가장 가까운 이전 것을 쓴다.
                older = d[d.ts <= new.ts - pd.Timedelta(days=1)]
                old = older.iloc[-1] if len(older) else d.iloc[0]
                gap_d = (new.ts - old.ts).total_seconds() / 86400
                gain = 100 * (new.area_px - old.area_px) / old.area_px

                # 캡션은 <초기 시점 대비>. 하루 변화는 작아 눈에 안 띄므로,
                # 실험 시작 이래 얼마나 자랐는지를 숫자로 따로 보여준다.
                base = d.iloc[0]
                span_d = (new.ts - base.ts).total_seconds() / 86400
                tot = (100 * (new.area_px - base.area_px) / base.area_px
                       if base.area_px else float("nan"))
                c = CT[treat]
                f = go.Figure()
                # 어두운 배경에서는 낮은 불투명도가 더 많이 죽습니다 — 3d 전 실루엣을 조금 올렸습니다.
                for row, op, w in [(old, .34, 0), (new, .72, 2.6)]:
                    xy = np.array(json.loads(row.contour))
                    f.add_trace(go.Scatter(x=xy[:, 0], y=xy[:, 1], fill="toself", fillcolor=c,
                                           opacity=op, mode="lines",
                                           line=dict(color=CD[treat], width=w), hoverinfo="skip"))
                lim = float(np.abs(np.array(json.loads(new.contour))).max()) * 1.12
                f.update_layout(height=150, margin=dict(l=0, r=0, t=22, b=0), showlegend=False,
                                title=dict(text=f"<b>{p.upper()}</b>  "
                                                f"<span style='color:{CD[treat]}'>{gain:+.0f}%</span>"
                                                f"<span style='color:{MUT};font-size:10px'>"
                                                f"  {gap_d:.1f}일</span>",
                                           font=dict(size=12, color=INK), x=0, y=.97),
                                xaxis=dict(visible=False, range=[-lim, lim]),
                                yaxis=dict(visible=False, range=[-lim, lim], scaleanchor="x"), **BLANK)
                col.plotly_chart(f, use_container_width=True, config={"displayModeBar": False},
                                 key=f"canopy_{treat}_{p}")
                col.caption(f"초기 {base.area_cm2:.1f} → {new.area_cm2:.1f} cm² "
                            f"({tot:+.0f}% · {span_d:.1f}일)")

    # ── 톱니 : 좌 STABLE / 우 FLUCTUATING ──
    head("Wetting–drying cycles — 7 d", "soil")
    if not GROUPS:
        st.info("No pots with a recognised treatment yet.")
        st.stop()
    nrow = max(len(v) for v in GROUPS.values())
    # 예전 range=[15,68] 은 synth() 가짜데이터(22~62)용이라 실제 fluct(27~81)가 잘렸습니다.
    lo = min([soil.pct.min()] + [b[0] for b in BAND.values()])
    hi = max([soil.pct.max()] + [b[1] for b in BAND.values()])
    if not np.isfinite(lo) or not np.isfinite(hi) or hi <= lo:
        lo, hi = 20.0, 85.0
    pad = max(2.0, (hi - lo) * .06)
    YR = [max(0.0, lo - pad), min(100.0, hi + pad)]
    f = make_subplots(rows=nrow, cols=len(GROUPS), shared_xaxes=True, shared_yaxes=True,
                      vertical_spacing=.02, horizontal_spacing=.05,
                      subplot_titles=[NAME[t] for t in GROUPS] + [""] * (nrow - 1) * len(GROUPS))
    for ci, (treat, members) in enumerate(GROUPS.items(), 1):
        blo, bhi = BAND[treat]
        for ri, p in enumerate(members, 1):
            f.add_hrect(y0=blo, y1=bhi, row=ri, col=ci, layer="below",
                        fillcolor=CD[treat], opacity=.10, line_width=0)
            s = soil[soil.plant_id == p]
            f.add_trace(go.Scatter(x=s.ts, y=s.pct, mode="lines",
                                   line=dict(color=CD[treat], width=LW["trace"]), showlegend=False,
                                   name=p.upper()), row=ri, col=ci)
            f.update_yaxes(title_text=f"<b>{p.upper()}</b>", range=YR,
                           title_font=dict(size=10, color=CD[treat]),
                           showticklabels=(ci == 1), row=ri, col=ci)
    f.update_layout(height=118 * nrow + 30, margin=dict(l=46, r=10, t=26, b=24), **BLANK)
    f.update_xaxes(gridcolor=RULE); f.update_yaxes(gridcolor=RULE)
    for a in f.layout.annotations: a.font.size = 11; a.font.color = INK
    st.plotly_chart(f, use_container_width=True, config={"displayModeBar": False}, key="soil_saw")

    head("Recent irrigation", "pump")
    if not pump.empty:
        t = pump.head(5).copy()
        t["Ago"]    = ((now - t.ts).dt.total_seconds() // 3600).astype(int).astype(str) + "h"
        t["Pot"]    = t.plant_id.str.upper()
        t["Trt"]    = t.plant_id.map(TREAT).str.upper()
        t["Pump"]   = (t.dur_ms / 1000).round(1).astype(str) + "s"
        t["Before"] = t.soil_before.round(1)
        t["After"]  = t.soil_after.round(1)
        t["Rise"]   = (t.soil_after - t.soil_before).round(1)
        t["Reason"] = t.reason
        html_table(t[["Ago", "Pot", "Trt", "Pump", "Before", "After", "Rise", "Reason"]])

# ═══════════════ TREATMENT ═══════════════
with tab_tx:
    head("Soil moisture distribution ρ(w) — measured", "soil")
    f = go.Figure()
    for k in GROUPS:
        v = soil[soil.plant_id.map(TREAT) == k].pct
        f.add_trace(go.Histogram(
            x=v, nbinsx=44, histnorm="probability",
            marker=dict(color=CT[k], line=dict(color=CD[k], width=1)),
            opacity=.55 if k == "fluct" else .70,
            name=f"{NAME[k].title()}  μ={v.mean():.1f}  σ={v.std():.1f}"))
    if len(GROUPS) == 2:
        f.add_vline(x=float(np.mean([mu[k] for k in GROUPS])),
                    line=dict(color=INK, width=1, dash="dot"),
                    annotation_text="E[w]", annotation_position="top",
                    annotation_font=dict(color=INK))
    f.update_layout(height=300, barmode="overlay", margin=dict(l=52, r=16, t=8, b=42),
                    legend=dict(orientation="h", y=1.12, font=dict(size=11, color=INK)),
                    xaxis_title="soil moisture w (%)", yaxis_title="ρ(w)", **BLANK)
    f.update_yaxes(gridcolor=RULE); f.update_xaxes(gridcolor=RULE)
    st.plotly_chart(f, use_container_width=True, config={"displayModeBar": False}, key="dist")
    st.caption("Treatment check: same centre, different width. This is measured data.")

    # ── 해석 참조: 어느 쪽인지는 실험이 정합니다 (데이터 아님) ──
    with st.expander("How to read the result — reference, not data"):
        w = np.linspace(15, 70, 200)
        lo, hi = float(soil.pct.quantile(.05)), float(soil.pct.quantile(.95))
        m = float(soil.pct.mean())
        cc = make_subplots(rows=1, cols=2, horizontal_spacing=.09, subplot_titles=[
            "∩ concave  →  FLUCTUATING LOSES", "∪ convex  →  FLUCTUATING GAINS"])
        for ci, fw in enumerate(
                [100 * (1 - np.exp(-2.6 * np.clip((w - 18) / 44, 0, None))),
                 100 * np.clip((w - 15) / 55, 0, None) ** 2.2], 1):
            gm  = float(np.interp(m, w, fw))
            ch  = float(np.mean([np.interp(lo, w, fw), np.interp(hi, w, fw)]))
            col = STABLE_B if ci == 1 else FLUCT_B
            cc.add_trace(go.Scatter(x=w, y=fw, mode="lines",
                                    line=dict(color=MUT, width=LW["curve"]),
                                    showlegend=False), row=1, col=ci)
            cc.add_trace(go.Scatter(x=[lo, hi], y=[np.interp(lo, w, fw), np.interp(hi, w, fw)],
                                    mode="lines", line=dict(color=MUT, width=1.2, dash="dash"),
                                    showlegend=False), row=1, col=ci)
            cc.add_trace(go.Scatter(x=[m, m], y=[ch, gm], mode="lines+markers",
                                    line=dict(color=col, width=2.5), marker=dict(size=8),
                                    showlegend=False), row=1, col=ci)
        cc.update_layout(height=230, margin=dict(l=40, r=14, t=34, b=30), **BLANK)
        cc.update_xaxes(title_text="w (%)", gridcolor=RULE)
        cc.update_yaxes(title_text="growth", gridcolor=RULE, row=1, col=1)
        for a in cc.layout.annotations: a.font.size = 11; a.font.color = INK
        st.plotly_chart(cc, use_container_width=True, config={"displayModeBar": False}, key="curves")
        st.caption("Both shapes are drawn on purpose. **Which one lettuce follows is unknown — "
                   "that is what this experiment measures.** Neither curve is fitted to your data; "
                   "the experiment returns the *sign* of the curvature, not the curve.")

    c1, c2 = st.columns(2)
    with c1:
        head("Mean alignment trend", "soil")
        wk = soil.copy(); wk["week"] = wk.ts.dt.isocalendar().week
        wk = wk.groupby(["week", wk.plant_id.map(TREAT)]).pct.mean().unstack()
        f = go.Figure()
        for k in GROUPS:
            if k in wk:
                f.add_trace(go.Scatter(x=wk.index.astype(str), y=wk[k], mode="lines+markers",
                                       line=dict(color=CD[k], width=LW["growth"]), name=NAME[k].title()))
        f.update_layout(height=210, margin=dict(l=40, r=10, t=6, b=28),
                        legend=dict(orientation="h", y=1.14, font=dict(size=10, color=INK)), **BLANK)
        f.update_yaxes(gridcolor=RULE); f.update_xaxes(gridcolor=RULE)
        st.plotly_chart(f, use_container_width=True, config={"displayModeBar": False}, key="align_trend")
    with c2:
        head("Midday droop — (dawn − pm) / dawn", "growth")
        if "phase" in grow and {"dawn", "pm"} <= set(grow.phase.unique()):
            g2 = grow.copy(); g2["day"] = g2.ts.dt.date
            pv = g2.pivot_table(index=["day", "plant_id"], columns="phase", values="area_px").dropna()
            pv["droop"] = 100 * (pv.dawn - pv.pm) / pv.dawn
            last = pv.reset_index().groupby("plant_id").last().reset_index()
            # 처짐은 같은 날 dawn·pm 이 <둘 다> 있어야 계산됩니다.
            # 한쪽이 없거나 ok=0 이면 그 화분은 여기 없습니다 -> .loc 로 찍으면 KeyError.
            have = [p for p in POTS if p in set(last.plant_id)]
            last = last.set_index("plant_id").loc[have].reset_index()      # 처리군 순서 유지
            missing = [p for p in POTS if p not in have]
            f = go.Figure(go.Bar(
                x=last.plant_id.str.upper(), y=last.droop,
                marker=dict(color=[CT[TREAT[p]] for p in last.plant_id],
                            line=dict(color=[CD[TREAT[p]] for p in last.plant_id], width=1.5)),
                text=last.droop.round(1), textposition="outside",
                textfont=dict(color=INK)))
            f.update_layout(height=210, margin=dict(l=40, r=10, t=6, b=28), showlegend=False,
                            yaxis_title="%", **BLANK)
            f.update_yaxes(gridcolor=RULE)
            if len(last):
                st.plotly_chart(f, use_container_width=True, config={"displayModeBar": False}, key="droop")
            if missing:
                st.caption(f"{', '.join(p.upper() for p in missing)} — 같은 날 dawn·pm 이 "
                           f"모두 필요합니다 (한쪽이 없거나 ok=0)")
            if not len(last):
                st.caption("아직 dawn·pm 이 짝을 이룬 날이 없습니다.")
        else:
            st.caption("Needs both dawn and pm captures.")

# ═══════════════ GROWTH ═══════════════
with tab_gr:
    head("Canopy area — dawn series", "growth")
    dawn = grow[grow.phase == "dawn"] if "phase" in grow else grow
    if dawn.empty:
        st.caption("No dawn captures yet.")
    else:
        f = go.Figure()
        for p in POTS:
            d = dawn[dawn.plant_id == p]
            f.add_trace(go.Scatter(x=d.ts, y=d.area_cm2, mode="lines+markers", name=p.upper(),
                                   line=dict(color=CD[TREAT[p]], width=LW["growth"]),
                                   marker=dict(size=6)))
        f.update_layout(height=330, margin=dict(l=46, r=14, t=8, b=30), yaxis_title="cm²",
                        legend=dict(orientation="h", y=1.1, font=dict(size=10, color=INK)), **BLANK)
        f.update_yaxes(gridcolor=RULE); f.update_xaxes(gridcolor=RULE)
        st.plotly_chart(f, use_container_width=True, config={"displayModeBar": False}, key="canopy_series")

        head("Relative growth rate — log-slope over all dawn frames", "growth")
        rows = []
        for p in POTS:
            d = dawn[dawn.plant_id == p].sort_values("ts").dropna(subset=["area_cm2"])
            d = d[d.area_cm2 > 0]
            if len(d) < 3:
                continue
            t = (d.ts - d.ts.iloc[0]).dt.total_seconds().to_numpy() / 86400
            y = np.log(d.area_cm2.to_numpy())
            # ln(면적) vs 일수의 최소제곱 기울기 = RGR. 끝점 하나에 휘둘리지 않음.
            slope, intercept = np.polyfit(t, y, 1)
            resid = y - (slope * t + intercept)
            se = float(np.sqrt((resid ** 2).sum() / (len(t) - 2) /
                               ((t - t.mean()) ** 2).sum())) if len(t) > 2 else np.nan
            r2 = 1 - (resid ** 2).sum() / ((y - y.mean()) ** 2).sum()
            rows.append(dict(pot=p, treat=TREAT[p], rgr=float(slope), se=se, r2=float(r2),
                             n=len(t)))
        r = pd.DataFrame(rows)

        if len(r) and r.treat.nunique() == 2:
            a, b = r[r.treat == "stable"].rgr, r[r.treat == "fluct"].rgr
            pooled = np.sqrt((a.std() ** 2 + b.std() ** 2) / 2)
            d_eff  = (a.mean() - b.mean()) / pooled if pooled else np.nan
            c = st.columns(3)
            c[0].metric("RGR Stable", f"{a.mean():.4f} /d",
                        f"sd {a.std():.4f} · n={len(a)}", delta_color="off")
            c[1].metric("RGR Fluctuating", f"{b.mean():.4f} /d",
                        f"sd {b.std():.4f} · n={len(b)}", delta_color="off")
            c[2].metric("Cohen's d", f"{d_eff:.2f}",
                        "large" if abs(d_eff) >= .8 else
                        "medium" if abs(d_eff) >= .5 else "small", delta_color="off")

            # 화분별 RGR ± 95% CI — 개체차와 그룹차를 눈으로 분리
            f = go.Figure()
            for k in GROUPS:
                sub = r[r.treat == k]
                f.add_trace(go.Scatter(
                    x=sub.rgr, y=sub.pot.str.upper(), mode="markers",
                    error_x=dict(type="data", array=1.96 * sub.se, color=CD[k], thickness=2),
                    marker=dict(size=12, color=CT[k], line=dict(color=CD[k], width=2)),
                    name=NAME[k].title()))
                f.add_vline(x=float(sub.rgr.mean()), line=dict(color=CD[k], width=1.6, dash="dot"))
            f.update_layout(height=190, margin=dict(l=46, r=16, t=6, b=34),
                            xaxis_title="RGR (/day)  — dotted line = group mean",
                            legend=dict(orientation="h", y=1.22, font=dict(size=10, color=INK)), **BLANK)
            f.update_xaxes(gridcolor=RULE); f.update_yaxes(gridcolor=RULE)
            st.plotly_chart(f, use_container_width=True, config={"displayModeBar": False}, key="rgr_ci")

            worst = r.r2.min()
            st.caption(
                f"Slope of ln(area) vs day, least squares over all dawn frames "
                f"(worst fit R²={worst:.3f}). "
                f"With n=3, p>0.05 is **not** 'no effect' — report the effect size. "
                f"Projected area saturates as leaves overlap, so the week-6 harvest "
                f"(true leaf area, dry mass, roots) is the arbiter.")
        elif len(r):
            st.caption("Only one treatment group so far — no comparison yet.")

with st.expander("Export CSV"):
    for nm, df in [("readings", env), ("soil", soil), ("pump_log", pump), ("growth", grow)]:
        st.download_button(nm + (" (dummy)" if nm.split("_")[0] in FAKE else ""),
                           df.to_csv(index=False), f"{nm}.csv", "text/csv", key=nm)

실행

uv run streamlit run dashboard.py --server.address 0.0.0.0 --server.port 8501
# http://rasp.local:8501  또는 PC라면 http://localhost:8501

◀ 이전다음 ▶

## 18웹 UI (plantsvc)

Streamlit 대시보드(:8501)와 setup_camera.py(:8000)를 하나의 서비스 plantsvc(:8080)로 합쳤습니다. 화면은 React, 뒤는 FastAPI. 이 패널은 무엇이 어디에 있고, 왜 그렇게 나눴는지입니다.

### 1) 구조 — 프로세스는 셋, 포트는 둘

환경 노드 ──┐                                        Raspberry Pi
급수 노드 ──┴─ WiFi · MQTT ─→ mosquitto (:1883) ─→ run_collector.py ──→ data/plant.db   (planthub.service — 유일한 writer)
                                     ↑                                        │ 읽기 전용
                                     │ plant/tray/growth (qos=1)              ▼
        plantsnap.timer (05:50·15:00) → plantsvc capture ─→ growth.jsonl   plantsvc serve (:8080, plantsvc.service)
                                     LED → 촬영 → 측정                       ├─ 웹 UI (React, web/dist)     /overview /treatment /growth /camera /camera/setup /system
                                     data/camera.lock 으로 조정 ←──────────┤─ /api/*  · /ws (실시간 이벤트)
                                                                            ├─ 카메라 미리보기 MJPEG (보는 사람이 있을 때만)
                                                                            └─ data/events.db (서비스 자체 기록 · 촬영 잡 · 설정 변경)

| 2026-07 판 | 2026-09 판
대시보드 | Streamlit dashboard.py :8501 | plantsvc :8080 — 하나의 FastAPI + React
카메라 세팅 | setup_camera.py :8000 (손으로 띄움)
촬영 | run_capture.py + 드롭인으로 미리보기 내림 | plantsvc capture — 서비스가 카메라를 스스로 넘겨줌
설치 | hub/ 평탄화 + 유닛 heredoc | 클론 그대로 + install.sh 템플릿 렌더
데이터 | ~/plant/*.db | ~/plant/data/ (PLANT_DATA_DIR)
열린 포트 | 1883 · 8501 · 8000 | 1883 · 8080 뿐

왜 planthub 는 그대로 두고 plantsvc 를 옆에 붙였나 plant.db 에 쓰는 프로세스를 하나로 유지하기 위해서입니다. 웹 서비스가 죽거나 재배포되는 동안에도 수집은 멈추지 않아야 하고, SQLite 는 writer 가 둘이면 잠금 오류가 납니다. 그래서 plantsvc 는 plant.db 를 읽기만 하고, 자기 기록은 events.db 에 따로 씁니다. 촬영 결과도 직접 넣지 않고 MQTT 로 발행해 planthub 를 거칩니다 — 데이터가 들어오는 길이 노드와 똑같습니다.

### 2) 페이지

경로 | 무엇을 보나 | 패널
/overview | 환경 5종 KPI + 스파크라인 · 노드 상태 칩 · Validity(Δμ 정렬 / σ 비) · 캐노피 실루엣(어제→오늘) · 습윤–건조 톱니 7일 · 최근 관수 · 관수 기록(처리군별 누적 급수 · 간격) | 12
/treatment | ρ(w) 히스토그램 · 접힌 해석 참고 곡선 ∩/∪ · 주간 평균 정렬 추세 · 정오 처짐 지수 + 14일 타임라인 | 12 · 16
/growth | 캐노피 dawn 시계열 · RGR 포레스트 플롯(95% CI) · Cohen's d · CSV 내보내기 | 12 · 17
/camera | 다음 촬영 카운트다운 · 촬영 진행 단계(lock → led_on → warmup → capture → measure → publish) · 마지막 결과 · LED 상태(미설치 안내) · 지금 촬영 · 이력 | 11 · 19
/camera/setup | 실시간 미리보기 위에 ① 노출·초점 ② 배율 ③ ROI ④ 처리군 ⑤ 기준 사진 + ROI 재중심 + 밀림 판정 | 10
/system | 서비스 상태 · 디스크/온도 · DB 행 수 · config.json 편집 · 로그 · 미발행 측정 재발행 · 버전/git rev | 8 · 20

모바일 폭에서는 카드가 한 열로 쌓이고 아래 탭바로 페이지를 옮깁니다. 브라우저 메뉴의 홈 화면에 추가로 PWA 설치가 되어 카메라 옆에서 폰으로 세팅하기에 맞춰져 있습니다.

### 3) 더미 데이터 모드 — 노드 없이도 전 화면이 돕니다

규칙은 하나 — 비어 있는 테이블만, 배지를 달고

키 · 명령 | 하는 일
analysis.dummy_fill: "auto" (기본) | 행이 0 개인 테이블만 합성 데이터로 채우고 그 카드에 DUMMY DATA 배지. 실측 행이 생기면 그 테이블부터 실측
analysis.dummy_fill: "off" | 합성 없음. 빈 카드는 안내 문구
plantsvc seed [--days 7] | PC 개발용 — 통째로 더미인 data/plant.db 를 만듭니다(node='dummy'). 기존 DB 가 있으면 거부, --force 로 덮어씀. Pi 에서는 쓰지 마세요
PLANT_FAKE_HW=1 | 가짜 카메라(합성 잎 프레임) · LED 는 noop. 세팅 5단계와 촬영 루틴을 시험할 수 있지만 가짜 프레임은 발행되지 않습니다(fake_ 접두어 · --allow-fake-publish 는 시험 전용)

합성 값이 실측 DB 에 섞일 수 있는 길은 seed 와 --allow-fake-publish 두 개뿐이고, 둘 다 사람이 손으로 쳐야 합니다.

### 4) API · WebSocket — 화면이 쓰는 것과 같은 것

엔드포인트 | 내용
GET /api/health · /api/system/status | 버전 · git rev · 카메라 드라이버 · dummy_fill · 서비스/디스크/온도 (deploy.ps1 의 헬스 체크가 봄)
GET /api/summary · /api/env · /api/soil · /api/pump · /api/growth | 대시보드 데이터 (응답에 어느 테이블이 더미인지 표시)
GET /api/export/{table}.csv | readings · soil · pump_log · growth CSV
GET /api/camera/status · /stream.mjpg · /frame.jpg · /drift | 카메라 상태(preview: live / paused_capture / unavailable, lock_holder_pid) · 미리보기 · 정지 프레임 · 밀림 판정
POST /api/camera/actions/{name} · /api/camera/release | 세팅 버튼(auto · point · findleaf · grid · shuffle · shoot …) · 카메라 반납 (capture CLI 가 부름)
GET /api/capture/schedule · /status · /jobs · POST /api/capture/run (202) · /cancel · /replay | 다음 촬영 시각 · 진행 중 잡 · 이력 · 지금 촬영 · 취소 · 재발행
GET /api/led · POST /api/led/on · /off · /test | LED 상태·수동 점등. 미설치면 409 led_not_installed
GET /api/config · PUT /api/config · /api/config/check | config.json 읽기 · 검증 후 저장 · 모순 검사
GET /api/system/logs · /api/events | journal 꼬리 · events.db
WS /ws | 촬영 단계 · 설정 변경 · 카메라 상태를 실시간 push (화면의 카운트다운·진행 바가 이걸 봅니다)

curl -s http://raspi.local:8080/api/system/status | python3 -m json.tool
curl -s http://raspi.local:8080/api/capture/schedule
curl -s -X POST http://raspi.local:8080/api/capture/run -H 'content-type: application/json' -d '{"phase":"auto","force":true}'

### 5) PC 에서 하드웨어 없이 돌리기

Windows / macOS / Linux — 노드도 카메라도 없이

git clone https://github.com/xparapx/Plant_Growth_Monitoring_Demo.git && cd Plant_Growth_Monitoring_Demo
uv sync --group dev
PLANT_FAKE_HW=1 uv run plantsvc serve        # http://localhost:8080 — 더미 데이터 + 가짜 카메라 (PowerShell: $env:PLANT_FAKE_HW='1'; uv run plantsvc serve)

# 화면을 고칠 때 — Vite 개발 서버 (/api 는 :8080 으로 프록시)
cd web && npm ci && npm run dev            # http://localhost:5173

uv run pytest                                # 하드웨어 없이 도는 테스트
uv run plantsvc seed --days 14               # 통째로 더미인 data/plant.db (있으면 --force)

서비스가 아닌 정적 데모 — GitHub Pages /app/ https://xparapx.github.io/Plant_Growth_Monitoring_Demo/app/ 는 같은 React 화면을 목(mock) API 위에 올린 것입니다. 서버 없이 화면만 보는 용도라 버튼(촬영·저장)은 흉내만 냅니다.

이 패널 통과 조건

- http://<pi>:8080/ 가 열리고 /system 에 planthub · plantsvc · plantsnap.timer 가 초록
- 폰(같은 WiFi, IP 로)에서도 열리고 홈 화면에 추가된다
- 노드가 붙은 카드에는 DUMMY DATA 배지가 없다, 아직 없는 카드에는 있다
- ss -ltn 에 1883 · 8080 만 있고 8501 · 8000 은 없다

◀ 이전다음 ▶

## 19LED 촬영 조명 (자리)

새벽 촬영 조명은 환경노드(UNO R4 WiFi)의 RGBW 네오픽셀 61구 스트립(핀 9 직결, 백색은 W 칩만 점등)이 맡습니다 — 노드가 자체 타이머로 05:45 점등 → 06:15 소등 하고, 파이는 그 창 안(05:50)에서 평소처럼 찍기만 합니다. 펌웨어는 plant_env_r4wifi.ino 의 USE_LIGHT=1 블록(lightTick)에 들어 있습니다. hub 쪽 GPIO LED 훅은 2026-09-19 에 제거되어 조명 관련 코드·설정은 노드 펌웨어에만 있습니다.

왜 조명이 필요한가 — 패널 11 의 “날씨가 섞이는” 문제 노출을 고정했으니 어두운 아침엔 사진이 어둡고, Otsu 임계값이 올라 마스크가 잎 안쪽으로 파고듭니다(같은 잎이 −18%). 촬영 시각을 고정하는 것보다 조명을 고정하는 것이 확실합니다. 새벽 촬영 시각에 백색 LED 가 켜져 있으면 6주 내내 같은 빛으로 찍힙니다. 보라색 재배등은 안 됩니다 — G 성분이 없어 ExG 가 작동하지 않습니다. 스트립은 RGBW(전용 백색 칩)라 W 칩만 켜서 넓은 스펙트럼의 백색을 얻습니다(2026-09-28 RGB 4구×2 에서 교체) — 설치 후 새벽 시험 촬영으로 ExG 마스크가 안정한지 확인합니다.

설계 변경 (2026-09) — 파이 GPIO + 릴레이 → 환경노드 네오픽셀 독립 운용 처음 계획은 파이 GPIO(BCM 17) + 릴레이/MOSFET 모듈로 촬영 루틴이 직접 켜고 끄는 것이었습니다. 네오픽셀은 LED 마다 드라이버가 내장되어 스위칭 소자(릴레이/MOSFET)가 필요 없고, 환경노드에 데이터 핀 직결이 됩니다. 그래서 조명을 노드로 옮겼고, 기본 동작은 노드가 NTP 로 시계를 맞춰 시간 기반으로 독립 점등하는 것입니다. 파이는 영상 처리·백엔드·프론트엔드 hub 역할만 합니다. hub 쪽 GPIO LED 훅(config led 절 · plantsvc led CLI · 촬영 루틴의 점등/워밍업 단계)은 2026-09-19 에 전부 제거했습니다. 대가: 부팅 보충 촬영(패널 19-5)과 수동 촬영은 점등 창 밖이면 조명 없이 찍힙니다 — 그날 데이터는 메타데이터로 걸러냅니다.

### 1) 제어 경로 — 시간 창 + 원격 명령

노드 펌웨어가 조명의 주인입니다 시간 창(05:45~06:15) 점등이 최우선이고 어떤 명령으로도 꺼지지 않습니다(실험 데이터 보호). 창 밖에는 원격 명령으로 켤 수 있습니다 — 웹 UI 카메라 설정의 [💡 조명 켬/끔] 버튼이 plant/light/set 토픽("1"/"0")을 발행하고, 노드가 받아서 점등합니다. 명령 점등은 30분 뒤 무조건 자동 소등(펌웨어 워치독)이라 켜 두고 잊어도 남지 않습니다. 시리얼 모니터에서 1/0 을 쳐도 같습니다. 상태는 plant/<id>/light 로 보고됩니다.

### 2) 시각표 — 스트립 유무에 따라

| 노드 점등 | 파이 타이머 | 촬영 | 노드 소등 | TimeoutStartSec
스트립 없음 (지금) | — | 05:50 · 15:00 | 05:50 · 15:00 (+ 2 s settle, 카메라 재시도 최대 3×30 s) | — | 900 s
스트립 설치 | 05:45 (새벽만) | 05:50 · 15:00 | 05:50 · 15:00 | 06:15 | 900 s (변화 없음)

점등 창을 05:45~06:15 로 넓게 잡는 이유 — 두 시계는 서로 모릅니다 노드 타이머와 파이의 plantsnap.timer 는 각자 돕니다(노드는 NTP, 파이는 시스템 시각). 점등을 촬영 5분 전(05:45)에 시작하면 네오픽셀 워밍업(광량·색 안정)과 두 시계의 어긋남을 함께 흡수하고, 06:15 소등이면 카메라 재시도(최대 3×30 s)까지 창 안에 들어옵니다. hub 의 warmup_s 는 쓰지 않으므로 촬영 시각은 05:50 그대로 — 유닛 재렌더도 필요 없습니다.
스트립을 다는 날 실험 노트에 적으세요 — 그날부터 새벽 사진의 조명 조건이 바뀝니다. 생장 곡선에 그 날짜의 계단이 보이면 그 이유입니다.

### 3) 스틱을 달 때 — 설치 절차

전류와 스펙트럼 — RGBW 61구 기준 네오픽셀은 LED 마다 드라이버 내장이라 데이터 핀 직결(스위칭 소자 불요). W 칩만 켜면 LED 당 ~18 mA 지만 61구 풀밝기(255)면 ~1.1 A — USB 급전 R4 의 5 V 핀(≈0.5 A)으로는 브라운아웃(리셋·색 틀어짐). 기본 밝기 80(≈0.35 A)로 시작하고, 광량이 부족하면 스트립 5 V/GND 를 별도 5 V 2 A 어댑터에 물리고(GND 는 보드와 공통) 밝기를 올립니다. 촬영 조명은 매일 같은 밝기로 고정합니다(LIGHT_BRIGHT). 광량 검증: 조명만 켠 상태에서 setup 의 [자동 측정] — gain ≤ 2 근처면 충분, gain > 4 면 부족(밝기·거리 조정 또는 스트립 추가).

1. RGBW 네오픽셀 61구 스트립을 핀 9 에 연결(NEO_GRBW — 시리얼 t 로 앞 4구가 빨강·초록·파랑·백색 순인지 확인, 다르면 LIGHT_ORDER 변경). 내장 12×8 매트릭스는 네오픽셀이 아니므로 외장 스트립 필수. 시리얼 모니터에서 1/0 으로 점등 테스트
2. plant_env_r4wifi.ino 의 USE_LIGHT=1 확인 후 업로드 — NTP 동기화(부팅 + 하루 1회), KST 초단위 창 비교로 05:45 점등 / 06:15 소등, 창 밖·NTP 실패 시 무조건 소등(자체 watchdog). 라이브러리 Adafruit NeoPixel 필요
3. hub(config.json) 에는 조명 설정이 없습니다 — 조명 상수(핀·개수·밝기·창)는 전부 노드 펌웨어에 있습니다
4. 새벽 저널에서 촬영(05:50)이 점등 창 안에 있는지, 사진이 조명 아래 찍혔는지 확인
5. 조명 아래서 calib.jpg 를 다시 찍기 — 조명이 바뀌면 기준 사진도 바뀌어야 밀림 판정과 노출이 맞습니다
6. 실험 노트에 날짜·밝기 설정(LIGHT_BRIGHT)·스틱 위치·높이를 기록

### 4) 놓친 촬영 — plantsnap-catchup.service

Persistent=true 만으로는 부족한 경우 systemd 타이머의 Persistent=true 는 “타이머가 울렸다”는 도장을 찍습니다. 05:50 에 울려 램프를 켜고 워밍업하던 중 정전이 나면 도장은 이미 찍혀 있어 재부팅 후 다시 울리지 않습니다 — 그날 새벽 사진이 없습니다.
그래서 부팅 때 한 번 plantsvc capture --phase auto --if-missing 을 돌립니다: 오늘 그 phase 의 성공 행이 없고, 지금이 그 phase 의 시간창 안일 때만 찍고, 아니면 skipped 로 조용히 끝납니다. 정상 부팅에서는 늘 skipped 입니다.

보충 촬영과 조명 — 노드 독립 운용의 한계 노드는 파이의 촬영 여부를 모르므로, 부팅 보충 촬영(--if-missing)이나 수동 촬영이 점등 창(05:45~06:15) 밖에서 돌면 그날 새벽 사진은 조명 없이 찍힙니다. 기능상 문제는 없고, 그날 데이터만 조명 조건이 다르다는 점을 실험 노트·메타데이터로 남겨 분석 때 걸러냅니다. 이 단순함(스위칭 소자·MQTT 명령·hub GPIO 모두 불요)과 맞바꾼 대가입니다. 촬영 시각을 바꾸면 노드 펌웨어의 점등 창도 같이 바꿔야 합니다.

스트립 설치 뒤 확인할 것

- 05:45 에 켜지고 06:15 에 꺼진다 — 하루 지켜보거나 노드 시각을 임시로 당겨 시험
- 노드 전원을 뽑았다 꽂아도(NTP 재동기화 후) 창 밖이면 꺼진 상태로 시작한다
- 새벽 05:50 사진이 조명 아래 찍혔다 — 저널의 촬영 시각이 점등 창 안
- Wi-Fi 를 끊어 NTP 가 실패해도 램프가 켜진 채 남지 않는다
- 조명 아래서 찍은 calib.jpg 를 다시 찍었다 — 조명이 바뀌면 기준 사진도 바뀌어야 밀림 판정과 노출이 맞습니다
- 실험 노트에 날짜·스트립 종류·밝기를 적었다

◀ 이전다음 ▶

## 20설치·배포 스크립트

scripts/ 다섯 개와 plantsvc doctor, 그리고 GitHub Actions. 손으로 하던 것을 스크립트가 어디까지 대신하는지와, 각 스크립트가 절대 하지 않는 것을 적습니다.

### 1) install.sh — 설치와 갱신을 같은 스크립트로

Pi · 서비스 계정으로 (root 아님)

scripts/install.sh [옵션]
  (없음)            처음 설치. .venv 가 이미 있으면 자동으로 --update 로 동작
  --update          apt 생략 · venv 유지 · 유닛 재렌더 · 서비스 재시작     ← git pull 뒤, config.json 의 schedule/led 를 바꾼 뒤
  --web=release     GitHub 릴리스의 web-dist.tar.gz 를 받음 (기본. 실패하면 node 가 있을 때 로컬 빌드, 그것도 없으면 skip)
  --web=local       web/web-dist.tar.gz 를 풀어 씀 (deploy.ps1 -Web local 이 올려 둠)
  --web=build       Pi 에서 npm ci && npm run build (느림 · node 필요)
  --web=skip        화면은 건드리지 않음
  --tag vX.Y.Z      --web=release 에서 특정 릴리스
  --data-dir DIR    PLANT_DATA_DIR (기본 <repo>/data)
  --set-timezone    timedatectl set-timezone <config.json 의 tz>
  --no-apt · --no-enable · --legacy(Streamlit 의존성 포함) · --dry-run(preflight 만)

# | 단계 | 하는 일 · 확인하는 것

1 | preflight | root 거부 · Pi 모델 표시 · git 체크아웃인지 · sudo 가능 여부(불가면 명령만 출력)
2 | apt | python3-picamera2 · python3-gpiozero · python3-lgpio · mosquitto(-clients) · git · rpicam-apps (--update 면 생략)
3 | uv | 없으면 설치
4 | venv | uv venv --system-site-packages --python /usr/bin/python3 — apt 의 picamera2·gpiozero 가 보이도록. UV_PYTHON=/usr/bin/python3 로 고정한 채 uv sync --frozen --no-dev (uv 가 관리형 CPython 을 골라 venv 를 조용히 다시 만들면 picamera2 가 사라지므로). Pi 에서 picamera2 import 실패면 중단
5 | data dir + config | data/photos/{raw,mask,debug} · config.json 이 없으면 hub/config.example.json 복사
6 | mosquitto | hub/plant.conf → /etc/mosquitto/conf.d/ (바뀌었을 때만 restart)
7 | web/dist | --web 에 따라. 없으면 서비스가 fallback 페이지를 띄움(패널 !)
8 | systemd 유닛 | plantsvc render-units → deploy/systemd/rendered/ → sha256 이 바뀐 경우만 /etc/systemd/system/ 에 설치 · 구 camera-lock.conf 드롭인 제거(백업 data/backup/etc/) · daemon-reload
9 | enable / start | plantdash · plantcam · mjpeg disable → planthub · plantsvc · plantsnap.timer · plantsnap-catchup enable --now · systemd-time-wait-sync enable · list-timers
10 | timezone | 시스템 tz 와 config.json 의 tz 비교. --set-timezone 이면 맞춤, 아니면 WARN
11 | groups | 계정을 video · gpio 에 추가 (셸은 재로그인 필요, 서비스는 SupplementaryGroups 로 이미 됨)
12 | doctor | plantsvc doctor 표 출력 · UI 주소 안내

전 과정이 data/install.log 에 append 됩니다. 실패하면 FAILED at step N 으로 끝나니 그 단계부터 보세요. 하지 않는 것: 데이터 삭제 · 유닛 파일 손편집 존중(렌더 결과로 덮습니다 — 고칠 것은 템플릿이나 config.json) · root 실행.

### 2) deploy.ps1 — 개발 PC(Windows) → Pi 한 번에

PC · PowerShell 5.1 · 키 기반 ssh 필요

.\scripts\deploy.ps1                          # 현재 브랜치 push → Pi 에서 pull → install.sh --update --web=release → doctor --brief → /api/system/status
.\scripts\deploy.ps1 -Web local               # 화면을 여기서 빌드해 web-dist.tar.gz 로 올림 (릴리스를 안 만들고 화면만 시험)
.\scripts\deploy.ps1 -PiHost raspi -Full      # apt 포함 전체 설치
.\scripts\deploy.ps1 -NoPush -Force           # push 생략 · 작업 트리가 지저분해도 진행

기본 호스트명은 raspi, 원격 경로는 ~/plant. 원격 명령은 한 줄로 보내고 stdin 을 쓰지 않아 CRLF 가 섞일 일이 없습니다. 실패하면 journalctl -u plantsvc 명령과 직전 커밋으로의 rollback 명령을 찍어 줍니다. ssh 키가 없으면 안내대로 id_ed25519.pub 를 Pi 의 authorized_keys 에 한 번 넣으세요.

### 3) migrate_legacy.sh — 평탄화 설치에서 데이터만

scripts/migrate_legacy.sh --from ~/plant.legacy-20260910 [--dry-run]
# --from 을 생략하면 ~/plant.legacy-* 또는 .git 이 없는 /home/*/plant 를 찾아봄

plant.db(sqlite backup API 로 안전 복사) · config.json · calib.jpg · truth.json · photos/ 를 data/ 로. 복사만, 삭제 없음. 이미 있는 대상은 건너뜁니다(plantsvc migrate-data --force 로 덮어쓰기). 결과는 data/MIGRATED_FROM.txt. 옛 유닛이 enabled 면 알려만 주고 install.sh 가 비활성화합니다. 패널 8 의 1절이 전체 순서입니다.

### 4) fetch_web.sh · rollback.sh

scripts/fetch_web.sh [--tag v0.1.0]     # GitHub 릴리스의 web-dist.tar.gz (+ .sha256 검증) → web/dist, VERSION 파일 기록. jq 불필요
scripts/rollback.sh <sha|tag>            # git checkout 그 ref → install.sh --update --web=skip (화면은 그대로)
scripts/rollback.sh <sha> --streamlit    # + --legacy 로 Streamlit 의존성 · plantdash.service enable → :8501 (plantsvc · catch-up 은 disable)

롤백은 코드만 되돌립니다 data/ 는 그대로입니다. 2026-07 판 스크립트는 config.json 을 폴더 바로 아래에서 찾으므로 Streamlit 롤백 뒤에는 PLANT_DATA_DIR 를 알지 못하는 옛 코드가 빈 설정으로 뜰 수 있습니다 — 롤백은 화면을 급히 살리는 용도이지 운용 모드가 아닙니다.

### 5) plantsvc doctor — 점검표

cd ~/plant && .venv/bin/plantsvc doctor [--brief] [--json]

venv            OK    /home/pi/plant/.venv
import picamera2 OK  ·  import gpiozero WARN (ModuleNotFoundError)  → sudo apt install python3-gpiozero python3-lgpio
config.json     OK    6 ROI
data dir        OK    /home/pi/plant/data  free 24811 MB
calib.jpg       WARN  missing                         → camera setup step 5
plant.db        OK    readings=1440, soil=2880, pump_log=31, growth=12
mqtt broker     OK    localhost:1883
camera          OK    1 camera(s)
camera lock     OK    free
schedule        OK    dawn 05:50 · pm 15:00 · next 15:00
timezone        OK    Asia/Seoul
ntp             OK    synchronized
units           OK    planthub active · plantsvc active · plantsnap.timer active · catch-up enabled
web/dist        OK    v0.1.0

종료 코드는 FAIL 이 하나라도 있으면 1 — CI 나 deploy.ps1 이 그대로 씁니다. --json 은 같은 표를 기계용으로. 행 이름·상태는 위 예와 같지만 세부 문구는 버전에 따라 조금 다를 수 있습니다.

### 6) GitHub Actions

워크플로 | 언제 | 무엇을
ci.yml | main · feat/** push, PR | pytest + web 빌드. 하드웨어 없이 도는 테스트만
release.yml | 태그 v* push | web/dist 를 web-dist.tar.gz(+sha256) 로 릴리스에 첨부 — install.sh --web=release · fetch_web.sh 가 받는 것
pages.yml | main 의 docs/** · web/** 변경 | 프로젝트 개요(index.html) · 이 매뉴얼 · /app/ 목 데이터 데모를 GitHub Pages 에

git tag v0.1.1 && git push origin v0.1.1      # → release.yml → Pi 에서 scripts/install.sh --update --web=release 가 이 화면을 받음

### 7) Windows 개발 PC — 알아 둘 것

Smart App Control(애플리케이션 제어 정책)이 pydantic-core DLL 을 막을 수 있습니다 최신 pydantic-core 의 네이티브 DLL 이 서명 정책에 걸려 import pydantic 이 “애플리케이션 제어 정책에 의해 차단”으로 실패하는 PC 가 있습니다. 그래서 pyproject.toml 이 win32 에서만 pydantic 2.10 을 고정합니다 — Pi 는 최신을 씁니다. 정책을 끄지 마세요(패널 ! 에 증상).
한글 로그가 cp949 콘솔에서 깨지던 문제는 plantsvc 가 stdout 을 UTF-8 로 재설정해 해결했습니다. 다른 스크립트가 깨지면 $env:PYTHONUTF8='1'.

◀ 이전다음 ▶

## 13데모 합격 판정

전부 통과해야 2단계(프레임·7노드·열화상)로 넘어갑니다. 하나라도 미달이면 원인을 고치고 다시 24시간.

### 24시간 무인 후

항목 | 합격 기준 | 확인
환경 수집 | 288행 ±3, 결측 구간 없음 | SELECT COUNT(*) FROM readings;
표본 수 | n ≥ 25 유지 | SELECT MIN(n),AVG(n) FROM readings;
토양 수집 | 288행 ±3 | SELECT COUNT(*) FROM soil;
정각 정렬 | ts가 5분 격자 | SELECT ts FROM readings LIMIT 12;
폐루프 | 바닥 아래 → 급수 → 20분 → 천장까지 반복 → filled 기록 | pump_log
검증 실패 감지 ★ | 튜브를 빼면 verify_fail + DISARM | 일부러 유발
급수 중 전압 | ≥ 4.7V, 노드 리셋 없음 | USB 전력계 ___ V
아날로그 전압 | ≤ 3.3V | 멀티미터 ___ V
브로커 단절 내성 | 브로커 꺼도 급수 계속, 켜면 재연결 | run_collector.py 중지 후 관찰
노드 재부팅 | 펌프 안 돌고 자동 재연결 | USB 재인가
면적 정확도 | 종이 잎 MAE < 5% | check_accuracy.py → PASS
면적 반복성 | 같은 장면 10회 변동 < 1% | 연속 촬영

가장 잘 놓치는 항목 — verify_fail 유발 정상 동작만 확인하고 넘어가기 쉽습니다. 하지만 고장을 감지하는 능력이야말로 6주 무인 운용의 핵심입니다. 포럼에 8개 중 2개가 불량이었다는 교사 보고가 있습니다 (펌프 소리는 나는데 물이 안 나오는 막힘). 이 로직이 그 고장을 잡으라고 있는 것이니, 반드시 일부러 실패시켜 보세요.

### 실측 결과 기록표 — 이 값들이 2단계 설계를 확정합니다

측정 | 값 | 결정되는 것
PUMP_EN 핀 | G8 / G9 | 펌웨어 상수
Analog 핀 | G8 / G9 | 펌웨어 상수
Analog 최대 전압 | ___ V | 분압 저항 필요 여부
급수 중 전류 | ___ mA | 멀티탭 총 부하 산정 (×6)
급수 중 전압 | ___ V | 외부 5V 주입 여부
SOIL_DRY / WET | ___ / ___ | 수분% 환산
3초 급수량 | ___ mL | DOSE_MS
marker 실측 | ___ mm | marker_mm
LensPosition | ___ | 초점 고정값
px_per_cm | ___ | qc.px_per_cm_ref

◀ 이전다음 ▶

## 14왜 이 실험인가

"물을 적게 주면 덜 자란다" — 답이 뻔합니다. 이 장은 답이 뻔하지 않은 질문으로 바꾸는 이야기입니다.

### 1. 뻔한 실험의 문제

충분히 준 그룹과 적게 준 그룹을 비교하면 결과는 시작 전에 이미 압니다. 게다가 그런 처리는 물뿌리개와 손가락으로도 만들 수 있습니다. 그러면 우리가 만든 7노드 시스템은 연구에 꼭 필요한 것이 아니라 정밀도를 조금 높인 장식이 됩니다.

좋은 질문을 가르는 기준은 하나입니다 손으로 만들 수 없는 처리인가? 이 조건을 만족시키면 "답이 뻔하지 않다"와 "시스템이 필수다"가 동시에 해결됩니다.

### 2. 바꾼 질문 — 평균은 같게, 흔들림만 다르게

두 그룹 모두 평균 수분을 같게 맞춥니다. 다른 건 흔들리는 폭뿐입니다.

두 선의 평균 높이는 같다. 다른 것은 오르내림의 크기뿐이다.

| 꾸준한 그룹 | 널뛰는 그룹
물 주는 법 | 조금씩 자주 | 많이 가끔
흙 수분 | 늘 평균 근처 | 말랐다 젖었다
평균 수분 | 같음 ← 이게 전부다
손으로 가능? | 불가능 | 재현 불가

이제 결과를 예측할 수 없습니다. 평균이 같은데 왜 달라야 합니까?

### 3. 일상에 이미 옌센 부등식이 있습니다

"어떤 양이 흔들리면, 평균만으로 계산한 값과 실제가 달라진다" — 우리는 이미 여러 곳에서 이 현상을 겪고 있습니다.

상황 | 흔들리는 것 x | 함수 f | 휨 | 흔들리면
적립식 분할매수 | 주가 P | 수량 = 예산/P | 볼록 | 이득 — 같은 돈에 더 많은 주식
복리 수익 | 수익률 r | ln(1+r) | 오목 | 손해 — 변동성 끌림
전열기 발열 | 전류 I | I²R | 볼록 | 커짐 — 평균이 0인데 뜨거움
목적지 소요시간 | 속도 v | 거리/v | 볼록 | 손해 — 더 오래 걸림
보험 · 위험회피 | 재산 w | 효용 u(w) | 오목 | 손해 — 덜 행복
새로운 맛집 도전 | 음식 점수 s | 만족도 u(s) | 오목 | 손해 — 실망이 더 큼
상추 생장 | 토양수분 w | RGR(w) | ? | ?

#### ① 복리 — 평균이 0인데 반토막

수익률이 +50%, −50%를 번갈아 납니다. 산술평균은 0%, 본전 같아 보입니다.

100만원 → 150만원 → 75만원 → 112.5만원 → 56.25만원 → ...

본전이 아니라 반토막입니다. 2회마다 −25%. 수익률은 곱해지므로 실제로 더해지는 건 로그이고, 로그는 오목합니다.

#### ② 실효값(RMS) — 물리 시간에 이미 배운 것

교류 전류가 +10A와 −10A를 오가면 평균 전류는 0입니다. 그런데 전열기는 뜨겁습니다.

실효값은 옌센 격차를 메우려고 만든 개념입니다 P = I²R이 제곱(볼록)이라 평균 전류로 계산하면 0이 나오지만 실제 발열은 100R입니다. 그래서 "평균 전류" 대신 √(평균 I²) — 실효값을 씁니다.

그리고 f(x)=x²일 때 그 격차는 정확히 E[X²] − (E[X])² = σ² — 분산 그 자체입니다. 근사가 아니라 등식입니다.

#### ③ 내비게이션 — 막히는 길에서 잃는 시간이 더 크다

A 경로는 늘 50km/h. B 경로는 절반 거리를 90km/h, 절반 거리를 10km/h. 속도의 산술평균은 둘 다 50입니다.

T_A = d / 50           = 0.020 d
T_B = (d/2)/90 + (d/2)/10 = 0.056 d      →  B가 2.8배 오래 걸림

시간 = 거리/속도는 볼록이라 흔들리면 커집니다. 90에서 아끼는 시간보다 10에서 잃는 시간이 훨씬 큽니다.

★ 이 예시는 우리 실험과 정확히 같은 함정을 갖고 있습니다 "거리 기준"으로 반반일 때만 성립합니다. 만약 시간 기준으로 반반이라면 (절반의 시간을 90으로, 절반을 10으로) 이동거리는 90t+10t=100t, 총 2t시간 → 평균속도 50으로 A와 똑같습니다.

게다가 B의 실제 평균속도는 50이 아니라 조화평균 18km/h입니다 — 느린 구간에 오래 머물기 때문입니다.
널뛰는 화분이 마른 쪽에 오래 머물러 평균이 40%가 아닌 34.5%가 되는 것과 같은 구조입니다. "어떻게 가중하느냐"가 답을 바꿉니다 — 그래서 우리는 5분마다 로그를 남깁니다. (패널 設)

#### ④ 위험회피 — 보험사가 돈을 버는 이유

효용은 오목합니다 — 100만원 잃는 고통이 100만원 버는 기쁨보다 큽니다. 그래서 기대금액이 같아도(공정한 도박) 사람은 확정된 쪽을 택합니다. 보험사는 기대값 기준으로 손해인 계약을 팔아 돈을 법니다.

맛집도 같은 구조입니다 — 늘 가는 곳은 항상 80점, 새로운 곳은 반반으로 100점 또는 60점. 기대 점수는 똑같이 80점입니다. 그런데 20점 잃는 실망이 20점 얻는 기쁨보다 커서, 평균 만족도는 새로운 곳이 낮습니다.

비교하려면 평균이 같아야 합니다 "새로운 곳은 100점 아니면 40점(평균 70점)"으로 놓으면 이건 옌센 예시가 아닙니다 — 그냥 평균이 낮은 겁니다. 옌센은 평균이 같을 때만 성립하는 비교입니다. 이 조건을 놓치면 전혀 다른 이야기가 됩니다 — 우리 실험이 "두 그룹의 평균 수분을 같게"에 그토록 매달리는 이유가 바로 이것입니다.

### ★ 결정적 대비 — 같은 주식, 정반대 결론

같은 주식인데 | 함수 f | 휨 | 변동성이
사는 사람 (적립식) | 수량 = 예산 / P | 볼록 | 이득 — 쌀 때 많이 사짐
갖고 있는 사람 | ln(1 + r) | 오목 | 손해 — 변동성 끌림

이 표가 이 연구의 출발점입니다 대상이 달라서가 아니라 함수가 달라서 결론이 뒤집힙니다.

그러니 "변동성은 좋다 / 나쁘다"라는 일반 명제는 존재하지 않습니다. 곡선을 봐야만 알 수 있습니다. 그리고 상추의 곡선은 우리가 갖고 있지 않습니다.

⚠️ 인용할 때 조심할 것 두 가지 ① 분할매수 — 옌센이 말해주는 건 "조화평균 ≤ 산술평균"이라는 사실뿐입니다. 비교 대상인 "평균 주가에 한 번에 사기"는 그 평균을 미리 알 수 없어 실행 불가능한 선택입니다. 실제 대안인 거치식과 비교하면 시장이 우상향하므로 거치식이 더 자주 이깁니다. "분할매수가 최적"이라는 뜻이 아닙니다.

② 소득과 행복 — 개인의 효용이 오목하다는 것까지는 논쟁이 없지만, "사회 전체의 행복 총합"으로 넘어가면 행복을 사람끼리 더할 수 있다(기수적 효용)와 모두의 효용함수가 같다는 가정이 몰래 들어옵니다. 경제학에서 오래 다퉈온 문제입니다. 이는 공리주의적 재분배 논증으로 알려진 것이지 증명된 결론이 아니므로, 수학이 정책적 결론을 보증하는 것처럼 쓰지 마세요. 같은 오목함수를 쓰려면 보험·위험회피 쪽이 안전합니다.

### 4. 왜 달라지나 — 곡선이 휘어 있으면

가로축은 흙 수분, 세로축은 그때의 생장속도입니다. 시간 그래프가 아닙니다.

⚠️ 아래 그림은 "만약 오목하다면"이라는 가정입니다 오목이 정답이어서가 아니라 설명하기 쉬워서 먼저 그린 것입니다. 숫자(30·80·90)도 임의로 지어낸 예시이지 측정값이 아닙니다.
다음 절에서 곡선을 뒤집어 보면 결론이 정반대가 됩니다. 두 그림을 함께 보세요.

두 점을 잇는 직선(현)이 곡선보다 아래에 있다. 이것이 옌센 부등식의 전부다.

- 꾸준한 그룹 — 늘 40%에 있으니 곡선 위의 점 하나. 값 = 80
- 널뛰는 그룹 — 25%일 때 30으로, 55%일 때 90으로 자람 → 평균 60 = 현의 중점

이 그림에서는 25%에서 잃은 것을 55%에서 갚지 못합니다 — 위쪽이 이미 포화라 물을 더 줘도 그만큼 안 늘거든요. 손해는 큰데 보상은 작습니다. 단, 이건 곡선이 이렇게 생겼다고 가정했을 때의 이야기입니다. 상추가 정말 이런지는 아무도 재본 적이 없습니다.

★ 식물이 스스로 계산해서 잎 크기로 답을 내놓습니다 식물은 매 순간 자기가 처한 수분에 맞춰 자랍니다. 6주 뒤의 크기는 순간순간 속도를 다 더한 것입니다. 우리는 그 답을 카메라로 읽을 뿐입니다.
잎 크기의 차이 = 곡선이 얼마나 휘었는지의 측정.

### 5. 그런데 어느 쪽으로 휘었는지 모릅니다

같은 두 점, 같은 평균. 곡선의 휜 방향만 뒤집으면 결론이 정반대가 된다.

부등식은 수학이라 확인할 게 없습니다 곡선이 오목하면 널뛰는 쪽이 손해라는 건 증명된 정리입니다. 실험이 필요 없습니다.
모르는 건 딱 하나 — 상추의 곡선이 이 구간에서 어느 쪽으로 휘었느냐. 그건 계산으로 알 수 없고 재봐야 압니다.

나온 결과 | 읽는 법 | 확실한가
널뜀이 작다 | 이 구간이 오목 | 비교적 명확 (손상 배제 시)
널뜀이 크다 | 볼록 또는 식물의 대비(경화) | 구분 불가
같다 | 직선 또는 두 효과가 상쇄 | 구분 불가

세 결과 모두 답입니다. "차이가 안 나면 실패"가 아닙니다 — 화분이 6개뿐이라 통계가 약한 상황에서 이건 결정적인 이점입니다.

아래 두 칸의 애매함은 n=3에서 못 풉니다 — 단서는 뿌리뿐 같은 데이터가 두 가지로 읽힙니다. 유일한 단서가 6주차 뿌리 건중량입니다.
널뜀군이 뿌리를 더 뻗었다면 → 경화의 물증. 뿌리가 같은데 더 컸다면 → 곡선이 볼록.
어차피 화분을 엎으니 추가 비용이 0입니다. (패널 測)

★ 이 곡선은 실험의 결과물이 아닙니다 — 설명 도구입니다 가로축이 수분, 세로축이 생장이라 "수분을 여러 값으로 바꿔가며 생장을 쟀다"처럼 보이지만 우리는 그렇게 하지 않습니다. 그건 화분 6개를 각각 다른 수분에 고정하는 방법 A이고, 반복이 없어 쓸 수 없습니다.

이 실험이 내놓는 것은 막대 두 개뿐입니다:
· 꾸준군 → 곡선 위의 점 하나 = f(평균)
· 널뜀군 → 곡선 위의 점이 아님. 구간 전체를 머문 시간으로 가중한 값 = 평균 of f

우리가 얻는 건 두 막대의 차이 — 부호 하나입니다. 그 부호로 휨의 방향을 역추론할 뿐, 곡선을 그리는 게 아닙니다.

말할 수 있는 것 | 말할 수 없는 것
밴드 구간(25~55%)에서 평균적인 휨의 부호 | 수분–생장 곡선의 모양
변동폭을 키우면 생장이 어느 쪽으로 움직이는가 | 변곡점의 위치
차이의 크기(효과크기) | 곡률 f″의 값

보고서에는 "수분–생장 곡선을 구했다"가 아니라 "해당 구간에서 휨의 부호를 판정했다"고 써야 합니다. 이 범위를 명시하는 것이 정직함이자 정확함입니다.

### 6. 생물학적으로는 무엇을 기대할 수 있나

수학은 부호를 정해주지 않습니다. 그러면 생존과 번식의 관점에서는 어느 쪽을 예상할 수 있을까요?

★ 진화 자체가 옌센 부등식의 지배를 받습니다 — 복리와 같은 수학 개체수는 세대마다 곱해집니다. 100마리 → 2배 → 0.5배 → 원위치. 복리와 똑같습니다. 곱셈으로 쌓이니 실제로 더해지는 건 로그이고, 로그는 오목합니다.

그래서 자연선택이 최대화하는 것은 산술평균 적응도가 아니라 기하평균 적응도입니다: exp(E[ln W]) ≠ E[W]

즉 적응도의 변동성 자체가 페널티입니다. 그래서 자연은 위험 분산(bet-hedging) 형질을 선택합니다 — 평균 적응도를 낮추더라도 변동을 줄이는 쪽으로. 씨앗이 한꺼번에 발아하지 않고 휴면 기간이 제각각인 것이 바로 이것입니다.

#### 자연에서는 일정한 수분이 오히려 인공입니다

비는 펄스로 옵니다. 자연의 토양수분은 원래 톱니 모양입니다 — 흠뻑 젖었다가 서서히 마르고, 또 젖고. 우리가 만든 "꾸준한 그룹"이야말로 자연에 없는 조건입니다.

그러니 상추는 오랜 세월 널뛰는 수분 속에서 선택되어 왔습니다. 변동에서 심하게 손해 보는 계통은 이미 도태됐을 것이고, 남은 것들은 대비 기제를 갖췄을 겁니다 — 삼투조절, ABA 신호, 뿌리 가소성, 수력 축전.

★ 그런데 대비는 공짜가 아닙니다 뿌리를 더 뻗으려면 탄소를 써야 하고, 기공을 보수적으로 운영하면 광합성을 덜 합니다. 보험료는 생장속도에서 나옵니다.

적응했다 ≠ 손해가 없다. 적응은 변동을 견딜 만하게 만들 뿐 공짜로 만들지 않습니다.

#### 그래서 세울 수 있는 가설

| 내용 | 근거
H₁ (주가설) | 널뜀군의 RGR이 낮다 | 광합성–수분 반응은 위쪽에서 포화하므로 이 구간이 오목할 가능성
단서 | 그러나 순수 옌센 예측보다는 덜 손해 | 대비 기제가 일부를 상쇄
H₂ (대안) | 차이 없음 또는 역전 | 대비 효과가 옌센 손실을 상쇄하거나 넘어섬

#### ★ 볼록이면 변동 유리, 오목이면 변동 불리 — 진화가 정말 이렇게 작동합니다

"곡선이 볼록이냐 오목이냐가 변동성의 유불리를 정한다"는 직관은 진화생물학의 정립된 이론입니다. 자원→적응도 관계가 가속(∪ 볼록)이면 변동-선호(variance-prone)가, 감속(∩ 오목)이면 변동-회피(variance-averse)가 유리하다는 것이 위험분산(bet-hedging) 이론의 핵심입니다.

곡선 | 전략 | 왜 유리한가 | 예
∪ 볼록 (가속) | 변동 선호 | 큰 값에서의 이득이 작은 값에서의 손해보다 큼 → 널뛰면 평균 이득↑ | 낮은 자원 구간, 문턱 넘기 전
∩ 오목 (감속·포화) | 변동 회피 | 포화로 위쪽 이득이 작음 → 널뛰면 손해. 안정이 유리 | 광합성 포화, 대부분의 생장 구간

★ 그런데 반전 — 두 개의 층이 있습니다 (여기가 핵심) 변동성 유불리에는 서로 다른 두 층이 있고, 섞으면 안 됩니다.

① 개체 수준 (우리 실험이 재는 것) — 수분→생장 곡선의 볼록성. ∩일 수도 ∪일 수도 있어 재봐야 압니다.
② 세대 간 (진화 수준) — 적응도는 세대마다 곱해지므로(번식=곱셈), 진화가 최대화하는 건 산술평균이 아니라 기하평균 적응도 exp(E[ln W])입니다. ln이 오목이라 세대 간 변동은 곡선 모양과 무관하게 거의 항상 적응도를 깎습니다.

즉 개체 수준에서 ∪(변동이 생장에 이득)로 나오더라도, 그것이 번식 적응도에 이득이란 뜻은 아닙니다. 세대 간 곱셈 구조가 변동을 처벌하니까요. 이 때문에 씨앗 휴면 같은 bet-hedging이 진화했습니다.

그래서 이 실험의 정확한 자리 — 야심은 살리되 과잉주장은 피함 우리는 ①개체 수준 곡선의 부호를 측정합니다 (수분→잎생장이 ∩냐 ∪냐). 이 부호는 bet-hedging 이론이 예측하는 변동성-감수성의 한 입력값입니다.

하지만 적응도(씨앗 수) 자체는 재지 않습니다. 그러니 "변동이 생존·번식에 유리/불리"로 직결시키지 않습니다. 포괄적 이론(볼록↔변동선호, 오목↔변동회피)과 우리 측정값을 잇되, 잎생장의 부호가 진화적 유불리라고 주장하지 않는다 — 이 선을 지키면 야심 찬 연결이 정직한 연구가 됩니다.

선행연구가 이미 있습니다 — 아래 별도 절에서 자세히 상추를 포함한 여러 작물에서 "안정 수분이 변동 수분보다 유리"하다는 보고가 있습니다. 이는 우리 H₁(오목 ∩) 방향과 일치합니다. 다만 그들이 무엇을 못 했는지가 우리의 자리입니다 — 절 9 참조.

⚠️ 가장 정직한 한계 — 진화는 우리가 재는 것에 관심이 없습니다 자연선택이 최적화하는 것은 생장속도가 아니라 적응도(씨앗 수)입니다. 우리가 재는 것은 잎 면적이고요. 둘은 같지 않습니다.

변동에 대비해 뿌리에 투자한 상추는 잎이 작지만 살아남습니다. 우리 눈에 "손해"로 보이는 것이 식물에게는 이득일 수 있습니다.

즉 "진화적으로 적응했으니 손해가 없어야 한다"는 추론은 성립하지 않습니다. 이 구분을 보고서에 명시하세요 — 잎 면적은 적응도의 대리지표가 아닙니다.

### 7. 투자와 다른 점 — 여기가 연구가 되는 이유

| 투자 | 상추
쌓이는 것 | 자산 | 잎 면적
한 걸음의 성장 | 로그수익률 ln(1+r) | RGR
널뛰는 것 X | 수익률 r | 토양수분 w
곡선의 휨 | 항상 오목 (증명됨) | 모름
변동성이 손해인가 | 정리 | 가설

왜 잎 면적이 자산과 같은가 둘 다 곱셈으로 늡니다 — 자산이 크면 같은 수익률에도 더 붙고, 잎이 크면 빛을 더 받아 더 자랍니다. 곱셈으로 크는 것은 로그를 씌워야 덧셈이 됩니다. 그래서 투자자는 로그수익률을, 식물학자는 RGR = (ln A₂ − ln A₁) / Δt를 씁니다. 같은 이유로 만든 같은 물건입니다.

투자는 −50%를 회복하려면 +100%가 필요하다는 구조적 비대칭이 있어 곡선이 항상 오목합니다. 수분에는 그런 비대칭이 없어 해봐야 압니다. 이 한 칸의 차이가 이 프로젝트의 존재 이유입니다.

### 8. 그래서 시스템이 필수가 됩니다

- 좁은 밴드 유지는 손으로 불가능 — 사람이 5분마다 흙을 만질 수 없습니다
- "평균이 같았다"의 증명이 필요 — soil 로그가 없으면 실험이 성립했다는 근거 자체가 없습니다
- 널뛰는 그룹의 실제 평균은 계산이 아니라 측정 — 다음 패널에서 설명

연구의 착안 주가·전류·소요시간·효용에서 우리는 이미 같은 현상을 봅니다 — 평균이 같아도 흔들림이 결과를 바꾼다. 그리고 그 방향은 오직 곡선의 휨이 정합니다.

그렇다면 자연에서도, 식물의 생장에서도 같은 메커니즘이 관찰될까? 물을 얼마나 주느냐가 아니라 어떻게 흔들리게 주느냐가 생장을 바꾼다면, 상추의 수분–생장 곡선은 어느 쪽으로 휘어 있는 것일까?

이것이 본 연구의 질문입니다. 사람이 만든 시장과 회로에서 성립하는 수학이 살아 있는 것에서도 성립하는지 — 그 답은 계산으로 알 수 없고 재봐야 알 수 있습니다.

### 9. 선행연구 — 어디까지 왔고, 우리는 무엇을 다르게 하나

이 질문은 이미 연구된 적이 있습니다. 모르고 하면 "재탕", 알고 하면 "빈 곳 채우기"가 됩니다. 정확히 짚고 갑니다.

있는 것 — 상추에서도 "안정 우세"가 반복 보고됨 토양수분의 시간적 변동을 다룬 연구들이 대체로 안정(stable) 수분이 변동(fluctuating)보다 유리하다고 보고합니다. 상추(로메인) 사례가 특히 직접적입니다:

· 로메인 상추 — 안정 수분에서 초장·잎 수·잎 크기·생물량이 유의하게 높음. 게다가 뿌리 크기와 무관하게 그러함 (2025)
· 체리 무 — 비슷한 평균 수분에서 안정이 광합성·기공전도도↑, 스트레스 지표(프롤린·MDA)↓, 생물량↑ (2024)
· 로메인 상추 — 안정(변동계수 CV 5.0%) vs 변동(CV 10.3%)에서 안정이 수분이용효율(WUE) 개선 (2022)

방향은 우리 H₁(오목 ∩, 안정 우세)과 일치합니다.

★ 두 문헌이 따로 존재합니다 — 서로 안 만납니다 A. 상추 "안정 vs 변동" 연구(위) — 결과는 보고하지만 옌센 언급이 없습니다. 농학 지표(WUE·생물량)로만 서술.
B. 옌센을 쓰는 생물학 연구 — 온도 변동이 대사율을 높이고(∪), 빛 변동이 1차생산을 낮추고(∩ — 광합성 포화, 우리와 같은 방향), 먹이 밀도 변동이 포획률을 낮춘다는 식으로 널리 쓰입니다. 최근엔 토양수분+옌센도 나왔는데 대상이 토양 호흡(미생물)이지 식물 생장이 아닙니다.

교집합이 비어 있습니다:

축 | 있는 것 | 없는 것
상추 + 수분변동 | 결과(안정 우세) | 옌센 해석
옌센 + 수분 | 토양호흡(미생물) | 식물 잎생장
옌센 + 식물 | 온도·빛 변동 | 수분 변동

세 칸의 교집합 — 상추 잎생장 × 수분 변동 × 옌센 × 평균 정렬 — 이 우리 실험입니다.

방법론 선례 — 토양 호흡 연구(2026)가 같은 틀을 씁니다 AmeriFlux 대륙 규모 데이터로 "시간분해 입력 vs 장기평균 입력의 차이 = 옌센 효과"를 정량화한 연구가 있습니다. 건조지에서 중앙값 −63.6% 차이가 났고, 치우친(skewed) 수분 분포일수록 효과가 컸습니다. 대상만 미생물이고, 우리는 같은 틀을 식물 잎생장으로 옮깁니다. "이 방법이 토양과학에서 검증됐다"는 근거가 됩니다.

★ 그런데 — 이것이 "곡선이 오목함을 입증"한 것은 아닙니다 선행연구가 오목 방향의 결과를 보였다고 곡선이 오목임이 입증된 것은 아닙니다. 세 가지 이유:

① 평균이 어긋났을 수 있습니다 — 많은 연구가 변동군을 더 마르게 둡니다. 그러면 "안정 > 변동"이 나와도 (a) 곡선이 오목해서인지 (b) 변동군 평균이 낮아서인지 구분이 안 됩니다. 곡선의 볼록성이 아니라 단순히 물이 부족해서일 수 있습니다.
② 곡선을 그린 게 아닙니다 — 선행연구도 막대 두 개를 비교했을 뿐, RGR(w) 곡선의 모양을 잰 게 아닙니다. 우리 실험이 "부호 하나만 준다"고 한 것과 같은 한계를 그들도 갖습니다.
③ 메커니즘이 다를 수 있습니다 — "안정 우세"가 옌센(곡선 볼록성)이 아니라 침수·건조 손상, 미생물 군집 변화 등 곡선의 휨과 무관한 별도 원인일 수 있습니다.

★ 그래서 우리의 자리 — 선행연구의 약점이 곧 우리의 강점 선행연구가 오목을 시사하지만 입증 못 한 이유가 바로 평균 교락입니다. 그리고 우리 설계의 핵심이 평균 실측 정렬입니다.

선행연구의 약점(평균 교락) = 우리 설계의 강점(5분 로그 + 실측 평균 정렬)

즉 우리는 "안정이 유리하다"를 재확인하는 게 아니라, 그게 정말 곡선의 오목함(옌센) 때문인지, 아니면 그냥 물 부족 때문인지를 분리합니다. 선행연구가 못 한 바로 그 지점입니다.

나온 결과 | 해석 (평균을 맞췄다는 전제에서)
널뜀 < 꾸준 (선행과 일치) | 이 구간 오목 ∩ 확인 — 게다가 평균을 맞췄으므로 물 부족이 아닌 진짜 변동성 효과
널뜀 ≈ 꾸준 | 선행연구의 차이가 평균 교락 탓이었을 가능성 — 의미 있는 반증
널뜀 > 꾸준 | 선행과 반대. 경화 효과 우세 — 매우 흥미로운 결과

둘째·셋째가 나오면 선행연구를 뒤집는 것이라 오히려 더 값집니다. 평균을 안 맞춘 선행연구는 이걸 볼 수 없었으니까요.

⚠️ 정직한 위험 — 발표 전에 방어선을 준비하세요 선행 상추 연구가 이미 "안정 우세"를 보였으니 H₁이 나올 가능성이 높고, 그러면 "이미 아는 걸 재확인"으로 비칠 수 있습니다. 처음부터 차별점 3가지를 명시하세요: ① 평균 정렬의 엄밀성 ② 옌센 프레임(왜 그런지의 수학적 뼈대) ③ 뿌리 수확으로 경화 여부까지 확인.
기여는 결과의 방향이 아니라 방법과 해석입니다.

### 10. 용어 — 오목/볼록은 항상 기호와 함께

한국 교과서 "위로 볼록"이 혼동을 만듭니다 말은 "볼록"인데 수학 용어로는 오목(concave)입니다. 늘 ∩/∪ 기호를 병기하세요.

그래프 | 교과서 | 수학 용어 | 최고차항 | 변동성이
∩ (언덕) | 위로 볼록 | 오목 concave | 음수 | 손해 (안정 우세)
∪ (그릇) | 아래로 볼록 | 볼록 convex | 양수 | 이득 (변동 우세)

외우는 법: 물을 담을 수 있으면 볼록(∪), 흘러내리면 오목(∩). 영어 concave = 동굴(cave) 천장이 ∩로 파임 → 오목.

우리 실험과 물리의 대비 저항 발열 P=I²R은 ∪ 볼록 — 그래서 변동(RMS)이 평균보다 큽니다.
광합성–수분 곡선은 위에서 포화하며 꺾이는 ∩ 오목일 것으로 선행연구가 시사 — 그래서 변동이 손해입니다. 같은 옌센, 부호만 반대.

### 11. 학술적으로 어떻게 쓸 것인가 — 제목과 용어

보고서·발표·대회 제출용으로 이 실험을 한 줄로 적어야 할 때가 옵니다. 그 한 줄에서 가장 흔히 어긋나는 지점부터 짚습니다.

⚠ “옌센 메커니즘을 규명한다” 는 두 군데가 틀립니다 ① 옌센 부등식은 메커니즘이 아니라 수학적 정리입니다. 곡률의 부호만 정해지면 언제나 참이므로 규명할 대상이 아닙니다(§5 참고). 규명 대상은 반응함수의 곡률 부호이고, 옌센 부등식은 그 부호를 변동성 실험으로 읽어내는 논리 장치입니다.
② ~~규명~~ → 검증 · 추정. n=3 · 6주로 “규명”은 과합니다. 예비 연구임을 제목과 초록에 드러내는 것이 심사에서 오히려 유리합니다 — 과잉주장은 가장 먼저 공격받는 지점입니다.

| 피할 표현 | 쓸 표현
대상 | 옌센 메커니즘 | 생장 반응함수의 곡률 부호
강도 | 규명 · 입증 · 증명 | 검증 · 추정 · 시사
범위 | 식물의 생장 원리 | 상추 초기 생장, 예비 연구

제목 후보 정식 (국문)
평균을 일치시킨 토양수분 변동성이 상추 초기 생장에 미치는 영향 — 옌센 부등식을 이용한 생장 반응함수의 곡률 부호 추정

간결 (발표·포스터용)
토양수분 변동성과 상추 생장: 평균 일치 설계로 반응함수의 비선형성 검증하기

영문
Effects of mean-matched soil moisture variability on early lettuce growth: inferring the curvature of the growth–moisture response function

세 제목의 공통점 — “평균 일치(mean-matched)”가 반드시 들어갑니다. 그 한 단어가 “물을 덜 준 쪽이 못 자란 것 아니냐”는 가장 흔한 반박을 제목에서 미리 막습니다.

쓸 만한 용어 — 오목/볼록 표기는 §10 참고

개념 | 용어
이 현상의 이름 | Jensen effect · 비선형 평균화(nonlinear averaging)
조작 변인 | 토양수분의 시간적 변동성(temporal variability) · 평균 일치(mean-matched)
추정 대상 | 생장 반응함수의 곡률(curvature) — 오목/볼록
주 종속 변인 | 캐노피 투영면적 기반 상대생장률(RGR, relative growth rate)
보조 지표 | 정오 처짐 지수 — 처리가 실제로 작동했다는 독립 증거
연구 성격 | 예비 연구(pilot study) · 효과크기(effect size) 보고 중심

Jensen effect 는 생태학에서 실제로 쓰이는 용어입니다. Ruel & Ayres 의 1999년 Trends in Ecology & Evolution 논문이 표준 인용으로 알려져 있는데, 서지사항은 직접 확인하고 인용하세요 — 기억에 의존한 인용은 심사에서 가장 쉽게 걸립니다.

⚠ 방법 절에 반드시 넣을 한 문장 “평균이 같다”가 무엇을 기준으로 같은지 밝혀야 합니다.

토양수분은 정전용량 센서 지시값(%) 기준이며, 두 처리군의 지시값 평균을 일치시켰다. 지시값은 체적수분율의 비선형 변환이므로, 체적수분율 기준으로도 평균이 일치한다고 보장되지 않는다.

이 문장이 없으면 “곡률을 재는 실험인데 축 자체가 휘어 있다”는 지적을 받습니다. 곡률의 부호는 이 변환에 대해 대체로 견고하지만, 명시해 두는 것이 정직하고 방어에도 유리합니다.

결론부에는 6주차 파괴 측정이 최종 심판이라는 점을 두세요. 투영면적은 잎이 겹치면 포화하므로 생장률 비교에는 충분하지만 절대값은 과소평가입니다.

◀ 이전다음 ▶

## 15용어 · 사전 측정

밴드의 천장과 바닥을 정합니다. 센서의 눈금이 아니라 식물의 한계로.

### 왜 "25%"라는 숫자만으로는 안 되나

우리 센서의 %는 공기 중을 0, 물속을 100으로 놓고 잰 값일 뿐입니다. 상추가 그 숫자를 아는 게 아닙니다. 센서 눈금의 양 끝은 식물이 가서는 안 되는 곳입니다.

천장은 흙이 정하고, 바닥은 식물이 정한다. 우리는 그 사이에서만 논다.

### 용어 둘 — 쉬운 말로

용어 | 쉬운 말 | 무엇의 성질인가
포장용수량 (圃場容水量) | 흠뻑 준 뒤 물이 다 빠지고 남은 양 = 더 못 담는 지점 | 흙의 성질 → 재지 않아도 됨 물리가 알아서 자름
위조점 (萎凋點 · wilting point) | 시들기 시작하는 지점 萎凋 = 시듦 | 식물이 정함 → 이것만 잼 잎이 알려줌

컵에 물 붓기와 같습니다 화분에 물을 부으면 밑으로 줄줄 흐르다 멈춥니다. 더 부어도 밑으로만 빠집니다. 그 "더 못 담는 상태"가 포장용수량입니다. 컵 크기가 정해져 있는 것과 같습니다.

### ★ 먼저 — 화분별로 정밀하게 맞출 필요가 없습니다

n=3에서 결과를 흔드는 것들의 크기 순서를 보세요.

잡음원 | 크기
상추 개체차 | RGR의 20~30%
센서 편차 (DRY/WET 보정 후) | 밴드의 3~5%
화분별 흙 다짐 차이 | 그보다 작음

개체차가 압도적입니다. 그 옆에서 센서 3%를 다듬는 건 정밀도를 올린 게 아니라 복잡도만 올린 것입니다.

정밀도는 화분별이 아니라 그룹별로만 필요합니다 화분 3번과 5번의 임계값이 정확히 같은가 → ❌ 불필요. 무작위 배정이면 잡음이 되어 상쇄됨
꾸준군과 널뜀군의 평균이 같은가 → ✅ 필수. 어긋나면 편향이 되어 처리와 얽힘

차이는 잡음이냐 편향이냐입니다. 그래서 "평균 일치" 하나만 남기고 나머지는 놓아도 됩니다.

★ 그래서 공짜로 얻는 조치 하나 — 센서를 제비뽑기로 배정하세요 센서를 순서대로 꽂지 마세요. 이 한 번의 조치가 센서 편차를 편향에서 잡음으로 바꿉니다. 정밀 보정보다 이게 더 중요하고, 비용이 0입니다. 처리(꾸준/널뜀) 배정도 마찬가지로 무작위.

### 상한 — 재지 않습니다. 흙이 잘라줍니다

포장용수량은 물리가 알아서 정합니다 더 못 담는 지점 위로 부으면 물이 밑으로 빠져나가고, 몇 시간이면 저절로 내려옵니다. 우리가 재지 않아도 됩니다.

조건은 하나 — 배수가 자유로울 것. 구멍이 충분하고, 받침에 물이 고이지 않아야 합니다. 고이면 다시 빨아들여 상한이 안 잡힙니다.

상한 = 포화 − 15%. 포화(더 부어도 값이 안 오르는 지점)는 아래 코드가 30분에 찾아줍니다.

calib_sat.ino — 포화점 자동 탐지 (화분당 30분)

/* 조금 붓고 -> 기다리고 -> 재기를 반복. 더 안 오르면 = 포화.
 * ★ '연속 공급'이 아니라 '버스트 + 대기'인 이유:
 *   센서는 화분의 한 지점에만 있어 물이 도달하는 데 몇 분 걸립니다.
 *   연속으로 부으면 그동안 값이 안 움직여 '평탄하다'고 오판하거나,
 *   타임아웃을 길게 잡으면 그동안 계속 부어 넘칩니다.
 */
#include <M5Unified.h>
const int  PIN_PUMP = 9;                  // 실측 확정: PUMP_EN = G9
const int  PIN_SOIL = 8;                  // 실측 확정: Analog = G8
const int  SOIL_DRY = 3200, SOIL_WET = 1400;   // ★ DRY/WET 보정값으로 교체

const float         EPS       = 1.0;      // %p — 센서 잡음의 3배 이상
const unsigned long BURST_MS  = 2000;
const unsigned long WAIT_MS   = 300000;   // 5분 — 물이 센서까지 도달할 시간
const int           MAX_BURST = 30;       // 안전 상한

float soilPct(int raw) {
  float v = 100.0f * (SOIL_DRY - raw) / (float)(SOIL_DRY - SOIL_WET);
  return v < 0 ? 0 : (v > 100 ? 100 : v);
}

void setup() {
  auto cfg = M5.config(); M5.begin(cfg);
  pinMode(PIN_PUMP, OUTPUT); digitalWrite(PIN_PUMP, LOW);
  Serial.begin(115200);
  analogReadResolution(12);

  float before = soilPct(analogRead(PIN_SOIL));
  for (int i = 1; i <= MAX_BURST; i++) {
    digitalWrite(PIN_PUMP, HIGH); delay(BURST_MS);
    digitalWrite(PIN_PUMP, LOW);
    delay(WAIT_MS);                                  // ★ 도달 대기 — 없으면 오판
    float after = soilPct(analogRead(PIN_SOIL));
    Serial.printf("burst %2d : %.1f -> %.1f  (+%.1f)\n", i, before, after, after-before);
    if (after - before < EPS) {
      Serial.printf("\n>> 포화 = %.1f%%   => 상한(OFF_AT) = %.1f%%\n", after, after - 15.0);
      break;
    }
    before = after;
  }
}
void loop() {}

MAX_BURST를 넘도록 안 멈추면 물이 밑으로 다 빠지고 있거나(구멍이 큼 / 흙이 너무 성김), 튜브가 빠진 것입니다.

### 하한 — 이것만 잽니다. 대신 못 뺍니다

위아래가 대칭이 아닙니다 위쪽에는 물리적 평탄점이 있습니다 — 포화. 더 못 담으니 값이 멈추고, 펌프가 그 지점을 찾을 수 있습니다.
아래쪽에는 그런 게 없습니다. 흙은 점점 느려질 뿐 계속 마릅니다. 어디서 멈춰야 할지 흙이 안 알려줍니다. 알려주는 건 잎입니다.

위: 물리가 정함 / 아래: 생물이 정함

⚠️ "마르다가 평탄해지면 급수" 로직을 만들면 안 됩니다 흙은 안 멈추므로 "변화 없음"은 결국 "변화가 센서 잡음보다 작아짐"이고, 그 지점은 잡음 크기가 정합니다.
더 심각한 건 고장 방향입니다: 센서가 얼어붙으면(I2C 락업·단선) 값이 안 변합니다 → 그걸 급수 신호로 삼으면 고장 = 물 붓기가 됩니다. 상한 쪽은 반대로 고장 시 펌프가 멈춰 안전합니다.

#### ★ 작은 화분을 쓰면 2주가 3일이 됩니다

화분 | 담긴 물 | 모종이 하루에 쓰는 양 | 시들 때까지
본실험 화분 | ~300 mL | ~20 mL | 15일
작은 화분 (300mL) | ~60 mL | | 3일

시드는 지점은 흙의 성질이라 화분 크기와 무관합니다. 도달하는 시간만 달라집니다.

1. 1주차(기준선 기간)에 솎아낸 여분 개체를 작은 화분에 옮겨 심습니다 — 어차피 버릴 것
2. 흠뻑 준 뒤 물을 끊습니다. 노드가 5분마다 알아서 기록합니다
3. 오후에 잎이 처지면 → 그때 센서값 기록 ___ %
4. 물을 주지 말고 밤을 넘깁니다
5. 아침에 회복했으면 → 아직 여유. 계속 관찰 / 회복 못 했으면 → 지나쳤음. 3번 값을 씀

펌프를 막는 법 — 코드 수정 없이

float ON_BELOW = 0.0;   // 수분%는 0 아래로 안 내려가므로 펌프가 절대 안 켜짐
                        // = 관찰 전용 모드

두 가지 시듦 — 이 구분이 전부입니다 낮에 축 처짐 → 잠깐 힘든 것. 밤에 저절로 회복. ← 우리가 쓸 하한
말라 비틀어짐 → 망가진 것. 회복 안 됨. ← 이미 늦음. "절대 금지" 표시로만

여름 낮에 화분이 처졌다가 저녁에 멀쩡해지는 것 — 그게 첫 번째입니다. 흔하고 죽지 않습니다. 영구히 시든 뒤에는 옌센이 아니라 피해를 재는 것이 됩니다.

### 밴드 확정 — 마진 15%가 정밀 보정을 대체합니다

널뜀군 (6개 화분 공통값) OFF_AT = 포화 − 15% ___
ON_BELOW = 시드는 지점 + 15% ___

꾸준군 = 널뜀군 4일 예비 가동 후 실측 평균을 중심으로 폭 최소

마진이 보정 오차를 흡수합니다 센서가 3%p 어긋나 있어도 15% 마진이 덮습니다. 이게 이 설계의 핵심 미덕입니다 — 정밀하게 맞추는 대신 여유를 두는 것. 어차피 개체차가 그보다 훨씬 크니 이득이 없습니다.

하한은 정확할 필요가 없습니다 — 안전하면 됩니다 하한을 높게(보수적으로) → σ가 작아짐 → 검정력 손해 → "차이를 못 찾았다"로 정직하게 보고 가능
하한을 낮게(공격적으로) → 화분이 죽음 → 실험 전체 소멸

비대칭입니다. 애매하면 올리세요.

### ★ 파수꾼 화분 — 보험 하나

여분 개체 하나를 본실험 리그에 같이, 밴드만 5%p 더 낮게 이 화분이 먼저 시듭니다. 시들면 → 하한이 너무 낮다는 신호 → 본실험 6개는 아직 안전할 때 알 수 있습니다.

데이터에 안 쓰는 화분이라 시들어도 손해가 없습니다. 노드 1대 + 화분 1개 값으로 6개를 잃을 위험을 삽니다.

### 필요한 것 — 이게 전부입니다

무엇 | 언제 | 얼마나
센서별 DRY/WET 보정 | 데모 | 센서당 2분. 못 뺌 — 이게 없으면 "공통 임계값"이 무의미
포화점 | 데모 | calib_sat.ino 30분
시드는 지점 | 1주차 | 작은 화분, 3~4일. 공통값으로 사용
널뜀군 실측 평균 | 1주차 말 | SQL 한 줄

삭제된 것 — 안 해도 됩니다 ❌ 포장용수량 24시간 배수 측정 ❌ 화분별 θ 환산 ❌ 여분 개체 2주 선파종
전부 개체차보다 작은 오차를 다듬는 일이었습니다.

⚠️ 남은 가정 — 보고서에 쓰세요 시드는 지점은 여분 개체 1~2개에서 재어 여섯 화분에 공통으로 적용합니다. "같은 흙이면 시드는 지점도 같다"는 가정이고, 흙 배합이 같으니 나쁘지 않지만 가정은 가정입니다.
그리고 큰 식물은 더 젖은 흙에서도 시듭니다 — 작은 모종으로 잰 값은 6주차와 다릅니다. "이 값은 2주차 크기 기준"이라고 명시하세요.

◀ 이전다음 ▶

## 16실험 설계

다섯 줄이면 끝납니다. 나머지는 이 다섯 줄을 실제로 지키기 위한 잔손질입니다.

### 뼈대 — 다섯 줄

이것이 전부입니다 ① 화분 6개. 빛·온도·흙·씨앗·파종일 전부 동일
② 3개는 꾸준 — 수분을 좁게 붙들어 둠
③ 3개는 널뜀 — 말랐다가 채웠다가
④ 두 그룹의 평균 수분은 같게 ← 이게 전부다
⑤ 매일 잎 면적 촬영 → 자라는 속도 비교

### 어려운 건 딱 하나 — ④

"평균을 같게"가 저절로 안 됩니다.

밴드 한가운데가 40%여도 실제 시간평균은 34.5%다. 계산으로 알 수 없다.

널뜀군의 평균은 밴드 한가운데가 아닙니다 "25~55%를 오가면 평균 40%"는 흙이 일정한 속도로 마를 때만 맞습니다. 실제로는 젖었을 때 빨리 마르고 마를수록 천천히 마릅니다 → 아래쪽에 더 오래 머묾 → 평균이 내려갑니다.

널뜀군이 평균 34.5%인데 꾸준군을 40%에 두면 변동성 실험이 아니라 그냥 물 양 실험으로 퇴화합니다.

해결 — 계산하지 말고 재세요 ① 여분 화분 1개에 널뜀 방식을 먼저 4일 돌립니다
② 5분 로그의 평균을 냅니다 → 예: 34.5%
③ 꾸준군을 그 값에 맞춥니다 (40%가 아니라 34.5%)

이것이 이 실험에서 시스템이 필요한 유일하고 결정적인 이유입니다. 손으로는 이 숫자를 알아낼 방법 자체가 없습니다.

### 순서가 뒤집힙니다 — 널뜀군을 먼저

📏사전 측정밴드의 끝을 식물에게 물어봄

포화점 — 데모에서, 30분

calib_sat.ino → 천장 = 포화 − 15% · 패널 尺

시드는 지점 — 1주차, 작은 화분 3~4일

솎아낸 개체에 물 끊기 → 오후에 처지는 값 → 바닥 = 그 값 + 15% · 패널 尺

▼

🌊널뜀군 확정먼저 만들어야 기준이 생김

밴드 = 천장 아래 ~ 바닥 위, 최대 폭

σ²이 제곱으로 들어가므로 폭을 2배 = 효과 4배

예비 가동 4일 → 실측 평균

SELECT AVG(pct) FROM soil

▼

🎯꾸준군 확정널뜀군의 실측 평균에 맞춤

중심 = 널뜀군 실측 평균

임의의 "특정값"이 아님

폭 = 가능한 한 좁게

하한 = max(1회 급수 상승폭, 센서잡음×3)

▼

🌱본실험1주 기준선 → 처리 투입 → 6주 수확

주 1회 평균 재계산 → 꾸준군 setpoint 갱신

식물이 자라면 마르는 속도가 바뀜 → 평균도 흘러감

### 두 처리군 설정값

| 널뛰는 그룹 | 꾸준한 그룹
OFF_AT (천장) | 포화 − 15% ___ | 실측 평균 + 폭/2
ON_BELOW (바닥) | 시드는 지점 + 15% ___ | 실측 평균 − 폭/2
화분별 조정 | 없음 — 6개 공통값. 대신 센서·처리를 무작위 배정
DOSE_MS | 크게 (1~2회로 채움) | 작게 (조금씩)
밴드 폭 | 최대 | 최소
화분 | 3 (p4·p5·p6) | 3 (p1·p2·p3)

⚠️ 센서 최대값을 천장으로 삼지 마세요 센서 100%는 물속입니다. 흙이 거기 가면 뿌리가 질식합니다. 게다가 포장용수량 위로는 물을 부어도 센서값이 안 올라갑니다 — 밑으로 빠지니까요. 펌프만 돌고 물통만 비고 verify_fail이 뜹니다.
침수와 고사는 곡선의 휨이 아니라 손상입니다. 그 구간을 포함하면 재는 게 더 이상 옌센이 아닙니다.

### 밴드 폭 — 위아래로 한계가 있습니다

옌센 차이의 크기는 대략 ½ · |f″| · σ². σ가 제곱으로 들어가므로 폭을 2배로 넓히면 차이가 4배가 됩니다. n=3의 약한 검정력을 이길 유일한 방법입니다.

한계 | 왜
천장 — 포장용수량 | 넘기면 물이 그냥 빠짐. 수분 안 오르고 침수 위험
바닥 — 시드는 지점 + 여유 | 아래로 가면 손상. 옌센과 무관한 다른 메커니즘
꾸준군 폭의 하한 | 1회 급수 상승폭보다 좁으면 한 번에 넘어감 센서잡음×3보다 좁으면 잡음을 수분변화로 오인해 헛급수

진폭은 붙들고, 주기는 흘려보내세요 식물이 자라면 증산이 늘어 더 빨리 마릅니다 → 주기가 짧아집니다. 막을 수 없고 막을 필요도 없습니다. 옌센에 들어가는 건 σ² — 흔들림의 크기이지 빈도가 아닙니다.
임계값 제어는 진폭을 고정하고 주기를 놓아줍니다. 반대로 "3일마다 급수" 같은 시간 기반은 주기는 고정되지만 진폭이 제멋대로가 됩니다. 붙들어야 할 쪽은 진폭입니다.
주기는 pump_log에 자동 기록되니 "1주차 3.2일 → 5주차 1.4일"로 보고하면 됩니다. 통제 실패가 아니라 관찰 결과입니다.

### ⚠️ "변동성만 바꿨다"는 말은 틀립니다

정직하게 이름 붙이세요 밴드를 좁히려면 조금씩 자주 줄 수밖에 없고, 넓히려면 많이 가끔 줄 수밖에 없습니다. 기계적으로 묶여 있어 뗄 수 없습니다.

❌ "변동성만 조작했다"
✅ "관수 처방(irrigation regime)을 조작했다 — 소량 빈번 vs 다량 간헐. 평균 수분은 동일."

변동성은 바꾼 것이 아니라 바뀐 결과 중 하나입니다. 없앨 수 있는 흠이 아니라 이름을 바로 붙여야 하는 것입니다. 옌센은 처리의 이름이 아니라 "왜 차이가 날 것으로 예상하는가"의 근거로 들어갑니다.

### ★ 총 투입 수분량은 맞추지 않습니다 — 맞추면 안 됩니다

흔한 오해입니다 — "변동성만 다르게 하려면 두 그룹의 총 급수량은 같아야 공정한 것 아닌가?" 직관적이지만 정반대입니다. 총량을 맞추는 순간 실험이 틀어집니다. 이유가 세 겹입니다.

① 옌센에 들어가는 건 총량이 아니라 평균입니다 부등식의 양변은 E[f(w)]와 f(E[w])입니다. 여기 들어가는 w는 토양수분(흙이 머금은 상태)이지 우리가 부은 물의 총량이 아닙니다.
맞춰야 하는 건 E[w] — 시간에 걸친 평균 토양수분 하나뿐입니다. 총 투입량은 이 식 어디에도 없습니다. 식물이 겪는 건 "흙이 얼마나 젖어 있었나"이지 "물을 몇 mL 부었나"가 아니니까요.

② ★ 총 급수량은 우리가 정하는 값이 아니라 결과입니다 펌프는 식물이 쓴 만큼 보충할 뿐입니다. 그러니 총 급수량은 생장을 따라옵니다:
· 널뜀군이 덜 자라면 → 잎이 적어 물을 덜 씀 → 총 급수량도 적음
· 널뜀군이 더 자라면 → 물을 더 씀 → 총 급수량도 많음

총 급수량은 생장의 결과이지 원인이 아닙니다. 그걸 억지로 맞추는 건 결과를 조작해 원인을 통제하려는 것 — 인과가 거꾸로입니다.

③ 맞추려고 하면 진짜 통제 변수(평균)가 깨집니다 "총량을 같게" 강제하면? 널뜀군이 덜 자라 물을 덜 쓰는데 꾸준군과 총량을 맞추려면 억지로 더 부어야 합니다. 그러면 흙이 계속 젖은 채 유지되어 평균 토양수분이 올라갑니다.
총량을 맞추는 순간 맞춰야 할 E[w]가 어긋납니다. 둘을 동시에 맞출 수 없고, 맞춰야 하는 건 평균입니다.

양 | 지위 | 어떻게
변동폭 σ | 조작 — 처리 조건 | 밴드 폭으로 설정
평균 토양수분 μ | 통제 — 두 그룹 같게 | 널뜀군 실측 평균에 꾸준군을 맞춤
총 급수량 | 결과 — 맞추지 않음 | pump_log의 dur_ms 합계로 보고만

그럼 총 급수량은 버리나 — 아니요, 결과 지표로 씁니다 생장 차이를 옆에서 확인해주는 증거입니다:
"널뜀군의 총 급수량이 꾸준군보다 12% 적었다 — 널뜀군이 덜 자라 증산이 적었음을 뒷받침한다."
통제 대상이 아니라 관찰값입니다.

비유 — 두 사람 다이어트 ❌ 먹은 총 칼로리를 똑같이 → 활동량 다른데 억지로 같은 양을 먹임 → 엉뚱한 실험
✅ 평균 혈당을 똑같이 → 먹는 패턴(몰아서 vs 나눠서)만 다르게. 총량은 각자 몸이 정함

우리가 조작하는 건 "어떻게 젖게 하느냐", 통제하는 건 "평균이 얼마나 젖어 있었나", 총 급수량은 그 결과로 따라 나오는 값입니다.

### ★ 사전등록 — 파종 전에 적고 날짜를 박으세요

가장 값싸고 가장 효과 큰 조치 가장 흔한 실패는 결과를 본 뒤 "옌센 부등식으로 설명된다"고 갖다 붙이는 것입니다. 어느 방향이 나와도 사후에 말을 만들 수 있으므로, 그건 아무것도 검정하지 않은 것입니다.

만약 이렇게 나오면 | 이렇게 해석한다 (미리 작성)
널뜀군 RGR 낮음 | 이 구간이 오목. 정적 근사 유효
널뜀군 RGR 높음 | 볼록 구간 우세, 또는 경화 효과 — 정적 모형으로 설명 불가
차이 없음 | 이 구간이 거의 선형이거나, 이력 효과가 옌센 손실을 상쇄

"유의한 차이가 나와야 한다"는 생각을 버리세요 유의성이 나오도록 설계를 맞추면, 나온 결과는 검정이 아니라 원하는 답을 얻은 것입니다. 게다가 n=3에서는 진짜 효과가 있어도 p<0.05가 안 나오는 게 정상입니다.

대신: 안전한 최대 폭을 쓴다. 그러고도 차이가 없다면 그 자체가 결과다.
폭을 최대로 밀었는데도 차이가 없다 → 발견입니다. 폭을 좁게 잡고 차이가 없다 → "폭이 작아서인지 원래 없어서인지 모름" → 아무 정보 없음.
밴드를 최대로 미는 진짜 이유는 유의성이 아니라 무결과를 의미 있게 만들기 위해서입니다.

### 일정

시기 | 할 일 | 얻는 것
0주 — 데모 식물 없음 | 하드웨어·소프트웨어 루프 검증. 흙만 담은 화분 1개로 · 센서→MQTT→DB→화면이 24h 도는가 · 임의 밴드(예 30~55%)로 톱니가 생기는가 · verify_fail이 잡히는가 | 아키텍처 확정 DRY/WET 보정 포화점 주기 → 화분 크기
0주 말 | 본파종 (6개 + 여분). 전부 꾸준 조건
1주 | 기준선 — 6개 전부 같은 조건. 솎아내기 솎아낸 개체 → 작은 화분에 옮겨 말리기 여분 1개 → 파수꾼(밴드 5%p 낮게)으로 리그에 설치 | 개체차 파악 시드는 지점 → 밴드 확정
1주 말 | 널뜀 예비 가동 4일 (여분 화분 1개) | 실측 평균 → 꾸준군 중심
2주 | 처리 투입. 센서·처리 무작위 배정
3~5주 | 주 1회 평균 재계산 → 꾸준군 setpoint 확인 (안 움직이면 그대로)
6주 | 파괴 측정 — 실제 잎면적·생중량·건중량·뿌리

★ 데모(0주)가 곧 예비실험입니다 — 일정 손해가 없습니다 식물이 없어도 대부분이 나옵니다. 시드는 지점만 식물이 필요한데, 그건 1주차 솎아내기와 겹칩니다.
그리고 데모의 주기 측정이 화분 크기를 정합니다 — 파종 전에 나와야 하는 유일한 값입니다.

1주차 "전부 동일" 구간을 빼지 마세요 이 구간이 알려주는 것은 "원래 개체마다 얼마나 다른가"입니다. 이걸 모르면 6주 뒤 두 그룹이 달라도 "처리 때문인지, 원래 그런 개체였는지" 판단할 근거가 없습니다.

배치 — A,A,A / B,B,B로 몰지 마세요 한쪽에 몰면 위치 효과와 교락됩니다. 무작위·교대로 배치하고, 한 번 정한 뒤 화분은 절대 움직이지 마세요 (ROI 좌표 고정).

◀ 이전다음 ▶

## 17측정 계획

무엇을, 어떤 간격으로, 왜 재는가. 간격은 그 값이 얼마나 빨리 변하느냐로 정합니다.

### 상시 측정 — 자동

무엇 | 간격 | 누가 | → 테이블 | 왜 이 간격인가
토양수분 | 5분 | 급수 노드 ×6 | soil | 이 실험의 X. 톱니 모양을 그려야 하므로 가장 조밀하게. 평균·σ² 계산의 원자료
급수 이벤트 | 일어날 때 | 급수 노드 | pump_log | 주기·총량·고장(verify_fail) 기록
온·습도 | 5분 | 환경 노드 ×1 | readings | 통제가 지켜졌음을 증명하는 용도. 재배함 전체에 공통이라 1대면 충분
조도 | 5분 | 환경 노드
CO₂ | 5분 | 환경 노드
잎 면적 (새벽) | 1일 1회 새벽 고정 | Pi + 카메라 | growth phase='dawn' | 종속변인 — RGR은 이것으로만. 팽압이 회복된 상태. 오후에 찍으면 처짐이 생장으로 오인됨
잎 면적 (오후) | 1일 1회 오후 고정 | Pi + 카메라 | growth phase='pm' | 처짐 지수용. 생장이 아니라 수분 스트레스 측정 → 처리 작동의 독립 증거

촬영은 반드시 같은 시각에 잎은 낮에 처지고 밤에 펴집니다. 촬영 시각이 흔들리면 성장이 아니라 잎의 자세를 재게 됩니다. systemd 타이머로 매일 같은 시각 고정 (Persistent=true로 놓친 촬영도 실행).

n 필드를 매일 보세요 5분 ÷ 10초 = n≈30이 정상. 20 이하면 I2C 불안정 또는 WiFi 재연결이 루프를 잡아먹는 중입니다. 값 자체는 멀쩡해 보이는데 n만 낮은 경우가 흔합니다 — 대시보드보다 n을 먼저.

### 사전 측정 — 1회, 손으로

무엇 | 언제 | 방법 | 정하는 것
포장용수량 | −1주 | 흙만 담은 화분, 흠뻑 → 비닐 → 24h | 널뜀군 천장
시드는 지점 | −1주 | 여분 개체, 물 끊고 관찰 | 널뜀군 바닥
1회 급수 상승폭 | 데모 | 계량컵 + 로그 | 꾸준군 폭의 하한, DOSE_MS
센서 잡음 | 데모 | 가만히 둔 흙 24h → 표준편차 | 꾸준군 폭의 하한
널뜀군 실측 평균 | 0주 | 예비 가동 4일 → AVG(pct) | 꾸준군 중심
조도 균일도 | −1주 | 조도계를 6칸에 순회 | "환경 공통"의 근거
ArUco 실측 | 설치 | 자로 인쇄물 한 변 | marker_mm

### 주간 측정 — 매주 일요일 5분

널뜀군의 실제 평균 확인 → 꾸준군 setpoint 갱신

-- 지난 7일, 그룹별 실제 평균과 표준편차
SELECT treat,
       COUNT(*)                                        AS n,
       ROUND(AVG(pct), 2)                              AS mean,
       ROUND(SQRT(AVG(pct*pct) - AVG(pct)*AVG(pct)),2) AS sd
FROM soil
WHERE ts > datetime('now','-7 days')
GROUP BY treat;

★ 이 표 한 줄이 실험 성립의 증명서입니다 mean이 두 그룹에서 같고 sd만 다르면 → 설계 성공. 옌센의 양변에 넣을 숫자가 확보됨
mean이 어긋나면 → 변동성 실험이 아니라 물 양 실험으로 퇴화. 꾸준군 밴드를 옮겨 교정

보고서의 첫 번째 표가 이것이어야 합니다. 결과 그래프보다 먼저.

### 파괴 측정 — 6주차, 딱 한 번

무엇 | 방법 | 왜
실제 잎 면적 | 잎을 다 떼어 겹치지 않게 펼쳐 촬영 | 투영 캐노피 면적이 얼마나 과소평가했는지 수치화
생중량 | 수확 직후 저울 | 수분 포함 총량
건중량 | 70°C 48시간 건조 후 저울 | 진짜 생장량. 픽셀↔건중량 R² 확보
뿌리 (선택) | 흙 털어내고 건조 | 널뜀군이 뿌리를 더 뻗었는지 = 경화의 증거

뿌리를 재두면 세 번째 결과를 설명할 수 있습니다 "널뜀군이 더 자랐다"가 나왔을 때, 뿌리가 더 발달했다면 경화 효과의 물증이 됩니다. 뿌리 없이는 "왜 그런지 모르겠다"로 끝납니다. 어차피 화분을 엎을 거니 추가 비용이 0입니다.

투영 캐노피 면적 — 이름을 바로 쓰세요 위에서 찍으면 겹친 잎은 한 장으로 셉니다. 실제 잎 면적보다 항상 작습니다. 성장 추세를 보는 데는 문제없지만 "잎 면적을 쟀다"고 말하면 틀린 말입니다. 6주차 파괴 측정으로 관계식을 구해야 대리지표로서의 지위가 생깁니다.

### ★ 학생이 반드시 묻는 질문 — "그냥 점 찍으면 되잖아요?"

질문 "수분도 5분마다 재고 잎 면적도 매일 재잖아요. 그럼 가로축에 수분, 세로축에 그날 자란 정도로 점을 쭉 찍으면 곡선이 그냥 나오는 것 아닌가요? 왜 굳이 두 그룹으로 나눠서 비교해요?"

아주 좋은 질문이고, 데이터는 정말 거기 있습니다. 그런데 안 됩니다. 이유가 재미있습니다.

#### 사진으로 생각하면 바로 이해됩니다

셔터를 1초 열고 달리는 사람을 찍으면 사진이 흐리게 뭉개집니다. 그 사진을 보고 "이 순간 사람이 어디 있었나"를 알 수 있나요? 없습니다. 사진 한 장이 이미 1초 동안의 평균이니까요.

우리 카메라의 셔터는 "하루"입니다. 하루에 한 번밖에 못 찍으니까요. 그런데 그 하루 동안 널뛰는 화분의 흙은 45%에서 28%까지 계속 흘러갑니다.

그러니 점 하나가 뜻하는 건 "수분 36%일 때의 성장"이 아니라 "수분이 45%에서 28%로 흘러가는 동안의 뭉개진 평균 성장"입니다.

점 하나가 이미 평균입니다. 그러니 그 점들을 이어 봐야 나오는 건 참 곡선이 아니라 뭉개진 곡선입니다.

널뜀군의 점은 그날 뭉개진 만큼 아래로 밀린다. 꾸준군은 흔들림이 없어 곡선 위에 남는다.

⚠️ 게다가 이 편향이 결론을 자동으로 만들어냅니다 널뜀군은 많이 흔들려서 많이 밀리고, 꾸준군은 안 흔들려서 안 밀립니다. 두 그룹의 점을 합쳐서 곡선을 그으면 널뜀군 점들이 아래로 잡아당겨 실제보다 더 오목해 보입니다.

즉 우리가 확인하려는 결론이 그림 그리는 과정에서 저절로 만들어집니다. 이런 그래프로는 아무것도 검정할 수 없습니다.

#### "그럼 더 자주 찍으면 되잖아요?" — 안 됩니다

사진 비유를 이어가면 답이 나옵니다. 셔터를 빨리 닫으면 흐림은 줄지만 사진이 어두워집니다. 우리도 똑같습니다 — 간격을 줄이면 뭉개짐은 줄지만 "자란 양"이 측정 오차보다 작아집니다.

촬영 간격 | 그 사이 자란 양 | 측정 오차 | 판정
5분 | 0.03% | 약 2% | ❌ 오차에 완전히 묻힘
1시간 | 0.4% | | ❌ 여전히 묻힘
반나절 | ~5% | | △ 겨우 — 그런데 밤이 섞임
1일 | ~10% | | ✅ 쓸 만함

반나절도 안 되는 이유 — 밤에는 광합성이 0입니다 반나절은 낮/밤 경계를 걸칩니다. 그러면 수분이 아니라 빛을 재게 됩니다. 하루 단위가 사실상 물리적 최소값입니다.

★ 이건 고칠 수 있는 실수가 아니라 물리적 한계입니다 식물이 반응하는 시간(분~시간)이 우리가 잴 수 있는 최소 간격(하루)보다 훨씬 빠릅니다.
두 시간 규모가 분리되지 않습니다. 장비를 아무리 좋게 해도, 자란 양이 오차보다 커지려면 시간이 필요하고, 그 시간 동안 흙은 이미 말라 있습니다. 그래서 곡선을 점별로 볼 방법이 원리적으로 없습니다.

#### 그리고 그건 "실험"이 아니라 "관찰"입니다

널뜀군 안에서 날마다 평균 수분이 다른 이유는 급수 직후냐 3일차냐일 뿐입니다 — 우리가 무작위로 배정한 게 아닙니다. 그리고 그건 시간과 얽혀 있고, 시간은 식물의 나이·크기와 얽혀 있습니다.

이 프로젝트 맨 처음의 문제가 그대로 돌아온 것입니다 관찰 데이터로는 인과를 뽑을 수 없습니다. 이 실험에서 무작위로 배정된 것은 딱 하나 — "어느 화분이 꾸준군이고 어느 화분이 널뜀군인가"뿐입니다. 그래서 그룹 간 비교만이 유일하게 인과를 말할 수 있는 대비입니다.

#### 그래도 산점도는 그리세요 — 세 가지 쓸모

쓸모 | 어떻게
① 일관성 검사 | 산점도의 휨으로 예상 차이를 계산 → 실제 그룹 간 차이와 비교. 실제가 예상보다 작으면 → 식물이 대비했다는 증거 (H₂의 물증)
② 다음 실험 설계 | 뭉개졌어도 곡선이 꺾이는 지점의 힌트는 줌 → 후속 연구의 밴드 위치
③ 고급 — 뭉개짐 걷어내기 | 그날의 표준편차도 5분 로그에 있으므로, 그것까지 함께 넣어 회귀하면 원리적으로 편향을 보정할 수 있음. 다만 이 데이터로는 식별력이 약함 — "시도했다"까지가 정직한 선

보고서에는 이렇게 쓰세요 "각 점은 그날의 평균 수분과 그날의 생장속도이며, 생장속도 자체가 그날 수분 변화에 대한 평균이므로 이 산점도는 수분–생장 곡선의 편향된 추정이다. 편향은 그날의 변동폭에 비례하여 널뜀군에서 크다. 따라서 이 그림은 탐색적 목적으로만 제시하며, 주 결과는 그룹 간 비교에 근거한다."

이 문단을 쓸 수 있으면 이미 연구자입니다. 데이터가 있다는 것과 그 데이터가 질문에 답한다는 것은 다른 문제이고, 그 차이를 아는 것이 과학의 핵심이니까요.

### ★ 분석 순서 — 반드시 이 순서로

①통제 확인먼저 이것부터. 결과 그래프는 나중

빛·온도·CO₂가 정말 같았나

readings. 여기가 깨지면 아래 전부 무의미

▼

②처리 확인실험이 성립했는지

평균은 같고 σ만 달랐나 ★

위의 SQL. 평균이 어긋났으면 여기서 중단

▼

③기준선원래 얼마나 달랐나

1주차에 두 그룹이 비슷했나

개체차의 크기 파악

▼

④결과비로소 여기

RGR 비교 + 효과크기

사전등록한 3칸 표에 비추어 해석

센서의 1차 용도는 그래프가 아니라 통제의 증명입니다 "널뜀군이 덜 자랐다"가 나와도, 알고 보니 널뜀군 자리가 더 어두웠다면 그건 변동성의 효과가 아닙니다. 환경 노드는 예쁜 그래프를 그리려고 있는 게 아닙니다.

### 보고 — 효과크기를 함께

n=3에서 p > 0.05는 "차이가 없다"가 아닙니다 반복이 3이면 검정력이 매우 약해 진짜 차이가 있어도 p값이 안 나오는 게 정상입니다.

❌ "변동성은 생장에 영향을 주지 않았다"
✅ "n=3의 제한된 반복에서 널뜀군의 RGR이 평균 24% 낮았으나(Cohen's d = 1.2) 통계적 유의성에는 이르지 못했다. 이는 차이 없음이 아니라 검정력 부족으로 해석되며, 반복수 확대가 필요하다."

보고서에 반드시 들어갈 표 | 내용
1. 통제 확인 | 온·습·조도·CO₂의 기간 평균과 변동
2. 처리 확인 ★ | 그룹별 수분 평균 · 표준편차 · 표본수
3. 관수 기록 | 그룹별 총 급수량, 급수 주기의 변화 (관찰값)
3-b. 처짐 지수 | (새벽−오후)/새벽. 널뜀군이 크면 처리가 작동한 독립 증거 — 토양수분 로그와 다른 경로
4. 기준선 | 1주차 개체별 면적
5. 결과 | RGR 평균·표준편차·Cohen's d
6. 검증 | 투영 면적 ↔ 건중량 R²

◀ 이전다음 ▶

## !트러블슈팅

### 통신

증상 | 원인 · 조치
MQTT rc=-2 반복 | ① PC 방화벽 (1순위) ② 학교망 클라이언트 격리 → 폰 핫스팟 ③ BROKER IP 오타. PC 자체 mosquitto_sub는 되는데 노드만 안 되면 ①②
시리얼엔 PUB인데 Explorer에 없음 | 망 문제 확정 — 같은 SSID인지, 격리인지
Explorer엔 있는데 run_collector.py에 없음 | run_collector.py의 BROKER·구독 토픽 확인
WiFi FAIL | ESP32는 2.4GHz만. 핫스팟이 5GHz 전용이 아닌지 확인
mosquitto가 안 뜸 | plant.conf에 한글이 섞였거나 경로 오타

### 센서

증상 | 원인 · 조치
I2C 스캔에 아무것도 없음 | 배선·전원 문제. 환경노드(R4): Base Shield 전원스위치 5V인지, I2C 포트에 꽂았는지, 케이블 딸깍 소리
값이 얼어붙음 (ts만 갱신) | I2C 락업. 물리적으로 불가능한 값(90°C 등)이면 확정. 펌웨어가 12회 실패 후 자동 복구
CO₂가 400ppm에 붙음 | SCD41 첫 유효값까지 수십 초. 계속되면 0x62 확인
온도가 실제보다 높음 | 정상. 단 대표값은 BME688 사용 — SCD41 자체 발열 1~3°C는 무시
n이 20 이하 | I2C 불안정 또는 WiFi 재연결이 루프를 잡아먹음
토양수분 0% 또는 100% 고정 | 보정값 미설정(패널 6) 또는 핀 잘못

### 급수

증상 | 원인 · 조치
펌프 켜면 Core S3 리셋 | 5V 부족 → 외부 5V 주입(패널 6). PC USB 말고 5V 2A 어댑터부터 시도
부팅하자마자 펌프가 돎 | 10k 풀다운 누락 + setup() 첫 줄 OUTPUT/LOW 확인
첫 급수마다 verify_fail | SOAK를 delay()로 짬 → 대기 중 수분값이 갱신 안 됨. 상태기계로 (패널 7)
펌프 소리는 나는데 물이 안 나옴 | 막힘. 흡입구에 입김을 불어 반대쪽으로 공기가 나오는지 확인 → 안 나오면 불량, 예비품 교체
물이 계속 나옴 | 사이펀 — 튜브 끝이 수면보다 낮음. 튜브를 물통보다 높게 올렸다 내리세요
급수했는데 수분이 안 오름 | 출수구가 측정판에서 먼 쪽이면 정상적으로 시간이 걸림. 20분으로 부족하면 SOAK 연장
verify_fail 후 안 돎 | 정상 동작(무장해제). 고친 뒤 노드 재부팅으로 재무장

### 카메라

증상 | 원인 · 조치
--list-cameras 비어 있음 | 케이블 (Pi 5 = 22핀!) · 방향 · 전원 끄고 재체결
Camera __init__ sequence did not complete | 다른 프로세스가 카메라 점유 중
ArUco 미검출 | 흐림·기울어짐·잘림·반사. 무광 인쇄, 평평하게
면적이 날마다 요동 | 1순위 자동노출·AF가 안 꺼짐 · 2순위 자연광 유입 · 3순위 촬영 시각 불일치
흙을 잎으로 잡음 | 이끼·초록 이물질 제거. MORPH_OPEN 증가
잎을 놓침 (과소) | 정반사 → 조명 45° 양방향. 배경이 밝으면 무광 검정으로
잎이 아예 안 잡힘 | 보라색 식물등을 쓰고 있지 않은지 (FAQ)

### 웹 UI · 촬영 루틴 (plantsvc) — 2026-09

증상 (저널 · 화면) | 원인 · 조치
camera lock held by pid N | 다른 프로세스가 data/camera.lock 을 쥐고 있음. plantsvc doctor 의 camera lock 행 · pgrep -af plantsvc 로 누가인지 확인. 예전 setup_camera.py 나 rpicam-hello 가 떠 있으면 종료. 죽은 프로세스의 pid 면 잠금은 커널이 이미 풀었으니 다시 시도
화면이 “web/dist missing” 안내(fallback 페이지) | 웹 UI 빌드가 없음 — API 는 살아 있음. scripts/install.sh --update --web=release(릴리스에서 받기) 또는 --web=build(node 필요) · PC 에서 deploy.ps1 -Web local
doctor ntp WARN not synchronized | 시계가 안 맞으면 05:50 이 05:50 이 아닙니다. timedatectl 확인 · sudo systemctl enable --now systemd-time-wait-sync (install.sh 가 켬) · 인터넷 없는 망이면 NTP 서버 지정
저널에 skipped … debounced | 정상. 같은 phase 를 30분 안에 이미 찍음(Persistent 보충·catch-up·손 실행 중복 방지). 시험용 재촬영은 plantsvc capture --force
조명(네오픽셀)이 UI 버튼에 반응하지 않음 | 노드 시리얼에 MQTT OK 가 있는지, 브로커(파이) IP 가 맞는지 확인. 웹 버튼은 plant/light/set 을 발행하므로 mosquitto_sub -t 'plant/#' -v 로 명령이 도는지 볼 수 있습니다 (패널 19)
미리보기가 멈추고 preview: paused_capture | 정상. 예약 촬영 시간창(촬영 1분 전 ~ 워밍업 + 5분) 또는 촬영 잡 진행 중. 끝나면 스스로 돌아옵니다. 급하면 /camera 에서 잡 취소
fake camera frame — not published · 사진 이름이 fake_… | 실제 Pi 에 PLANT_FAKE_HW=1(또는 PLANT_CAMERA=fake)이 잡혀 있음 — 셸 프로필·유닛 Environment 확인. 실측이 아니므로 발행이 막힌 것이 맞습니다. 카메라가 진짜로 안 잡혀 fake 로 떨어진 것이면 doctor camera 행
촬영은 되는데 /growth 에 DUMMY DATA 가 남음 | 발행이 planthub 에 안 닿음 — journalctl -u plantsnap 의 발행 실패 여부 · mosquitto_sub -t 'plant/tray/growth' · planthub 가 growth 토픽을 구독하는지. plantsvc replay 로 jsonl 에서 재발행
config.json 을 바꿨는데 타이머 시각·워밍업이 그대로 | schedule · led 는 유닛에 렌더돼 있음 — scripts/install.sh --update
Streamlit 시절 — verify_fail 경보가 한 번도 안 울림 | 펌웨어는 'verify fail'(공백)로 보내고 대시보드는 verify_fail 만 찾았음. 웹 UI 는 두 표기를 정규화해 같은 것으로 봅니다. 옛 대시보드로 롤백했다면 이 경보는 믿지 마세요
check_accuracy.py 가 measure() missing … 'phase' | 2026-07 판의 인자 누락 버그 — 고쳐졌습니다. git pull 뒤 uv run python hub/check_accuracy.py data/truth.json data/calib.jpg

### Windows 개발 PC

증상 | 원인 · 조치
import pydantic 이 “애플리케이션 제어 정책에 의해 차단되었습니다” (DLL) | Smart App Control 이 최신 pydantic-core 의 DLL 을 막음. pyproject.toml 이 win32 에서만 pydantic 2.10 을 고정하므로 uv sync --group dev 를 다시. 정책을 끄지 말 것 (패널 20)
콘솔의 한글이 ?·깨짐 · UnicodeEncodeError: 'cp949' | plantsvc 는 자체 처리. 다른 스크립트는 $env:PYTHONUTF8='1' 뒤 실행
deploy.ps1 이 “working tree is dirty” | 먼저 커밋하거나 -Force
deploy.ps1 이 ssh 단계에서 멈춤 | 키 로그인이 안 됨 — 스크립트가 찍어 주는 한 줄로 authorized_keys 등록 (비밀번호 1회)

진단 명령 모음

# 오가는 메시지 실시간 (PATH 미등록 시: & "C:\Program Files\mosquitto\mosquitto_sub.exe" ...)
mosquitto_sub -h localhost -t 'plant/#' -v

# DB 확인 -- sqlite3 CLI가 없으면 uv run python 으로
uv run python -c "import sqlite3; c=sqlite3.connect('data/plant.db'); print(*c.execute('SELECT COUNT(*),MIN(ts),MAX(ts) FROM readings'))"
uv run python -c "import sqlite3; c=sqlite3.connect('data/plant.db'); print(*c.execute('SELECT MIN(n),AVG(n) FROM readings'))"
# PC 단계(패널 1~2)에서 plant.db 를 폴더 바로 아래에 두었다면 'plant.db' 로

# Pi — 2026-09 웹 UI 판
cd ~/plant && .venv/bin/plantsvc doctor           # OK/WARN/FAIL/SKIP 점검표 — 제일 먼저
systemctl status planthub plantsvc plantsnap.timer --no-pager
journalctl -u plantsvc -n 50 --no-pager
journalctl -u plantsnap -n 50 --no-pager
curl -s http://localhost:8080/api/system/status | python3 -m json.tool | head -40
systemctl status mosquitto --no-pager
journalctl -u mosquitto -n 30 --no-pager
vcgencmd measure_temp                              # 85°C면 스로틀링
df -h                                              # 이미지 누적

◀ 이전다음 ▶

## ?개념 정리 (FAQ)

### ⚠️ 보라색 식물등을 쓰면 카메라를 뭘 사든 실패합니다

가장 먼저 확인할 것 ExG = 2G − R − B 인데, 적청(보라) LED 아래에서는 G 성분이 거의 없어 잎이 검출되지 않습니다. 백색 풀스펙트럼 LED를 쓰시거나, 보라색을 써야 한다면 촬영 시간대에만 백색으로 전환(환경노드 시간 기반 점등)해야 합니다.

### 왜 Camera Module 3 Standard인가 — Wide·NoIR 아님

변형 | 왜 안 되나
Wide (120°) | 광각 = 배럴 왜곡 → 6칸 위치 무관성 검사(<5%)를 통과하지 못할 가능성. "낮게 달 수 있으니 광각이 낫다"는 이 프로젝트에선 역방향
NoIR | IR 차단 필터 없음 → 엽록소가 근적외선을 강하게 반사 → 채널이 오염되어 ExG가 무너짐

Standard를 고르는 진짜 이유는 화질이 아니라 수급 안정성입니다 — 최소 2030년 1월까지 생산이 보장되어, 6주 실험 중간에 죽어도 동일 모델을 즉시 재구매해 같은 설정으로 복구할 수 있습니다.

### 왜 "잎 면적"이 아니라 "투영 캐노피 면적"인가

위에서 찍으면 겹친 잎은 한 장으로 셉니다. 실제 잎 면적보다 항상 작게 나옵니다. 성장 추세를 보는 데는 문제없지만(계속 늘어나므로), "잎 면적을 쟀다"고 말하면 틀린 말입니다. 6주차 파괴 측정으로 실제 면적·건중량과의 관계식을 구하면 그때 대리지표로서의 지위가 생깁니다.

### 왜 원면적이 아니라 RGR인가

"어제보다 몇 cm² 늘었나"로 비교하면 원래 컸던 개체가 항상 이깁니다 — 큰 잎이 더 많은 빛을 받으니까요. RGR = (ln A₂ − ln A₁)/Δt는 "자기 크기 대비 몇 % 자랐나"이므로 개체·시점을 공정하게 비교합니다. 편의가 아니라 식물생리학의 표준 지표입니다.

### 왜 lux인가 — 그리고 그 한계

lux는 사람 눈의 민감도로 가중된 단위입니다. 사람 눈은 초록에 가장 민감하지만 식물은 초록을 반사하고 빨강·파랑을 씁니다.

이 프로젝트에서 lux를 써도 되는 근거 모든 화분이 같은 LED를 씁니다. 광원이 하나면 스펙트럼이 고정이므로 lux와 PAR의 비율도 고정 → "같았는지 확인"이라는 용도에는 충분합니다.
하지만 "광량이 성장에 미치는 영향"을 연구하려면 lux로는 불가능하고 PAR/PPFD 양자센서가 필요합니다. 보고서에 이 한계를 명시하세요.

### 왜 UTC로 저장하나

DB에는 UTC, 표시할 때만 +9시간. 노드가 여러 대여도 시각 기준이 하나여서 조인이 정확하고 서머타임 문제가 없습니다. 단, 나중에 systemd 타이머(촬영 예약)만은 로컬시각을 쓰므로 timedatectl set-timezone Asia/Seoul이 필요합니다.

### 규칙 기반 제어가 "데이터 기반"보다 낮은 단계인가

아닙니다. 우열이 아니라 순서입니다. 규칙 기반 제어(수분 밴드 유지)가 통제 장치 역할을 해야 다른 변수가 일정해지고, 그래야 데이터 기반 분석이 의미를 갖습니다. 게다가 규칙 기반은 생리학적 근거가 있어 데이터가 적어도 견고합니다.

### ★ 왜 "가장 큰 영향 요인"을 데이터에서 못 뽑나

이 프로젝트에서 가장 중요한 개념 모든 식물을 같은 환경에 두고 관측 데이터를 모으면 환경 변수들이 낮/밤과 함께 다 같이 움직입니다. 빛이 세지면 온도도 오르고 습도도 떨어지고 CO₂도 소비됩니다. 이 데이터에 상관분석이나 머신러닝 변수 중요도를 돌리면 그럴듯하지만 틀린 "1등 요인"이 나옵니다 — 서로 얽혀 있어(교락) 분리가 수학적으로 불가능하기 때문입니다.

요인의 영향력을 알려면 한 요인만 바꾸고 나머지를 붙잡아 두는 실험을 해야 합니다. 그래서 이 프로젝트는 물 하나만 조작합니다. "관측 데이터를 많이 모아 AI로 분석하면 답이 나온다"는 흔한 기대는 실험 설계 없이는 성립하지 않습니다.

### 센서 데이터의 1차 용도는 그래프가 아니라 통제의 증명입니다

"B가 덜 자랐다"는 결과가 나와도, 알고 보니 B 자리가 더 어두웠다면 그건 물의 효과가 아닙니다. 그래서 분석은 반드시 ① 통제 확인 → ② 처리 확인 → ③ 기준선 → ④ 결과 순서입니다. 환경 노드는 예쁜 그래프를 그리려고 있는 게 아닙니다.

◀ 이전다음 ▶

## →다음 단계

데모가 통과하면 여기서부터는 물리 문제입니다 — 프레임, 기하, 화분.

### 목표 구조 (7노드)

6 × 화분 노드

Core S3 + Watering Unit
자체 폐루프 · soil/pump 발행

→

1 × 환경 노드

R4 WiFi + Base Shield
BME688 + SCD41 + DLight
(+ MLX90640)

→

Pi 5 + 프레임

mosquitto · hub · 대시보드
Camera 3 + 조명 45°×2

데모의 노드 2대를 그대로 쓰고 급수 노드 5대를 복제합니다 — PLANT_ID와 TREAT만 바꿔 업로드. 노드 ID는 MAC에서 자동 생성되므로 충돌하지 않고, run_collector.py는 수정할 필요가 없습니다.

### 확정해야 할 프레임 기하

항목 | 권장 | 이유
화분 간격 | 중심간 25cm | 6주차 캐노피 15~20cm → 맞닿으면 ROI가 섞임
RGB 높이 | ~80cm | 열화상 화각과 맞춤. 해상도는 58 px/cm로 충분
열화상 화각 | 표준 55°×35° | 110° 광각은 트레이가 화면 1/3만 차지 → 화분당 화소 급감. 금지
기준면 자리 | 8×8cm ×2 | 지금 안 비워두면 CWSI 확장이 막힘
열화상 브래킷 | 지금 부착 | 나중에 리그를 뜯으면 배율이 깨져 6주치가 무의미해짐

### 2단계 검증 (프레임 완성 후)

- 위치 무관성 — 같은 50cm² 종이를 6칸에 순회 → 편차 <5%
- 3일 수평선 — 종이 고정 → 성장 그래프가 완벽한 수평선, 변동 <2%
- 조도 균일도 1회 조사 — 조도계를 6칸에 순서대로 → 편차 % 기록. "환경은 공통"이라는 문장에 근거를 부여
- 배율 안정성 — px_per_cm 변동 <1%
- systemd 등록 (hub·dash·촬영 타이머 Persistent=true)

"수평선"이 파종 승인의 핵심 종이는 자라지 않으니 성장 그래프가 완벽한 수평선이어야 합니다. 여기에 2% 이상의 흔들림이 있다면 그게 시스템의 잡음이고, 상추의 하루 성장이 그 잡음보다 작으면 아무것도 측정하지 못합니다.

### 열화상 — 왜 "섹터 평균"을 그냥 내면 안 되나

가짜 결과가 나옵니다 RGB는 섹터 안에서 색으로 잎을 골라낼 수 있지만, 열화상은 못 합니다 — 잎도 흙도 그냥 온도입니다.
섹터 평균 T = (잎 비율 × T_잎) + (흙 비율 × T_흙)
잎은 증산으로 흙보다 차가우므로, 덜 자란 쪽은 캐노피가 작아 잎 비율이 낮고 → 섹터 평균이 높게 나옵니다. 즉 "덜 자란 쪽의 ΔT가 높다"가 기공과 무관하게 순전히 캐노피 크기 때문에 나옵니다. 가설과 딱 맞는 예쁜 그래프인데 완전히 틀린 겁니다.

→ 반드시 RGB 잎 마스크 ∩ 섹터로 잎 화소만 평균하고, 혼합화소를 버리려 마스크를 1~2화소 침식하세요.

캐노피 | 섹터 점유 | 잎 화소 | 침식 후 | 판정
5 cm (2주) | 3% | ~4 | 0 | ✗
10 cm (3주) | 12% | ~15 | ~4 | 불안정
15 cm (4주) | 26% | ~33 | ~12 | 겨우
20 cm (6주) | 47% | ~60 | ~25 | ✓

MLX90640은 32×24 = 768화소, 화분당 약 128화소입니다. 나오는 것은 잎의 온도 지도가 아니라 화분별 대표 온도 1개 — ΔT에는 충분하고, 실효 데이터는 4~6주차입니다.

공기 온도 대신 기준면 — CWSI ΔT = T_잎 − T_공기 는 T_공기가 ±0.2°C여야 하는데 SCD4x는 자체 발열로 1~3°C 높습니다. 해법은 정밀 온도계가 아니라 화면 안에 기준면을 같이 넣는 것입니다:
CWSI = (T_잎 − T_습윤) / (T_건조 − T_습윤) → 공기 온도가 식에서 사라집니다. 복사·풍속·VPD 변동도 세 면에 똑같이 걸려 상쇄됩니다. 기준면은 여분 상추 잎 2장으로 — 습윤은 물 분무, 건조는 바셀린 도포(기공만 막고 광학 특성 유지). 1주차 솎아내기에서 버리는 개체가 있으니 재료는 공짜입니다.

### 실험 설계 — 별도 장으로 분리했습니다

⑤ 실험 설계 장을 보세요 초기 구상(물 양 A/B 비교)은 답이 뻔하고 손으로도 만들 수 있는 처리라 폐기했습니다. 현재 설계는 평균 수분은 같게 두고 변동폭만 달리하는 것이며, 옌센 부등식이 예측의 근거로 들어갑니다.

패널 ★ 왜 이 실험인가 · 패널 尺 용어와 사전 측정 · 패널 設 실험 설계 · 패널 測 측정 계획

2단계로 넘어가기 전 확인 실험 설계가 1회 급수 상승폭에 걸려 있습니다 (패널 6 실측). 이 값이 꾸준군 밴드 폭의 하한을 정하므로, 데모 측정 → 설계 확정 → 프레임 제작 순서를 지키세요.

### 참고문헌 — 선행연구 (패널 ★ 9절)

토양수분 안정성 vs 변동성 · 상추/뿌리채소

1. Stable soil moisture promotes shoot performance and shapes the root-rhizosphere microbiome. Science of the Total Environment (2025). — 로메인 상추, 안정이 초장·잎·생물량↑, 뿌리 크기 무관
2. Effects of stable and fluctuating soil water on the agronomic and biological performance of root vegetables. Frontiers in Plant Science (2024). — 체리 무, 유사 평균에서 안정이 광합성↑·스트레스지표↓
3. Mechanism of soil moisture temporal variance affecting WUE of romaine lettuce. Plant Nutrition and Fertilizer Science (2022). — 안정 CV 5.0% vs 변동 CV 10.3%, 안정이 WUE 개선
4. Applying 'drought' to potted plants by maintaining suboptimal soil moisture. J. Exp. Botany (PMC5447888). — 같은 평균에서도 관수 빈도가 결과를 바꾼다는 방법론 경고. 우리 설계의 근거

옌센·변동성 이론 (개념 근거)

1. Denny, M. The fallacy of the average: on the ubiquity, utility and continuing novelty of Jensen's inequality. J. Exp. Biology 220 (2017). — 옌센의 생물학 적용 종합 리뷰. ∩/∪ 그래프 직관
2. Rojas & Ghezzehei. Jensen's inequality quantifies how temporal averaging of moisture affects soil respiration. JGR Biogeosciences (2026). — 토양수분+옌센 방법론 선례 (대상: 미생물)
3. Simons, A. Modes of response to environmental change and the elusive empirical evidence for bet-hedging. Proc. R. Soc. B (2011). — 기하평균 원리, 변동이 적응도를 깎음
4. 변동-감수 전략(variance-prone/averse): 볼록이면 변동선호, 오목이면 변동회피 — bet-hedging 이론의 곡률 기반 예측

공통 한계: 다수가 평균 수분을 엄밀히 통제하지 못해 변동성과 수분 수준이 교락. 우리 실험이 겨냥하는 지점.

◀ 이전다음 ▶
