xparapx/Plant_Growth_Monitoring_Demo/firmware/plant_env_r4wifi.ino

/*
 * ═══════════════════════════════════════════════════════════
 *  식물 생장 모니터링 — 환경 노드 (Arduino UNO R4 WiFi)   [데모판]
 *
 *  Grove Base Shield V2 — I2C 포트 4개. 허브 없이 하나씩 꽂음
 *    BME688  0x76 : 온도·습도·기압  <- 대표값. 가스히터 OFF. VPD 계산
 *    SCD41   0x62 : CO2 전용 (내장 온습도는 사용하지 않음)
 *    DLight  0x23 : 조도 (lux)
 *    MLX90640 0x33: 2단계
 *  Base Shield 전원 스위치는 반드시 5V 위치.
 *
 *  전송 : plant/<nodeId>/env    NTP(UTC) 정각 격자 5분 평균
 *
 *  ★ 링크 방식 (LINK_MODE)
 *    1 = USB 직결 (기본, 2026-09-28~) : 파이 USB 에 꽂고 시리얼로 "PUB <topic> <json>" 한 줄씩.
 *        파이의 plantlink 서비스(hub/serial_bridge.py)가 그대로 로컬 MQTT 로 올려 주고,
 *        시각("T <epoch>")과 조명 명령("L 1/0")을 내려준다. Wi-Fi·NTP·브로커 IP 전부 불필요 —
 *        학교 메시 Wi-Fi 의 기기 간 격리와 WiFiS3 블로킹→WDT 리셋 루프를 모두 비켜간다.
 *    0 = Wi-Fi/MQTT (예비) : 아래 사용자 설정의 SSID·BROKER 사용.
 * ═══════════════════════════════════════════════════════════
 *  ★ 2026-09 개정 — water_node.ino 에서 배운 것들을 이식
 *    · 재접속이 <절대 기다리지 않음> — 예전 판은 끊길 때마다 최대 85초
 *      루프가 멈춰 샘플이 통째로 빠졌습니다. 이제 10초에 한 번, 1회만 시도.
 *    · 발행 실패 = 유실이던 것을 오프라인 큐(8건)로 — 타임스탬프는
 *      payload 에 이미 박혀 있으므로 늦게 발행돼도 시각이 안 밀립니다.
 *    · String 제거(힙 단편화) · WDT(5.6초, 접속 시도 구간은 타이머 ISR 이 대리 갱신) · NTP 하루 1회 재동기화.
 *    · 촬영 조명 — RGBW 네오픽셀 61구 (핀 9, W 칩만 점등), KST 05:45~06:15 시간
 *      기반 점등 + 원격 제어(MQTT plant/<id>/light/set "1"/"0", 30분
 *      자동 소등) + 시리얼 1/0 테스트 (USE_LIGHT=1).
 * ═══════════════════════════════════════════════════════════
 *  ★ Core S3 판과 다른 점 (R4 WiFi 전용)
 *    · M5Unified 없음 → 화면 코드 제거 (R4는 12x8 LED 매트릭스뿐)
 *    · WiFi 라이브러리 = WiFiS3 (ESP32 아님)
 *    · Wire.begin() — 핀 번호 지정 안 함 (SDA/SCL 고정)
 *    · NTP = RTC(WiFiS3 내장) 이용, UTC
 *  라이브러리: WiFiS3(보드 내장) / PubSubClient / Sensirion I2C SCD4x(신버전)
 *              Adafruit BME680(BME688 호환) / BH1750 / Adafruit NeoPixel
 * ═══════════════════════════════════════════════════════════
 */
#define LINK_MODE 1                          // ★ 1 = USB 직결(파이), 0 = Wi-Fi/MQTT  (헤더 설명 참고)
#if !LINK_MODE
#include <WiFiS3.h>
#include <PubSubClient.h>
#endif
#include <Wire.h>
#include <SensirionI2cScd4x.h>          // 신버전: I2c 소문자
#include <Adafruit_BME680.h>
#include <BH1750.h>
#include <RTC.h>                         // R4 내장 RTC (NTP 시각 보관)
#include <WDT.h>                         // R4 내장 워치독
#if !LINK_MODE
#include <FspTimer.h>                    // 워치독 보호창용 하드웨어 타이머 (아래 netGuard)
#endif

#ifdef NO_ERROR                          // SCD4x 신버전 매크로 충돌 방지
#undef NO_ERROR
#endif
#define NO_ERROR 0
const uint8_t SCD41_ADDR = 0x62;

#if LINK_MODE
const char* SERIAL_NODE_ID = "env_F09338";  // ★ USB 모드는 MAC 을 못 읽으므로 고정 (DB 연속성 위해 기존 id 유지)
#endif

// ══════════ 사용자 설정 (LINK_MODE=0 일 때만 사용) ══════════
const char* WIFI_SSID = "your-hotspot";       // ★ 2.4GHz SSID
const char* WIFI_PASS = "your-password";
const char* BROKER    = "192.168.0.15";     // ★ 브로커 IP — 파이 확정 후 교체 (Pi: hostname -I / PC: ipconfig)
const int   PORT      = 1883;

const uint16_t ALTITUDE_M = 40;             // ★ 학교 해발고도(m) — SCD41 CO2 보정
const int   PUBLISH_MIN = 5;
const unsigned long SAMPLE_MS = 10000;      // 5분에 n≈30
// NTP는 UTC로 저장, hub에서 +9h. 아래 KST 는 조명 창 계산에만 씁니다.
// ════════════════════════════════

// ══════════ 촬영 조명 — RGBW 네오픽셀 61구 스트립 × 1 (핀 9) ══════════
// 네오픽셀은 LED마다 드라이버 내장 -> 데이터 핀 직결, 릴레이/MOSFET 불요.
//   · 백색은 전용 W 칩만 켭니다 (R/G/B=0). RGB 합성 백색보다 스펙트럼이
//     넓어 ExG 마스크가 안정하고, LED당 전류도 1/3 수준.
//   · 기본 동작은 시간 기반 독립 점등 — 창(05:45~06:15)이 최우선이고,
//     창 점등은 어떤 명령으로도 못 끕니다 (실험 데이터 보호).
//   · 원격 제어: MQTT plant/<id>/light/set 에 "1"/"0" (또는 on/off).
//     시리얼 모니터 1/0 도 같은 효과. 둘 다 <명령 점등>으로 취급되어
//     LIGHT_CMD_MAX_MS 뒤 자동 소등 — 켜 두고 잊어도 남지 않습니다.
//   · 시리얼 't' = 색순서 검사: 앞 4구가 빨강·초록·파랑·백색 순으로 켜져야 정상.
//     다르면 LIGHT_ORDER 를 NEO_RGBW 등으로 바꿔 재업로드 (5초 뒤 자동 복귀).
//   · 상태 보고: 바뀔 때마다 plant/<id>/light 로 {"state":..,"by":..} 발행.
//   · NTP 실패(timeOK=false)면 창 점등은 하지 않음 (안전측).
//   · ★ 전류: W 칩 풀밝기 LED당 ~18mA -> 61구 255 면 ~1.1A. UNO R4 의 5V 핀은
//     USB 급전 시 0.5A 남짓이라 그대로는 브라운아웃(리셋·색 틀어짐) 납니다.
//     기본 LIGHT_BRIGHT=80(~0.35A)로 시작하고, 광량이 부족하면 스트립 5V/GND 를
//     별도 5V 2A 어댑터에 물리고(GND 는 보드와 공통) 밝기를 올리세요.
#define USE_LIGHT 1
#if USE_LIGHT
  #include <Adafruit_NeoPixel.h>
  const int     LIGHT_PIN    = 9;           // ★ 스트립 데이터 핀 (D9)
  const int     LIGHT_N      = 61;          // ★ LED 개수
  const uint8_t LIGHT_BRIGHT = 80;          // 0~255 — 매일 같은 값으로 고정 (전류 제한 겸)
  #define       LIGHT_ORDER    NEO_GRBW     // ★ SK6812 RGBW 표준 순서. 't' 검사로 확인
  const long    LIGHT_ON_S   = 5*3600L + 45*60L;   // KST 05:45
  const long    LIGHT_OFF_S  = 6*3600L + 15*60L;   // KST 06:15 (촬영 05:50 이 창 안)
  const unsigned long LIGHT_CMD_MAX_MS = 1800000UL;   // 명령 점등 자동 소등 (30분)
  const unsigned long LIGHT_TEST_MS    = 5000UL;      // 색순서 검사 표시 시간
  Adafruit_NeoPixel strip(LIGHT_N, LIGHT_PIN, LIGHT_ORDER + NEO_KHZ800);
  bool lit = false;                         // 현재 실제 상태
  bool cmdOn = false;                       // 원격/시리얼 명령 점등 중
  unsigned long tCmd = 0;                   // 명령 점등 시작 시각
  unsigned long tTest = 0;                  // 색순서 검사 시작 시각 (0=검사 아님)
  const char* litBy = "off";                // "window" | "cmd" | "off" — 상태 보고용

  void setLight(bool on) {                  // 점등/소등 한 곳에서 — W 칩만 사용
    uint32_t c = on ? Adafruit_NeoPixel::Color(0, 0, 0, 255) : 0;
    strip.fill(c, 0, LIGHT_N);
    strip.show();
  }
  void lightOrderTest() {                   // 앞 4구 R·G·B·W — 색순서 육안 검사
    strip.clear();
    strip.setPixelColor(0, Adafruit_NeoPixel::Color(255, 0, 0, 0));
    strip.setPixelColor(1, Adafruit_NeoPixel::Color(0, 255, 0, 0));
    strip.setPixelColor(2, Adafruit_NeoPixel::Color(0, 0, 255, 0));
    strip.setPixelColor(3, Adafruit_NeoPixel::Color(0, 0, 0, 255));
    strip.show();
    tTest = millis(); if (tTest == 0) tTest = 1;
    Serial.println(F("[LIGHT] order test: LED0 red, LED1 green, LED2 blue, LED3 white ?"));
  }
#endif

#if !LINK_MODE
WiFiClient net;
PubSubClient client(net);
#endif
SensirionI2cScd4x scd4x;                 // 신버전 클래스명
Adafruit_BME680  bme;
BH1750           lightMeter;

char nodeId[16] = "env_boot";            // MAC 확보 전 임시 — WiFi 붙으면 확정
char topic[32]  = "plant/env_boot/env";
bool idReady = false;

double sT=0, sH=0, sP=0, sV=0, sL=0, sC=0;
int n=0, nC=0, nB=0;
bool bmeOK=false, scdOK=false, luxOK=false, timeOK=false;
long curBucket = -1;
unsigned long lastSample = 0;
int failStreak = 0;
const int FAIL_LIMIT = 12;

// 리셋 원인 — RA4M1 RSTSR1: bit0 IWDT, bit1 WDT, bit2 SW / RSTSR0: bit0 POR(전원)
void printResetCause() {
  uint8_t r0 = R_SYSTEM->RSTSR0, r1 = R_SYSTEM->RSTSR1;
  Serial.print("[RST] ");
  if (r1 & 0x02) Serial.print("WDT ");
  if (r1 & 0x01) Serial.print("IWDT ");
  if (r1 & 0x04) Serial.print("SW ");
  if (r0 & 0x01) Serial.print("POR ");
  if (!(r1 & 0x07) && !(r0 & 0x01)) Serial.print("other/pin ");
  Serial.print("(RSTSR0=0x"); Serial.print(r0, HEX);
  Serial.print(" RSTSR1=0x"); Serial.print(r1, HEX); Serial.println(")");
  R_SYSTEM->RSTSR0 = 0; R_SYSTEM->RSTSR1 = 0;    // 다음 부팅을 위해 지움
}

// ── 네트워크 재시도·재동기화 ──
const unsigned long RETRY_MS  = 10000UL;    // WiFi/MQTT/NTP 재시도 간격
const unsigned long RESYNC_S  = 86400L;     // NTP 재동기화 주기 (RTC 드리프트 보정)
unsigned long tRetry = 0, tNtp = 0;
long lastSyncEpoch = 0;

// ── 오프라인 큐 — 발행 실패한 5분 평균을 담아 두었다 되는 대로 flush ──
//    payload 에 버킷 시각이 들어 있어 늦게 발행돼도 데이터 시각은 정확합니다.
const int QUEUE_MAX = 8;                    // 8건 = 40분 치. 넘치면 오래된 것부터 버림
char pq[QUEUE_MAX][224];
int  pqHead = 0, pqCount = 0;

// ── VPD — 습도가 아니라 이것이 증산을(=마르는 속도를) 정함 ──
float esat(float t)            { return 0.6108f * expf(17.27f*t/(t+237.3f)); }   // kPa
float vpdOf(float t, float rh) { return esat(t) * (1.0f - rh/100.0f); }          // kPa

#if LINK_MODE
// ══════════ USB 직결 링크 ══════════
//   송신: "PUB <topic> <json>\n"  — 파이 plantlink 가 MQTT 로 그대로 발행
//   수신: "T <epoch>" 시각 설정(UTC) · "L 1"/"L 0" 조명 명령 · 단문자 1/0/t 는 테스트용 그대로
const unsigned long TIME_STALE_S = 3*3600L;    // 이 시간 넘게 T 를 못 받으면 timeOK 해제 (창 점등 안전측)
long lastTimeRx = 0;
bool linkUp() { return true; }                 // USB 는 항상 "연결" — 큐는 즉시 비워짐
bool publishRaw(const char* t, const char* m) {
  Serial.print("PUB "); Serial.print(t); Serial.print(' '); Serial.println(m);
  return true;
}
void setTimeFromHost(unsigned long epoch) {
  RTC.begin();
  RTCTime rt((time_t)epoch);
  RTC.setTime(rt);
  lastTimeRx = (long)epoch;
  if (!timeOK) Serial.println("TIME OK (host)");
  timeOK = true;
}
void timeTick() {                              // 호스트 시각이 오래 끊기면 창 점등을 멈춤
  if (!timeOK) return;
  RTCTime t; RTC.getTime(t);
  if ((long)t.getUnixTime() - lastTimeRx > TIME_STALE_S) { timeOK = false; Serial.println("TIME stale"); }
}
#else
// ── 워치독 보호창 ──
//   WiFiS3 의 TCP 접속(client.connect)은 브로커가 안 닿으면 모뎀 응답을 최대 10초
//   <블로킹>하고, setConnectionTimeout 도 모뎀 펌웨어가 무시한다(2026-09-28 실측).
//   R4 워치독은 5.6초가 최대라 접속 시도마다 리셋 루프에 빠졌다.
//   해법: 접속 시도 직전에 보호창(최대 NET_GUARD_MS)을 열면 2Hz 타이머 ISR 이 그 동안만
//   WDT 를 대신 갱신한다. 창이 닫히면 ISR 은 손을 떼므로 다른 멈춤은 여전히 리셋된다.
const unsigned long NET_GUARD_MS = 12000UL;   // 모뎀 타임아웃 10s + 여유
volatile unsigned long guardUntil = 0;        // 0 = 보호창 닫힘
FspTimer guardTimer;
void guardIsr(timer_callback_args_t*) {
  unsigned long u = guardUntil;
  if (u && (long)(millis() - u) < 0) WDT.refresh();
}
void netGuardOpen()  { guardUntil = millis() + NET_GUARD_MS; if (!guardUntil) guardUntil = 1; }
void netGuardClose() { guardUntil = 0; }
bool guardTimerBegin() {
  // 50Hz — AGT(16비트)·GPT 어느 쪽이 배정돼도 표현 가능한 주파수
  uint8_t type; int8_t ch = FspTimer::get_available_timer(type);
  if (ch < 0) ch = FspTimer::get_available_timer(type, true);
  if (ch < 0) return false;
  if (!guardTimer.begin(TIMER_MODE_PERIODIC, type, (uint8_t)ch, 50.0f, 50.0f, guardIsr)) return false;
  if (!guardTimer.setup_overflow_irq()) return false;
  return guardTimer.open() && guardTimer.start();
}
// R4는 MAC을 WiFi.macAddress()로 얻음 (연결 후에 확정)
void makeNodeId() {
  byte mac[6]; WiFi.macAddress(mac);
  snprintf(nodeId, sizeof(nodeId), "env_%02X%02X%02X", mac[3], mac[4], mac[5]);
  snprintf(topic, sizeof(topic), "plant/%s/env", nodeId);
  idReady = true;
  Serial.print("Node : "); Serial.println(nodeId);
  Serial.print("Topic: "); Serial.println(topic);
}

// ★ 절대 기다리지 않습니다 — 끊겨 있으면 10초에 한 번, 1회만 시도.
//   (예전 판은 while+delay 로 최대 85초 루프가 멈춰 샘플이 빠졌습니다)
bool netReady() {
  if (WiFi.status() != WL_CONNECTED) {
    unsigned long now = millis();
    if (now - tRetry >= RETRY_MS) {
      tRetry = now;
      netGuardOpen(); WiFi.begin(WIFI_SSID, WIFI_PASS); netGuardClose();
    }
    return false;
  }
  if (!idReady) makeNodeId();
  if (client.connected()) return true;
  unsigned long now = millis();
  if (now - tRetry < RETRY_MS) return false;
  tRetry = now;
  char cid[24];
  snprintf(cid, sizeof(cid), "%s-%04x", nodeId, (unsigned)random(0xffff));
  Serial.print("[NET] mqtt connect @"); Serial.println(millis());
  netGuardOpen();                                // 접속 블로킹(≤10s) 동안만 WDT 대리 갱신
  bool ok = client.connect(cid);
  netGuardClose();
  Serial.print("[NET] returned @"); Serial.println(millis());
  if (ok) {
    Serial.println("MQTT OK");
#if USE_LIGHT
    char sub[48];
    snprintf(sub, sizeof(sub), "plant/%s/light/set", nodeId);
    client.subscribe(sub);                       // 원격 점등 명령 구독 (노드 지정)
    client.subscribe("plant/light/set");         // 브로드캐스트 — 웹 UI 조명 버튼용
    publishLightState();                         // 재접속 시 현재 상태 알림
#endif
    return true;
  }
  Serial.print("MQTT rc="); Serial.println(client.state());   // -2 = 거부/방화벽
  return false;
}
bool linkUp() { return client.connected(); }
bool publishRaw(const char* t, const char* m) { return client.publish(t, m); }

// NTP → 내장 RTC (UTC epoch). 논블로킹 — 될 때까지 10초 간격으로 시도,
// 성공 후에도 하루 한 번 다시 받아 RTC 드리프트를 지웁니다.
void ntpTick() {
  if (WiFi.status() != WL_CONNECTED) return;
  if (timeOK) {
    RTCTime t; RTC.getTime(t);
    if ((long)t.getUnixTime() - lastSyncEpoch < RESYNC_S) return;   // 아직 재동기화 때가 아님
  }
  unsigned long now = millis();
  if (now - tNtp < RETRY_MS) return;
  tNtp = now;
  netGuardOpen();                               // 모뎀 응답 대기(≤10s) 보호
  unsigned long epoch = WiFi.getTime();         // 실패 시 0
  netGuardClose();
  if (!epoch) { if (!timeOK) Serial.println("NTP 대기중"); return; }
  RTC.begin();
  RTCTime rt((time_t)epoch);
  RTC.setTime(rt);
  lastSyncEpoch = (long)epoch;
  if (!timeOK) Serial.println("NTP OK");
  timeOK = true;
}

#endif  // !LINK_MODE

long nowEpoch() {
  if (!timeOK) return 0;
  RTCTime t; RTC.getTime(t); return (long)t.getUnixTime();
}

void epochToStr(long e, char* out, size_t len) {
  time_t t=(time_t)e; struct tm ti; gmtime_r(&t, &ti);
  strftime(out, len, "%Y-%m-%d %H:%M:%S", &ti);
}

// 얼어붙은 센서가 물리적으로 불가능한 값을 반복하는 고장 모드를 차단
bool plausibleTH(float t, float h) { return t>-10 && t<60 && h>=0 && h<=100; }
bool plausibleCO2(float c)         { return c>300 && c<10000; }

void initSensors() {
  // BME688 — 대표 온습도. 가스히터는 끔(자체 발열로 온습도가 오염됨)
  bmeOK = bme.begin(0x76);
  if (!bmeOK) bmeOK = bme.begin(0x77);          // 보드에 따라 0x77
  if (bmeOK) {
    bme.setTemperatureOversampling(BME680_OS_8X);
    bme.setHumidityOversampling(BME680_OS_2X);
    bme.setPressureOversampling(BME680_OS_4X);
    bme.setIIRFilterSize(BME680_FILTER_SIZE_3);
    bme.setGasHeater(0, 0);                     // ★ OFF — VOC 쓰려면 (320,150)
  }
  Serial.println(bmeOK ? "BME688 시작" : "BME688 실패 - 0x76/0x77 확인");

  scd4x.begin(Wire, SCD41_ADDR);                // 신버전: 주소 인자 필요
  scd4x.stopPeriodicMeasurement(); delay(500);
  scd4x.setSensorAltitude(ALTITUDE_M);          // 기압 보정 (측정 정지 중에만)
  scdOK = (scd4x.startPeriodicMeasurement() == NO_ERROR);
  Serial.println(scdOK ? "SCD41 시작" : "SCD41 실패 - 0x62 확인");

  luxOK = lightMeter.begin(BH1750::CONTINUOUS_HIGH_RES_MODE);
  Serial.println(luxOK ? "DLight 시작" : "DLight 실패 - 0x23 확인");
}

void recoverI2C() {
  Serial.println("[RECOVER] I2C 복구");
  Wire.end(); delay(50);
  Wire.begin();                                 // R4 : 핀 지정 없음
  initSensors();
  failStreak = 0;
  if (!bmeOK && !scdOK && !luxOK) { Serial.println("[RECOVER] 실패 -> 리셋"); NVIC_SystemReset(); }
}

void takeSample() {
  bool any = false;

  // ── BME688 : 대표 온습도 + 기압 -> VPD ──
  if (bmeOK && bme.performReading()) {
    float t = bme.temperature, hm = bme.humidity, pr = bme.pressure / 100.0f;  // Pa -> hPa
    if (plausibleTH(t, hm)) { sT += t; sH += hm; sP += pr; sV += vpdOf(t, hm); nB++; any = true; }
  }

  // ── SCD41 : CO2만 사용 (온습도 t,hm은 읽고 버림) ──
  uint16_t co2=0; float t=0, hm=0; bool ready=false;
  if (scdOK && scd4x.getDataReadyStatus(ready)==NO_ERROR && ready) {   // 신버전 함수명
    if (scd4x.readMeasurement(co2, t, hm)==NO_ERROR && co2!=0 && plausibleCO2(co2)) { sC += co2; nC++; any = true; }
  }

  float lx = luxOK ? lightMeter.readLightLevel() : NAN;
  if (!isnan(lx) && lx >= 0) { sL += lx; any = true; }

  n++;
  if (any) failStreak = 0; else failStreak++;
}

void enqueuePayload(const char* p) {
  int i = (pqHead + pqCount) % QUEUE_MAX;
  if (pqCount == QUEUE_MAX) { pqHead = (pqHead + 1) % QUEUE_MAX; pqCount--; }  // 오래된 것부터 버림
  strncpy(pq[i], p, sizeof(pq[i]) - 1);
  pq[i][sizeof(pq[i]) - 1] = 0;
  pqCount++;
}

void flushQueue() {
  while (pqCount > 0) {
    if (!publishRaw(topic, pq[pqHead])) return;       // 실패하면 다음 기회에
    Serial.print("PUB(late): "); Serial.println(pq[pqHead]);
    pqHead = (pqHead + 1) % QUEUE_MAX; pqCount--;
  }
}

void publishAverage(long bucket) {
  if (n <= 0) return;
  int cb = nB > 0 ? nB : 1;
  int cc = nC > 0 ? nC : 1;
  char ts[24] = "";
  if (timeOK) epochToStr(bucket, ts, sizeof(ts));
  char p[224];
  snprintf(p, sizeof(p),
    "{\"node\":\"%s\",\"t\":\"%s\",\"temp\":%.2f,\"hum\":%.2f,"
    "\"press\":%.1f,\"vpd\":%.3f,\"lux\":%.1f,\"co2\":%.1f,\"n\":%d}",
    nodeId, ts, sT/cb, sH/cb, sP/cb, sV/cb, sL/n, sC/cc, n);
  // ★ 먼저 담고, 발행은 되는 대로 — 끊겨 있어도 5분 평균이 유실되지 않습니다
  enqueuePayload(p);
  if (linkUp()) flushQueue();
  else Serial.print("QUEUED: "), Serial.println(p);
}

void resetAccum() { sT=sH=sP=sV=sL=sC=0; n=0; nC=0; nB=0; }

#if USE_LIGHT
// 상태 보고 — 바뀔 때만 발행. 끊겨 있으면 조용히 넘어감(조명은 로컬이 진실).
void publishLightState() {
  if (!linkUp() || !idReady) return;
  char t[48], m[96];
  snprintf(t, sizeof(t), "plant/%s/light", nodeId);
  snprintf(m, sizeof(m), "{\"node\":\"%s\",\"state\":\"%s\",\"by\":\"%s\"}",
           nodeId, lit ? "on" : "off", litBy);
  publishRaw(t, m);
}

// 원격/시리얼 <명령 점등> 공통 진입점. 켜기는 워치독 타이머를 재장전한다.
void lightCommand(bool on, const char* src) {
  cmdOn = on;
  if (on) tCmd = millis();
  Serial.print("[LIGHT] cmd "); Serial.print(on ? "ON" : "OFF");
  Serial.print(" ("); Serial.print(src); Serial.println(")");
}

// 점등 결정 — 매 루프 재평가. 창이 최우선, 명령 점등은 30분 워치독.
void lightTick() {
  bool window = false;
  long e = nowEpoch();
  if (e > 0) {
    long sod = (e + 9*3600L) % 86400L;          // KST 자정 기준 초 (UTC 일경계 wrap 처리)
    window = (sod >= LIGHT_ON_S && sod < LIGHT_OFF_S);
  }                                             // timeOK=false -> 창 점등 없음 (안전측)
  if (cmdOn && millis() - tCmd >= LIGHT_CMD_MAX_MS) {   // 명령 점등 워치독
    cmdOn = false;
    Serial.println("[LIGHT] cmd timeout — auto off");
  }
  bool want = window || cmdOn;
  if (tTest) {                                          // 색순서 검사 중 — 5초 뒤 실제 상태로 복귀
    if (millis() - tTest < LIGHT_TEST_MS) return;
    tTest = 0; lit = !want;                             // 강제 재적용
  }
  if (want == lit) return;
  lit = want;
  litBy = lit ? (window ? "window" : "cmd") : "off";
  setLight(lit);
  Serial.print("[LIGHT] "); Serial.print(lit ? "on" : "off");
  Serial.print(" by "); Serial.println(litBy);
  publishLightState();
}

#endif

// 시리얼 입력 — 단문자 1/0/t(테스트) + 줄 명령 "T <epoch>"(시각) / "L 1|0"(조명, USB 모드에서 파이가 보냄)
void serialTick() {
  static char line[32]; static uint8_t len = 0;
  while (Serial.available()) {
    char ch = Serial.read();
    if (ch == '\r') continue;
    if (ch == '\n') {
      line[len] = 0;
      if (len == 1) {
#if USE_LIGHT
        if (line[0] == '1' || line[0] == '0') lightCommand(line[0] == '1', "serial");
        else if (line[0] == 't' || line[0] == 'T') lightOrderTest();
#endif
      } else if (line[0] == 'T' && line[1] == ' ') {
#if LINK_MODE
        unsigned long e = strtoul(line + 2, nullptr, 10);
        if (e > 1700000000UL) setTimeFromHost(e);
#endif
      } else if (line[0] == 'L' && line[1] == ' ') {
#if USE_LIGHT
        lightCommand(line[2] == '1', "host");
#endif
      }
      len = 0;
    } else if (len < sizeof(line) - 1) {
      line[len++] = ch;
    } else len = 0;                            // 너무 긴 줄은 버림
  }
}

#if !LINK_MODE
// MQTT 수신 — plant/<id>/light/set : "1"/"on" 켜기, "0"/"off" 끄기
void onMqtt(char* t, byte* payload, unsigned int len) {
#if USE_LIGHT
  const char* slash = strrchr(t, '/');
  if (slash == nullptr || strcmp(slash, "/set") != 0) return;
  char v[8] = "";
  strncpy(v, (const char*)payload, len < sizeof(v) - 1 ? len : sizeof(v) - 1);
  if (!strcmp(v, "1") || !strcasecmp(v, "on"))  lightCommand(true, "mqtt");
  if (!strcmp(v, "0") || !strcasecmp(v, "off")) lightCommand(false, "mqtt");
#endif
}
#endif  // !LINK_MODE

void setup() {
#if USE_LIGHT
  // 리셋 직후 데이터 핀이 떠 있는 동안 스트립이 제멋대로 켜질 수 있다 — 무엇보다 먼저 소등
  strip.begin();
  strip.setBrightness(LIGHT_BRIGHT);       // 매일 같은 값 — 전류 제한 겸 조명 고정
  strip.clear(); strip.show();             // 부팅은 반드시 소등으로
#endif
  Serial.begin(115200);
  delay(300);
  printResetCause();
  Wire.begin();                            // R4 : Base Shield I2C (SDA/SCL 고정)
  initSensors();

#if LINK_MODE
  strncpy(nodeId, SERIAL_NODE_ID, sizeof(nodeId) - 1);
  snprintf(topic, sizeof(topic), "plant/%s/env", nodeId);
  idReady = true;
  Serial.print("Node : "); Serial.println(nodeId);
  Serial.print("Topic: "); Serial.println(topic);
  Serial.println("LINK: usb-serial (waiting host 'T <epoch>')");
#else
  // ★ 여기서 기다리지 않습니다 — 연결·NTP·nodeId 확정은 전부 loop 에서 논블로킹으로.
  // ★ WiFiS3 의 WiFi.begin() 은 AP 가 안 잡히면 최대 ~10초를 <블로킹>한다.
  //   5초 워치독과 겹치면 "재접속 시도 중 리셋 → 부팅 → 재시도 → 리셋" 루프에
  //   빠지고, 리셋 순간 데이터 핀이 떠서 네오픽셀이 제멋대로 켜진다(2026-09-23 실제 발생).
  //   접속 대기를 2.5초로 잘라 워치독 안에 반드시 돌아오게 한다.
  WiFi.setTimeout(2500);
  WiFi.begin(WIFI_SSID, WIFI_PASS);
  // ★ MQTT 의 TCP 접속도 같은 함정 — 브로커가 안 닿으면(IP 오류·다른 메시 유닛·파이 꺼짐)
  //   모뎀 기본 10초를 블로킹해 워치독 리셋 루프(2026-09-23~28 실제 발생, 5일간).
  //   접속 대기를 2.5초로 제한해 실패해도 "MQTT rc=" 만 찍고 루프가 계속 돌게 한다.
  net.setConnectionTimeout(2500);
  client.setServer(BROKER, PORT);
  client.setCallback(onMqtt);              // 원격 점등 명령 수신
  client.setKeepAlive(60);

  bool guardOK = guardTimerBegin();        // 접속 시도 구간 WDT 보호창 (netGuard 주석 참고)
#endif
  WDT.begin(5592);                         // 워치독(R4 최대치) — I2C 가 얼면 리셋
#if !LINK_MODE
  Serial.println(guardOK ? "[GUARD] timer OK" : "[WARN] guard timer 없음 — 브로커 불통 시 리셋 루프 가능");
#endif
  Serial.println("[BOOT] env node — 논블로킹 접속, 큐 8건, WDT 5.6s, LIGHT RGBW 61구 핀9 (mqtt/serial 제어, t=색순서)");
}

void loop() {
  WDT.refresh();

#if LINK_MODE
  flushQueue();
  timeTick();
#else
  if (netReady()) { client.loop(); flushQueue(); }
  ntpTick();
#endif
  serialTick();
#if USE_LIGHT
  lightTick();
#endif

  if (failStreak >= FAIL_LIMIT) recoverI2C();

  unsigned long now = millis();
  long s = PUBLISH_MIN * 60L;

  if (timeOK) {
    long bucket = (nowEpoch()/s)*s;
    if (curBucket < 0) { curBucket = bucket; }
    if (bucket != curBucket) { publishAverage(curBucket); resetAccum(); curBucket = bucket; }
  } else {
    static unsigned long lastPub = 0;
    if (now - lastPub >= (unsigned long)PUBLISH_MIN*60000UL) { lastPub = now; publishAverage(0); resetAccum(); }
  }

  if (now - lastSample >= SAMPLE_MS) { lastSample = now; takeSample(); }
  delay(20);
}
