xparapx/Plant_Growth_Monitoring_Demo/hub/plantsvc/config_model.py

"""config.json as a typed model.

Everything an operator can set lives in ONE file (data/config.json).  The
vision code still consumes the plain-dict shape (`to_legacy_dict()`), so the
numbers and key names are exactly those setup_camera / leaf_measure /
frame_align always used.  New sections (tz, bands, analysis, schedule,
mqtt, preview) carry the constants that were previously duplicated in
dashboard.py, water_node.ino and the systemd units.

`migrate()` upgrades a legacy file in place: dead keys are dropped with a
warning, missing sections get defaults, malformed scalars are normalised.
"""

from __future__ import annotations

from typing import Any, Literal

from pydantic import BaseModel, ConfigDict, Field, field_validator

from .timeutil import DEFAULT_TZ, parse_hhmm

TREATS = ("stable", "fluct")
CONFIG_VERSION = 2


class Layout(BaseModel):
    cols: int = 3
    rows: int = 2
    pot_cm: float = 15.0     # ruler-measured pot side (square pots); used only to sanity-check the scale
    gap_cm: float = 20.0


class PhaseCtl(BaseModel):
    """phase 별 노출 프로필 — 새벽(LED 조명)과 오후(자연광)는 조도가 달라
    한 노출로 둘 다 커버할 수 없다. 면적 비교는 늘 같은 phase 끼리이므로
    노출은 phase 안에서만 일정하면 된다. 렌즈 위치는 공통(초점은 안 변함)."""
    exposure_us: int = 20000
    gain: float = 2.0
    colour_gains: tuple[float, float] = (1.8, 1.6)


class Capture(BaseModel):
    size: tuple[int, int] = (4608, 2592)
    rotation: int = 0                  # 0|90|180|270 — 설치 방향 보정. 센서가 아니라 프레임을 돌린다
    # 90/270 회전 시 결과 화면비. (4,3) 이면 원본의 가운데 3:4 세로띠만 잘라 돌려 <가로 4:3> 을 만든다 —
    # CSI 케이블 때문에 카메라를 90° 눕혀 달아도 화면·사진이 세로로 길어지지 않는다(2026-09-28).
    # 잘라내기만 하고 리샘플은 없다(왜곡 0). None 이면 전체 프레임을 그대로 돌린다(세로 화면).
    rot_aspect: tuple[int, int] | None = None
    lens_position: float = 1.82        # dioptres = 1/m
    exposure_us: int = 20000
    gain: float = 2.0
    colour_gains: tuple[float, float] = (1.8, 1.6)   # (red, blue)
    dawn: PhaseCtl | None = None       # 새벽(조명 아래) 프로필 — 없으면 공통값
    pm: PhaseCtl | None = None         # 오후(자연광) 프로필 — 없으면 공통값

    def for_phase(self, phase: str) -> dict[str, Any]:
        """촬영에 적용할 컨트롤 dict — 공통값 위에 phase 프로필을 덮는다."""
        d = self.model_dump()
        prof = d.pop("dawn", None) if phase == "dawn" else d.pop("pm", None)
        d.pop("pm", None); d.pop("dawn", None)
        if prof:
            d.update(prof)
        return d

    @field_validator("rotation")
    @classmethod
    def _rot(cls, v: int) -> int:
        if v % 360 not in (0, 90, 180, 270):
            raise ValueError("rotation must be 0/90/180/270")
        return v % 360

    def crop_cols(self, w: int, h: int) -> tuple[int, int]:
        """원본 프레임(w×h)에서 회전 전에 남길 열 범위 (x0, cw). 회전 없음/전체면 (0, w)."""
        if self.rotation in (90, 270) and self.rot_aspect:
            aw, ah = self.rot_aspect
            cw = min(w, int(round(h * ah / aw)) & ~1)      # 짝수 폭 (JPEG/YUV 친화)
            return ((w - cw) // 2, cw)
        return (0, w)

    def eff_dims(self, w: int, h: int) -> tuple[int, int]:
        """어떤 프레임 크기(w×h)든 크롭+회전 뒤의 (W, H)."""
        _, cw = self.crop_cols(w, h)
        return (h, cw) if self.rotation in (90, 270) else (w, h)

    @property
    def eff_size(self) -> tuple[int, int]:
        """회전 적용 후의 (W, H) — ROI·격자·프레임폭 계산은 전부 이걸 쓴다."""
        return self.eff_dims(*self.size)


class Roi(BaseModel):
    model_config = ConfigDict(extra="ignore")
    plant_id: str
    treat: str = ""                   # 'stable' | 'fluct' | '' - the label source of truth
    x: int
    y: int
    w: int
    h: int

    @property
    def cx(self) -> float:
        return self.x + self.w / 2

    @property
    def cy(self) -> float:
        return self.y + self.h / 2


class QC(BaseModel):
    px_per_cm_ref: float = 0.0        # 0 => area_cm2 null and ok=0 everywhere
    edge_tol: float = 0.02
    drift_warn_px: float = 8.0
    drift_fail_px: float = 40.0
    drift_resp_min: float = 0.05


class Bands(BaseModel):
    """Treatment bands in RAW ADC counts (wet, dry) - must match water_node.ino RAW_ON/RAW_OFF -
    and the per-node calibration (RAW_DRY, RAW_WET) used to turn raw into a percentage."""
    raw: dict[str, tuple[int, int]] = Field(
        default_factory=lambda: {"stable": (1900, 1940), "fluct": (1820, 2020)})
    cal_default: tuple[int, int] = (2120, 1750)
    cal: dict[str, tuple[int, int]] = Field(default_factory=dict)

    def pct_of(self, raw: float, plant_id: str | None = None) -> float:
        dry, wet = self.cal.get(plant_id or "", self.cal_default)
        return 100.0 * (dry - raw) / float(dry - wet)

    def band_pct(self) -> dict[str, tuple[float, float]]:
        """(low %, high %) per treatment."""
        out = {}
        for t, (wet_raw, dry_raw) in self.raw.items():
            lo, hi = self.pct_of(dry_raw), self.pct_of(wet_raw)
            out[t] = (min(lo, hi), max(lo, hi))
        return out


class Analysis(BaseModel):
    tol_pp: float = 2.0            # |mu_s - mu_f| tolerance, percentage points
    sep_ratio: float = 2.0         # sigma_f / sigma_s must be >= this
    hist_bins: int = 44
    soil_days: int = 7
    pump_limit: int = 200
    dummy_fill: Literal["auto", "on", "off"] = "auto"
    env_interval_min: int = 5
    soil_interval_min: int = 5
    cam_interval_min: int = 720


class Schedule(BaseModel):
    dawn: str = "05:50"            # local wall clock (config.tz); shot lands before 06:00
    pm: str = "15:00"

    @field_validator("dawn", "pm")
    @classmethod
    def _hhmm(cls, v: str) -> str:
        h, m = parse_hhmm(v)
        return f"{h:02d}:{m:02d}"


class Mqtt(BaseModel):
    host: str = "localhost"
    port: int = 1883
    growth_topic: str = "plant/tray/growth"


class Preview(BaseModel):
    size: tuple[int, int] = (1280, 720)
    jpeg_quality: int = 80
    frame_ms: int = 80


class GrowLight(BaseModel):
    """보조 생장 조명 — 환경노드 LED 를 낮 시간대에 켜 둔다 (모종기 등). plantlink 가 config.json 을 읽어
    창 안이면 10분마다 'L 1' 을 보내고(노드 30분 자동소등 안에서 갱신), 창이 끝나면 'L 0'.
    새벽 촬영 창(05:45~06:15)은 노드 펌웨어가 독립 처리하므로 건드리지 않는다.
    pm 촬영 전후 pause_min 동안은 끈다 — 오후 프로필(자연광 기준)과 사진 조건을 맞추기 위해."""
    enabled: bool = False
    on: str = "07:00"              # KST (tz 기준) HH:MM
    off: str = "20:00"
    until: str | None = None       # "YYYY-MM-DD" — 이 날짜(포함)까지만. None 이면 계속
    pause_around_pm_min: int = 10  # pm 촬영 시각 전후 N 분 소등 (0 = 끄지 않음)


class Config(BaseModel):
    model_config = ConfigDict(extra="ignore")

    version: int = CONFIG_VERSION
    tz: str = DEFAULT_TZ
    layout: Layout = Field(default_factory=Layout)
    capture: Capture = Field(default_factory=Capture)
    rois: list[Roi] = Field(default_factory=list)
    qc: QC = Field(default_factory=QC)
    treat_mode: str = ""           # 'random' | 'manual' | '' - provenance of the assignment
    run_started: str | None = None
    bands: Bands = Field(default_factory=Bands)
    analysis: Analysis = Field(default_factory=Analysis)
    schedule: Schedule = Field(default_factory=Schedule)
    mqtt: Mqtt = Field(default_factory=Mqtt)
    preview: Preview = Field(default_factory=Preview)
    light: GrowLight = Field(default_factory=GrowLight)

    @field_validator("tz")
    @classmethod
    def _tz(cls, v: str) -> str:
        from zoneinfo import ZoneInfo
        try:
            ZoneInfo(v)
        except Exception as e:
            raise ValueError(f"unknown timezone {v!r}") from e
        return v

    @field_validator("treat_mode")
    @classmethod
    def _mode(cls, v: str) -> str:
        if v not in ("random", "manual", ""):
            raise ValueError("treat_mode must be 'random', 'manual' or ''")
        return v

    # ---- helpers ----------------------------------------------------------
    def to_legacy_dict(self) -> dict[str, Any]:
        """The plain-dict shape the vision code and legacy scripts read."""
        return self.model_dump(mode="json")

    def roi_map(self) -> dict[str, str]:
        return {r.plant_id: r.treat for r in self.rois}

    @property
    def scale(self) -> float:
        """preview px per capture px (same ISP output, so a pure proportion)."""
        return self.preview.size[0] / self.capture.size[0]


DEAD_TOP_KEYS = ("marker_mm", "ref_marker", "led")
DEAD_QC_KEYS = ("px_per_cm_tol",)


def migrate(raw: dict[str, Any] | None, *, strict: bool = False) -> tuple[dict[str, Any], list[str]]:
    """Upgrade a legacy dict to the current shape.  Never raises on dead/odd keys.

    strict=True (API writes): only structural fixes; bad scalars (tz, schedule, treat_mode)
    are left for model validation to reject instead of being silently normalised."""
    d: dict[str, Any] = dict(raw or {})
    warnings: list[str] = []

    for k in DEAD_TOP_KEYS:
        if k in d:
            d.pop(k)
            warnings.append(f"dropped legacy key '{k}' (no longer used)")
    qc = d.get("qc")
    if isinstance(qc, dict):
        for k in DEAD_QC_KEYS:
            if k in qc:
                qc.pop(k)
                warnings.append(f"dropped legacy key 'qc.{k}' (never read)")
    else:
        d["qc"] = {}

    if not isinstance(d.get("rois"), list):
        d["rois"] = []
    clean_rois = []
    for r in d["rois"]:
        if not isinstance(r, dict) or "plant_id" not in r:
            warnings.append(f"dropped malformed roi entry: {r!r}")
            continue
        r = {k: v for k, v in r.items() if not str(k).startswith("_")}
        if r.get("treat") is None:
            r["treat"] = ""
        clean_rois.append(r)
    d["rois"] = clean_rois

    if not strict:
        tz = d.get("tz") or DEFAULT_TZ
        try:
            from zoneinfo import ZoneInfo
            ZoneInfo(tz)
        except Exception:
            warnings.append(f"unknown tz '{tz}' -> {DEFAULT_TZ}")
            tz = DEFAULT_TZ
        d["tz"] = tz

        if d.get("treat_mode") not in ("random", "manual", "", None):
            warnings.append(f"treat_mode {d.get('treat_mode')!r} not recognised -> ''")
            d["treat_mode"] = ""

        sched = d.get("schedule")
        if isinstance(sched, dict):
            for k, default in (("dawn", "05:50"), ("pm", "15:00")):
                v = sched.get(k, default)
                try:
                    parse_hhmm(str(v))
                except Exception:
                    warnings.append(f"schedule.{k} {v!r} is not HH:MM -> {default}")
                    sched[k] = default

    v = d.get("version")
    if v != CONFIG_VERSION:
        d["version"] = CONFIG_VERSION
        if v is not None:
            warnings.append(f"config version {v} -> {CONFIG_VERSION}")
    return d, warnings
