xparapx/Plant_Growth_Monitoring_Demo/hub/plantsvc/camera/setup_actions.py

"""Camera-setup actions - the ACTIONS table of setup_camera.py as a session object.

Every action persists config.json atomically (as persist() did).  Click
coordinates arrive in PREVIEW pixels (1280x720 by default) exactly as before;
conversion to capture coordinates uses cfg.scale.
"""

from __future__ import annotations

import os
import random
import threading
from typing import Any

import cv2
import numpy as np

from ..config_model import Roi
from ..vision import frame_align, roi_tools
from .manager import CameraBusy


class SetupSession:
    def __init__(self, store, camera, paths, events=None, hub=None, mqtt=None):
        self.store, self.camera, self.paths = store, camera, paths
        self.events, self.hub = events, hub
        self.mqtt = mqtt                     # MqttBridge — 노드 조명 원격 점등에 사용
        self._lock = threading.RLock()
        self.msg = "준비됨"
        self.level = "info"
        self.pts: list[list[float]] = []
        self.ppc_fixed: float | None = None
        self.cm: float = 0.0
        self.order: list[int] | None = None
        self.last_auto: dict[str, Any] | None = None
        self._drift_cache: tuple[tuple, dict[str, Any]] | None = None

    # ---- status -------------------------------------------------------------------
    def step_done(self) -> dict[str, bool]:
        cfg = self.store.get()
        rois = cfg.rois
        return {"focus": bool(cfg.capture.lens_position and cfg.capture.exposure_us),
                "scale": bool(cfg.qc.px_per_cm_ref),
                "roi": bool(rois),
                "treat": bool(rois) and all(r.treat in ("stable", "fluct") for r in rois),
                "shot": self.paths.calib.exists()}

    def latest_raw(self) -> str | None:
        try:
            files = sorted(p for p in os.listdir(self.paths.raw) if p.endswith(".jpg") and not p.startswith("fake_"))
        except FileNotFoundError:
            return None
        return files[-1] if files else None

    def status(self) -> dict[str, Any]:
        cfg = self.store.get()
        d = self.step_done()
        calib = self.paths.calib
        cam = self.camera.status()
        return {"msg": self.msg, "msg_level": self.level, "done": d, "all": all(d.values()),
                "mode": cfg.treat_mode, "naming": self.order is not None,
                "order": list(self.order) if self.order is not None else None,
                "pots": [{"id": r.plant_id, "treat": r.treat} for r in cfg.rois],
                "rois": [{**r.model_dump(), "out": self._out_of_frame(r, cfg)} for r in cfg.rois],
                "ppc": round(self.ppc_fixed or cfg.qc.px_per_cm_ref or 0, 1),
                "nroi": len(cfg.rois), "cm": float(self.cm or 0), "pts": [list(p) for p in self.pts],
                "pot_cm": cfg.layout.pot_cm,
                "capture": cfg.capture.model_dump(), "last_auto": self.last_auto,
                "calib": {"exists": calib.exists(),
                          "mtime": int(calib.stat().st_mtime) if calib.exists() else None,
                          "url": "/api/camera/calib.jpg" if calib.exists() else None},
                "latest_raw": self.latest_raw(),
                "light": getattr(self.mqtt, "light", None) if self.mqtt is not None else None,
                **{k: cam[k] for k in ("state", "driver", "clients", "preview", "paused_for", "error",
                                        "preview_size", "capture_size", "scale", "lock_holder_pid",
                                        "ops_busy", "quiet_window")}}

    @staticmethod
    def _out_of_frame(r: Roi, cfg) -> bool:
        W, H = cfg.capture.eff_size
        return r.x < 0 or r.y < 0 or r.x + r.w > W or r.y + r.h > H

    # ---- dispatch -------------------------------------------------------------------
    def run(self, name: str, p: dict[str, Any] | None = None) -> dict[str, Any]:
        p = p or {}
        fn = getattr(self, f"act_{name}", None)
        if fn is None:
            raise KeyError(name)
        with self._lock:
            if name not in ("open", "close", "save") and self.camera.ops_busy == "job":
                raise CameraBusy("capture in progress — setup actions are locked until it finishes")
            try:
                msg = fn(p)
                self.level = "warn" if "⚠" in msg else ("good" if any(k in msg for k in ("완료", "저장", "기록")) else "info")
            except CameraBusy as e:
                msg, self.level = f"⚠ {e}", "warn"
            self.msg = msg
            if self.events is not None:
                try:
                    self.events.add(f"setup.{name}", {"msg": msg})
                except Exception:
                    pass
        st = self.status()
        if self.hub is not None:
            self.hub.broadcast("camera.setup", {"action": name, "msg": msg, "done": st["done"]})
        return {"msg": msg, "status": st}

    # ---- actions ----------------------------------------------------------------------
    def act_open(self, p):
        self.camera.ensure_open()
        return "카메라 열림"

    def act_close(self, p):
        self.camera.close()
        return "카메라 닫음 — 예약 촬영이 쓸 수 있습니다"

    def act_save(self, p):
        self.store.save(self.store.get())
        return "현재 설정을 다시 저장했습니다"

    def act_auto(self, p):
        """자동 측정 → 고정. p.phase 가 dawn/pm 이면 그 phase 전용 프로필로 저장 —
        새벽(조명)과 오후(자연광)는 조도가 달라 한 노출로 둘 다 커버할 수 없다.
        렌즈 위치는 항상 공통값에 저장(초점은 조명과 무관)."""
        from ..config_model import PhaseCtl
        phase = str(p.get("phase") or "")
        vals = self.camera.auto_cycle()
        self.last_auto = vals

        def _u(c):
            c.capture.lens_position = float(vals["lens_position"])
            ctl = dict(exposure_us=int(vals["exposure_us"]), gain=float(vals["gain"]),
                       colour_gains=(float(vals["colour_gains"][0]), float(vals["colour_gains"][1])))
            if phase in ("dawn", "pm"):
                setattr(c.capture, phase, PhaseCtl(**ctl))
            else:
                c.capture.exposure_us = ctl["exposure_us"]
                c.capture.gain = ctl["gain"]
                c.capture.colour_gains = ctl["colour_gains"]
        self.store.update(_u)
        gain = vals["gain"]
        warn = ""
        if gain > 4.0:
            warn = f"  ⚠ gain {gain:.1f} 은 높습니다 — 조명을 밝게 하고 다시 측정하세요(노이즈)"
        elif gain > 2.0:
            warn = "  · 조명을 더 밝게 하면 노이즈가 줄어듭니다"
        cg = vals["colour_gains"]
        dest = {"dawn": "새벽(조명) 프로필", "pm": "오후(자연광) 프로필"}.get(phase, "공통값")
        return (f"exp {vals['exposure_us']} · gain {gain:.2f} · WB {cg[0]:.2f}/{cg[1]:.2f} · "
                f"lens {vals['lens_position']:.2f}  — {dest}로 고정·저장 완료{warn}")

    def act_light(self, p):
        """환경노드 촬영 조명 원격 점등/소등 — plant/light/set 브로드캐스트.
        노드 펌웨어가 30분 자동 소등 워치독을 가지므로 켜 두고 잊어도 안전."""
        on = bool(p.get("on"))
        if self.mqtt is None or not getattr(self.mqtt, "connected", False):
            return "⚠ MQTT 브로커에 연결되어 있지 않습니다 — 조명 명령을 보낼 수 없습니다"
        seq = getattr(self.mqtt, "light_seq", 0)
        if not self.mqtt.publish("plant/light/set", "1" if on else "0"):
            return "⚠ 조명 명령 발행 실패 — 브로커 상태를 확인하세요"
        # 노드가 상태를 보고(plant/<id>/light)할 때까지 잠깐 기다려 토글이 실제 상태를 보이게 한다 (USB 직결 ~0.1s)
        import time
        for _ in range(20):
            if getattr(self.mqtt, "light_seq", 0) != seq:
                break
            time.sleep(0.1)
        st = getattr(self.mqtt, "light", None) or {}
        if getattr(self.mqtt, "light_seq", 0) == seq:
            return f"조명 {'점등' if on else '소등'} 명령을 보냈지만 노드 응답이 없습니다 — 환경노드 연결(plantlink)을 확인하세요"
        if st.get("state") == "on":
            return "조명 켜짐" + (" — 새벽 점등 창 (자동 소등 06:15)" if st.get("by") == "window" else " — 30분 뒤 자동 소등")
        if on and st.get("state") == "off":
            return "⚠ 노드가 켜지지 않았습니다 — 노드 로그를 확인하세요"
        return "조명 꺼짐"

    def act_rotate(self, p):
        """90도 단위 회전 — 카메라 설치 방향 보정. 인자 없으면 +90도씩 순환.
        90/270 은 기본으로 가운데 3:4 띠를 잘라 <가로 4:3> 결과를 만든다(aspect="full" 이면 전체 세로)."""
        cfg = self.store.get()
        rot = int(p.get("rotation", (cfg.capture.rotation + 90) % 360))
        if rot % 360 not in (0, 90, 180, 270):
            return "회전은 0/90/180/270 만 됩니다"
        aspect = None if p.get("aspect") == "full" or rot % 180 == 0 else (4, 3)
        if rot == cfg.capture.rotation and aspect == cfg.capture.rot_aspect:
            return f"이미 {rot}° 입니다"

        def _u(c):
            c.capture.rotation = rot
            c.capture.rot_aspect = aspect
        self.store.update(_u)
        self._drift_cache = None
        stale = bool(cfg.rois or cfg.qc.px_per_cm_ref or self.paths.calib.exists())
        tail = "  ⚠ 좌표계가 바뀌었습니다 — 배율·ROI·기준사진(calib)을 다시 잡으세요" if stale else ""
        W, H = self.store.get().capture.eff_size
        how = " (가운데 잘라 가로 4:3)" if aspect else ""
        return f"설치 회전 {rot}°{how} 저장 — 촬영본 {W}×{H}{tail}"

    def act_point(self, p):
        """두 점 찍기. 길이(cm)는 두 점을 찍은 <뒤> act_setscale 로 넣는다 — 순서가 자연스럽다.
        (cm 을 같이 보내면 예전처럼 즉시 계산: 호환용)"""
        x, y, cm = float(p["x"]), float(p["y"]), float(p.get("cm") or 0)
        pts = self.pts if len(self.pts) < 2 else []
        pts.append([x, y])
        self.pts = pts
        if len(pts) < 2:
            return "첫 점 찍음 — 반대쪽 끝을 한 번 더 클릭하세요"
        if cm <= 0:
            d_cap = self._pts_cap_px()
            return f"두 점 찍음 — 원본 {d_cap:.0f}px. 두 점 사이 실제 길이(cm)를 입력하고 [배율 적용]을 누르세요"
        return self._apply_scale(cm)

    def _pts_cap_px(self) -> float:
        cfg = self.store.get()
        pts = self.pts
        d_prev = float(np.hypot(pts[0][0] - pts[1][0], pts[0][1] - pts[1][1]))
        return d_prev / cfg.scale

    def act_setscale(self, p):
        """두 점이 찍힌 뒤 실제 길이(cm)로 배율을 확정한다."""
        if len(self.pts) < 2:
            return "먼저 [두 점 찍기]로 자 양 끝을 클릭하세요"
        return self._apply_scale(float(p.get("cm") or 0))

    def _apply_scale(self, cm: float):
        cfg = self.store.get()
        self.cm = cm
        d_cap = self._pts_cap_px()
        if cm <= 0 or d_cap <= 0:
            return "길이가 0입니다 — 두 점 사이 실제 길이(cm)를 입력하세요"
        ppc = d_cap / cm
        self.ppc_fixed = ppc

        def _u(c):
            c.qc.px_per_cm_ref = round(ppc, 1)
        self.store.update(_u)
        frame_cm = cfg.capture.eff_size[0] / ppc
        lay = cfg.layout
        need = lay.cols * lay.pot_cm + (lay.cols - 1) * lay.gap_cm
        warn = ""
        if lay.pot_cm and frame_cm < need:
            warn = f"   ⚠ 프레임 폭 {frame_cm:.0f}cm 가 배치 {need:.0f}cm 보다 좁습니다 — 다시 재세요"
        elif lay.pot_cm and frame_cm > need * 3:
            warn = f"   ⚠ 프레임 폭 {frame_cm:.0f}cm 는 배치 {need:.0f}cm 의 3배가 넘습니다 — 길이 입력칸을 확인하세요"
        return f"{d_cap:.0f}px(원본) / {cm:g}cm  ->  {ppc:.1f} px/cm  · 프레임 폭 {frame_cm:.0f}cm · 기록{warn}"

    def act_clearpoints(self, p):
        self.pts = []
        return "배율 측정점 초기화"

    def act_setpot(self, p):
        cm = float(p.get("pot_cm", 0))
        if cm <= 0:
            return "0보다 큰 값을 넣으세요"

        def _u(c):
            c.layout.pot_cm = cm
        self.store.update(_u)
        return f"화분 한 변 {cm:g} cm 기록 — 배율 검산에만 쓰입니다"

    def act_shoot(self, p):
        cfg = self.store.get()
        with self.camera.exclusive(timeout=30, label="shoot"):
            self.camera.capture_still(self.paths.calib)
        self._drift_cache = None
        W, H = cfg.capture.eff_size
        return f"calib.jpg 저장 ({W}x{H}) — 완료"

    def act_findleaf(self, p):
        cfg = self.store.get()
        with self.camera.exclusive(timeout=30, label="findleaf"):
            frame = self.camera.preview_frame()
        blobs = roi_tools.leaf_blobs(frame)
        if not blobs:
            return "초록 덩어리를 못 찾았습니다 — 조명·초점을 먼저 맞추세요"
        existing = [r.model_dump() for r in cfg.rois]
        rois, info = roi_tools.place_from_blobs(blobs, scale=cfg.scale, cap_w=cfg.capture.eff_size[0],
                                                cap_h=cfg.capture.eff_size[1], existing=existing)

        def _u(c):
            c.rois = [Roi(**r) for r in rois]
        self.store.update(_u)
        same = "모두 같음" if info["same"] else "★ 다름"
        tail = "처리군 유지됨" if info["kept"] else "처리군이 비었습니다 — 다시 배정하세요"
        return f"잎 {info['n']}개 — 중심만 이동 · {info['how']} · 크기 {same} · {tail} · 저장"

    def act_autoroi(self, p):
        cfg = self.store.get()
        cols, rows = int(p.get("cols", cfg.layout.cols)), int(p.get("rows", cfg.layout.rows))
        rois = roi_tools.grid_rois(cfg.capture.eff_size[0], cfg.capture.eff_size[1], cols, rows)

        def _u(c):
            c.rois = [Roi(**r) for r in rois]
            c.layout.cols, c.layout.rows = cols, rows
        self.store.update(_u)
        return f"{cols}x{rows} 격자 = {len(rois)}칸 — 처리군은 아직 비어 있습니다 · 저장"

    def act_rename(self, p):
        n = len(self.store.get().rois)
        if n == 0:
            return "ROI 가 없습니다 — 먼저 배치하세요"
        self.order = []
        return f"이름을 붙일 순서대로 화면의 박스를 클릭하세요 (0/{n})"

    def act_cancel_naming(self, p):
        self.order = None
        return "이름 지정 취소"

    def act_pickroi(self, p):
        if self.order is None:
            return "먼저 [이름 다시 매기기] 를 누르세요"
        cfg = self.store.get()
        X, Y = float(p["x"]) / cfg.scale, float(p["y"]) / cfg.scale
        rois = [r.model_dump() for r in cfg.rois]
        i = roi_tools.hit_roi(rois, X, Y)
        if i is None:
            return "박스 안을 클릭하세요"
        if i in self.order:
            return "이미 고른 박스입니다"
        self.order.append(i)
        n = len(rois)
        if len(self.order) < n:
            return f"{len(self.order)}/{n} — 다음 박스를 클릭하세요"
        new = roi_tools.rename_by_order(rois, self.order)
        self.order = None

        def _u(c):
            c.rois = [Roi(**r) for r in new]
        self.store.update(_u)
        return "이름 지정 완료 — " + " · ".join(f"{r['plant_id']}(x={r['x']})" for r in new)

    def act_settreat(self, p):
        pid, treat = str(p.get("pid")), str(p.get("treat"))
        if treat not in ("stable", "fluct"):
            return f"알 수 없는 처리군: {treat}"
        cfg = self.store.get()
        if not any(r.plant_id == pid for r in cfg.rois):
            return f"{pid} 를 찾을 수 없습니다"

        def _u(c):
            for r in c.rois:
                if r.plant_id == pid:
                    r.treat = treat
            c.treat_mode = "manual"
        self.store.update(_u)
        return f"{pid} → {treat} (직접 지정) · 저장"

    def act_shuffle(self, p):
        cfg = self.store.get()
        rois = [r.model_dump() for r in cfg.rois]
        err = roi_tools.shuffle_treat(rois, random.Random(p.get("seed")) if p.get("seed") is not None else None)
        if err:
            return err

        def _u(c):
            c.rois = [Roi(**r) for r in rois]
            c.treat_mode = "random"
        self.store.update(_u)
        return "무작위 배정 완료 — " + " ".join(f'{r["plant_id"]}:{r["treat"][0]}' for r in rois)

    def act_centerroi(self, p):
        cfg = self.store.get()
        which = p.get("image", "calib")
        if which == "live":                          # 지금 카메라가 보는 장면으로 — 최근 촬영본이 옛것일 때(식재 전 등)
            src = self.paths.data_dir / "center_live.jpg"
            try:
                self.camera.capture_still(src)
            except Exception as e:  # noqa: BLE001
                return f"지금 프레임 촬영 실패: {e}"
        else:
            src = self.paths.calib if which == "calib" else (self.paths.raw / (self.latest_raw() or ""))
        if not src.exists() or src.is_dir():
            return "사진이 없습니다 — 먼저 [촬영] 하세요"
        img = cv2.imread(str(src))
        if img is None:
            return f"못 읽음: {src.name}"
        rois = [r.model_dump() for r in cfg.rois]
        if not rois:
            return "ROI 가 없습니다"
        props = roi_tools.center_proposals(img, rois)
        out = self.paths.data_dir / "roi_offset.jpg"
        cv2.imwrite(str(out), roi_tools.draw_center_overlay(img, props))
        self.last_center = props
        moved = sum(1 for q in props if q["found"] and (q["dx"] or q["dy"]))
        if not p.get("apply"):
            return f"제안 {moved}개 이동 (미적용) — /api/images/data/roi_offset.jpg 에서 확인"
        if moved == 0:
            return "이미 맞습니다. 바꿀 것 없음"
        roi_tools.apply_center_proposals(rois, props)

        def _u(c):
            c.rois = [Roi(**r) for r in rois]
        self.store.update(_u)
        self._drift_cache = None
        return f"ROI 재중심 적용 — {moved}개 이동 · 크기 불변 · 저장"

    # ---- drift (on demand, cached) -------------------------------------------------------
    def drift(self) -> dict[str, Any]:
        cfg = self.store.get()
        latest = self.latest_raw()
        if not self.paths.calib.exists():
            return {"level": "unknown", "msg": "calib.jpg 가 없습니다", "ok": False, "cur": None}
        if not latest:
            return {"level": "unknown", "msg": "촬영된 사진이 아직 없습니다", "ok": False, "cur": None}
        cur = self.paths.raw / latest
        key = (latest, int(cur.stat().st_mtime), int(self.paths.calib.stat().st_mtime), self.store.mtime_ns)
        if self._drift_cache and self._drift_cache[0] == key:
            return self._drift_cache[1]
        d = frame_align.align(str(cur), str(self.paths.calib), cfg.to_legacy_dict(), log=None)
        d["cur"] = latest
        ppc = cfg.qc.px_per_cm_ref
        d["mag_mm"] = round(d.get("mag", 0) / ppc * 10, 2) if ppc else None
        self._drift_cache = (key, d)
        return d
