xparapx/Plant_Growth_Monitoring_Demo/(commit log)

2026-07-22 Initial commit — 식물 생장 모니터링(수분 변동성 실험) 3대 데모
2026-07-26 매뉴얼 대규모 개정 반영 — 스크립트 체계 개편·카메라 파이프라인 재구성
    - docs/manual.html: 최신 구축 가이드로 교체 (Pi 이관·systemd·noVNC·카메라
    설치/운용·대시보드 섹션 분리 확장, 18개 패널)
    - 스크립트 개명 (실행 주체 접두어): hub.py→run_collector.py,
    snap.py→run_capture.py, leafcv.py→leaf_measure.py, validate.py→check_accuracy.py
    - 신규: setup_camera.py(웹 세팅), frame_align.py(밀림 보정, 마커 대체),
    check_config.py(설정 점검), firmware/water_node.ino(폐루프 전용)
    - 삭제: make_marker.py (frame_align 방식으로 대체)
    - run_capture.py --replay(미발행분 재전송)·QoS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
    [check_accuracy.py, check_config.py, dashboard.py, frame_align.py, leaf_measure.py, plant_env_r4wifi.ino, plant_water_cores3.ino, run_capture.py]
2026-07-26 매뉴얼 개정 반영 — 대시보드 plotly key 중복 오류·처짐 지수 KeyError 수정
    - docs/manual.html: Desktop 개정본으로 교체
    - hub/dashboard.py: 매뉴얼 코드 블록과 동기화
    · st.plotly_chart 12곳에 고유 key 부여 (StreamlitDuplicateElementId 방지)
    · 처짐 지수: dawn·pm 짝이 없는 화분은 제외하고 캡션으로 사유 표기 (KeyError 방지)
    [dashboard.py]
2026-07-26 매뉴얼: 14. 왜 이 실험인가 — 학술적 서술 가이드(§11) 추가
    - 제목·용어 표기 기준: "옌센 메커니즘 규명" 대신 "반응함수의 곡률 부호 검증/추정"
    - 국문·간결·영문 제목 후보, 공통 요건인 "평균 일치(mean-matched)" 명시
    - 용어 대응표(Jensen effect·RGR·처짐 지수·예비 연구)
    - 방법 절 필수 문장: 정전용량 지시값 기준 평균 일치임을 밝히는 한계 서술
    - .quote 스타일 추가
2026-07-29 매뉴얼 개정 반영 — 급수 노드 MQTT 보고·적응 도즈 학습 추가, 카메라·수집기·대시보드 갱신
    - water_node.ino: USE_MQTT 보고 통로(오프라인에서도 급수 지속)·도즈 학습(EMA)·침투 시간 측정 모드(SOAK_TEST)
    - run_collector.py: 급수 노드 보고 구독 확장
    - setup_camera.py / check_config.py / leaf_measure.py / frame_align.py: 개정 코드 동기화
    - dashboard.py: 처리군 2색 체계(채움 원색·윤곽 짙은 변형) 등 가독성 개선
    - docs/manual.html: 개정본 교체 (WiFi 자격증명은 관례대로 your-hotspot/your-password 플레이스홀더로 치환)
2026-07-31 카메라: 미리보기·촬영 화각 통일(lores) · ROI 크기 고정 · center_roi 추가
2026-08-24 매뉴얼-소스 동기화 — Pi 운용본 반영 · setup_camera 블록 최신화
    매뉴얼의 코드 블록을 기준으로 hub/ 소스를 맞췄습니다. 대조 결과 9개 블록이
    소스와 바이트 단위로 일치합니다.
    - frame_align: cv2.logPolar 이 최신 OpenCV 에서 사라진 것에 대응
    (warpPolar + WARP_POLAR_LOG, maxRadius 명시로 같은 축척 유지).
    align() 이 예외를 밖으로 던지지 않도록 이중 차단 — 2026-08-01 에
    이 예외가 새어 dawn·pm 두 번의 측정이 통째로 유실됐습니다.
    - dashboard: DEMO_FILL -> DUMMY_FILL (뱃지·CSS·CSV 라벨 포함),
    캐노피 오버레이 기준 3일 전 -> 하루 전 + 초기 대비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
    [backfill.py, center_roi.py, check_db.py, dashboard.py, frame_align.py, reset_run.py]
2026-09-10 feat(plantsvc): FastAPI 허브 서비스 + 촬영/LED 루틴 자리 + 더미 데이터 모드 (PR-1)
    - hub/plantsvc/ 패키지: settings(PLANT_DATA_DIR 앵커), schema(수집기와 공유, WAL·인덱스),
    config_model/store(pydantic v2, 원자적 저장, 마이그레이션), analytics(dashboard.py 수식 이식:
    validity·히스토그램·RGR·Cohen's d·처짐·실루엣·관수 기록·노드 헬스), db(읽기전용 + 더미 자동 채움),
    vision(leaf_measure/frame_align 이동 + roi_tools), camera(Picamera2/Fake 백엔드, 파일락 매니저,
    setup_camera ACTIONS 이식), led(NoopDriver 기본 — 하드웨어 추후), capture(runner: LED→워밍업→촬영→
    측정→jso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
2026-09-10 feat(deploy): systemd 템플릿·install/deploy/migrate 스크립트·릴리스/Pages 워크플로 (PR-3 1/2)
    - deploy/systemd/*.tmpl: plantsvc(:8080)·planthub·plantsnap(oneshot)·plantsnap.timer(05:50/15:00, AccuracySec=1s,
    Persistent)·plantsnap-catchup(부팅 시 --if-missing) + legacy plantdash/plantcam(설치-비활성).
    사용자명·경로 없음 — `plantsvc render-units` 가 id -un / 체크아웃 경로 / config.json 으로 렌더
    - scripts/install.sh(12단계: apt → uv venv --system-site-packages → uv sync → data 시드 → mosquitto → web/dist
    (릴리스 tarball/로컬/빌드/skip) → 유닛 렌더·설치 → enable → 타임존 → 그룹 → doctor),
    deploy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
    [cli.py]
2026-09-10 feat(web): React/Vite 통합 UI — 개요·처리·생장·촬영/LED·카메라 설정·시스템 + 목 API (PR-2)
    - web/: Vite + React 18 + TS + Tailwind v4(토큰 단일 소스 tokens.css, 라이트/다크) + ECharts(core 트리쉐이킹, CSS 변수 테마)
    + TanStack Query + motion(페이지 전환·카드 stagger·KPI count-up·칩 펄스) + PWA(shell precache, /api NetworkOnly)
    - 페이지: 개요(환경 KPI+스파크·노드 칩·Validity·실루엣·톱니 그리드/모바일 스와이프·최근 관수·관수 기록),
    처리(히스토그램·접힌 참고 곡선·정렬 추세·처짐+타임라인), 생장(캐노피 시계열·RGR KPI·포레스트·CSV),
    촬영/LED(카운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
2026-09-10 ci: feat/** 브랜치 push 에서도 CI 실행
2026-09-10 docs+fix: 매뉴얼 2026-09 개정, install.sh 시스템 파이썬 고정, seed --with-config (PR-3 2/2)
    - docs/manual.html: §8 install.sh 중심 재작성(유닛 템플릿 렌더, migrate_legacy, doctor), §9 카메라 세팅은 웹 UI,
    §10/11 5단계 세팅·ROI 재중심·밀림 판정·05:50 타이머 근거·새 journal 문구, §12 페이지 매핑·DUMMY 배지 규칙,
    신규 패널 18 웹 UI(plantsvc)·19 LED 촬영 루틴(자리)·20 설치·배포 스크립트, 트러블슈팅 행 추가,
    Streamlit·setup_camera·구 유닛 heredoc 은 <details class="legacy"> 로 보존
    - scripts/install.sh: UV_PYTHON=/usr/bin/python3 + `uv sync --python` — .python-version 때문에 uv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
    [cli.py]
2026-09-10 fix(cli): seed 가 with_config 없는 Namespace 로 호출돼도 동작
    [cli.py]
2026-09-10 chore: docs 정적 서버 미리보기 설정(launch.json)
2026-09-10 fix: systemd 시각 문자열을 ISO 로 변환 + 프론트 날짜 포맷터가 예외를 던지지 않도록
    - systemctl show 의 'Fri 2026-09-11 05:50:00 KST' 가 그대로 전달돼 브라우저 new Date() 가
    Invalid Date → Intl 포맷에서 'Invalid time value' 로 촬영·시스템 페이지가 깨지던 문제
    - timeutil.parse_systemd_ts (config tz 기준) 로 capture/schedule 의 timer.next/last,
    system/status 의 services[].since 를 ISO UTC 로 반환
    - format.ts: 유효하지 않은 날짜는 원문 그대로 표시
    [timeutil.py]
2026-09-10 design: Claude Design 턴3 목업(plantlab 네이비 팔레트) 반영
    - design/: 목업 원본(턴 3) + 토큰·컴포넌트 매핑 README
    - tokens: 네이비 다크가 기본 테마, Space Grotesk, stable #7FB3D8 / fluct #D84C27, 카드 radius 16
    - shell: plantlab° 워드마크, 대문자 내비 + 액센트 밑줄, nodes · Day N/42 · 시각 상태
    - overview: 니들 게이지 5종, 토양수분 밴드, Treatment check, 급수 이벤트 + 3a 보강(관수 기록·촬영 일지)
    - treatment: KPI 3종(총 급수량 포함), 수분 궤적 14d, 밴드 설정(raw), 수분 분포 compact
    - growth: DAWN/PM/MASK 칩, 3×2 화분 카드(캐노피 투영·RGR·soil), RGR 추이, ΔRGR
    - camera set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
2026-09-10 fix(treatment): xl 12열 그리드에서 참고 곡선·정렬 추세·처짐 카드가 1열로 눌리던 문제
2026-09-12 docs: dev-notes 현행화 — main 머지 완료·운영 구조(로컬 push → 파이 pull) 확정 반영
2026-09-12 docs: dev-notes 남은 일 번호 재정렬
2026-09-12 docs: 문서 구조 재편 — WORKLOG.md·CLAUDE.md 신설, README 는 소개 전용, dev-notes 폐지
    - README 작업 로그 절 → docs/WORKLOG.md (yyyy-mm 절, 최신이 위)
    - docs/dev-notes.md 의 세션 서사 → WORKLOG, 규칙·현재 상태 → CLAUDE.md
    - 전역 문서 구조 규칙(2026-09-12) 적용
2026-09-18 feat(firmware): LED 노드 독립 점등·급수 펄스 분할·환경노드 개정
    - LED 방식 변경: 파이 GPIO+릴레이 계획 폐기 → 환경노드 Grove RGB 스틱(5구)x2
    (D4·D5) 시간 기반 독립 점등(NTP, KST 05:45~06:15). 매뉴얼 패널 19·README·
    CLAUDE.md 반영, hub led.* 훅은 noop 존치
    - water_node.ino: 도즈를 0.2s 펄스 + 2.5s 스며듦·측정 열로 분할(S_GAP),
    목표(RAW_OFF) 도달 시 조기 중지 — 드로퍼 물튐·과급수 방지. 학습·3분 침투
    검증·고장 판정은 유지
    - plant_env_r4wifi.ino: 블로킹 재접속 제거(논블로킹 netReady), 오프라인 큐
    8건, String 제거, WDT 5s, NTP 일 1회 재동기화, US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
2026-09-18 docs: sudo 위임 목록(sudoers.d/plant)·Wi-Fi 프로필 운용 기록
2026-09-19 docs: SSH 별명 체계 기록 (pl·aq·tr·mb/mb-cf)
2026-09-19 feat(camera): 90도 단위 화면 회전 (설치 방향 보정)
    - config capture.rotation(0/90/180/270) + eff_size — ROI·격자·프레임폭 계산 통일
    - CameraManager: 미리보기·정지촬영 프레임 회전, status 크기 회전 반영
    - setup 액션 rotate(순환/지정), 회전 시 배율·ROI·calib 재설정 경고
    - 웹 UI: 미리보기 ⟳ 90° 회전 버튼, 세로 화면 동적 종횡비, mock 동등 반영
2026-09-19 fix(deploy): PS7 변수 파싱 오류 — $PiHost: 를 ${PiHost}: 로
2026-09-19 fix(camera-setup): 회전 시 MJPEG 스트림 재연결 — 첫 프레임 크기 고정으로 눌려 보이던 문제
2026-09-19 fix(camera-setup): 세로 미리보기 폭을 뷰포트 높이에 맞춰 제한 — 세로 회전 시 화면이 끝없이 길어지던 문제
2026-09-19 feat(firmware): 환경노드 조명 최종 구성 — RGB 4구/핀9/GRB, 시리얼 1/0 점등 테스트
2026-09-19 docs: LED 하드웨어 최종 구성(RGB 4구/핀9) README 반영
2026-09-19 docs: 매뉴얼 패널 19 — LED 최종 구성(RGB 4구/핀9)·광량 검증 절차 반영
2026-09-19 feat(firmware): 환경노드 조명 정식판 — 4구x2(핀8·9) + MQTT 원격 점등
    - plant/<id>/light/set 구독("1"/"0"/on/off), 상태는 plant/<id>/light 로 발행
    - 명령 점등은 30분 워치독 자동 소등, 시간 창(05:45~06:15) 점등이 항상 최우선
    - 시리얼 1/0 테스트는 명령 점등과 동일 경로로 통합
2026-09-19 feat(camera-setup): 조명 원격 점등 버튼 — UI -> plantsvc -> MQTT(plant/light/set)
    - MqttBridge.publish 추가, SetupSession 에 bridge 주입, act_light 액션
    - 펌웨어: 브로드캐스트 토픽 plant/light/set 추가 구독 (노드 ID 불요)
    - 미리보기 우하단 버튼 묶음: 조명 켬/끔 + 90도 회전, mock 동등 반영
2026-09-19 feat(camera-setup): 회전을 보기 전용으로 전환 — 사진 데이터는 원본 유지(왜곡 없음)
    - ⟳ 버튼이 서버 회전 대신 브라우저 표시만 90도 회전(localStorage 기억)
    - 오버레이는 SVG g transform, 클릭은 역변환으로 원본 좌표 유지
    - 서버측 capture.rotation 기능은 남기되 UI 에서는 사용하지 않음
2026-09-19 style(camera-setup): 조명·회전 버튼 크기·대비 확대 — 어두운 프리뷰 위에서 안 보이던 문제
2026-09-19 fix(camera-setup): 화분 크기 라벨 정정 — 사각 포트 "한 변", 선택·배율 검산 전용임을 명시
    [config_model.py, setup_actions.py]
2026-09-19 feat(camera-setup): 카메라 수동 켜기/끄기 버튼 — 끄면 스트림도 끊어 예약 촬영에 즉시 양보
2026-09-19 refactor: hub GPIO LED 서브시스템 전면 제거 — 조명은 환경노드 전담
    - led.py·Led 설정·LedController·plantsvc led CLI·/api/led·doctor led 행 삭제,
    구 config.json 의 led 절은 migrate() 가 자동 제거(DEAD_TOP_KEYS)
    - 촬영 루틴에서 led_on/warmup/led_off 단계 제거 (queued→lock→camera_open→
    controls→settle→capture→measure→jsonl→publish)
    - systemd 템플릿에서 plantsvc led off·LED_WARMUP_S 제거
    - 웹: LED 카드·설정 폼 LED 절·led 타입/쿼리/이벤트 제거, 탭명 "촬영"
    - 매뉴얼 패널 19·systemd 절·문제해결 표·README·WORKLOG 현행화
    - 노드 조명 기능(act_light·MQTT plant/light/set·펌웨어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
2026-09-19 feat(firmware): water_node 처리군을 터치 전환으로 — SAFE 에서 상단 라벨 탭, NVS 저장
    - TREAT_FLUCT 컴파일 스위치 제거, 같은 펌웨어를 모든 노드에 올리고 현장 지정
    - 전환 시 학습값(kPerMs)·카운터 초기화 (도즈 규모가 처리군에 묶이므로)
2026-09-19 feat(firmware): water_node 급수 트리거 확인 — 10초 x 연속 3회 RAW_ON 초과 시에만 시작
    좁은 stable 밴드(40카운트)에서 센서 순간 요동으로 조기 급수되는 것을 차단
2026-09-19 feat(firmware): water_node SAFE 화면에 초기 젖음(1750~1800) 안내 게이지
    손 급수로 모든 화분을 같은 출발선(포장용수량 부근)에 맞춘 뒤 ARM 하는
    절차를 화면이 안내 — POUR / DRAINING / OK -> ARM
2026-09-19 feat(firmware): PRIME(수동 급수) 세션을 pump 이벤트(reason=prime)로 기록
    누른 시간·전후 raw 를 DB 에 남겨 초기 젖음 공급량을 추적. 자동 급수
    학습값(kPerMs)에는 주입하지 않음 — 포화 영역과 밴드 영역의 반응이 달라
    오히려 첫 도즈를 어긋나게 하므로 기록 전용.
2026-09-19 feat(firmware): water_node UI 재구성 — AUTO/PUMP/RESET 3버튼 + 처리군 선택 칩
    - 탭 판정을 wasClicked(뗄 때) 기준으로 통일 — STOP 이 안 먹히던 문제 대응
    - RESET(1.5초 홀드): 어떤 상태에서든 SAFE 복귀·FAULT/학습값 초기화
    - 처리군은 SAFE 에서 [STBL][FLCT] 칩 탭으로 선택 (NVS 저장)
    - 라벨 정리: ARM->AUTO, PRIME->PUMP
    [water_node.ino]
2026-09-19 docs: WORKLOG — 09-19 급수노드 현장 운용 개선 기록
2026-09-19 feat(capture): phase 별 노출 프로필 — 새벽(조명)과 오후(자연광) 노출 분리 고정
    - config capture.dawn / capture.pm(PhaseCtl) + for_phase(): 촬영 시 phase 프로필 적용
    - 면적 비교는 늘 같은 phase 끼리이므로 노출은 phase 안에서만 일정하면 됨
    - 설정 UI 1단계: [새벽(조명) 프로필 측정] [오후(자연광) 프로필 측정] 버튼과
    저장된 프로필 표시. 렌즈 위치(초점)는 공통값 유지. mock 동등 반영
2026-09-21 fix(web): a11y 감수 4건 — 포커스 링 복원·확인 다이얼로그 안전 포커스·radio roving·aria-busy
    - 입력류 outline-none 제거로 전역 :focus-visible 링 복원 (NumberField·fields·ConfigEditor)
    - ConfirmDialog: autoFocus 를 취소 버튼으로 이동(Enter 오확정 방지) + overscroll-contain
    - Segmented: roving tabindex + 화살표 이동 시 포커스 동행
    - Button: busy 시 aria-busy 전달
2026-09-21 docs: 프로젝트 지도 신설 — 설계 맵·연결 지도·DB 스키마 단일 HTML (design-craft 필터 통과)
2026-09-21 docs: 프로젝트 지도 6뷰 확장 — 시나리오(노드 점프)·데이터 여정·운영 탭
2026-09-21 docs: 지도 운영·용어 탭 가독성 — 전폭 레이아웃·글자 확대
2026-09-21 docs: 용어 탭 전폭·설계 문법 카드 제목/본문 분리·화살표 겹침 해소
2026-09-21 docs: 지도 디자인 v3 — 파스텔 라이트 퍼스트 전면 개편, 플로우 노드 카드 확대
2026-09-21 docs: archify 고품질 뷰 내장(아키텍처·파이프라인) + 다크 노드 대비 보정
2026-09-21 docs: 지도 레이아웃 — 상세 패널을 하단 전폭 3열 카드로, 차트 전폭화
2026-09-21 docs: archify 내장 뷰 테마를 부모 light/dark 토글과 동기화
2026-09-21 docs: archify 내장 뷰 전폭 사용 — reader-width 제한 해제
2026-09-21 docs: archify 설명부 한글화 — 가이드 뷰·원칙 카드 (노드 코드명은 규약대로 영문 유지)
2026-09-21 docs: DB 스키마를 v3 카드 언어로 — 3D 실린더 제거, 파스텔 도트·틴트 카드
2026-09-22 docs(map): 3인 검토 기반 개선 — 첫인상·화살표·설계 논리 카드 + 에이전트 팀 규칙
    - 지도: 소개문·스탯 칩을 archify 위로, 연결 지도 화살표·패널 자동 스크롤,
    용어 병기·은어 제거, 사실 오류 3건 수정(soil 순간값·pump reason·ops 경로),
    "왜 이렇게 설계했나" 실험 논리 5장 신설, 회전·Cohen''s d 반영 (템플릿 개선은
    claude-skills 저장소에 반영해 재렌더)
    - CLAUDE.md: 도메인별 서브에이전트 팀 운용 규칙(유연 구성 + .claude/agents 영속화)
    - .claude/agents: design-reviewer·tech-writer·domain-expert 상비 역할 3종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
2026-09-22 docs: 프로젝트 개요(index.html) 폐지 — 프로젝트 지도(project-map.html)로 일원화
    README 대표 링크를 project-map으로 교체. 지도는 지속 갱신 문서로 운영.
2026-09-23 fix(firmware): 환경노드 WDT 리셋 루프 — WiFi.begin 블로킹(≤10s)이 5초 워치독을 넘겨 재부팅 반복, 리셋마다 네오픽셀이 제멋대로 점등
    - WiFi.setTimeout(2500) 으로 접속 대기를 워치독 안으로, WDT 5592ms(R4 최대)
    - 스트립 소등을 setup 최우선으로 이동 (리셋 직후 핀 부동 구간 최소화)
    [plant_env_r4wifi.ino]
2026-09-28 feat(firmware): 조명 스트립 교체 — RGB 4구×2(핀 8·9) → RGBW 61구 ×1(핀 9, NEO_GRBW)
    - 백색은 W 칩만 점등(R/G/B=0): 넓은 스펙트럼, LED당 전류 1/3
    - 61구 풀밝기 ~1.1A 는 USB 급전 5V 핀을 넘기므로 LIGHT_BRIGHT=80 기본
    - 시리얼 't' 색순서 검사(앞 4구 R·G·B·W, 5초 뒤 복귀) 추가
    - README·매뉴얼 패널 19·WORKLOG 반영
2026-09-28 docs: 학교 메시 Wi-Fi 유닛 간 격리 실측 — 파이 BSSID 7E:72 고정 + 정적 IP 192.168.1.209, 복사본 BROKER 치환 규칙
2026-09-28 fix(firmware): MQTT TCP 접속 타임아웃 2.5초 — 브로커 불통 시 모뎀 기본 10초 블로킹이 WDT 리셋 루프를 만들던 문제
    [plant_env_r4wifi.ino]
2026-09-28 fix(firmware): 접속 시도 구간 WDT 보호창 — 타이머 ISR 이 최대 12초만 대리 갱신, 브로커 불통 시 리셋 루프 종결 (setConnectionTimeout 은 모뎀이 무시)
    [plant_env_r4wifi.ino]
2026-09-28 feat(firmware): 부팅 시 리셋 원인(RSTSR) 출력, NTP 조회도 보호창, guard 타이머 50Hz(AGT/GPT 호환), 접속 시도 시각 로그
2026-09-28 feat: 환경노드 USB 직결 링크 — 펌웨어 LINK_MODE=1(시리얼 PUB/T/L 프로토콜) + 파이 plantlink 브릿지 서비스
    - firmware: LINK_MODE 1 이면 WiFi/MQTT/NTP 코드 제외, "PUB <topic> <json>" 송신, "T <epoch>"·"L 1/0" 수신,
    호스트 시각 3시간 미수신 시 창 점등 안전측 해제. 0 이면 기존 Wi-Fi 경로(보호창 포함). 두 모드 컴파일 확인.
    - hub/serial_bridge.py: /dev/serial/by-id 자동 탐색, 재접속, plant/light/set·plant/<id>/light/set → L 명령,
    1시간마다 시각 전송. 허브·수집기·UI 는 무변경(같은 토픽).
    - deploy/systemd/plantlink.service.tmpl, install.sh enable/restart 에 추가, pyserial 의존성.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
2026-09-28 fix(install): sudo 판정을 허용 명령(systemctl)으로 — 화이트리스트 sudoers 에서 유닛 설치가 매번 건너뛰던 문제; docs: USB 직결 운영 기록
2026-09-28 fix(install): plantsnap-catchup 은 enable 만 — --now 로 즉시 촬영이 세팅 전 실패해 install 이 중단되던 문제
2026-09-28 feat(ui): 조명 버튼을 상태 반영 토글로 — 노드 보고값(plant/<id>/light)이 진실
    - hub MqttBridge: plant/+/light 구독·최근 상태 보관·live 'light' 이벤트, 카메라 status 에 light 필드
    - act_light: 발행 후 노드 응답(≤2s) 대기 → "조명 켜짐/꺼짐", 무응답이면 경고
    - 웹: 단일 role=switch 버튼(ON 앰버 / OFF 회색 / ? 미보고), 새벽 창 점등 중엔 잠금
    - mock 에도 light 상태 추가
2026-09-28 feat(camera): 설치 90° 회전 시 가운데 3:4 띠를 잘라 <가로 4:3> 유지 — capture.rot_aspect
    - Capture.rot_aspect(4,3): crop_cols/eff_dims — 미리보기·촬영본 모두 크롭→회전, 리샘플 없음(왜곡 0)
    - rotate 액션: 90/270 이면 기본 4:3 크롭(aspect="full" 로 전체 세로 선택 가능), 결과 크기 안내
    - 웹: 보기 전용 회전 폐지 → ⟳ 버튼이 서버 설치 회전을 제어(한 좌표계), mock 동일 규칙
    - 테스트: eff_size/eff_dims 크롭 규칙
2026-09-28 docs: 학교망 Tailscale 릴레이 대역폭에 맞춘 미리보기 품질 메모
2026-10-07 fix(plantlink): 노드 시각 동기 1시간→5분 — R4 RTC(LOCO) 드리프트로 점등 창이 1분 넘게 어긋남
    [serial_bridge.py]
2026-10-07 fix(plantlink): 보존(retained) 조명 명령은 무시 — 재시작마다 점등되는 경로 차단
    [serial_bridge.py]
2026-10-07 docs(map): 프로젝트 지도 학생용 고품질 갱신 — USB 직결·plantlink·4:3 크롭·조명 토글 반영, 실습 시나리오 4개 추가
    - 사실 갱신: plantlink/serial_bridge 노드·간선, growth 발행 주체(capture→broker 직접), 수집기 구독 토픽,
    급수노드 상태명(SAFE/watching/DOSING/settling/FAULT)·버튼(PUMP), 업로드 시 고칠 다섯 줄, USB 장치 경로
    - 학생용 문장: 전문용어 첫 등장 시 쉬운 말 병기, 실습 ①설치 ②카메라 5단계 ③노드 ④배포 — 단계마다 어디서·어떻게·성공 판정
    - 흐름 A/B(새벽 촬영·급수 사이클)를 실습 앞에 배치, 용어표에 lux≠PAR·급수노드 상태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
    [schema.py, water_node.ino]
2026-10-21 feat(setup): 관찰 모드 전환 + 세팅 UI 3건
    - 스케일 마커: 두 점 찍기 → 실제 길이 입력 → [배율 적용] 순서(setscale 액션). 길이 미입력 시 배율 계산 안 함
    - 처리군 배정: 숨은 링크였던 '직접 지정됨' → [직접 지정하기 ▾] 버튼
    - ROI 재중심: "지금 프레임"(카메라 현재 장면) 옵션 기본 — 최근 촬영본이 식재 전 사진이던 문제
    - reset_run: 처리군 미배정(관찰 모드)이어도 진행. 급수노드 펌웨어 WIFI_BSSID 고정 옵션(컴파일 확인)
    - CLAUDE.md/WORKLOG: 관찰 모드(급수 수동·센서 전용) 기록
2026-10-21 feat(capture): phase 프로필이 없으면 촬영 직전 그 시간대 빛에서 자동 측정·저장 — 새벽 프로필을 낮에 만들 수 없는 문제
2026-10-22 feat(light): 보조 생장 조명 스케줄 — config.light 절을 plantlink 가 읽어 창 안 10분마다 L 1, pm 촬영 전후 소등 (펌웨어 무변경)
